firasgany77/Board-Design-Git/Lattice FPGA Works/SBC-CLH/Imgs/Weak_Pull_Ups.jpg

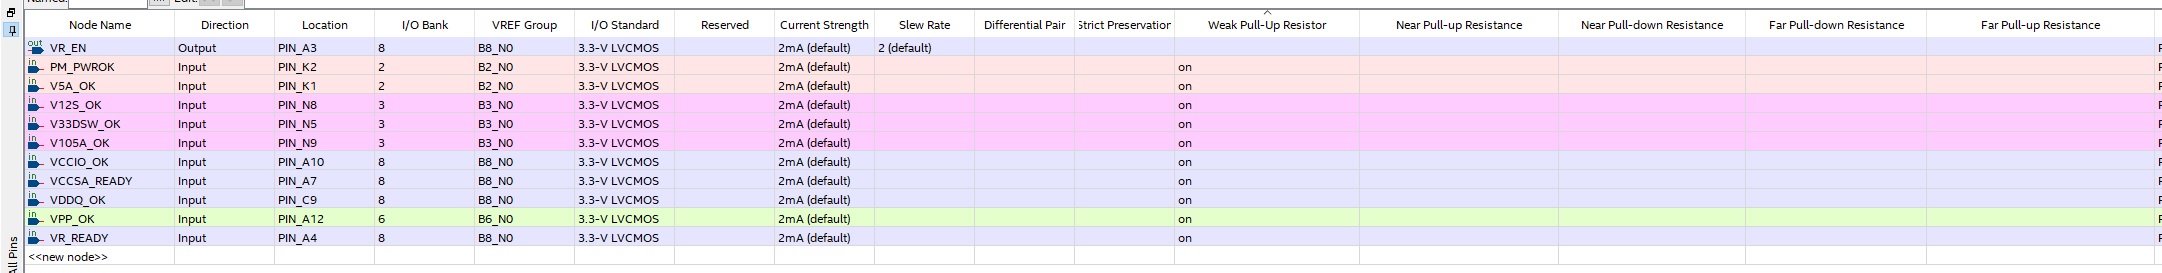
Lattice FPGA Works/SBC-CLH/Imgs/Weak_Pull_Ups.jpg
