firasgany77/Board-Design-Git/Docs/Imgs/SBC_TI22.png

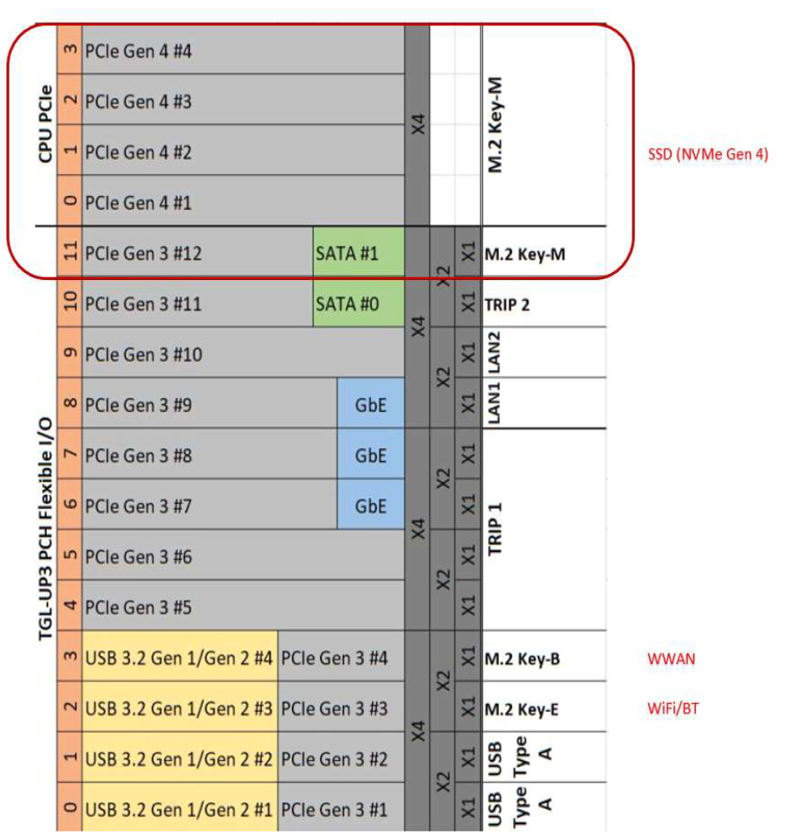
Docs/Imgs/SBC_TI22.png
