firasgany77/Board-Design-Git/README.md

# Board-Design-Git
Schematics, FPGA, Layout
