firasgany77/Board-Design-Git/Lattice FPGA Works/TensorI22/SBCTI22WORK/SBCTI22WORK_Implmnt/synlog/report/SBCTI22WORK_premap_notes.txt

@N: MF248 |Running in 64-bit mode.
@N: MF666 |Clock conversion enabled. (Command "set_option -fix_gated_and_generated_clocks 1" in the project file.)
@N: BN225 |Writing default property annotation file C:\Users\firas.abdelghani\Dropbox\Board-Design\Board-Design-Git\Lattice FPGA Works\TensorI22\SBCTI22WORK\SBCTI22WORK_Implmnt\SBCTI22WORK.sap.
