firasgany77/Board-Design-Git/Lattice FPGA Works/TensorI22/SBCTI22HOME2/SBCTI22HOME2_Implmnt/synlog/report/SBCTI22HOME2_compiler_notes.txt

@N|Running in 64-bit mode
@N|Running in 64-bit mode
@N: CD720 :"C:\lscc\iCEcube2.2020.12\synpbase\lib\vhd\std.vhd":123:18:123:21|Setting time resolution to ps
@N:"C:\Users\firas\Dropbox\Board-Design\Board-Design-Git\Lattice FPGA Works\TensorI22\Top.vhd":6:7:6:9|Top entity is set to TOP.
@N: CD630 :"C:\Users\firas\Dropbox\Board-Design\Board-Design-Git\Lattice FPGA Works\TensorI22\Top.vhd":6:7:6:9|Synthesizing work.top.bdf_type.
@N: CD630 :"C:\Users\firas\Dropbox\Board-Design\Board-Design-Git\Lattice FPGA Works\TensorI22\pch_pwrok.vhd":19:7:19:21|Synthesizing work.pch_pwrok_block.pch_pwrok_block_arch.
@N: CD234 :"C:\Users\firas\Dropbox\Board-Design\Board-Design-Git\Lattice FPGA Works\TensorI22\pch_pwrok.vhd":30:17:30:18|Using user defined encoding for type state_type.
@N: CD630 :"C:\Users\firas\Dropbox\Board-Design\Board-Design-Git\Lattice FPGA Works\TensorI22\rsmrst_pwrgd.vhd":8:7:8:24|Synthesizing work.rsmrst_pwrgd_block.rsmrst_arch.
@N: CD234 :"C:\Users\firas\Dropbox\Board-Design\Board-Design-Git\Lattice FPGA Works\TensorI22\rsmrst_pwrgd.vhd":22:17:22:18|Using user defined encoding for type state_type.
@N: CD630 :"C:\Users\firas\Dropbox\Board-Design\Board-Design-Git\Lattice FPGA Works\TensorI22\dsw_pwrok.vhd":8:7:8:21|Synthesizing work.dsw_pwrok_block.dsw_pwrok_arch.
@N: CD234 :"C:\Users\firas\Dropbox\Board-Design\Board-Design-Git\Lattice FPGA Works\TensorI22\dsw_pwrok.vhd":18:17:18:18|Using user defined encoding for type state_type.
@N: CD630 :"C:\Users\firas\Dropbox\Board-Design\Board-Design-Git\Lattice FPGA Works\TensorI22\vccinaux_vccin_en.vhd":8:7:8:29|Synthesizing work.vccinaux_vccin_en_block.vccinaux_vccin_arch.
@N: CD630 :"C:\Users\firas\Dropbox\Board-Design\Board-Design-Git\Lattice FPGA Works\TensorI22\hda_strap.vhd":6:7:6:21|Synthesizing work.hda_strap_block.hda_strap_block_arch.
@N: CD234 :"C:\Users\firas\Dropbox\Board-Design\Board-Design-Git\Lattice FPGA Works\TensorI22\hda_strap.vhd":15:17:15:18|Using user defined encoding for type state_type.
@N: CD630 :"C:\Users\firas\Dropbox\Board-Design\Board-Design-Git\Lattice FPGA Works\TensorI22\counter.vhd":7:7:7:13|Synthesizing work.counter.counter_arch.
@N: CD630 :"C:\Users\firas\Dropbox\Board-Design\Board-Design-Git\Lattice FPGA Works\TensorI22\vccio_en.vhd":10:7:10:20|Synthesizing work.vccio_en_block.vccio_en_block_arch.
@N: CD630 :"C:\Users\firas\Dropbox\Board-Design\Board-Design-Git\Lattice FPGA Works\TensorI22\vpp_vddq.vhd":9:7:9:20|Synthesizing work.vpp_vddq_block.vpp_vddq_arch.
@N: CD234 :"C:\Users\firas\Dropbox\Board-Design\Board-Design-Git\Lattice FPGA Works\TensorI22\vpp_vddq.vhd":20:17:20:18|Using user defined encoding for type state_type.
@N: CD630 :"C:\Users\firas\Dropbox\Board-Design\Board-Design-Git\Lattice FPGA Works\TensorI22\powerled.vhd":5:7:5:20|Synthesizing work.powerled_block.powerled_arch.
@N: CD234 :"C:\Users\firas\Dropbox\Board-Design\Board-Design-Git\Lattice FPGA Works\TensorI22\powerled.vhd":16:17:16:18|Using user defined encoding for type state_type.
@N: CL159 :"C:\Users\firas\Dropbox\Board-Design\Board-Design-Git\Lattice FPGA Works\TensorI22\vccio_en.vhd":15:2:15:11|Input clk_100Khz is unused.
@N: CL159 :"C:\Users\firas\Dropbox\Board-Design\Board-Design-Git\Lattice FPGA Works\TensorI22\vccinaux_vccin_en.vhd":15:2:15:11|Input clk_100Khz is unused.
@N: CL159 :"C:\Users\firas\Dropbox\Board-Design\Board-Design-Git\Lattice FPGA Works\TensorI22\dsw_pwrok.vhd":11:2:11:11|Input mainpwr_OK is unused.
@N: CL159 :"C:\Users\firas\Dropbox\Board-Design\Board-Design-Git\Lattice FPGA Works\TensorI22\Top.vhd":8:2:8:16|Input GPIO_FPGA_HDR_1 is unused.
@N: CL159 :"C:\Users\firas\Dropbox\Board-Design\Board-Design-Git\Lattice FPGA Works\TensorI22\Top.vhd":9:2:9:16|Input GPIO_FPGA_HDR_2 is unused.
@N: CL159 :"C:\Users\firas\Dropbox\Board-Design\Board-Design-Git\Lattice FPGA Works\TensorI22\Top.vhd":10:2:10:16|Input GPIO_FPGA_HDR_3 is unused.
@N: CL159 :"C:\Users\firas\Dropbox\Board-Design\Board-Design-Git\Lattice FPGA Works\TensorI22\Top.vhd":12:2:12:16|Input GPIO_FPGA_PCH_2 is unused.
@N: CL159 :"C:\Users\firas\Dropbox\Board-Design\Board-Design-Git\Lattice FPGA Works\TensorI22\Top.vhd":13:2:13:16|Input GPIO_FPGA_PCH_3 is unused.
@N: CL159 :"C:\Users\firas\Dropbox\Board-Design\Board-Design-Git\Lattice FPGA Works\TensorI22\Top.vhd":14:2:14:16|Input GPIO_FPGA_PCH_4 is unused.
@N: CL159 :"C:\Users\firas\Dropbox\Board-Design\Board-Design-Git\Lattice FPGA Works\TensorI22\Top.vhd":16:2:16:15|Input GPIO_FPGA_PM_1 is unused.
@N: CL159 :"C:\Users\firas\Dropbox\Board-Design\Board-Design-Git\Lattice FPGA Works\TensorI22\Top.vhd":17:2:17:15|Input GPIO_FPGA_PM_3 is unused.
@N: CL159 :"C:\Users\firas\Dropbox\Board-Design\Board-Design-Git\Lattice FPGA Works\TensorI22\Top.vhd":18:2:18:15|Input GPIO_FPGA_PM_2 is unused.
@N: CL159 :"C:\Users\firas\Dropbox\Board-Design\Board-Design-Git\Lattice FPGA Works\TensorI22\Top.vhd":19:2:19:15|Input GPIO_FPGA_PM_4 is unused.
@N: CL159 :"C:\Users\firas\Dropbox\Board-Design\Board-Design-Git\Lattice FPGA Works\TensorI22\Top.vhd":20:2:20:15|Input GPIO_FPGA_SV_1 is unused.
@N: CL159 :"C:\Users\firas\Dropbox\Board-Design\Board-Design-Git\Lattice FPGA Works\TensorI22\Top.vhd":21:2:21:15|Input GPIO_FPGA_SV_2 is unused.
@N: CL159 :"C:\Users\firas\Dropbox\Board-Design\Board-Design-Git\Lattice FPGA Works\TensorI22\Top.vhd":22:2:22:15|Input GPIO_FPGA_SV_3 is unused.
@N: CL159 :"C:\Users\firas\Dropbox\Board-Design\Board-Design-Git\Lattice FPGA Works\TensorI22\Top.vhd":23:2:23:15|Input GPIO_FPGA_SV_4 is unused.
@N: CL159 :"C:\Users\firas\Dropbox\Board-Design\Board-Design-Git\Lattice FPGA Works\TensorI22\Top.vhd":24:2:24:13|Input FPGA_GPIO_WD is unused.
@N: CL159 :"C:\Users\firas\Dropbox\Board-Design\Board-Design-Git\Lattice FPGA Works\TensorI22\Top.vhd":26:2:26:9|Input TPM_GPIO is unused.
@N: CL159 :"C:\Users\firas\Dropbox\Board-Design\Board-Design-Git\Lattice FPGA Works\TensorI22\Top.vhd":33:8:33:19|Input MAIN_12V_MON is unused.
@N: CL159 :"C:\Users\firas\Dropbox\Board-Design\Board-Design-Git\Lattice FPGA Works\TensorI22\Top.vhd":40:2:40:8|Input FP_RSTn is unused.
@N: CL159 :"C:\Users\firas\Dropbox\Board-Design\Board-Design-Git\Lattice FPGA Works\TensorI22\Top.vhd":41:2:41:8|Input PLTRSTn is unused.
@N: CL159 :"C:\Users\firas\Dropbox\Board-Design\Board-Design-Git\Lattice FPGA Works\TensorI22\Top.vhd":44:2:44:8|Input SLP_S5n is unused.
@N: CL159 :"C:\Users\firas\Dropbox\Board-Design\Board-Design-Git\Lattice FPGA Works\TensorI22\Top.vhd":45:2:45:8|Input PWRBTNn is unused.
@N: CL159 :"C:\Users\firas\Dropbox\Board-Design\Board-Design-Git\Lattice FPGA Works\TensorI22\Top.vhd":47:2:47:9|Input SLP_SUSn is unused.
@N: CL159 :"C:\Users\firas\Dropbox\Board-Design\Board-Design-Git\Lattice FPGA Works\TensorI22\Top.vhd":48:2:48:9|Input PM_PWROK is unused.
@N|Running in 64-bit mode
@N: NF107 :"C:\Users\firas\Dropbox\Board-Design\Board-Design-Git\Lattice FPGA Works\TensorI22\Top.vhd":6:7:6:9|Selected library: work cell: TOP view bdf_type as top level
@N: NF107 :"C:\Users\firas\Dropbox\Board-Design\Board-Design-Git\Lattice FPGA Works\TensorI22\Top.vhd":6:7:6:9|Selected library: work cell: TOP view bdf_type as top level
