firasgany77/Board-Design-Git/Lattice FPGA Works/TensorI22/SBCTI22/SBCTI22_Implmnt/synlog/report/SBCTI22_synthesis_check_errors.txt

@E: CD614 :"C:\Users\firas.abdelghani\Dropbox\Board-Design\Board-Design-Git\Lattice FPGA Works\TensorI22\Top.vhd":33:2:33:3|separator required between number and identifier
@E: CD492 :"C:\Users\firas.abdelghani\Dropbox\Board-Design\Board-Design-Git\Lattice FPGA Works\TensorI22\Top.vhd":33:5:33:5|character '_' is not allowed as the first character
@E: CD213 :"C:\Users\firas.abdelghani\Dropbox\Board-Design\Board-Design-Git\Lattice FPGA Works\TensorI22\Top.vhd":186:1:186:9|Undefined identifier
@E: CD213 :"C:\Users\firas.abdelghani\Dropbox\Board-Design\Board-Design-Git\Lattice FPGA Works\TensorI22\Top.vhd":187:1:187:9|Undefined identifier
@E: CD213 :"C:\Users\firas.abdelghani\Dropbox\Board-Design\Board-Design-Git\Lattice FPGA Works\TensorI22\Top.vhd":188:1:188:11|Undefined identifier
@E: CD213 :"C:\Users\firas.abdelghani\Dropbox\Board-Design\Board-Design-Git\Lattice FPGA Works\TensorI22\Top.vhd":189:1:189:7|Undefined identifier
@E: CD213 :"C:\Users\firas.abdelghani\Dropbox\Board-Design\Board-Design-Git\Lattice FPGA Works\TensorI22\Top.vhd":191:1:191:8|Undefined identifier
@E: CD213 :"C:\Users\firas.abdelghani\Dropbox\Board-Design\Board-Design-Git\Lattice FPGA Works\TensorI22\Top.vhd":192:1:192:6|Undefined identifier
@E: CD213 :"C:\Users\firas.abdelghani\Dropbox\Board-Design\Board-Design-Git\Lattice FPGA Works\TensorI22\Top.vhd":193:4:193:11|Undefined identifier
@E: CD213 :"C:\Users\firas.abdelghani\Dropbox\Board-Design\Board-Design-Git\Lattice FPGA Works\TensorI22\Top.vhd":194:1:194:9|Undefined identifier
@E: CD213 :"C:\Users\firas.abdelghani\Dropbox\Board-Design\Board-Design-Git\Lattice FPGA Works\TensorI22\Top.vhd":195:1:195:7|Undefined identifier
@E: CD213 :"C:\Users\firas.abdelghani\Dropbox\Board-Design\Board-Design-Git\Lattice FPGA Works\TensorI22\Top.vhd":196:1:196:8|Undefined identifier
@E: CD213 :"C:\Users\firas.abdelghani\Dropbox\Board-Design\Board-Design-Git\Lattice FPGA Works\TensorI22\Top.vhd":197:1:197:9|Undefined identifier
@E: CD255 :"C:\Users\firas.abdelghani\Dropbox\Board-Design\Board-Design-Git\Lattice FPGA Works\TensorI22\Top.vhd":200:55:200:55|No identifier "slp_s3n" in scope
@E: CD255 :"C:\Users\firas.abdelghani\Dropbox\Board-Design\Board-Design-Git\Lattice FPGA Works\TensorI22\Top.vhd":200:55:200:55|Too many errors - aborting.
@E: CD614 :"C:\Users\firas.abdelghani\Dropbox\Board-Design\Board-Design-Git\Lattice FPGA Works\TensorI22\Top.vhd":33:2:33:3|separator required between number and identifier
@E: CD492 :"C:\Users\firas.abdelghani\Dropbox\Board-Design\Board-Design-Git\Lattice FPGA Works\TensorI22\Top.vhd":33:5:33:5|character '_' is not allowed as the first character
@E: CD213 :"C:\Users\firas.abdelghani\Dropbox\Board-Design\Board-Design-Git\Lattice FPGA Works\TensorI22\Top.vhd":186:1:186:9|Undefined identifier
@E: CD213 :"C:\Users\firas.abdelghani\Dropbox\Board-Design\Board-Design-Git\Lattice FPGA Works\TensorI22\Top.vhd":187:1:187:9|Undefined identifier
@E: CD213 :"C:\Users\firas.abdelghani\Dropbox\Board-Design\Board-Design-Git\Lattice FPGA Works\TensorI22\Top.vhd":188:1:188:11|Undefined identifier
@E: CD213 :"C:\Users\firas.abdelghani\Dropbox\Board-Design\Board-Design-Git\Lattice FPGA Works\TensorI22\Top.vhd":189:1:189:7|Undefined identifier
@E: CD213 :"C:\Users\firas.abdelghani\Dropbox\Board-Design\Board-Design-Git\Lattice FPGA Works\TensorI22\Top.vhd":191:1:191:8|Undefined identifier
@E: CD213 :"C:\Users\firas.abdelghani\Dropbox\Board-Design\Board-Design-Git\Lattice FPGA Works\TensorI22\Top.vhd":192:1:192:6|Undefined identifier
@E: CD213 :"C:\Users\firas.abdelghani\Dropbox\Board-Design\Board-Design-Git\Lattice FPGA Works\TensorI22\Top.vhd":193:4:193:11|Undefined identifier
@E: CD213 :"C:\Users\firas.abdelghani\Dropbox\Board-Design\Board-Design-Git\Lattice FPGA Works\TensorI22\Top.vhd":194:1:194:9|Undefined identifier
@E: CD213 :"C:\Users\firas.abdelghani\Dropbox\Board-Design\Board-Design-Git\Lattice FPGA Works\TensorI22\Top.vhd":195:1:195:7|Undefined identifier
@E: CD213 :"C:\Users\firas.abdelghani\Dropbox\Board-Design\Board-Design-Git\Lattice FPGA Works\TensorI22\Top.vhd":196:1:196:8|Undefined identifier
@E: CD213 :"C:\Users\firas.abdelghani\Dropbox\Board-Design\Board-Design-Git\Lattice FPGA Works\TensorI22\Top.vhd":197:1:197:9|Undefined identifier
@E: CD255 :"C:\Users\firas.abdelghani\Dropbox\Board-Design\Board-Design-Git\Lattice FPGA Works\TensorI22\Top.vhd":200:55:200:55|No identifier "slp_s3n" in scope
@E: CD255 :"C:\Users\firas.abdelghani\Dropbox\Board-Design\Board-Design-Git\Lattice FPGA Works\TensorI22\Top.vhd":200:55:200:55|Too many errors - aborting.
