firasgany77/Board-Design-Git/Docs/Embedded Software/Hardware+and+software+used+in+ARM+Cortex-M3+M4+Processor.pdf

Hardware and software used in Embedded Systems Programming on ARM Cortex-M3/M4 Processor course
Note: The links given in this document are NOT purchase links. They are given just as reference links to explore the components.

### HARDWARE

### SOFTWARE

No | Item | Nos | Note | Reference link
1 | STM32F407 DISCOVERY board | 1 | This is the main development board for which drivers are developed. | check here (https://www.st.com/en/evaluation-tools/stm32f4discovery.html)
No | Item | Nos | Note | Reference link
1 | STM32CUBEIDE | | Eclipse based IDE. Provided by ST. Multi OS support (windows/linux/mac) | FREE
