firasgany77/Board-Design-Git/Projects/Tensor I22/Readme.MD

Tensor I22 is an Industrial PC composed of SBC (Single Board Computer) and Extension Board.

Interfaces:
- SOC: Tiger Lake UP3 (4+2) [4 CPU Cores - 2 GPU Cores], PCH: LP
- 2 HDMI 2.0b PortsCancel changes
- 2 Mini DP 1.4a
- 2 USB3.2 Gen2 Ports
- 2 USB2.0 Ports
- 2 RJ45 2.5Gbe Ports (I219 PHY, I210 Ethernet Controller)
- DDR4 - 3200MT/s SODIMM UP to 32GB (2 Channels)
- M.2 Key M (SSD-NVMe Gen4)/SATA
- N.2 Key-B (WWAN)
- M.2 Key-E (Wifi/BT)

<p align="center">
  
</p>

Extension Board (EB-TI22A):

TEST-removebg

SBC (Motherboard):
TOP_VIEW-removebg

TOP_VIEW_WO_HEATPLATE

TOP_VIEW2_3-removebg

Front_Panel-removebg
SIDE_VIEW-removebg
BOTTOM_VIEW-removebg
