firasgany77/Board-Design-Git/Lattice FPGA Works/TensorI22/SBCTI22WORK/SBCTI22WORK_Implmnt/syntmp/statusReport.html

Project Settings
Project Name | SBCTI22WORK_syn | Implementation Name | SBCTI22WORK_Implmnt
Top Module | [auto] | Pipelining | 1
Retiming | 0 | Resource Sharing | 1
Fanout Guide | 10000 | Disable I/O Insertion | 0
Disable Sequential Optimizations | 0 | Clock Conversion | 1

Run Status
Job Name | Status | | | | CPU Time | Real Time | Memory | Date/Time
(compiler) | Complete | 50 | 60 | 0 | - | 00m:01s | - | 13/04/2022 16:29:04
(premap) | Complete | 3 | 1 | 0 | 0m:00s | 0m:00s | 135MB | 13/04/2022 16:29:06
(fpga_mapper) | Complete | 34 | 439 | 0 | 0m:08s | 0m:08s | 172MB | 13/04/2022 16:29:14
Multi-srs Generator | Complete | | | | | | | 13/04/2022 16:29:05

Area Summary
PADS | 59 | FLOPS | 202
RAMS (v_ram) | 0 | CARRYS | 307
LUTS (total_luts) | 938

Timing Summary
Clock Name | Req Freq | Est Freq | Slack
TOP|FPGA_OSC | 42.0 MHz | 8.6 MHz | -92.874

Optimizations Summary
Combined Clock Conversion | 1 / 0
