firasgany77/Board-Design-Git/Lattice FPGA Works/TensorI22/SBCTI22HOME2/SBCTI22HOME2_Implmnt/syntmp/statusReport.html

Project Settings
Project Name | SBCTI22HOME2_syn | Implementation Name | SBCTI22HOME2_Implmnt
Top Module | [auto] | Pipelining | 1
Retiming | 0 | Resource Sharing | 1
Fanout Guide | 10000 | Disable I/O Insertion | 0
Disable Sequential Optimizations | 0 | Clock Conversion | 1

Run Status
Job Name | Status | | | | CPU Time | Real Time | Memory | Date/Time
(compiler) | Complete | 49 | 60 | 0 | - | 00m:00s | - | 12/04/2022 14:43:21
(premap) | Complete | 3 | 1 | 0 | 0m:00s | 0m:00s | 135MB | 12/04/2022 14:43:23
(fpga_mapper) | Complete | 17 | 437 | 0 | 0m:09s | 0m:09s | 182MB | 12/04/2022 14:43:32
Multi-srs Generator | Complete | | | | | | | 12/04/2022 14:43:22

Area Summary
PADS | 59 | FLOPS | 201
RAMS (v_ram) | 0 | CARRYS | 308
LUTS (total_luts) | 902

Timing Summary
Clock Name | Req Freq | Est Freq | Slack
TOP|FPGA_OSC | 40.0 MHz | 8.3 MHz | -95.745

Optimizations Summary
Combined Clock Conversion | 1 / 0
