firasgany77/Board-Design-Git/Lattice FPGA Works/OLD/SBCTI22HOME/SBCTI22HOME_Implmnt/syntmp/statusReport.html

Project Settings
Project Name | SBCTI22HOME_syn | Implementation Name | SBCTI22HOME_Implmnt
Top Module | [auto] | Pipelining | 1
Retiming | 0 | Resource Sharing | 1
Fanout Guide | 10000 | Disable I/O Insertion | 0
Disable Sequential Optimizations | 0 | Clock Conversion | 1

Run Status
Job Name | Status | | | | CPU Time | Real Time | Memory | Date/Time
(compiler) | Complete | 50 | 60 | 0 | - | 00m:01s | - | 12/04/2022 9:16:49
(premap) | Complete | 3 | 1 | 0 | 0m:00s | 0m:00s | 135MB | 12/04/2022 9:16:50
(fpga_mapper) | Complete | 33 | 436 | 0 | 0m:09s | 0m:09s | 195MB | 12/04/2022 9:17:00
Multi-srs Generator | Complete | | | | | | | 12/04/2022 9:16:50

Area Summary
PADS | 61 | FLOPS | 201
RAMS (v_ram) | 0 | CARRYS | 307
LUTS (total_luts) | 918

Timing Summary
Clock Name | Req Freq | Est Freq | Slack
TOP|FPGA_OSC | 42.7 MHz | 8.5 MHz | -93.597

Optimizations Summary
Combined Clock Conversion | 1 / 0
