firasgany77/Board-Design-Git/Docs/Imgs/BOTTOM_VIEW.png

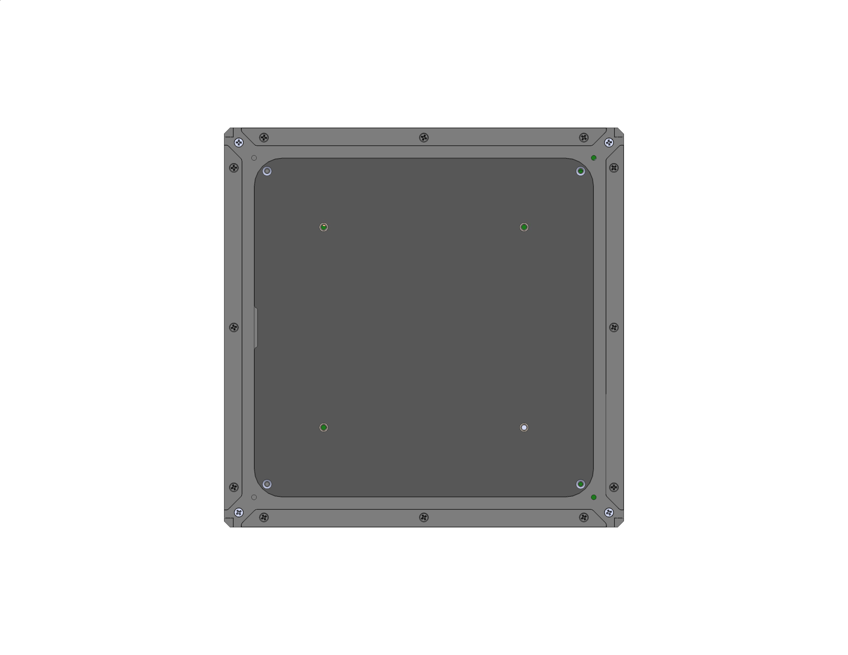
Docs/Imgs/BOTTOM_VIEW.png
