firasgany77/Board-Design-Git/Docs/Imgs/EB.png

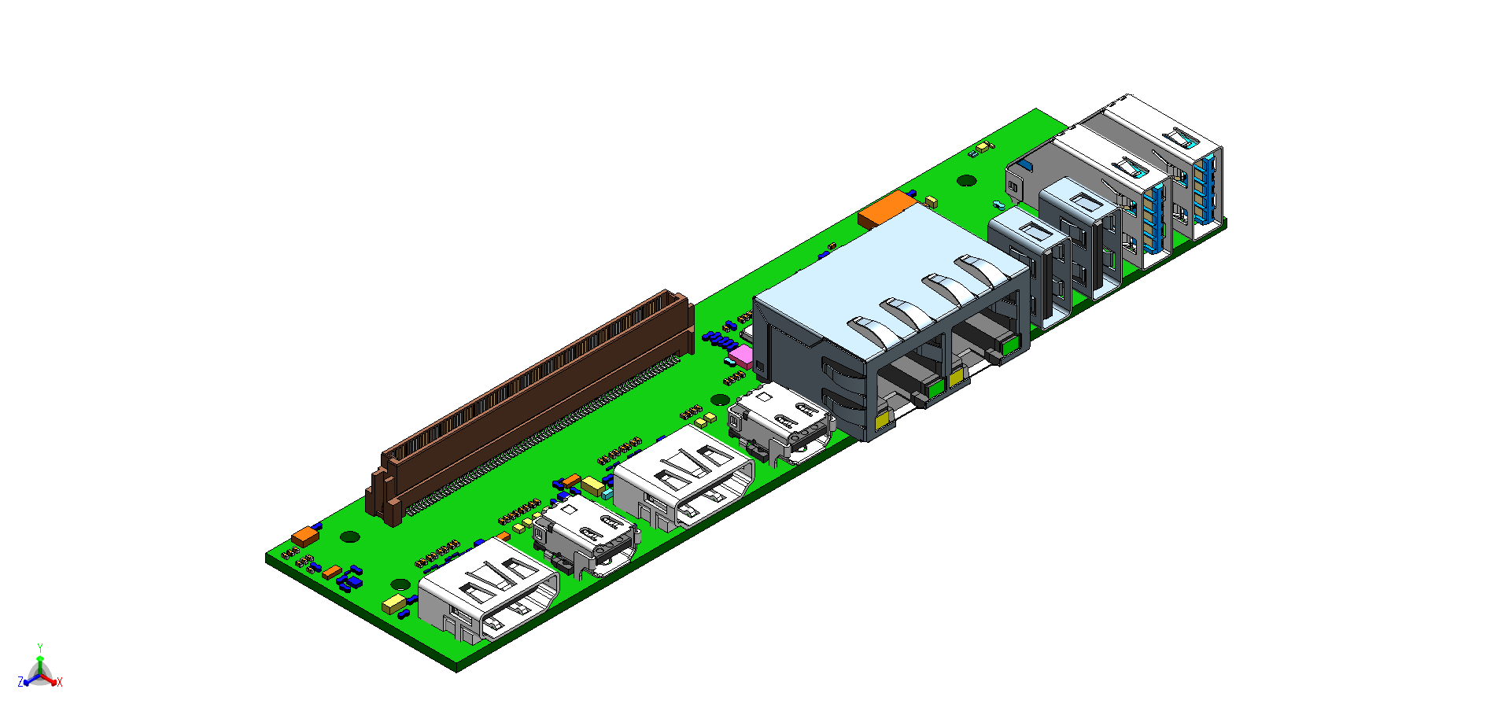
Docs/Imgs/EB.png
