firasgany77/Board-Design-Git/Docs/Imgs/Front Panel.png

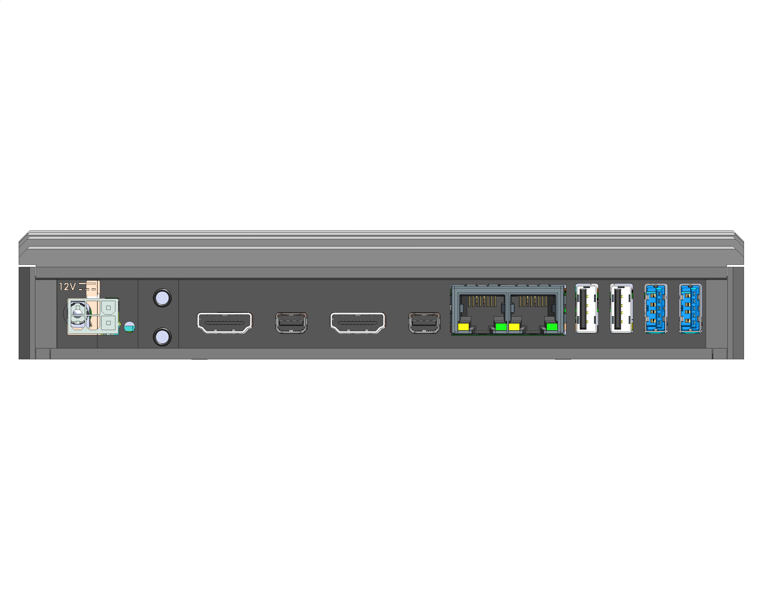
Docs/Imgs/Front Panel.png
