firasgany77/Board-Design-Git/Docs/Imgs/PNG/SIDE_VIEW-removebg.png

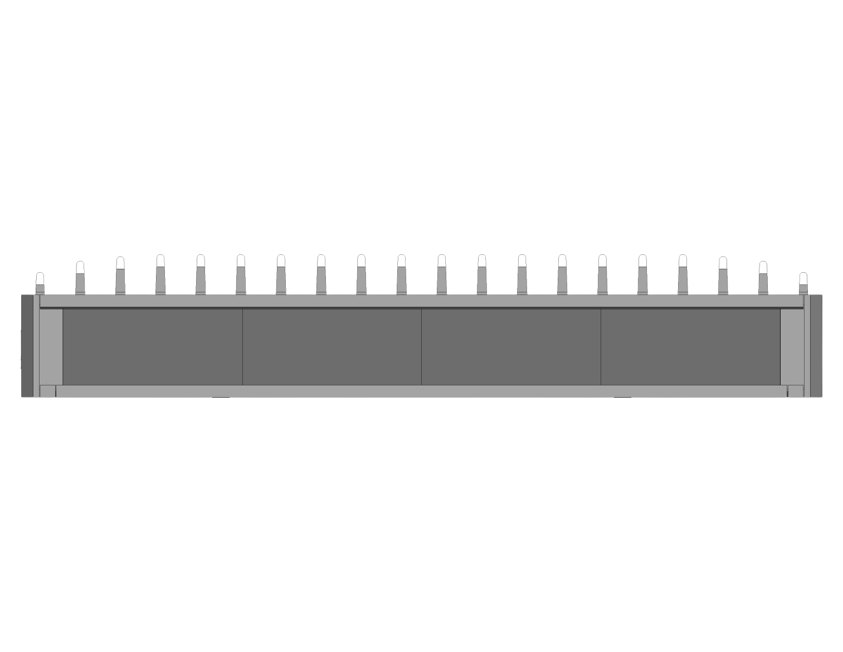
Docs/Imgs/PNG/SIDE_VIEW-removebg.png
