firasgany77/Board-Design-Git/Docs/Imgs/PNG/TOP_VIEW2-removebg.png

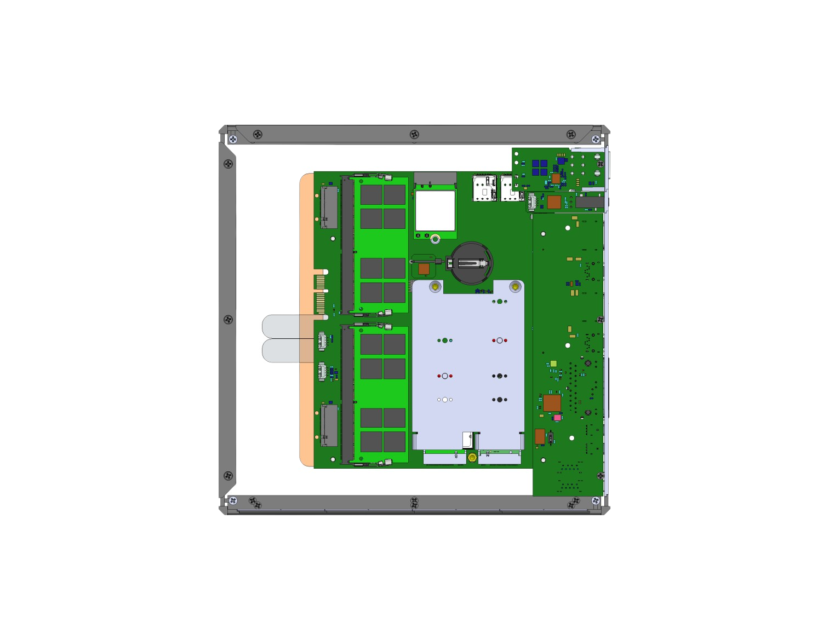
Docs/Imgs/PNG/TOP_VIEW2-removebg.png
