firasgany77/Board-Design-Git/Docs/Imgs/PNG/TOP_VIEW-removebg.png

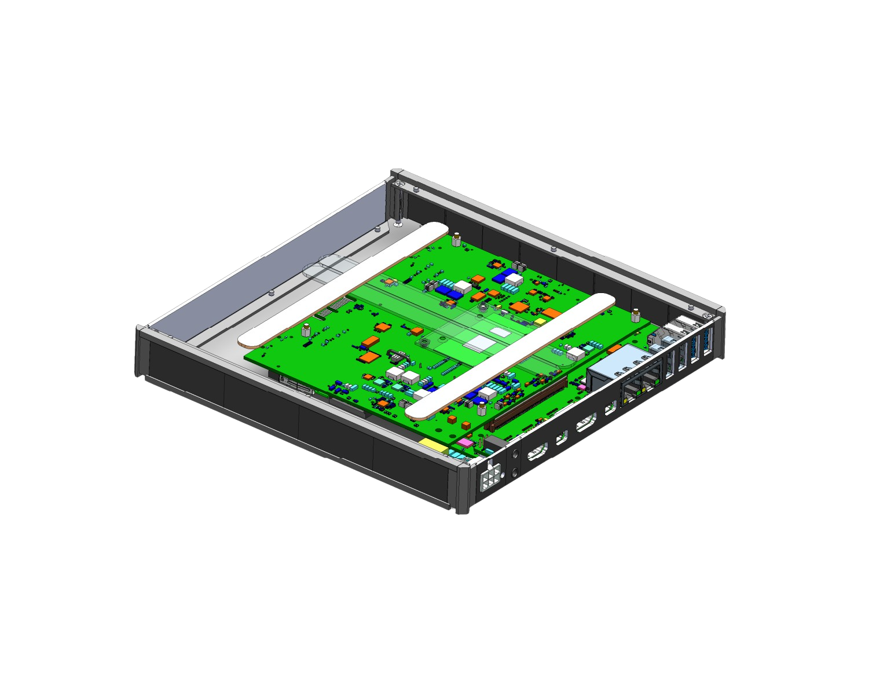
Docs/Imgs/PNG/TOP_VIEW-removebg.png
