firasgany77/Board-Design-Git/Lattice FPGA Works/Imgs/PWR_SEQ_14_06_1.jpg

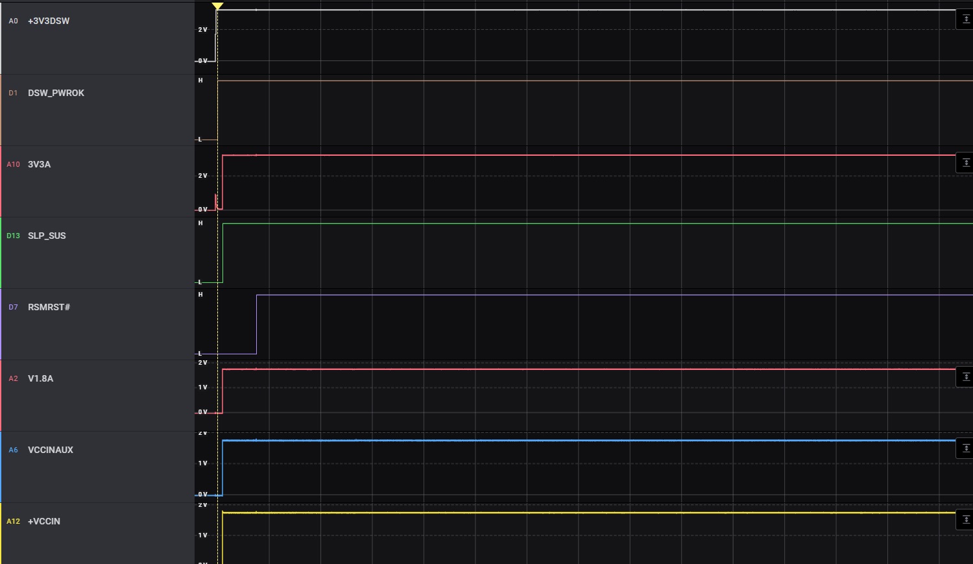
Lattice FPGA Works/Imgs/PWR_SEQ_14_06_1.jpg
