firasgany77/Board-Design-Git/Lattice FPGA Works/Imgs/VR_READY_VCCIN_Toggle.jpg

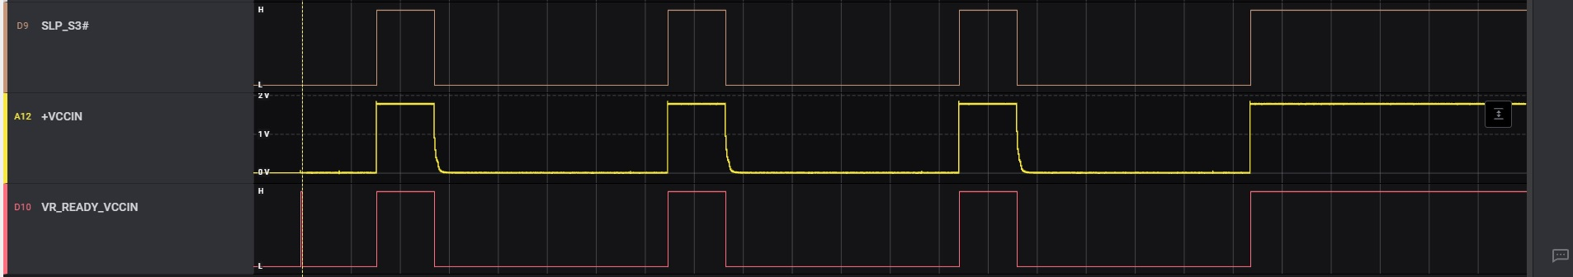
Lattice FPGA Works/Imgs/VR_READY_VCCIN_Toggle.jpg
