firasgany77/Board-Design-Git/Lattice FPGA Works/SBC-CLH/Imgs/LATTICE_PU2.jpg

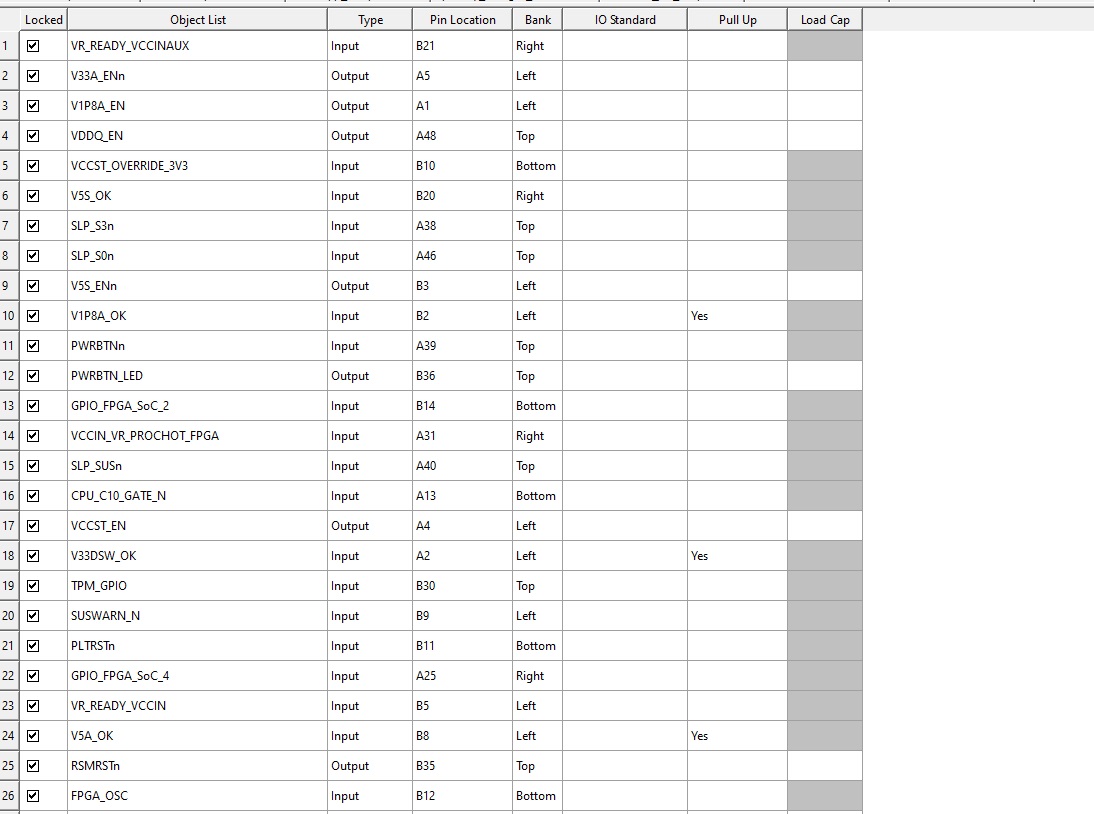
Lattice FPGA Works/SBC-CLH/Imgs/LATTICE_PU2.jpg
