firasgany77/Board-Design-Git/Docs/Testpoint_Debug.pdf

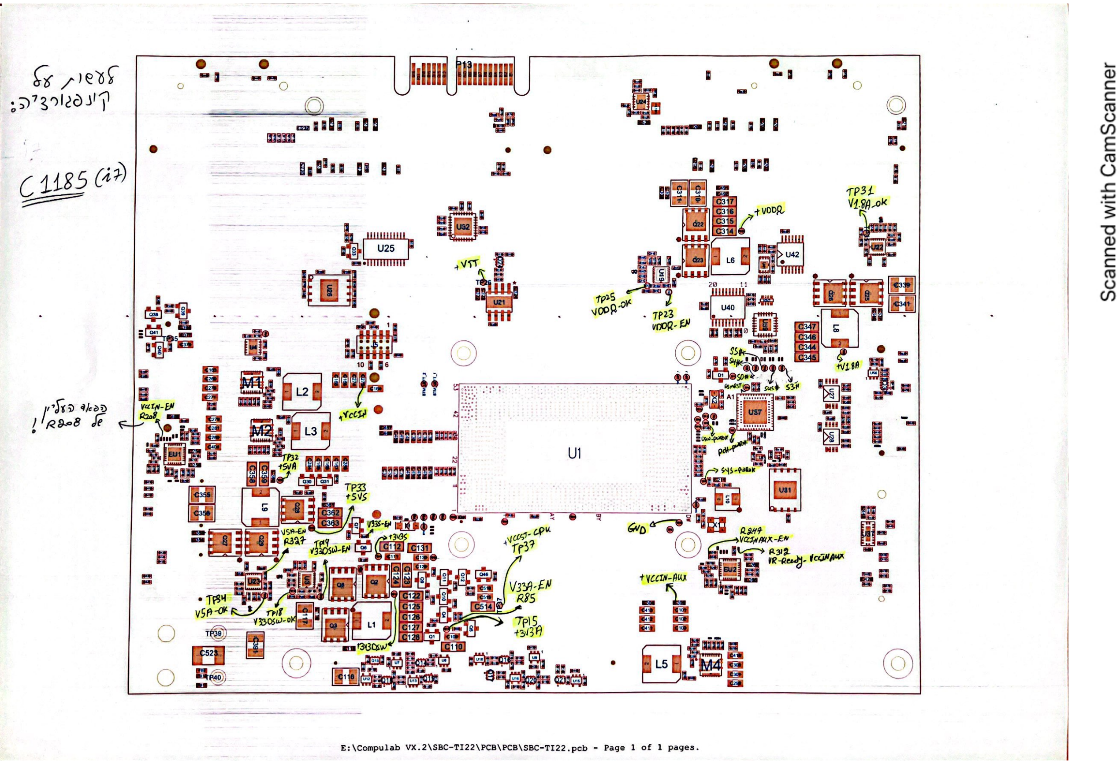
[picture p39: page 1]
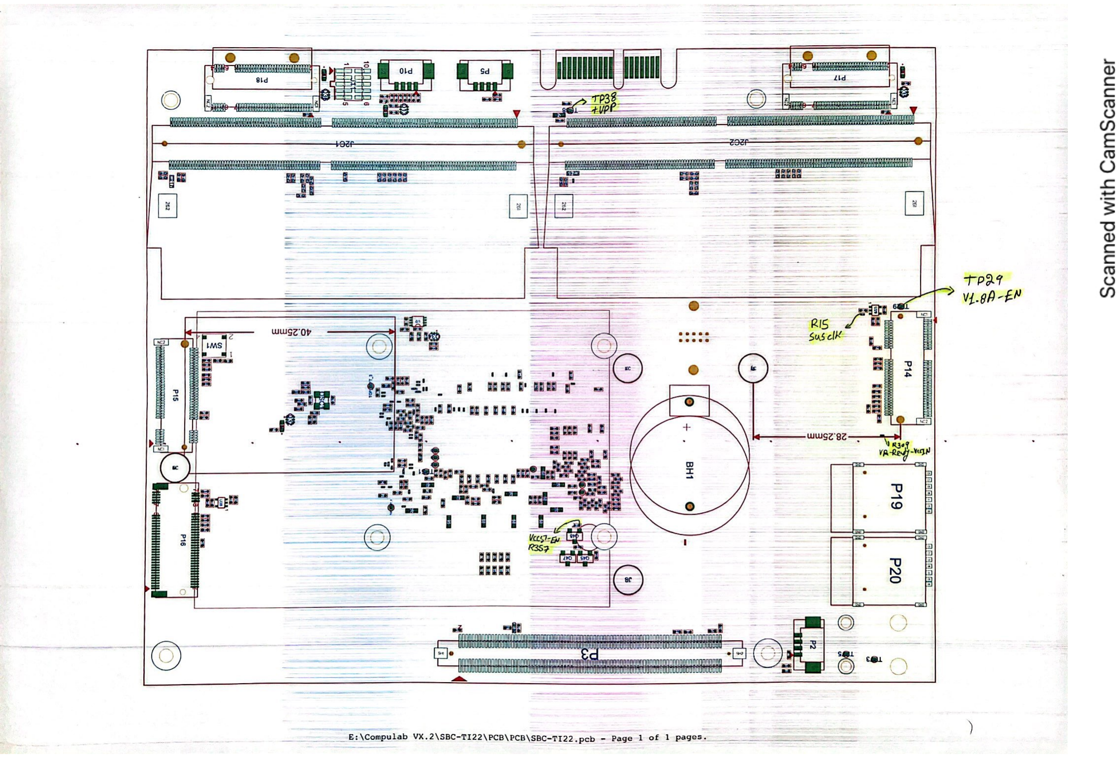
[picture p40: page 2]
