firasgany77/Board-Design-Git/Projects/Tensor I22/Schematics/Motherboard (Single Board Computer).pdf

# OPTION 1: TRIP1 is PCIe x4, TRIP2: PCIe x1 or SATA OPTION 2: TRIP1 is 2x(PCIe x1), TRIP2: only SATA

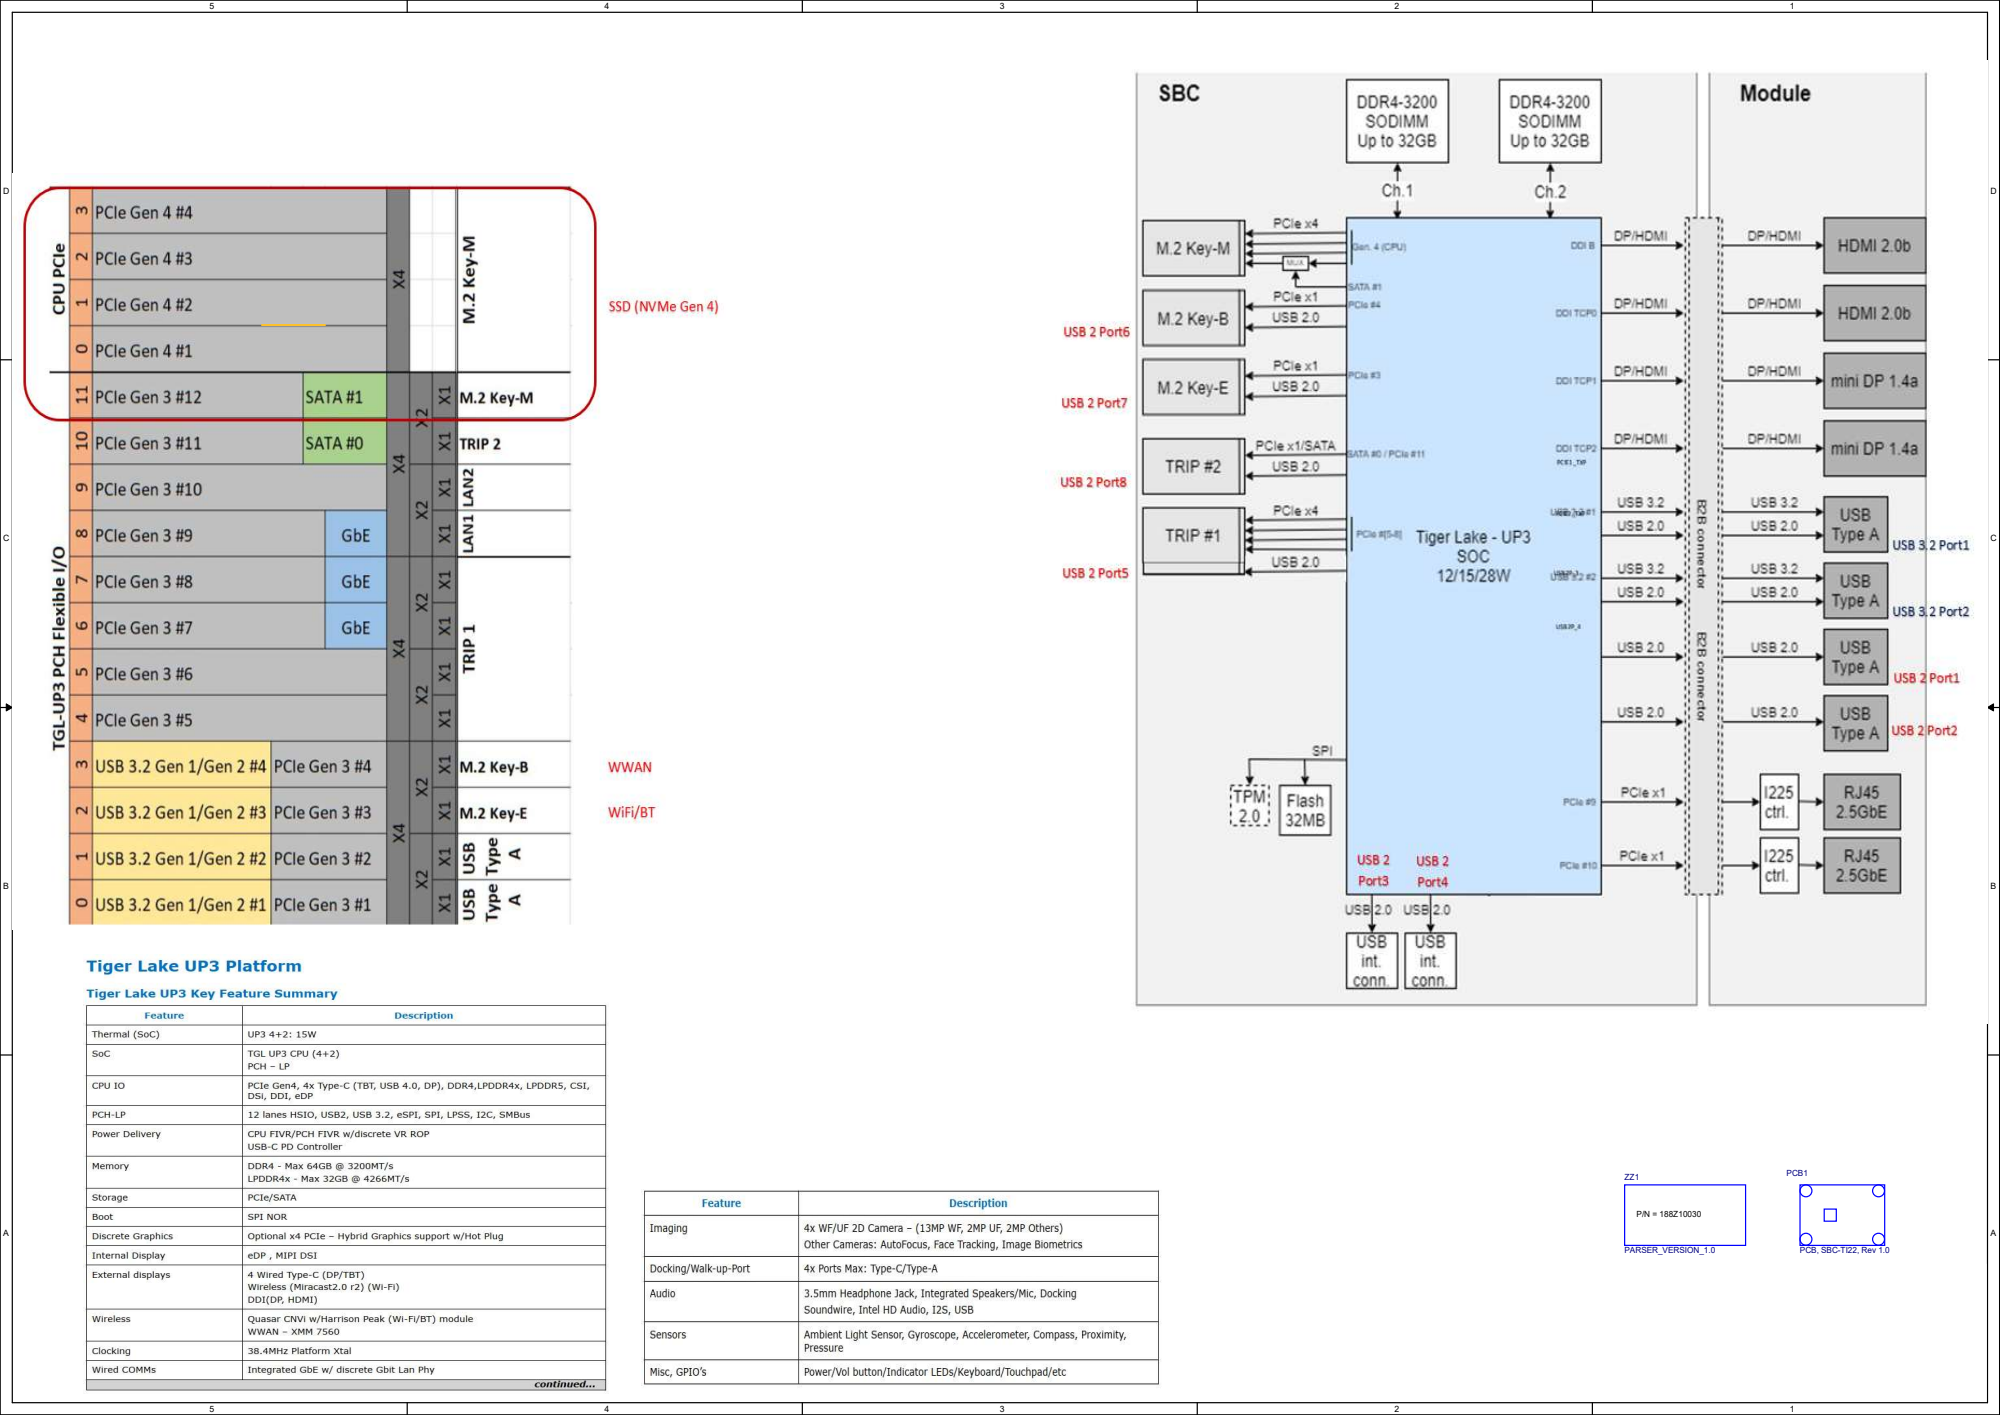
[picture p41: page 1]
TRIP 1 & 2:; PCIE3; PCIE4; PCIE9; I219 (Only Phy, Mac; Inside PCH); PCIE10; Could be (PCIe3 x1) or (SATA#0); I210 (Symbol 9 OF 21); PCIE11; PCIE12; Indication from M.2 to CPU: SATAXPCIE0; Title; Size; Document Number; Rev; Date:; Sheet; of <Doc>; <RevCode>; <Title> A3; Monday, January 03, 2022; 41 Title; of <Title> A3; ZZ1 PARSER_VERSION_1.0 P/N = 188Z10030; PCB1PCB, SBC-TI22, Rev 1.0

USB 3.2 Gen 2 (10 Gb/s)
PORT 1USB 3.2 Gen 2 (10
PORT 1 - B2B
USB 3.2 Gen 2 (10
Gb/s) PORT 1USB 3.2
Gen 2 (10 Gb/s)
PORT 2 - B2B

# OPTION 1: TRIP1 is PCIe x4, TRIP2: PCIe x1 or SATA OPTION 2: TRIP1 is 2x(PCIe x1), TRIP2: only SATA

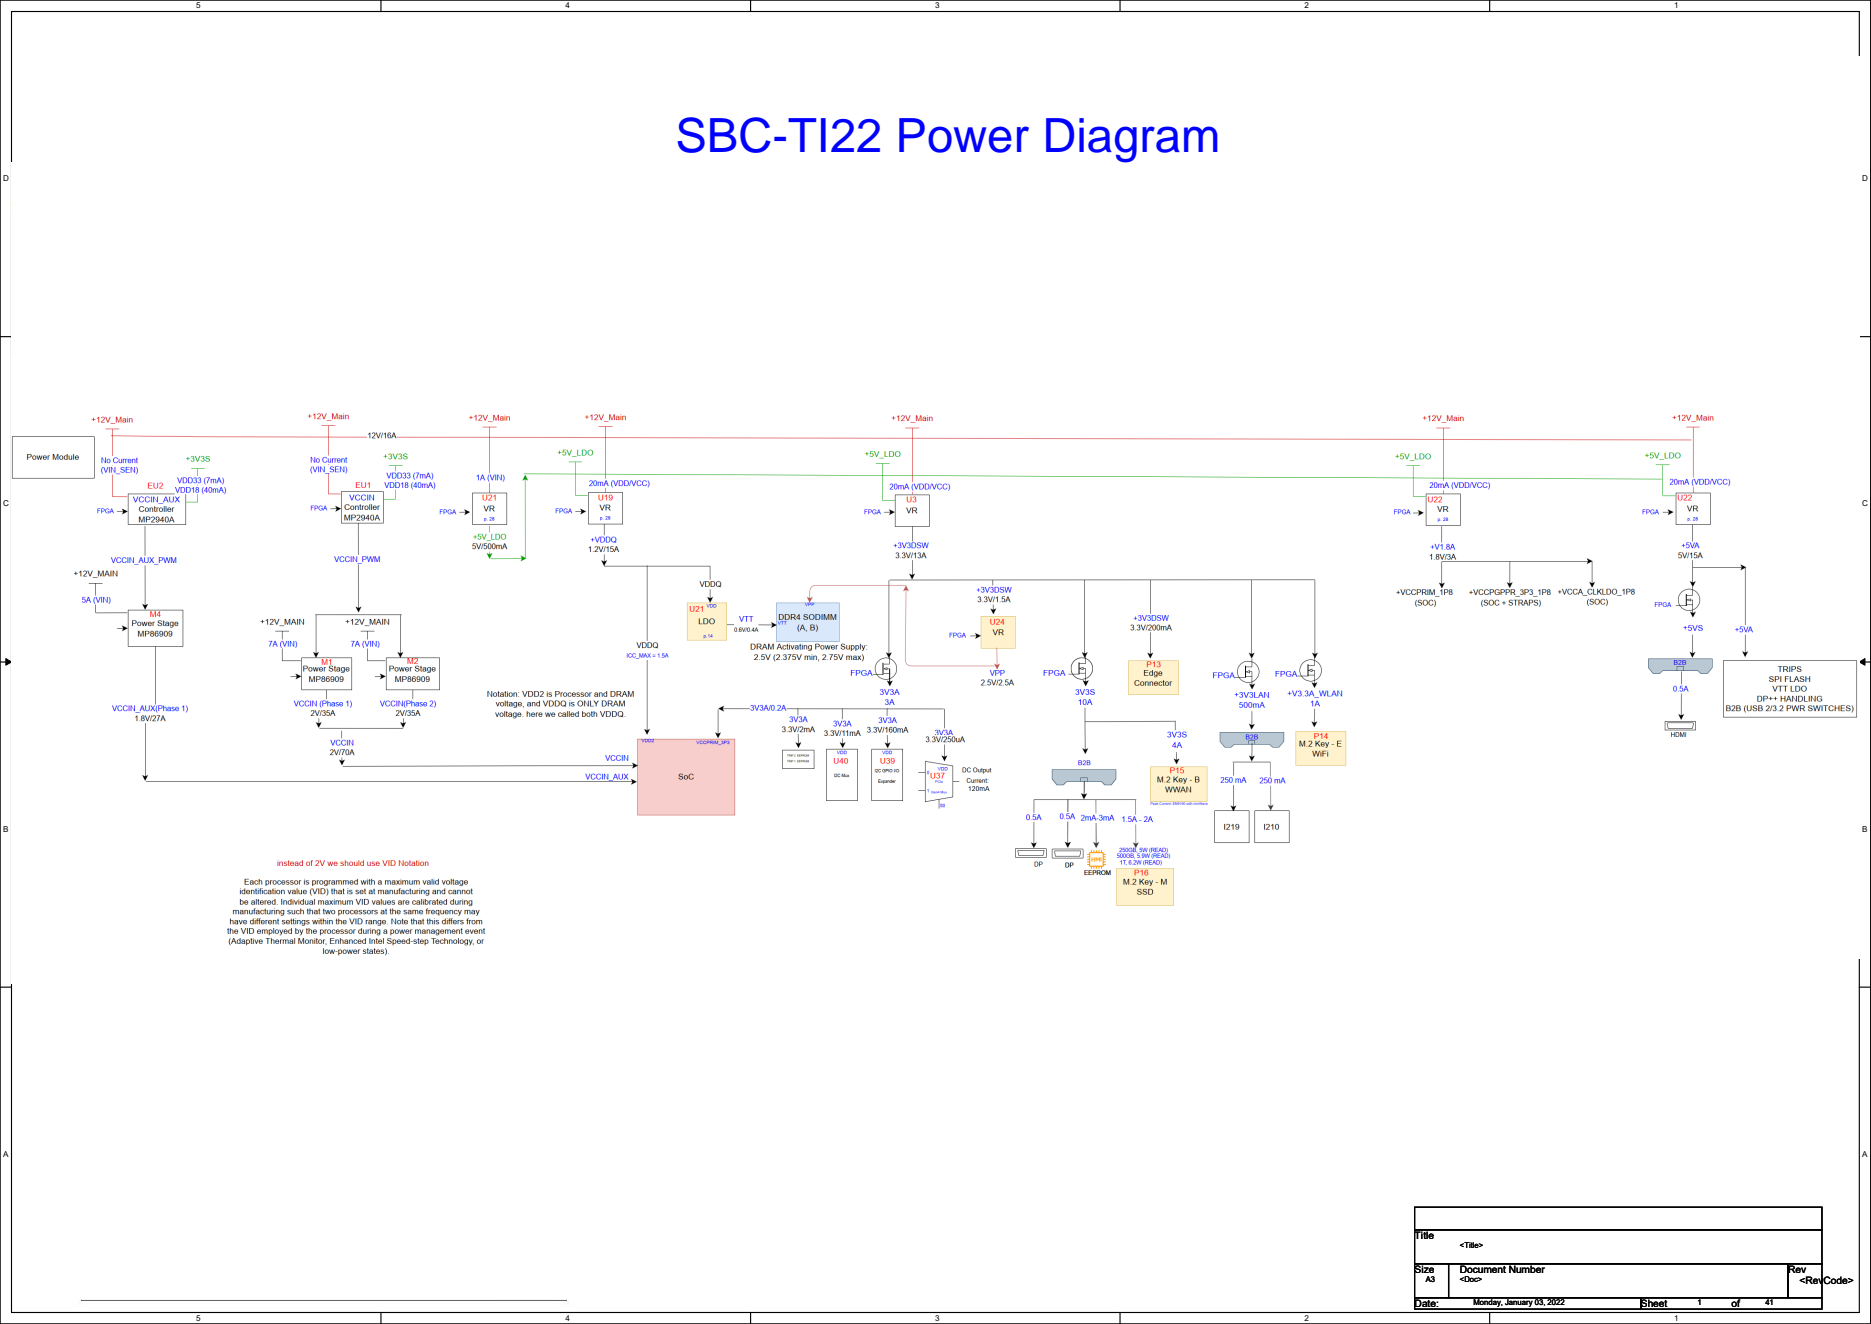
[picture p42: page 2]
TRIP 1 & 2:; PCIE3; PCIE4; PCIE9; I219 (Only Phy, Mac; Inside PCH); PCIE10; Could be (PCIe3 x1) or (SATA#0); I210 (Symbol 9 OF 21); PCIE11; PCIE12; Indication from M.2 to CPU: SATAXPCIE0; <Title> A3; Monday, January 03, 2022; 41 Title; ZZ1 PARSER_VERSION_1.0 P/N = 188Z10030; PCB1PCB, SBC-TI22, Rev 1.0

SBC-TI22 Power Diagram

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

D D

C C

B B

A A

# 1.2V LDO

### Vout=0.8(1+R1/R2)=1.2V

R1

R2

200mA

Peak Startup Current Supply:
ICC_PEAK = Core Power Supply (1.2V) = 6.4 mA ICC_PLLPEAK = PLL Power Supply =1.5 mA IPP_2V5PEAK = NVCM Power Supply (2.5V) =7.7 mA IPP_FASTPEAK = NVCM Programming Supply = 8.1 mA ICCIO_PEAK = Bank Power Supply = 3.3 mA

TOTAL = 27.3 mA

2.5V LDO | Vout=0.8(1+R1/R2)=2.48V

R1

## R2 200mA

ICC_PEAK = Core Power Supply (1.2V) = 6.4 mA

VPP_FAST, used only for fast production programming, must be left floating or unconnected in applications, except CM36 and
CM49 packages MUST have the VPP_FAST ball connected to VCCIO_0 ball externally.

## NOP

## Input Signal

IPP_2V5PEAK = NVCM Power Supply (2.5V) =7.7 mA for On-Time-Programming NOP

Global Inputs:High
fanout net, clock,
reset, EN signals.

# WSON6x8-8

# SPI FLASH

0

IO2

IO3

IO0
IO1

An important dual-function, active-low slave select pin. After the device exits POR or CRESET_B is toggled (High-Low-High), it samples the SPI_SS to select the configuration mode (an output in Master mode and an input in Slave mode). iCE40 LM devices have this pin shared with hardened SPI IP SPI1_CSN pin.

Output (Master Mode)/Input (Slave Mode Selection)

output

# Activity LED indication

VGS = 1.8V

240R = 161C24003S

for VGS=1.8 & Id=350mA , 0.7ohm <RDS_ON<0.9ohm

(3.3-VF)/R = I

from intersection with LED IV curve = > Id = 20mA, VF= 2V

1.3V

3.3V

In SPI Master mode, the iCE40 device outputs the SPI_SCK. This clock is used to time the external SPI Flash PROM. The data from the external SPI Flash is input to the
iCE40 device on the SPI_SI pin. This data needs to meet the tSU and tHD referenced to the SPI_SCK output clock

The iCE40 LP/HX, iCE40 Ultra, iCE40 UltraLite and iCE40 UltraPlus device configuration mode is selected according to the following priority described below and illustrated in Figure 3.1. After exiting the Power-On Reset state or when CRESET_B returns High after being held Low, the iCE40 device
samples the logical value on its SPI_SS pin. Like other programmable I/O pins, the SPI_SS pin has an internal pull-up
resistor. Refer to iCE40 LP/HX Family Data Sheet (FPGA-DS-02029) for the minimum pulse width requirement of CRESET_B.
If the SPI_SS pin is sampled as a logic ‘1’ (High), then …
Check if the device is enabled to configure from the NVCM. If the NVCM is programmed, the device configures
from NVCM.
If enabled to configure from NVCM, the device configures itself using the NVCM.
If not enabled to configure from NVCM, then the device configures using the SPI Master Configuration
Interface.
If the SPI_SS pin is sampled as a logic ‘0’ (Low), then the device waits to be configured from an external controller or from another device in SPI Master Configuration Mode using an SPI-like interface.

CDONE includes
permenant weak
pull-up resistor VCCST_PWRGD is only 1.0 V tolerant

(1.05V)

Signal From FPGA should be 3.3V and indicate that BOTH VCCST & VDDQ rails are
ramped up.

VCCST_PWRGD is a signal on the Tiger Lake processor that indicates both the VCCST power supply and VDDQ power supply are within voltage tolerance specifications. VCCST_PWRGD is only 1.0 V tolerant. If a dedicated driver is used to drive the VCCST supply, the VCCST_PWRGD should meet the requirements listed below:
- VCCST_PWRGD must be valid (stable at the right level) during all power states when there is a power applied to the VccST power supply.
- VCCST_PWRGD must be de-asserted before VDDQ or VCCST power level goes
below voltage tolerance specification.

## NOP

## NOP

### Used to create 100Khz CLK

NOP Renesas (ZLUSBEVAL3Z)
Adapter already has 4.7K
PU to +3V3DSW which is
provided.

VCCIN IMVP9 Controller

VCCIN_AUX IMVP9 Controller

### I2C - 0X21 (Hex)

### I2C - 0X20 (Hex)

# EDGE CONNECTOR

# FPGA, SPI flash and IMVP9 programing edge connector For use with SBC-TI22 ATP

## NOP

Dual function pins. I/O
when not used as CBSEL.
Optional ColdBoot
configuration Select
input, if ColdBoot mode is enabled.
The image to configure
the CRAM can be
selected by the user on
power up (Cold Boot) or
once powered up (Warm
Boot).

These global inputs can be used as high fanout nets, clock, reset or enable signals. The dedicated global pins are
identified as GBIN[7:0] and the global buffers are identified as-GBUF[7:0]. These eight inputs may be used as general purpose I/O if they are not used to drive the clock nets. Global buffer GBUF7 in I/O Bank 3 also provides an optional
direct LVDS25 or subLVDS
differential clock input.

CRESET_B

in case 12V_Main has been shut down, we need an | Voltage Divider :3.3V * ((3.01K\(3.01K + 6.49K)) = 1.05V
immediate action by FPGA and give the CPU enought
time to shut down it's internal elements and not ruin
the CMOS.
we don't want wait for all the caps to discharge and then turn of Core power. we want something that actes faster. (turning of EN pins immediately?)

Check

Check

~3.26V

SLAVE: SPI FLASH
SLAVE: FPGA

FPGA WEAK PU
FPGA WEAK PU
FPGA WEAK PU

FPGA WEAK PU

FPGA WEAK PU

FPGA WEAK PU

FPGA WEAK PU

## replaces V105A_OK (PU?)

Place Close to VCCIO_0 | Place Close to VCCIO_1 | Place Close to VCCIO_2 | Place Close to VCCIO_3

Configuration Reset,
active Low.
Dedicated input. No
internal pull-up

+3V3DSW resistor. Either

| 1

actively drive
externally or
connect a 10 KOhm
pull-up resistor to
VCCIO_2.

SPI_SS_B# = SPI_FP_CS# in my design. Place Close to VCC

Place Close to VPP 2V5

NOP | NOP | NOP
EXT_LDO_EN | EXT_LDO_ADJ_1V2
EXT_LDO_2V5_EN | EXT_LDO_ADJ_2V5

SUSACK#_FPGA

VCCST_PWRGD

VPP_2V5

### SPI_FP_HOLD

### SPI_FP_WP

### LED1_CAT

LED1_AN

FPGA_OSC

SMB_CLK_VR

SMB_DATA_VR

SUSWARN#_FPGA

12V_MAIN_MON | 1V2_DSW

+3V3DSW +3V3DSW
+3V3DSW

+3V3DSW

+3V3DSW | 1V2_DSW
+3V3DSW | 2V5_DSW

+3V3DSW

+3V3DSW

+VCCST_CPU

2V5_DSW

+3V3DSW

+3V3DSW +3V3DSW

+3V3DSW

+3V3DSW

+3V3DSW +3V3DSW

+3V3DSW

+3V3DSW

+12V_MAIN

+3V3DSW | +3V3DSW | +3V3DSW | +3V3DSW | +3V3DSW | +3V3DSW | +3V3DSW | +3V3DSW | +3V3DSW | +3V3DSW | +3V3DSW | +3V3DSW
1V2_DSW | 1V2_DSW | 1V2_DSW
2V5_DSW | 2V5_DSW | 2V5_DSW

V5A_EN

SUSACK# PCH_PWROK

PLTRST# FPGA_SLP_WLAN#

VCCST_PWRGD_1P05

VR_PROCHOT_FPGA_OUT#

VCCIN_VR_PROCHOT_FPGA
VCCINAUX_VR_PROCHOT_FPGA

VDDQ_OK

SYS_PWROK

# PWRBTN# PWRBTN_LED

SOC_SPKR

# RSMRST# TPM_GPIO

SPI_FP_IO2

SPI_FP_IO3

SPI_FP_CS#

SPI_FP_MOSI
SPI_FP_MISO

SPI_FP_SCK

SPI_FP_MISO
SPI_FP_SCK

SPI_FP_MOSI

CDONE

CDONE

SPI_FP_CS#

HDA_SDO_ATP

SMB_DATA_VCCIN_VC
SMB_CLK_VCCIN_VC

SMB_DATA_VCCIN_AUX_VC
SMB_CLK_VCCIN_AUX_VC

SPI_FP_CS#

SPI_FP_MOSI

SPI_FP_MISO

SPI_FP_SCK

SPI_ATP_CTRL#
SPI_ATP_SI

SPI_ATP_SO

SPI_ATP_CLK
SPI_ATP_CS0

CPU_C10_GATE#

SLP_S3#

GPIO_FPGA_SoC_3 GPIO_FPGA_EXP_2

GPIO_FPGA_EXP_1

GPIO_FPGA_SoC_2

SPI_FP_IO3
SPI_FP_IO2

V5A_OK

HDA_SDO_ATP

SUSWARN# VPP_EN

VCCST_OVERRIDE_3V3

V33A_EN#

V33S_OK

V33DSW_OK
V5S_OK

VR_READY_VCCIN

V33A_OK

VCCIN_VR_PE

VCCINAUX_EN

GPIO_FPGA_SoC_1

SLP_SUS#

SLP_S5#

SLP_S0#

SLP_S4#

VCCIN_EN | GPIO_FPGA_SoC_4

VR_READY_VCCINAUX

VCCINAUX_VR_PE

+VCCST_CPU_OK

V33S_EN#

VCCST_EN

VDDQ_EN

V1.8A_EN
VPP_OK

V1.8A_OK

V5S_EN#

DSW_PWROK

CRESET_B

CRESET_B

SATAXPCIE0_FPGA

SATAXPCIE1_FPGA

<Title> A3 | Monday, January 03, 2022 | 1 | 1 Title
<Title> A3 | Monday, January 03, 2022 | 1 | 1 Title
<Title> A3 | Monday, January 03, 2022 | 1 | 1
R68 | 0R,5%,0402 | C521
| | 1uF,25V

R341
3.01K, 1%, 0402

# BANK0

iCE40LP1K-QN84

U57A

IOT_84_GBIN1 A43

IOT_85_GBIN0 B32 | VCCIO_0 A42
IOT_76 | A38
IOT_77 | B29
IOT_78 | A39
IOT_79 | B30
IOT_80 | A40
IOT_81 | B31
IOT_82 | A41
IOT_86 | A44
IOT_88 | A45
IOT_89 | B34
IOT_90 | A46
IOT_91 | B35
IOT_92 | A47
IOT_93 | B36
IOT_95 | A48

C383

100nF,25V

R415

4.75K/1%

R49 0R,5%,0402

DS4

LED-GREEN ANODE CATHODE

# BANK1

iCE40LP1K-QN84

U57B
IOR_60_GBIN3 A29 | IOR_61_GBIN2 B22 | VCCIO_1 B25
IOR_52 | B19
IOR_53 | A25
IOR_55 | A26
IOR_56 | B20
IOR_57 | B21
IOR_58 | A27
IOR_63 | B23
IOR_64 | A31
IOR_65 | B24
IOR_66 | A32
IOR_68 | A33
IOR_69 | A34
IOR_70 | B26
IOR_71 | A35
IOR_72 | B27
Q32 | Dual N,0.5A,20V

1

2

4

5

3

### 6 R338 6.49K R70

2.21k

U31 SPI_FLASH 256Mbit, WSON6x8-8 CS#

### 1 DO

### 2 WP#

### 3 GND

4 | DI 5 | SCK

### 6 HOLD#

# 7 VCC

### 8 EPAD

9

C372

100nF,25V

R37
1K, 1%, 0201

C373

1uF,25V C520

100nF,25V

# BANK3

iCE40LP1K-QN84

U57D

IOL_6B_GBIN7 A8

# IOL_7A_GBIN6 A9 VCCIO_3 B6

IOL_1B

A1

IOL_2A

B1

IOL_2B

A2

IOL_3A

B2

IOL_3B

A3

IOL_4A

B3

IOL_4B

A4

IOL_5A

B4

IOL_5B

A5

IOL_6A

B5

IOL_7B

B7

IOL_9A

A10

IOL_9B

B8

IOL_10B

A11

IOL_11B

B9

IOL_12B

A12

C519

10nF,25V,X7R

C369

100nF,25V

R342
24.9K,1%,0402 | POWER

iCE40LP1K-QN84 U57F GND

A6 | GND
A18 | GND
A30 | GND
B33 | VCC

A7 VCC
A15 VCC
A28 VCC
B28 VPP_2V5 | A36 VPP_FAST | A37 EPAD EPAD

C370

1uF,25V R414

10K/1%

# BANK2

# iCE40LP1K-QN84 U57C

IOB_35_GBIN5 A14 IOB_36_GBIN4 B12

IOB_42_CBSEL0 B15
IOB_43_CBSEL1 A20 | CDONE
B16 | CRESET_B
A21 | VCCIO_2 A17
IOB_30 | A13
IOB_32 | B10
IOB_33 | B11
IOB_34 | A16
IOB_38 | B13
IOB_40 | B14
IOB_41 | A19

R412

20K/1%

R422 | 10K/1%
R69 | 0R,5%,0402

OSC1

25MHz 50ppm 3.2x2.5 VCC

### 4 GND

### 2 OUT

### 3 EN

C494

1uF

R67 | 0R,5%,0402
R343 | 0R

# SPI

iCE40LP1K-QN84 U57E
VCC_SPI A24
IOB_44_SDO

B17
IOB_45_SDI | A22
IOB_46_SCK | A23
IOB_47_SS | B18

C456

# 1uF C296

100nF,25V C367

1uF,25V | C368
| 10nF,25V,X7R

C405

1uF R411

10K/1%

U14

LDK120PU-R

IN

# 6 EN

### 4 GND

### 2 ADJ 3 OUT

# 1 NC

5

P13 PCIE x1 EDGE CONN.
B1 | B1 B2 | B2 B3 | B3 B4 | B4 B5 | B5 B6 | B6 B7 | B7 B8 | B8 B9 | B9 B10 | B10 B11 | B11 B12 | B12 B13 | B13 B14 | B14 B15 | B15 B16 | B16 B17 | B17 B18 | B18
A1 A1 | A2 A2 | A3 A3 | A4 A4 | A5 A5 | A6 A6 | A7 A7 | A8 A8 | A9 A9 | A10 A10 | A11 A11 | A12 A12 | A13 A13 | A14 A14 | A15 A15 | A16 A16 | A17 A17 | A18 A18 | C384

1uF,25V

R244
9.31K,1%,0402 | R340

10K,1%,0201

C293
1uF,25V | C374
| 10nF,25V,X7R
R119 | 0R

R71

2.21k C380

100nF | C295

10nF,25V,X7R

C371

10nF,25V,X7R

C402

1uF

C522

10nF,25V,X7R

R59
10K,1%,0201

R437
100K R413 | 10K/1%

C408

1uF

R344 | 0R

C379

100nF

U17

LDK120PU-R

IN

# 6 EN

### 4 GND

### 2 ADJ 3 OUT

# 1 NC

### 5 R120

100R

C294

100nF,25V | R429

100K

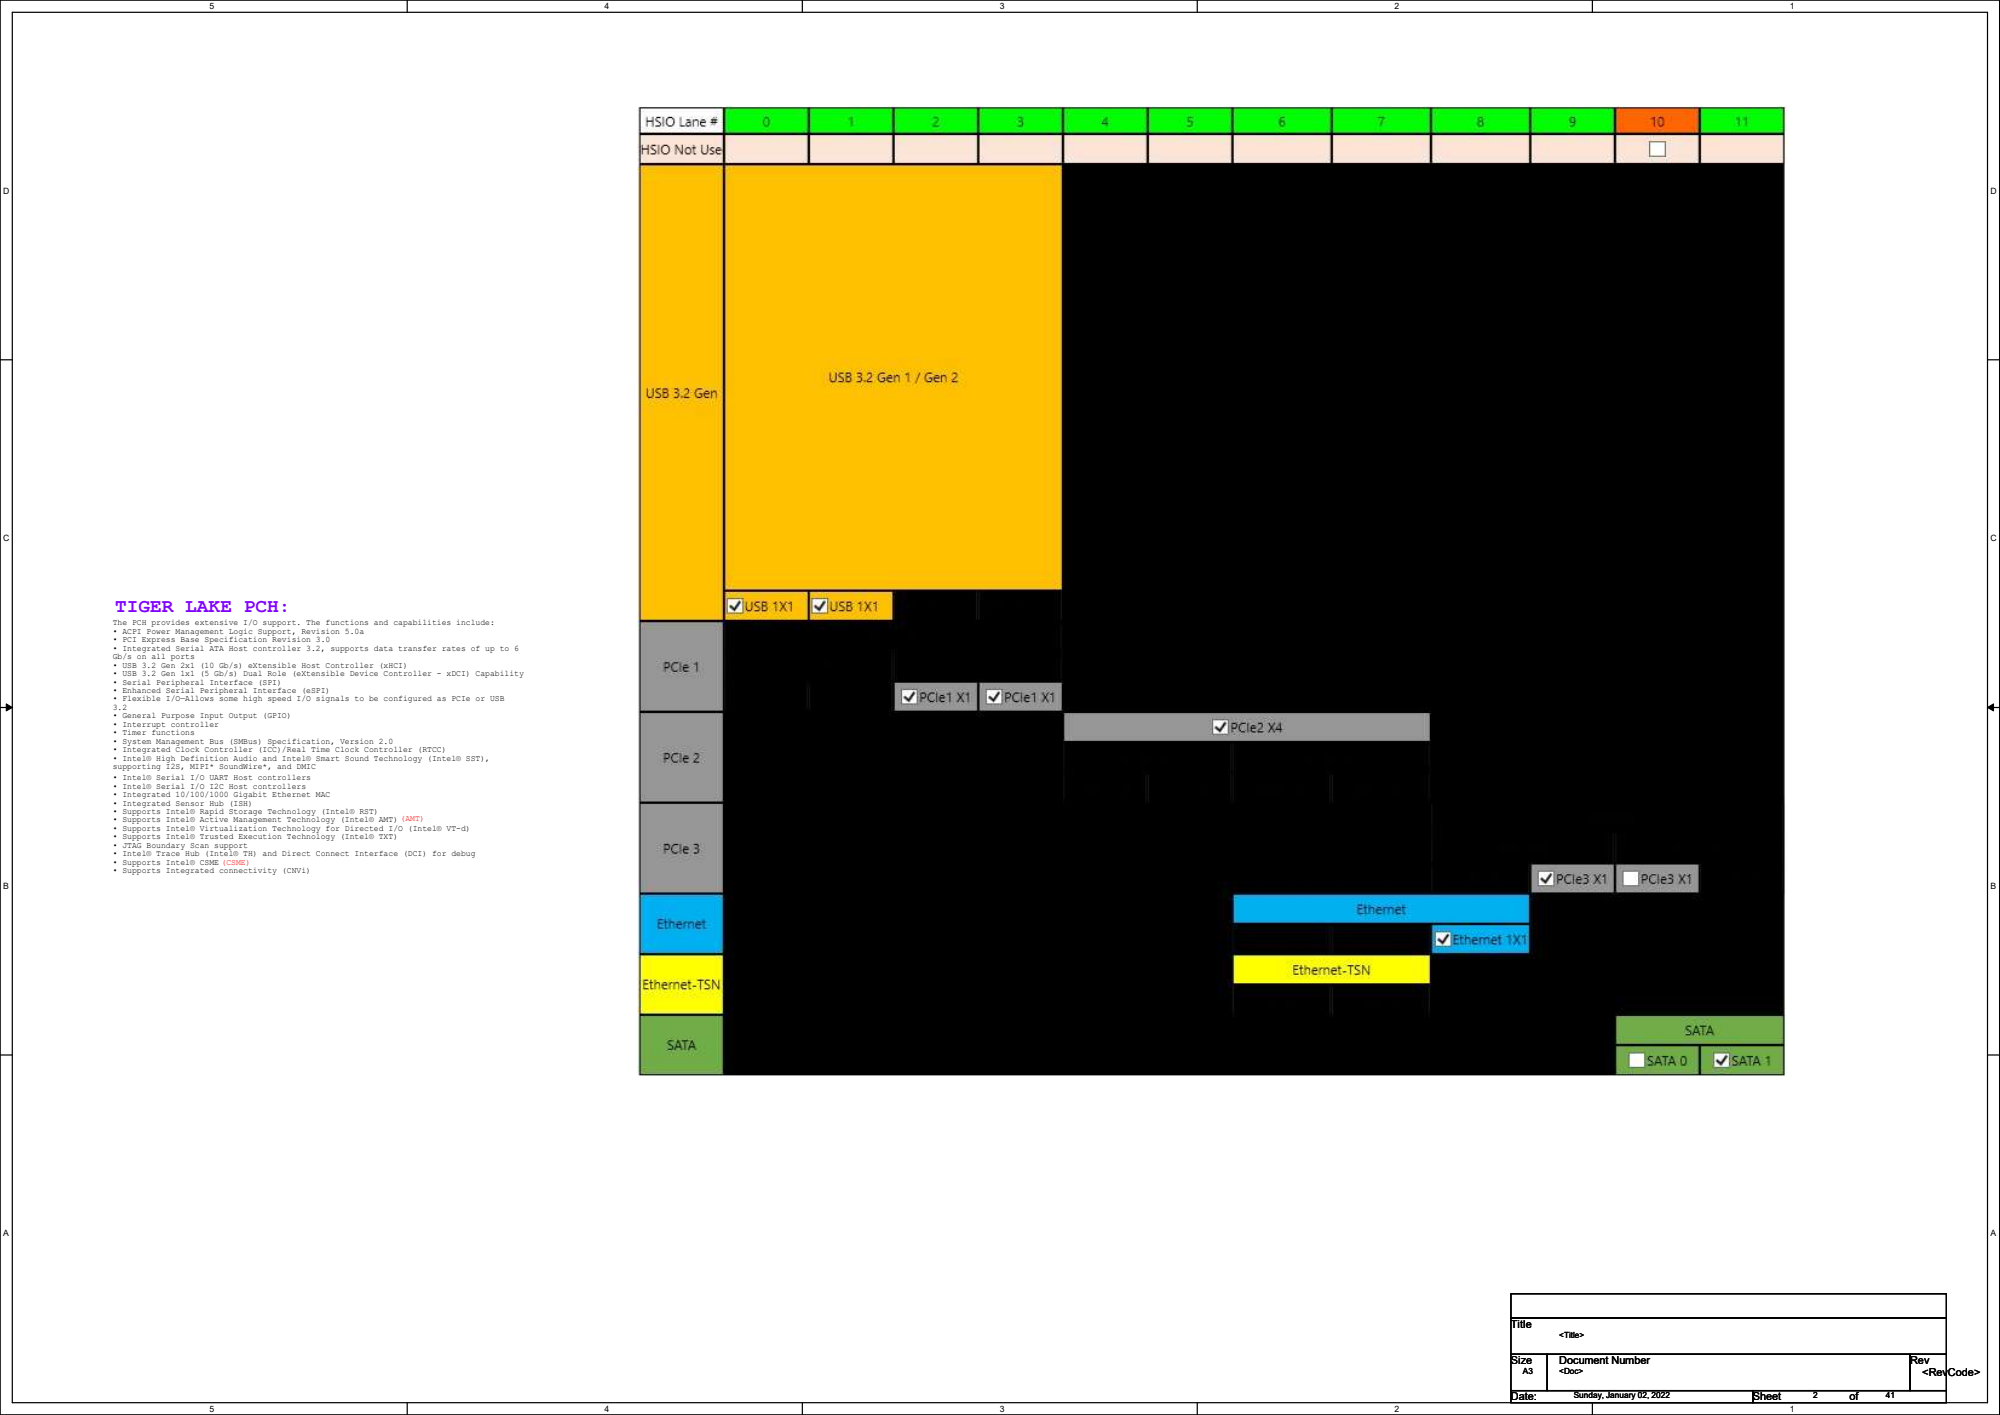
[picture p43: page 4]
(CSME); (AMT); <Title> A3; Sunday, January 02, 2022; 41 Title

TIGER LAKE PCH:

The PCH provides extensive I/O support. The functions and capabilities include:
• ACPI Power Management Logic Support, Revision 5.0a
• PCI Express Base Specification Revision 3.0
• Integrated Serial ATA Host controller 3.2, supports data transfer rates of up to 6
Gb/s on all ports
• USB 3.2 Gen 2x1 (10 Gb/s) eXtensible Host Controller (xHCI)
• USB 3.2 Gen 1x1 (5 Gb/s) Dual Role (eXtensible Device Controller - xDCI) Capability
• Serial Peripheral Interface (SPI)
• Enhanced Serial Peripheral Interface (eSPI)
• Flexible I/O—Allows some high speed I/O signals to be configured as PCIe or USB
• General Purpose Input Output (GPIO)
• Interrupt controller
• Timer functions
• System Management Bus (SMBus) Specification, Version 2.0
• Integrated Clock Controller (ICC)/Real Time Clock Controller (RTCC)
• Intel® High Definition Audio and Intel® Smart Sound Technology (Intel® SST),
supporting I2S, MIPI* SoundWire*, and DMIC
• Intel® Serial I/O UART Host controllers
• Intel® Serial I/O I2C Host controllers
• Integrated 10/100/1000 Gigabit Ethernet MAC
• Integrated Sensor Hub (ISH)
• Supports Intel® Rapid Storage Technology (Intel® RST)
• Supports Intel® Active Management Technology (Intel® AMT)
• Supports Intel® Virtualization Technology for Directed I/O (Intel® VT-d)
• Supports Intel® Trusted Execution Technology (Intel® TXT)
• JTAG Boundary Scan support
• Intel® Trace Hub (Intel® TH) and Direct Connect Interface (DCI) for debug
• Supports Intel® CSME
• Supports Integrated connectivity (CNVi)

# MCP -DP\HDMI

## TCP0 - HDMI PORT 2

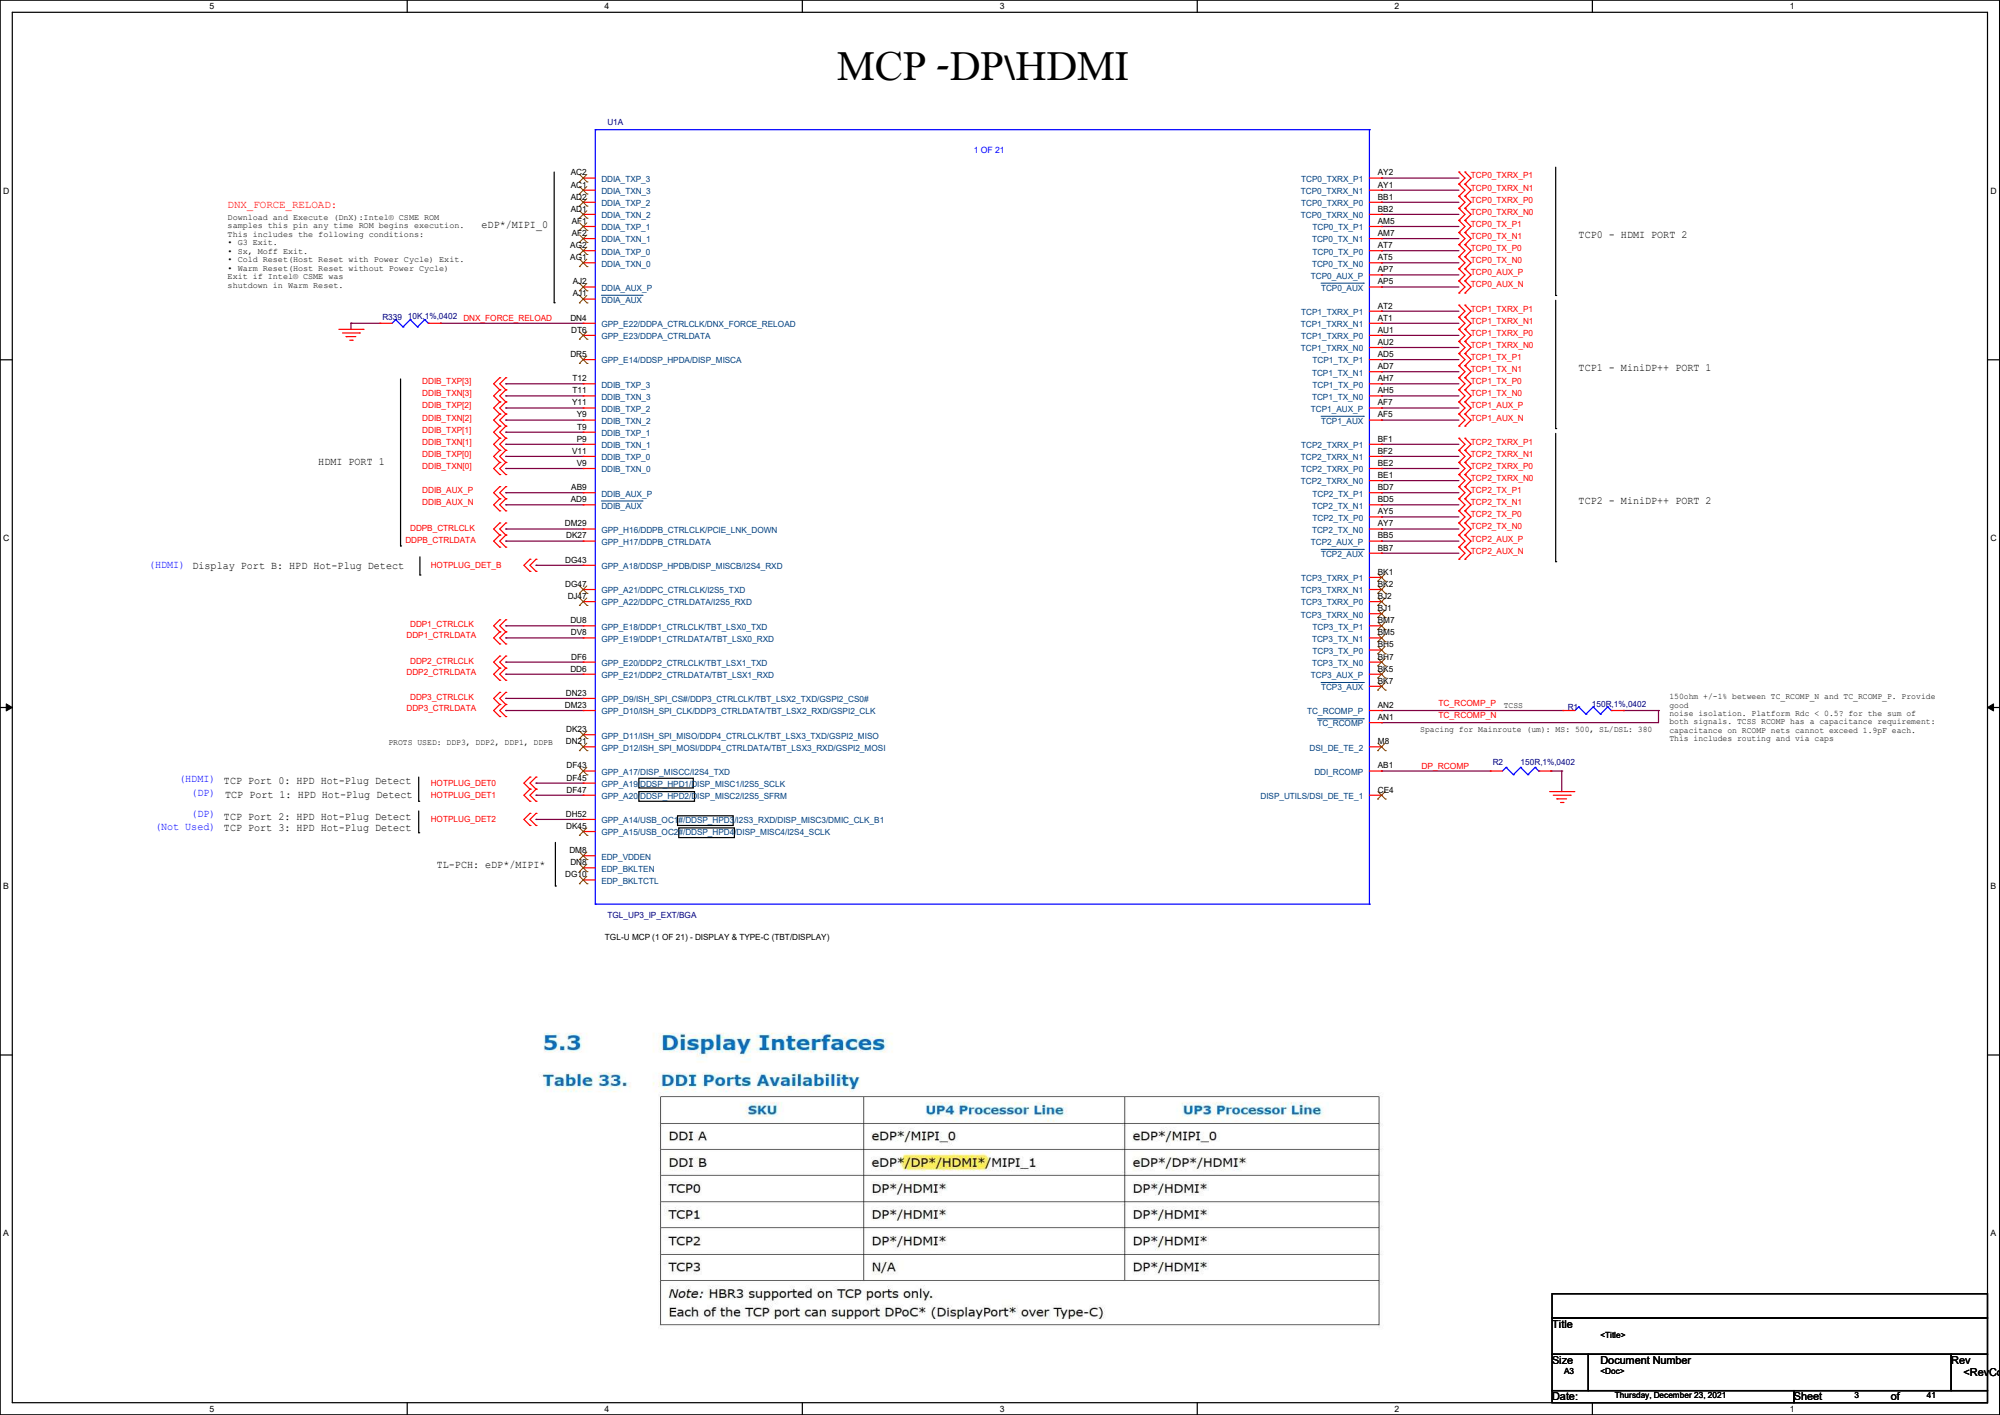
[picture p44: page 5]
TCP1 - MiniDP++ PORT 1; TCP2 - MiniDP++ PORT 2; HDMI PORT 1; eDP*/MIPI_0; (HDMI); (Not Used); TCSS; DNX_FORCE_RELOAD; DP_RCOMP; TCP0_TXRX_P1 TCP0_TXRX_N1 TCP0_TXRX_P0 TCP0_TXRX_N0 TCP0_TX_P1 TCP0_TX_N1 TCP0_TX_P0 TCP0_TX_N0 TCP0_AUX_P TCP0_AUX_N; TCP1_TXRX_P1 TCP1_TXRX_N1 TCP1_TXRX_P0 TCP1_TXRX_N0 TCP1_TX_P1 TCP1_TX_N1 TCP1_TX_P0 TCP1_TX_N0 TCP1_AUX_P TCP1_AUX_N; TCP2_TXRX_P1 TCP2_TXRX_N1 TCP2_TXRX_P0 TCP2_TXRX_N0 TCP2_TX_P1 TCP2_TX_N1 TCP2_TX_P0 TCP2_TX_N0 TCP2_AUX_P TCP2_AUX_N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

DNX_FORCE_RELOAD:
Download and Execute (DnX):Intel® CSME ROM
samples this pin any time ROM begins execution.
This includes the following conditions:
• G3 Exit.
• Sx, Moff Exit.
• Cold Reset(Host Reset with Power Cycle) Exit.
• Warm Reset(Host Reset without Power Cycle)
Exit if Intel® CSME was
shutdown in Warm Reset.

Display Port B: HPD Hot-Plug Detect

150ohm +/-1% between TC_RCOMP_N and TC_RCOMP_P. Provide
good
noise isolation. Platform Rdc < 0.5? for the sum of
both signals. TCSS RCOMP has a capacitance requirement:
capacitance on RCOMP nets cannot exceed 1.9pF each.
This includes routing and via caps

TC_RCOMP_P
TC_RCOMP_N
Spacing for Mainroute (um): MS: 500, SL/DSL: 380

PROTS USED: DDP3, DDP2, DDP1, DDPB

(HDMI)
TCP Port 1: HPD Hot-Plug Detect
TCP Port 2: HPD Hot-Plug Detect
TCP Port 3: HPD Hot-Plug Detect

TCP Port 0: HPD Hot-Plug Detect

TL-PCH: eDP*/MIPI*

TGL-U MCP (1 OF 21) - DISPLAY & TYPE-C (TBT/DISPLAY)

D D

C C

B B

A | NOP | A

Place R541 as close
as possible to MCP

DDR channel 0, byte
0, bit 7

DDR0_DQSP0 refers to DQSP of DDR channel 0, Byte 7.

Data Strobes: Differential data strobe pairs. The data is captured at the crossing point of DQS during reading and write transactions.

Address: These signals are used to provide the multiplexed row and column address to the SDRAM.

DDR0_MA[16:0]

## RANK 1 CLK

## RANK 0 CLK

## 1.CKP and CKN differential signal swapping within a pair is not allowed. Also, differential clock pair to clock

pair swapping within a channel is not allowed.

# MEMORY CHANNEL A

Chip Select: All commands are masked when CS_n is registered HIGH. CS_n provides for external Rank selection on systems with multiple Ranks. CS_n is considered part of the command code.

On Die Termination: ODT (registered HIGH) enables termination resistance internal to the DDR4 SDRAM. When enabled, ODT is only applied to each DQ, DQS_t, DQS_c and DM_n/DBI_n/TDQS_t,NU/TDQS_c (When TDQS is enabled via Mode Register A11=1 in MR1) signal for x8 configurations. For x16 configuration ODT is applied to each DQ, DQSU_c, DQSU_t, DQSL_t, DQSL_c, DMU_n, and DML_n signal. The ODT pin will be
ignored if MR1 is programmed to disable RTT_NOM.

ODT:

Bank Group Inputs: BG0 - BG1 define to which bank group an Active, Read, Write or Precharge command is
being applied. BG0 also detemines which mode register is to be accessed during a MRS cycle. x4/8 have BG0
and BG1 but x16 has only BG0.

Bank Address Inputs: BA0 - BA1 define to which bank an Active, Read, Write or Precharge command is being applied. Bank address also determines if the mode register or extended mode register is to be accessed during a MRS cycle.

Activation Command Input: ACT_n defines the Activation command being entered along with CS_n. The input into RAS_n/A16, CAS_n/A15 and WE_n/A14 will be considered as Row Address A16, A15 and A14.

Command and Address Parity Input : DDR4 Supports Even Parity check in DRAMs with MR
setting. Once it’s enabled via Register in MR5, then DRAM calculates Parity with ACT_n, RAS_n/A16, CAS_n/A15, WE_n/A14, BG0-BG1, BA0-BA1, A17-A0. Input parity should maintain at the rising edge of the clock and at the same time with command & address with CS_n LOW. Reference voltage for control, command, and address pins.

Data Strobe: output with read data, input with write data. Edge-aligned with read data, centered in write data. For the x16, DQSL corresponds to the data on DQL0-DQL7; DQSU corresponds to the data on DQU0-DQU7. The data strobe DQS_t, DQSL_t and DQSU_t are paired with differential signals DQS_c, DQSL_c, and DQSU_c, respectively, to provide differential pair signaling to the system during reads and writes. DDR4 SDRAM supports differential data strobe only and does not support single-ended.

1.CKP and CKN differential signal swapping within a pair is not allowed. Also, differential clock pair to clock pair swapping within a channel is not allowed. 2.DQ Bit swapping is allowed within the same byte
3.Byte Swapping is allowed within the same channel
4.DQSP and DQSN differential signal swapping within a pair is not allowed. NOTES:
Each lane of 8bits (Byte) of Data has it's own Data Strobe

(CTRL)

DDR_COMP_0

DRAM_RESET_N

+VDDQ

M_0_CLK_DDR1_DP
M_0_CLK_DDR1_DN

M_0_CLK_DDR0_DP
M_0_CLK_DDR0_DN

M_0_CKE_1
M_0_CKE_0

M_0_CS1_N
M_0_CS0_N

M_0_DQS_7_DP
M_0_DQS_7_DN
M_0_DQS_6_DP
M_0_DQS_6_DN
M_0_DQS_5_DP
M_0_DQS_5_DN
M_0_DQS_4_DP
M_0_DQS_4_DN
M_0_DQS_3_DP
M_0_DQS_3_DN
M_0_DQS_2_DP
M_0_DQS_2_DN
M_0_DQS_1_DP
M_0_DQS_1_DN
M_0_DQS_0_DP
M_0_DQS_0_DN

M_0_ODT1
M_0_ODT0

M_0_MA16_RAS_N
M_0_MA15_CAS_N
M_0_MA14_WE_N
M_0_MA13
M_0_MA12
M_0_MA11
M_0_MA10
M_0_MA9
M_0_MA8
M_0_MA7
M_0_MA6
M_0_MA5
M_0_MA4
M_0_MA3
M_0_MA2
M_0_MA1
M_0_MA0

M_0_BG1
M_0_BG0

M_0_BA1
M_0_BA0

M_0_ACT_N

M_0_PARITY

+V_D4CH0_CA_VREF

M_0_ALERT_N

DDR_VTT_CNTL
DRAM_RESET_N_R

M_0_DQ_0<7>
M_0_DQ_0<6>
M_0_DQ_0<5>
M_0_DQ_0<4>
M_0_DQ_0<3>
M_0_DQ_0<2>
M_0_DQ_0<1>
M_0_DQ_0<0>
M_0_DQ_1<7>
M_0_DQ_1<6>
M_0_DQ_1<5>
M_0_DQ_1<4>
M_0_DQ_1<3>
M_0_DQ_1<2>
M_0_DQ_1<1>
M_0_DQ_1<0>
M_0_DQ_2<7>
M_0_DQ_2<6>
M_0_DQ_2<5>
M_0_DQ_2<4>
M_0_DQ_2<3>
M_0_DQ_2<2>
M_0_DQ_2<1>
M_0_DQ_2<0>
M_0_DQ_3<7>
M_0_DQ_3<6>
M_0_DQ_3<5>
M_0_DQ_3<4>
M_0_DQ_3<3>
M_0_DQ_3<2>
M_0_DQ_3<1>
M_0_DQ_3<0>
M_0_DQ_4<7>
M_0_DQ_4<6>
M_0_DQ_4<5>
M_0_DQ_4<4>
M_0_DQ_4<3>
M_0_DQ_4<2>
M_0_DQ_4<1>
M_0_DQ_4<0>
M_0_DQ_5<7>
M_0_DQ_5<6>
M_0_DQ_5<5>
M_0_DQ_5<4>
M_0_DQ_5<3>
M_0_DQ_5<2>
M_0_DQ_5<1>
M_0_DQ_5<0>
M_0_DQ_6<7>
M_0_DQ_6<6>
M_0_DQ_6<5>
M_0_DQ_6<4>
M_0_DQ_6<3>
M_0_DQ_6<2>
M_0_DQ_6<1>
M_0_DQ_6<0>
M_0_DQ_7<7>
M_0_DQ_7<6>
M_0_DQ_7<5>
M_0_DQ_7<4>
M_0_DQ_7<3>
M_0_DQ_7<2>
M_0_DQ_7<1>
M_0_DQ_7<0>
<Title> A3 | Thursday, December 23, 2021 | 4 | 41 Title
<Title> A3 | Thursday, December 23, 2021 | 4 | 41 Title
<Title> A3 | Thursday, December 23, 2021 | 4 | 41

R3
475R
0201

LP4-LP5(NIL)/DDR4 (NIL)/DDR4 (IL)

DDR4/LP4/LP5/LP5 CMD Flip

DDR4/LP4/LP5/LP5 CMD Flip

DDR4/LP4/LP5/LP5 CMD Flip

DDR4/LP4/LP5/LP5 CMD Flip

DDR4/LP4/LP5/LP5 CMD Flip

DDR4/LP4/LP5/LP5 CMD Flip

LP4-LP5(NIL)/DDR4 (NIL)/DDR4 (IL)

DDR4/LP4/LP5/LP5 CMD Flip

DDR4/LP4/LP5/LP5 CMD Flip

DDR4/LP4/LP5/LP5 CMD Flip

DDR4/LP4/LP5/LP5 CMD Flip

DDR4/LP4/LP5/LP5 CMD Flip

### 2 OF 21 U1B

TGL_UP3_IP_EXT/BGA

DDR0_ALERT# AU50
? DDR0_VREF_CA
AU49 DDR_VTT_CTL | E52 DDR_RCOMP | C49 DDR0_BG0/DDR2_CA3/DDR2_CA4/DDR2_CS1 | BL52 DDR0_MA5/DDR0_CA5/DDR0_CA6/DDR0_CA0 | BY50 DDR0_ODT1/DDR1_CA0/DDR1_CA0/DDR1_CA6 | CF44
DDR0_CKE1/DDR2_CA4/DDR2_CA5/DDR2_CA1 | BU52 NC/DDR1_CKE0/DDR1_WCK_P/DDR1_WCK_P | CD45
DDR3_DQ1_0/DDR0_DQ7_0/DDR1_DQ3_0 BD41 | DDR3_DQ1_5/DDR0_DQ7_5/DDR1_DQ3_5 BD45 | DDR3_DQ0_0/DDR0_DQ6_0/DDR1_DQ2_0 BH41 | DDR3_DQ0_5/DDR0_DQ6_5/DDR1_DQ2_5 BH47 | DDR2_DQ1_0/DDR0_DQ5_0/DDR0_DQ3_0 BC49 | DDR2_DQ1_5/DDR0_DQ5_5/DDR0_DQ3_5 AY50 | DDR2_DQ0_0/DDR0_DQ4_0/DDR0_DQ2_0 BH49 | DDR2_DQ0_5/DDR0_DQ4_5/DDR0_DQ2_5 BF50 | DDR1_DQ1_0/DDR0_DQ3_0/DDR1_DQ1_0 CK41 | DDR1_DQ1_5/DDR0_DQ3_5/DDR1_DQ1_5 CK45 | DDR1_DQ0_0/DDR0_DQ2_0/DDR1_DQ0_0 CV41 | DDR1_DQ0_5/DDR0_DQ2_5/DDR1_DQ0_5 CT45 | DDR0_DQ1_0/DDR0_DQ1_0/DDR0_DQ1_0 CL49 | DDR0_DQ1_5/DDR0_DQ1_5/DDR0_DQ1_5 CH50 | DDR0_DQ0_0/DDR0_DQ0_0/DDR0_DQ0_0 CU49 | DDR0_DQ0_5/DDR0_DQ0_5/DDR0_DQ0_5 CP50
DDR3_DQ1_3/DDR0_DQ7_3/DDR1_DQ3_3 BB42 | DDR3_DQ0_3/DDR0_DQ6_3/DDR1_DQ2_3 BH42 | DDR2_DQ1_3/DDR0_DQ5_3/DDR0_DQ3_3 BC53 | DDR2_DQ0_3/DDR0_DQ4_3/DDR0_DQ2_3 BH53 | DDR1_DQ1_3/DDR0_DQ3_3/DDR1_DQ1_3 CK42 | DDR1_DQ0_3/DDR0_DQ2_3/DDR1_DQ0_3 CT42 | DDR0_DQ1_3/DDR0_DQ1_3/DDR0_DQ1_3 CL53 | DDR0_DQ0_3/DDR0_DQ0_3/DDR0_DQ0_3 CU53
DDR0_BA0/DDR3_CA0/DDR3_CA0/DDR3_CA6 | BV44 DDR0_MA2/DDR3_CS0/DDR3_CA2/DDR3_CA2 | BV47 DDR0_MA11/NC/DDR2_CS1/DDR2_CA4 | BT51 DDR0_MA3/DDR0_CS1/DDR0_CS0/DDR0_CA3 | CD53
DDR0_CS1/DDR1_CA1/DDR1_CA1/DDR1_CA5 | CF42
DDR3_DQ1_1/DDR0_DQ7_1/DDR1_DQ3_1 BD42 | DDR3_DQ1_2/DDR0_DQ7_2/DDR1_DQ3_2 BB41 | DDR3_DQ1_6/DDR0_DQ7_6/DDR1_DQ3_6 BB47 | DDR3_DQ1_7/DDR0_DQ7_7/DDR1_DQ3_7 BD47 | DDR3_DQ0_1/DDR0_DQ6_1/DDR1_DQ2_1 BK41 | DDR3_DQ0_2/DDR0_DQ6_2/DDR1_DQ2_2 BK42 | DDR3_DQ0_6/DDR0_DQ6_6/DDR1_DQ2_6 BK45 | DDR3_DQ0_7/DDR0_DQ6_7/DDR1_DQ2_7 BK47 | DDR2_DQ1_1/DDR0_DQ5_1/DDR0_DQ3_1 BC50 | DDR2_DQ1_2/DDR0_DQ5_2/DDR0_DQ3_2 BC52 | DDR2_DQ1_6/DDR0_DQ5_6/DDR0_DQ3_6 AY52 | DDR2_DQ1_7/DDR0_DQ5_7/DDR0_DQ3_7 AY53 | DDR2_DQ0_1/DDR0_DQ4_1/DDR0_DQ2_1 BH50 | DDR2_DQ0_2/DDR0_DQ4_2/DDR0_DQ2_2 BH52 | DDR2_DQ0_6/DDR0_DQ4_6/DDR0_DQ2_6 BF52 | DDR2_DQ0_7/DDR0_DQ4_7/DDR0_DQ2_7 BF53 | DDR1_DQ1_1/DDR0_DQ3_1/DDR1_DQ1_1 CM41 | DDR1_DQ1_2/DDR0_DQ3_2/DDR1_DQ1_2 CM42 | DDR1_DQ1_6/DDR0_DQ3_6/DDR1_DQ1_6 CM47 | DDR1_DQ1_7/DDR0_DQ3_7/DDR1_DQ1_7 CK47 | DDR1_DQ0_1/DDR0_DQ2_1/DDR1_DQ0_1 CT41 | DDR1_DQ0_2/DDR0_DQ2_2/DDR1_DQ0_2 CV42 | DDR1_DQ0_6/DDR0_DQ2_6/DDR1_DQ0_6 CV47 | DDR1_DQ0_7/DDR0_DQ2_7/DDR1_DQ0_7 CT47 | DDR0_DQ1_1/DDR0_DQ1_1/DDR0_DQ1_1 CL50 | DDR0_DQ1_2/DDR0_DQ1_2/DDR0_DQ1_2 CL52 | DDR0_DQ1_6/DDR0_DQ1_6/DDR0_DQ1_6 CH52 | DDR0_DQ1_7/DDR0_DQ1_7/DDR0_DQ1_7 CH53 | DDR0_DQ0_1/DDR0_DQ0_1/DDR0_DQ0_1 CU50 | DDR0_DQ0_2/DDR0_DQ0_2/DDR0_DQ0_2 CU52 | DDR0_DQ0_6/DDR0_DQ0_6/DDR0_DQ0_6 CP52 | DDR0_DQ0_7/DDR0_DQ0_7/DDR0_DQ0_7 CP53
DDR0_BA1/DDR1_CA5/DDR1_CA6/DDR1_CA0 | CB42 DDR0_MA0/NC/DDR3_CS1/DDR3_CA4 | BV41 DDR0_MA8/DDR0_CA2/DDR0_CA3/DDR0_CS0 | BY53

NC/DDR3_CKE0/DDR3_WCK_P/DDR3_WCK_P

BT45

DDR0_PAR/DDR3_CS1/DDR3_CS0/DDR3_CA3 | BV45
NC/DDR3_CA2/DDR3_CA3/DDR3_CS0 | BP44 NC/DDR3_CA3/DDR3_CA4/DDR3_CS1 | BP45
DDR0_MA9/DDR2_CA0/DDR2_CA0/DDR2_CA6 | BU50 DDR0_MA13/DDR1_CS1/DDR1_CS0/DDR1_CA3 | CF41
NC/DDR3_CA4/DDR3_CA5/DDR3_CA1 | BP42 NC/DDR3_CA5/DDR3_CA6/DDR3_CA0 | BP47 NC/DDR2_CKE0/DDR2_WCK_P/DDR2_WCK_P

BN51
DDR0_MA10/DDR3_CA1/DDR3_CA1/DDR3_CA5 | BV42 DDR0_MA15/DDR1_CA3/DDR1_CA4/DDR1_CS1 | CB44 DDR0_DQSP_0/DDR0_DQSP_0/DDR0_DQSP_0 | CR51 DDR0_DQSP_1/DDR0_DQSP_1/DDR0_DQSP_1 | CK51 DDR1_DQSP_0/DDR0_DQSP_2/DDR1_DQSP_0 | CT44 DDR1_DQSP_1/DDR0_DQSP_3/DDR1_DQSP_1 | CK44 DDR2_DQSP_0/DDR0_DQSP_4/DDR0_DQSP_2 | BG51 DDR2_DQSP_1/DDR0_DQSP_5/DDR0_DQSP_3 | BA51 DDR3_DQSP_0/DDR0_DQSP_6/DDR1_DQSP_2 | BK44 DDR3_DQSP_1/DDR0_DQSP_7/DDR1_DQSP_3 | BB44 NC/DDR0_CA1/DDR0_CA1/DDR0_CA5 | CE50 NC/DDR0_CA0/DDR0_CA0/DDR0_CA6 | CE53 DDR0_CKE0/DDR2_CA5/DDR2_CA6/DDR2_CA0 | BL50 NC/DDR0_CKE1/DDR0_WCK_N/DDR0_WCK | CA53 NC/DDR1_CKE1/DDR1_WCK_N/DDR1_WCK | CD47 NC/DDR2_CKE1/DDR2_WCK_N/DDR2_WCK

BN53 NC/DDR3_CKE1/DDR3_WCK_N/DDR3_WCK

BT47 NC/DDR2_CLK_P/DDR2_CLK_P/DDR2_CLK_P

BP52
DDR0_BG1/DDR2_CA2/DDR2_CA3/DDR2_CS0 | BN50 DDR0_MA1/NC/DDR0_CS1/DDR0_CA4 | CE52 DDR0_MA4/DDR0_CS0/DDR0_CA2/DDR0_CA2 | CD51 DDR0_DQSN_0/DDR0_DQSN_0/DDR0_DQSN_0 | CR50 DDR0_DQSN_1/DDR0_DQSN_1/DDR0_DQSN_1 | CK50 DDR1_DQSN_0/DDR0_DQSN_2/DDR1_DQSN_0 | CV44 DDR1_DQSN_1/DDR0_DQSN_3/DDR1_DQSN_1 | CM44 DDR2_DQSN_0/DDR0_DQSN_4/DDR0_DQSN_2 | BG50 DDR2_DQSN_1/DDR0_DQSN_5/DDR0_DQSN_3 | BA50 DDR3_DQSN_0/DDR0_DQSN_6/DDR1_DQSN_2 | BH44 DDR3_DQSN_1/DDR0_DQSN_7/DDR1_DQSN_3 | BD44

NC/DDR2_CLK_N/DDR2_CLK_N/DDR2_CLK

BP53

DDR0_ACT#/DDR2_CS1/DDR2_CS0/DDR2_CA3 | BT53
DDR0_MA16/DDR1_CA4/DDR1_CA5/DDR1_CA1 | CB47 DDR0_MA7/DDR0_CA4/DDR0_CA5/DDR0_CA1 | CA50
NC/DDR2_CS0/DDR2_CA2/DDR2_CA2 | BL53
NC/DDR1_CLK_P/DDR1_CLK_P/DDR1_CLK_P | CD42
DDR0_ODT0/DDR1_CS0/DDR1_CA2/DDR1_CA2 | CF45
DDR0_CLK_N0/DDR0_CLK_N/DDR0_CLK_N/DDR0_CLK | CC53 DDR0_CLK_N1/DDR3_CLK_N/DDR3_CLK_N/DDR3_CLK
BT41 NC/DDR0_CKE0/DDR0_WCK_P/DDR0_WCK_P | CA51 DDR0_CLK_P0/DDR0_CLK_P/DDR0_CLK_P/DDR0_CLK_P | CC52
DDR0_MA12/DDR2_CA1/DDR2_CA1/DDR2_CA5 | BU53 DDR0_MA14/DDR1_CA2/DDR1_CA3/DDR1_CS0 | CB45
DDR0_CS0/NC/DDR1_CS1/DDR1_CA4 | CF47 NC/DDR1_CLK_N/DDR1_CLK_N/DDR1_CLK | CD41 DDR0_CLK_P1/DDR3_CLK_P/DDR3_CLK_P/DDR3_CLK_P

BT42
DDR3_DQ1_4/DDR0_DQ7_4/DDR1_DQ3_4 BB45 | DDR3_DQ0_4/DDR0_DQ6_4/DDR1_DQ2_4 BH45 | DDR2_DQ1_4/DDR0_DQ5_4/DDR0_DQ3_4 AY49 | DDR2_DQ0_4/DDR0_DQ4_4/DDR0_DQ2_4 BF49 | DDR1_DQ1_4/DDR0_DQ3_4/DDR1_DQ1_4 CM45 | DDR1_DQ0_4/DDR0_DQ2_4/DDR1_DQ0_4 CV45 | DDR0_DQ1_4/DDR0_DQ1_4/DDR0_DQ1_4 CH49 | DDR0_DQ0_4/DDR0_DQ0_4/DDR0_DQ0_4 CP49
DRAM_RESET# | DV47
DDR0_MA6/DDR0_CA3/DDR0_CA4/DDR0_CS1 | BY52 | C1

100nF

100R | R5 | R4
0R | 0201

# MEMORY CHANNEL B

J41 | DDR6_DQ1_0/DDR1_DQ5_0/DDR0_DQ7_0 A40 | DDR6_DQ1_5/DDR1_DQ5_5/DDR0_DQ7_5 B38 | DDR6_DQ0_0/DDR1_DQ4_0/DDR0_DQ6_0 E47 | DDR6_DQ0_5/DDR1_DQ4_5/DDR0_DQ6_5 D43 | DDR5_DQ1_0/DDR1_DQ3_0/DDR1_DQ5_0 AL47 | DDR5_DQ1_5/DDR1_DQ3_5/DDR1_DQ5_5 AL41 | DDR5_DQ0_0/DDR1_DQ2_0/DDR1_DQ4_0 AV47 | DDR5_DQ0_5/DDR1_DQ2_5/DDR1_DQ4_5 AR42 | DDR4_DQ1_0/DDR1_DQ1_0/DDR0_DQ5_0 AH49 | DDR4_DQ1_5/DDR1_DQ1_5/DDR0_DQ5_5 AF50 | DDR4_DQ0_0/DDR1_DQ0_0/DDR0_DQ4_0 AP49 | DDR4_DQ0_5/DDR1_DQ0_5/DDR0_DQ4_5 AL50

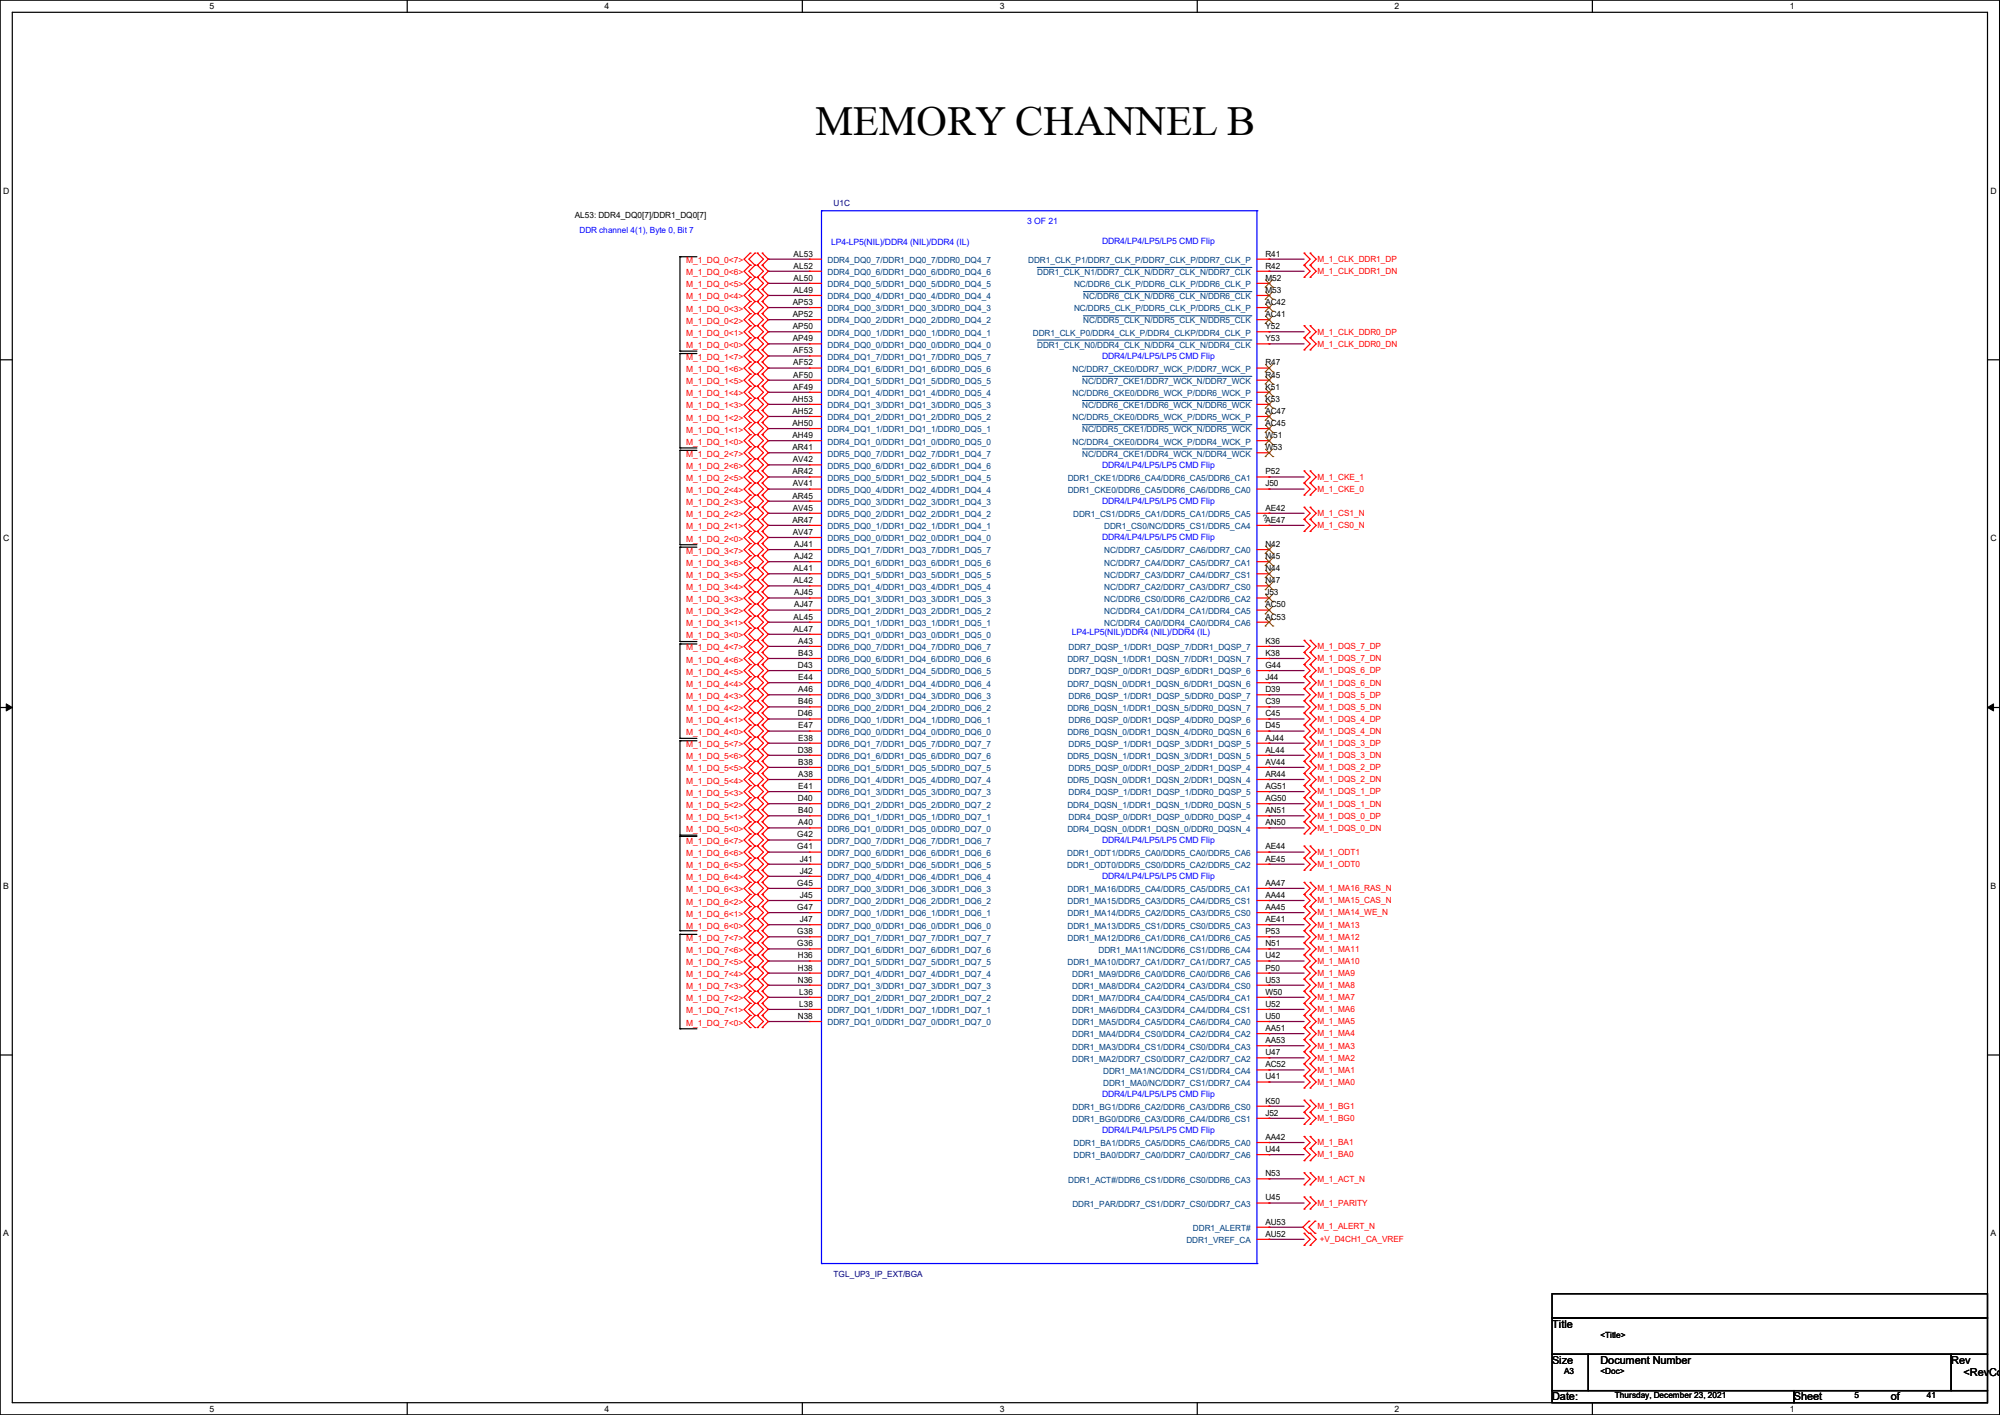
[picture p45: page 7]

AL53: DDR4_DQ0[7]/DDR1_DQ0[7]
DDR channel 4(1), Byte 0, Bit 7

D D

C C

B B

A A

The PROCHOT# (processor hot) signal is asserted by the processor when the TCC is
active. Only a single PROCHOT# pin exists at a package level. When any DTS
temperature reaches the TCC activation temperature, the PROCHOT# signal will be
asserted. PROCHOT# assertion policies are independent of Adaptive Thermal Monitor enabling. The PROCHOT# signal can be configured to the following modes:
- Input Only: PROCHOT is driven by an external device.
- Output Only: PROCHOT is driven by processor.
- Bi-Directional: Both Processor and external device can drive PROCHOT signal

# PROCHOT#

## Time Synchronization: Used for synchronization both input (latch time when pin asserted) and output

(toggle pin when programmed time is hit).

## Time Synchronization GPIO 0: Timed GPIO event for time synchronization for interfaces that do not support time

synchronization natively.

CATERR# Catastrophic Error: This signal indicates that the system has experienced a catastrophic error and cannot continue to operate. The processor will set this signal for non-recoverable machine check errors or other unrecoverable internal errors. CATERR# is used for signaling the following types of errors: Legacy MCERRs, CATERR# is asserted for 16 BCLKs. Legacy IERRs, CATERR# remains

asserted until warm or cold reset.

The PCH supports two Timed GPIOs as native function (TIME_SYNC) that is muxed on GPIO pins. The intent usage of the Timed GPIO function is for time synchronization purpose.
Timed GPIO can be an input or an output.
- As an input, a GPIO input event triggers the HW to capture the PCH Always Running Timer (ART) time in the Time Capture register. The GPIO input event must be asserted for at least two crystal oscillator clocks period in order for the event to be recognized.
- As an output, a match between the ART time and the software programmed time value triggers the HW to generate a GPIO output event and capture the ART time in the Time Capture register. If periodic mode is enabled, HW generates the
periodic GPIO events based on the programmed interval. The GPIO output event is asserted by HW for at least two crystal oscillator clocks period.

TIME_SYNC:

## Stall CPU reset sequence until de-asserted: - 1 = (Default) Normal

Operation; No stall.

## - 0 = Stall

## EAR_N:

Place R348, R347, R345,
R346 Within 1 inch from
SOC.

(CPU OUTPUT) PROC_POPIRCOMP

PCH_OPIRCOMP | CATERR# THRMTRIP# | CPU_EAR

+VCCST_CPU

+VCCST_CPU

+VCCST_CPU

+VCCSTG_TERM

H_PROCHOT_CPU#

UART0_WAKE#

DBG_PMODE

GPPC_H0

GPPC_H1

GNSS_DISABLE_N

CPU_TRST_N
JTAG_TMS
JTAG_TDO
JTAG_TDI
JTAG_CPU_TCK

JTAG_TMS
JTAG_TDO
JTAG_TDI
JTAG_CPU_TCK
CPU_TRST_N

CPU_PREQ_N
CPU_PRDY_N
<Title> A3 | Thursday, December 23, 2021 | 6 | 41 Title
<Title> A3 | Thursday, December 23, 2021 | 6 | 41 Title
<Title> A3 | Thursday, December 23, 2021 | 6 | 41
R56 49.9R,1%,0402 | R346

49.9R,1%,0402 R58
1K,1%,0402

### 21 OF 21 U1U

TGL_UP3_IP_EXT/BGA

PECI BK9 | PCH_OPIRCOMP CB9 | DBG_PMODE DF4 | PCH_JTAGX | D8 PROC_TRST# | K4 GPP_H2 DF31 | PROC_POPIRCOMP CT39 | GPP_H1 DV32 | GPP_E3/CPU_GP0 DU5 | GPP_E7/CPU_GP1 DF8 | GPP_H0 DW32 | PROC_PRDY# | D11 GPP_F10 | DT14 PCH_TMS

A9 PROC_TCK

B6 PROC_TDO

D12 CATERR# M7 | PCH_TCK
A7 PCH_TDI | B12 THRMTRIP# M5 | EAR_N/EAR_N_TEST_NCTF | G1 GPP_B3/CPU_GP2 DB41 | GPP_B4/CPU_GP3 DB42 | PROCHOT# E2 | PCH_TRST# | H4 PCH_TDO
E12 PROC_PREQ# | C11 TP_1 CW12 | GPP_F7 | DT15 GPP_H19/TIME_SYNC0 DJ27 | TP_2 CM39 | PROC_TMS
B9 GPP_F9 | DR15
PROC_TDI | A12 TP43 | R347
49.9R
TP56 TP53 | R198

1K,1%,0402

R348
49.9R
TP42 | R345 100R

### 4 OF 21 U1D

TGL_UP3_IP_EXT/BGA

RSVD_3 DW47

? | RSVD_2 DV24
? | RSVD_5 A48
? | RSVD_4 DW49
?

TP55 R57
1K,1%,0402 R55 | 49.9R,1%,0402 | TP54

D D

C C

B B

A A

When OE is HIGH, the switch is ON and Port A is connected to Port B. When OE is LOW, the switch is OPEN and a
high-impedance state exists between the two ports.
when we are in sleep:
SLP_S3#=0, In that case we don't want to

pass anything.

BUS SWITCH | Goes to DDR4 SODDIMM

## NOP

### SPI_TPM_HEADER
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
