firasgany77/Board-Design-Git/Projects/Tensor I22/Schematics/Extension Board.pdf

## 80x2, 0.635mm pitch

## mini DP ++ 2

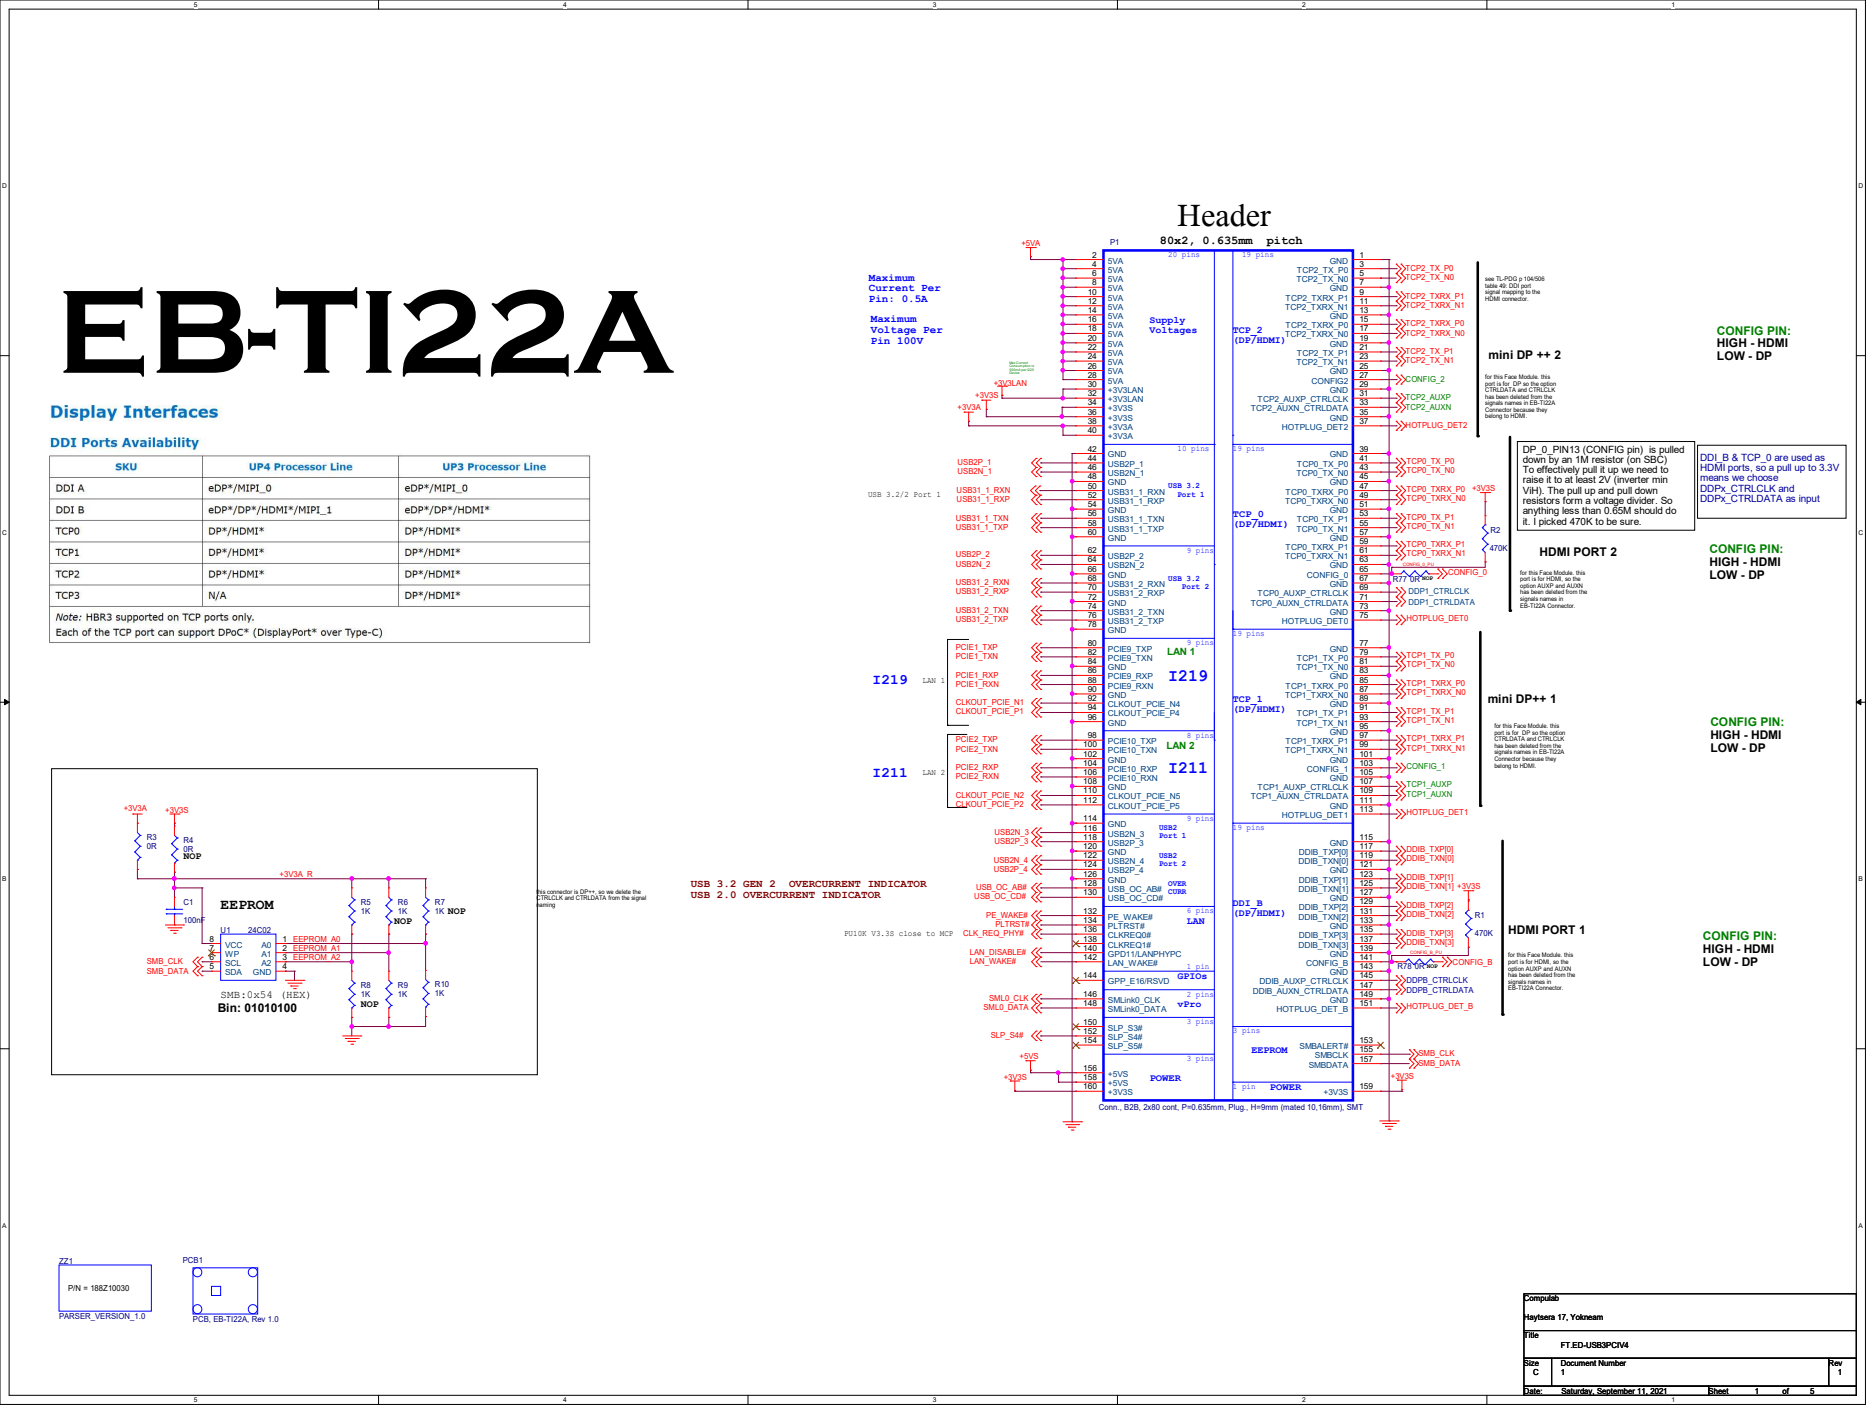
[picture p46: page 1]

see TL-PDG p 104/506
table 49: DDI port signal mapping to the HDMI connector.

CONFIG PIN: for this Face Module. this port is for DP so the option CTRLDATA and CTRLCLK

has been deleted from the
signals names in EB-TI22A Connector because they belong to HDMI.

DP_0_PIN13 (CONFIG pin) is pulled
down by an 1M resistor (on SBC)
To effectively pull it up we need to
raise it to at least 2V (inverter min
ViH). The pull up and pull down
resistors form a voltage divider. So
anything less than 0.65M should do
it. I picked 470K to be sure.
HOTPLUG_DET1 CONFIG_1 CONFIG_0 HOTPLUG_DET0 DDPB_CTRLCLK DDPB_CTRLDATA HOTPLUG_DET_B
DDIB_TXP[3] DDIB_TXN[3] DDIB_TXP[0] DDIB_TXN[0] DDIB_TXP[2] DDIB_TXN[2] DDIB_TXP[1] DDIB_TXN[1] TCP1_TXRX_P1 TCP1_TXRX_N1 TCP1_TX_P0 TCP1_TX_N0CONFIG_B

DDI_B & TCP_0 are used as
HDMI ports, so a pull up to 3.3V
means we choose
DDPx_CTRLCLK and
DDPx_CTRLDATA as input

for this Face Module. this port is for HDMI, so the
option AUXP and AUXN

signals names in EB-TI22A Connector. +3V3A_R

for this Face Module. this port is for DP so the option CTRLDATA and CTRLCLK

USB 3.2 GEN 2 OVERCURRENT INDICATOR
USB 2.0 OVERCURRENT INDICATOR

this connector is DP++, so we delete the CTRLCLK and CTRLDATA from the signal naming

signals names in EB-TI22A Connector.

# HDMI Port 1

### (DDI_B Port)

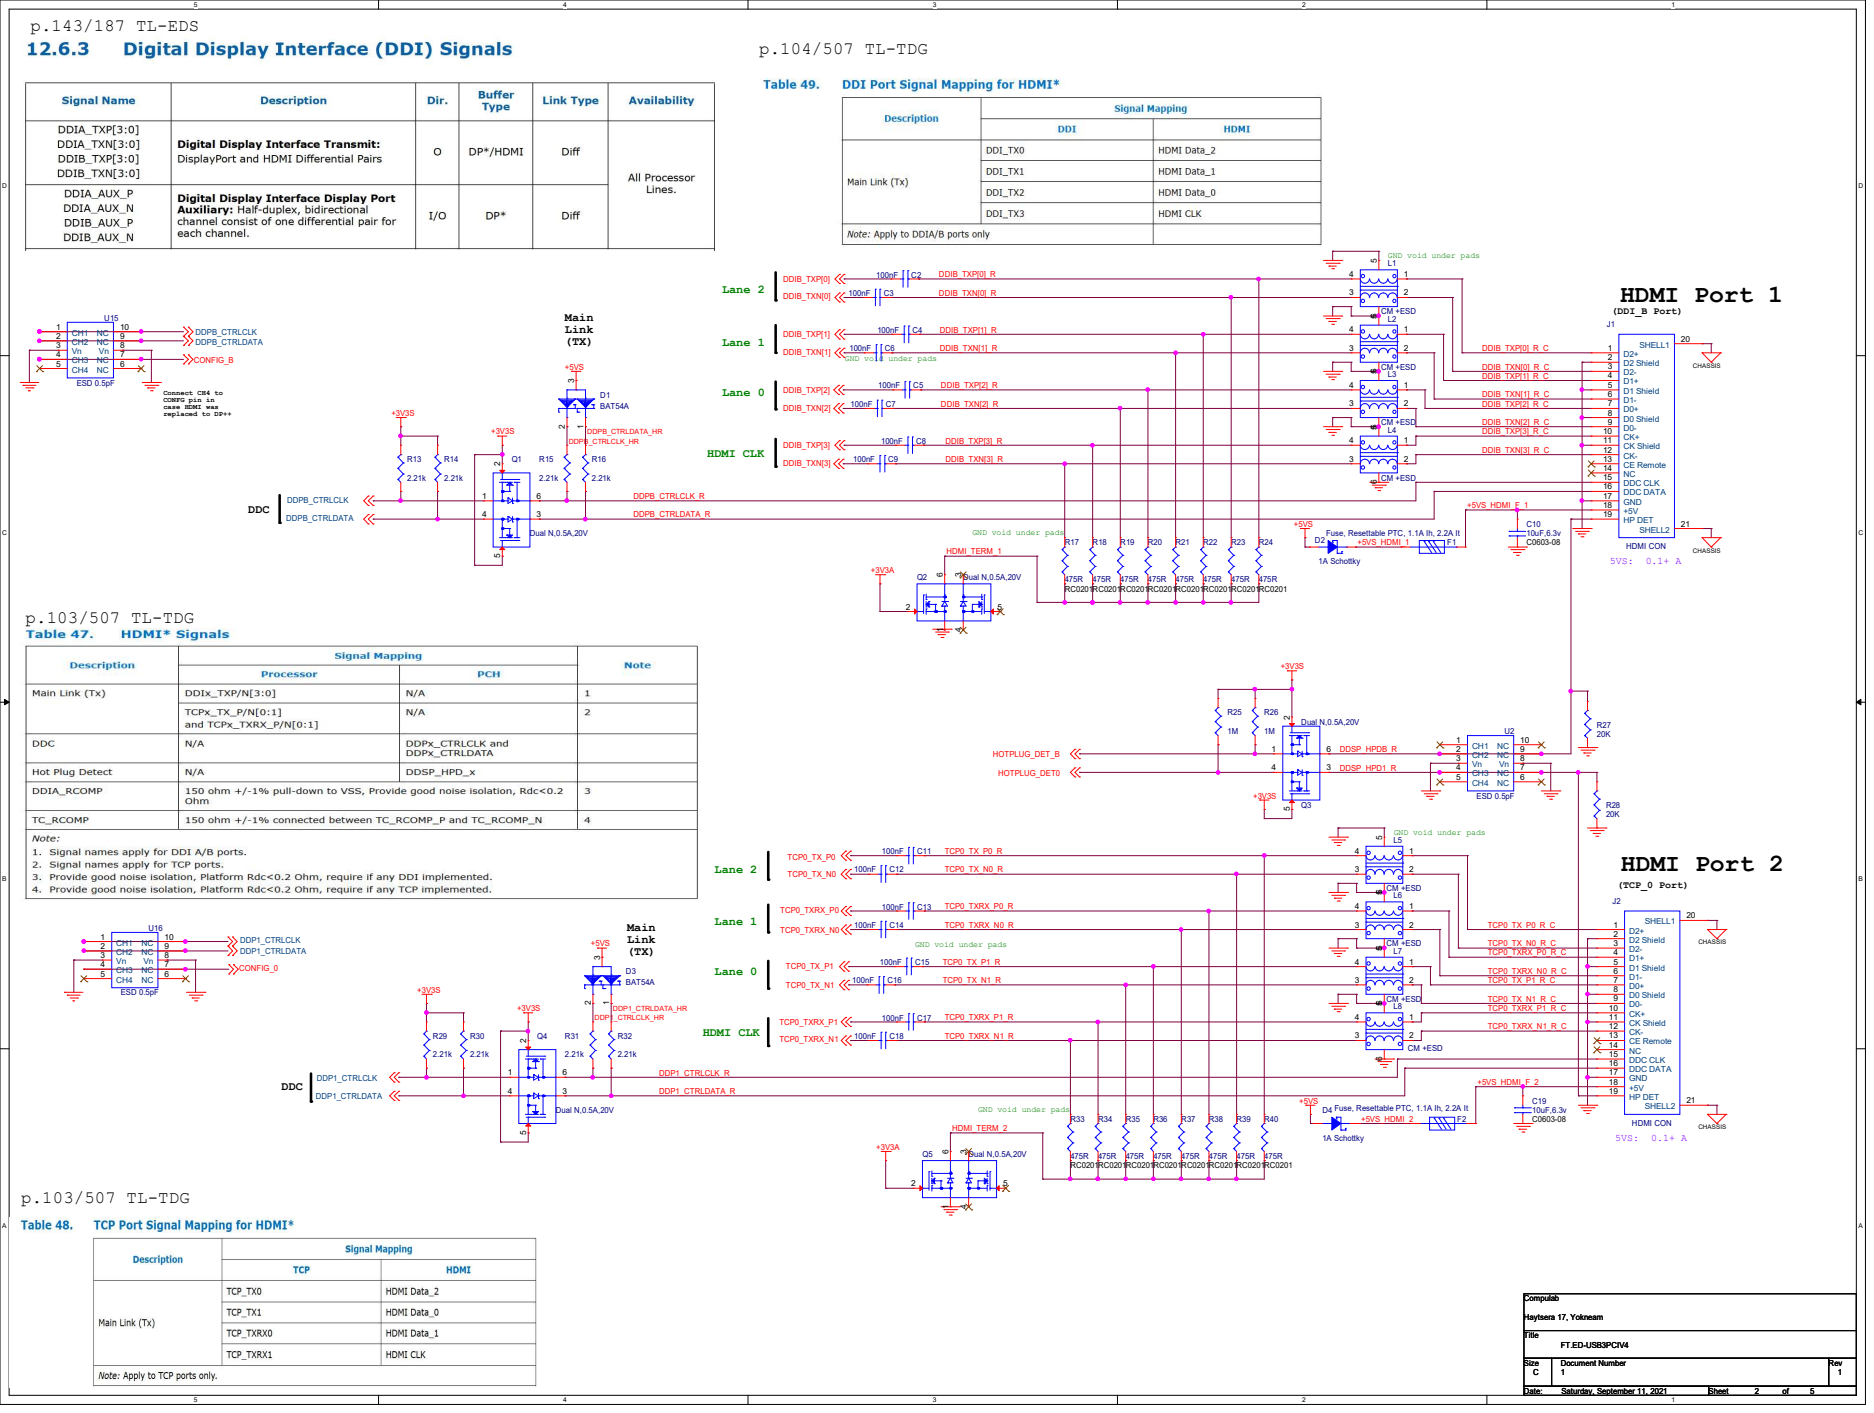
[picture p47: page 2]

SHELL1 20 SHELL2 21 D2+ 1 D2 Shield 2 D2- 3 D1+ 4 D1 Shield 5 D1- 6 D0+ 7 D0 Shield 8 D0- 9 CK+ 10 CK Shield 11 CK- 12 CE Remote 13 NC 14 DDC CLK 15 DDC DATA 16 GND 17 +5V 18 HP DET 19 R13

GND void under pads

5 6 U2 ESD 0.5pF Vn 3 Vn 8 CH1 1 CH2 2 CH3 4 CH4 5 NC 10 NC 9 NC 7 NC 6

F1 Fuse, Resettable PTC, 1.1A Ih, 2.2A It

HDMI Port 2
SHELL1 20 SHELL2 21 D2+ 1 D2 Shield 2 D2- 3 D1+ 4 D1 Shield 5 D1- 6 D0+ 7 D0 Shield 8 D0- 9 CK+ 10 CK Shield 11 CK- 12 CE Remote 13 NC 14 DDC CLK 15 DDC DATA 16 GND 17 +5V 18 HP DET 19

5 6 F2 Fuse, Resettable PTC, 1.1A Ih, 2.2A It L8

TCP0_TX_P1_R

# mini DP++ 1

### (TCP_1 Port)

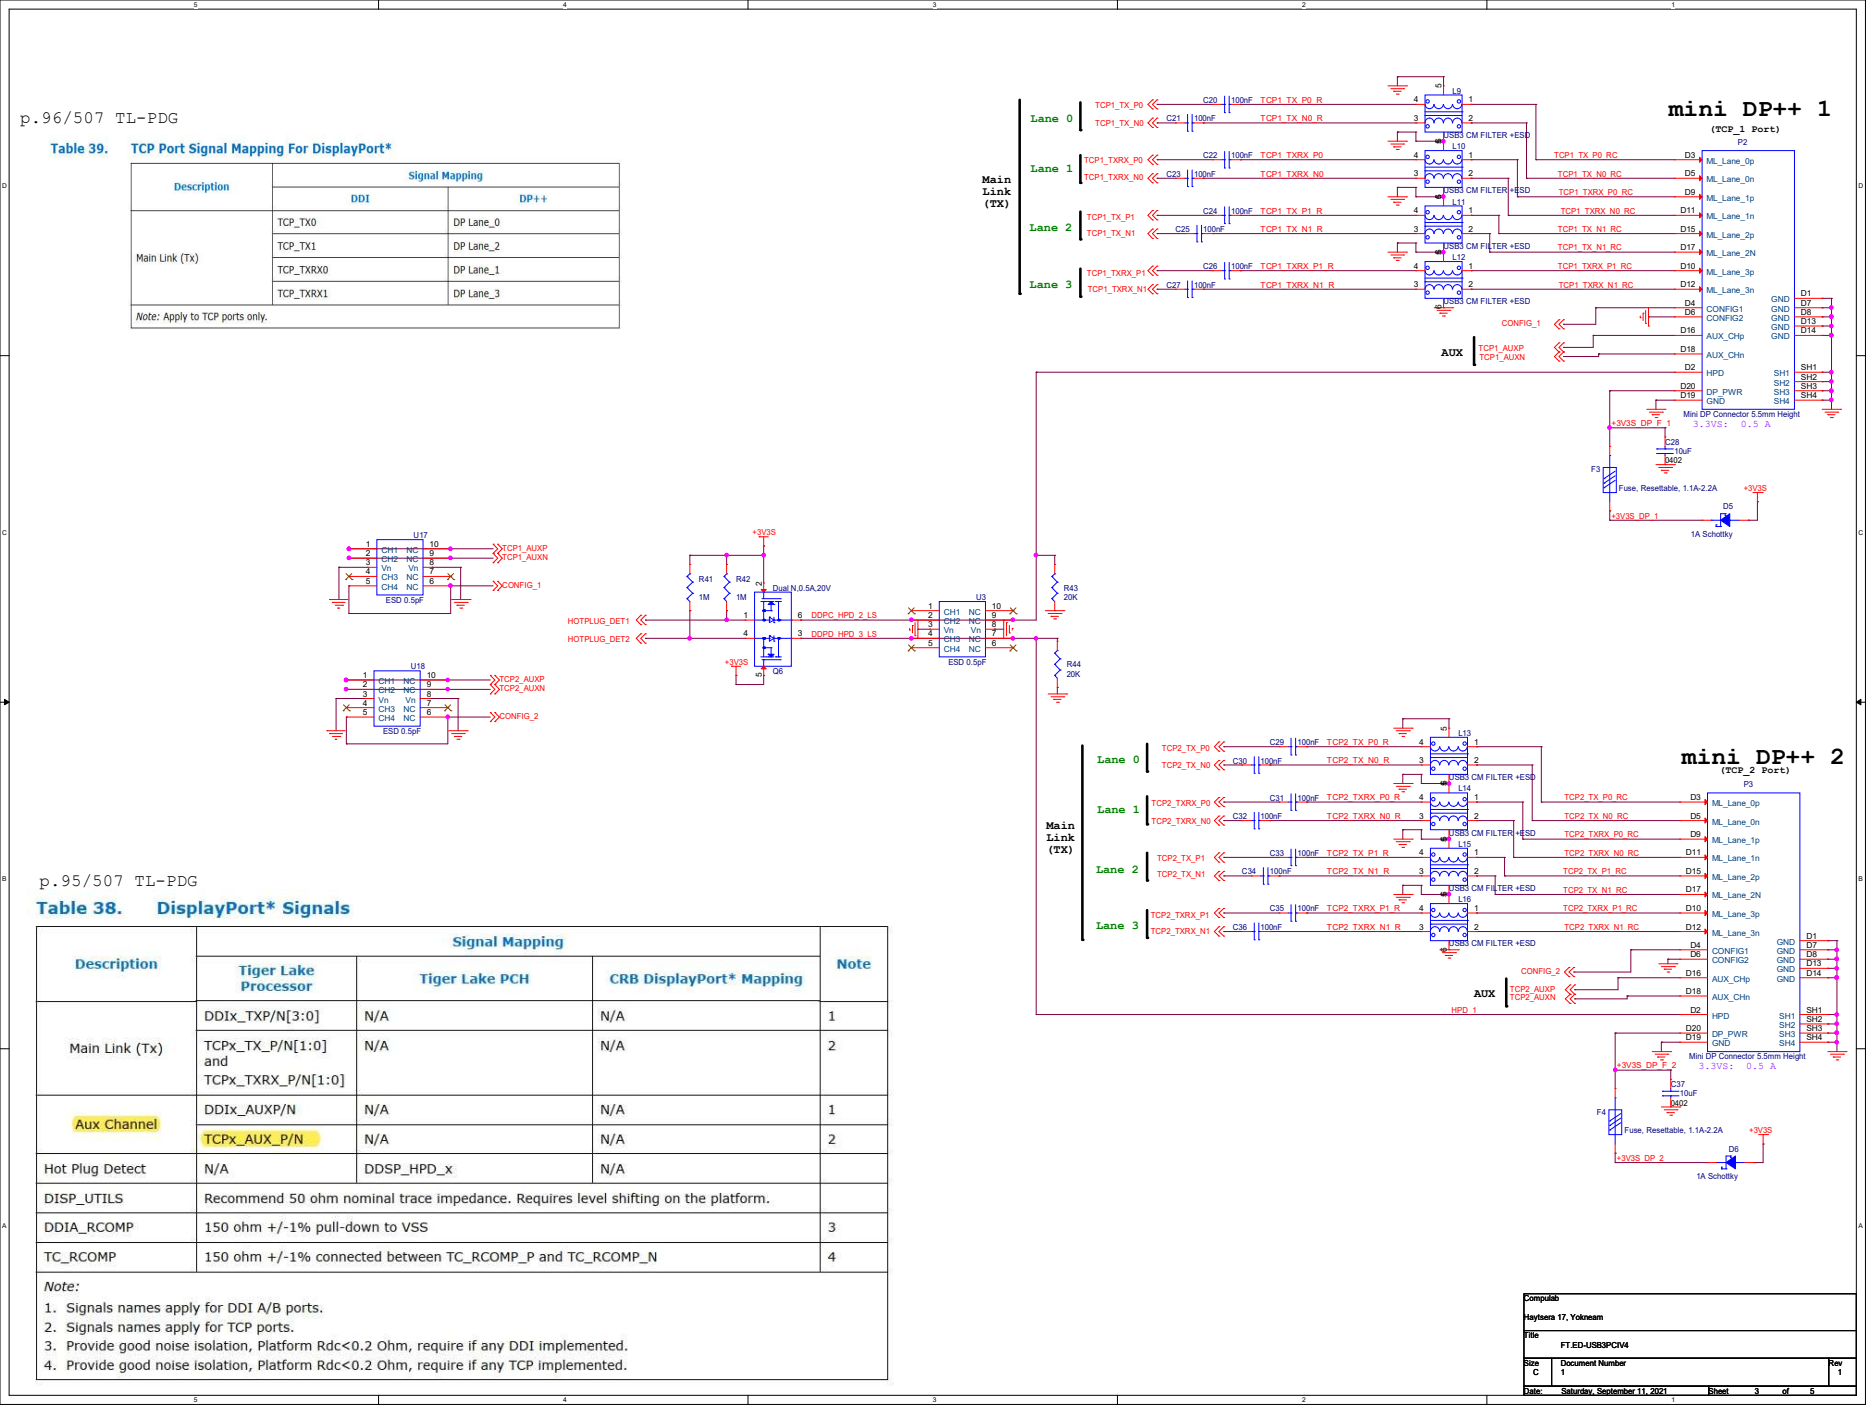
[picture p48: page 3]

5 6 P2 Mini DP Connector 5.5mm Height ML_Lane_0p D3 ML_Lane_0n D5 ML_Lane_1p D9 ML_Lane_1n D11 ML_Lane_2p D15 ML_Lane_2N D17 ML_Lane_3p D10 ML_Lane_3n D12 CONFIG1 D4 AUX_CHp D16 AUX_CHn D18 HPD D2 GND D19 DP_PWR D20 SH3 SH3 SH4 SH4 GND D1 CONFIG2 D6 GND D7 GND D8 GND D13 GND D14 SH2 SH2 SH1 SH1 C24 100nF

5 6 P3 Mini DP Connector 5.5mm Height ML_Lane_0p D3 ML_Lane_0n D5 ML_Lane_1p D9 ML_Lane_1n D11 ML_Lane_2p D15 ML_Lane_2N D17 ML_Lane_3p D10 ML_Lane_3n D12 CONFIG1 D4 AUX_CHp D16 AUX_CHn D18 HPD D2 GND D19 DP_PWR D20 SH3 SH3 SH4 SH4 GND D1 CONFIG2 D6 GND D7 GND D8 GND D13 GND D14 SH2 SH2 SH1 SH1
L12 USB3 CM FILTER +ESD

# USB 3.1 Gen 2 (10 Gbps)

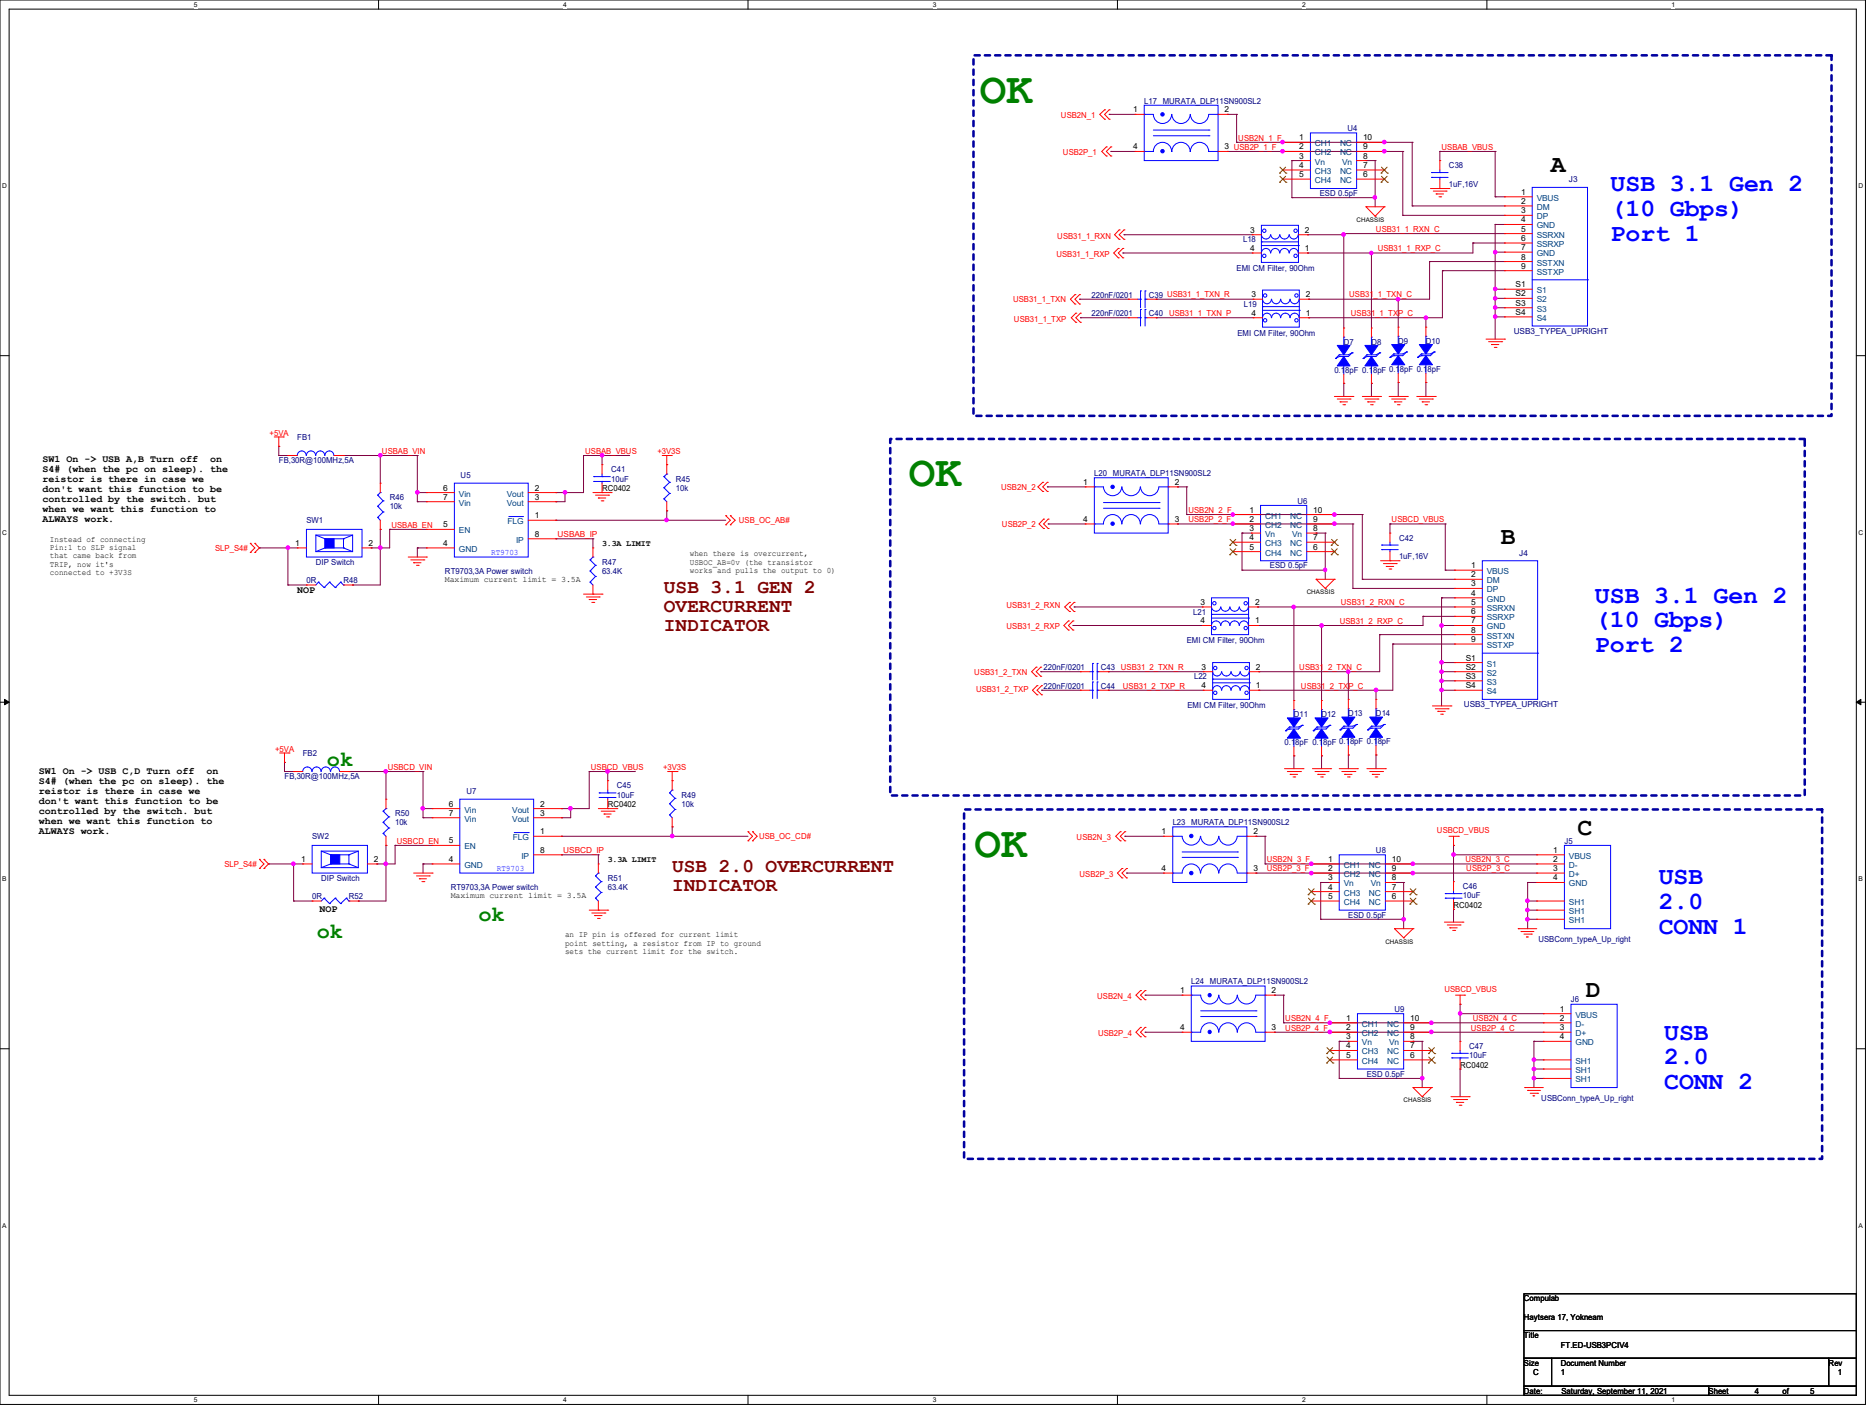
[picture p49: page 4]

USB3_TYPEA_UPRIGHT VBUS 1 DM 2 DP 3 GND 4 SSRXN 5 SSRXP 6 GND 7 SSTXN 8 SSTXP 9 S1 S1 S2 S2 S3 S3 S4 S4

SW1 On -> USB A,B Turn off on
S4# (when the pc on sleep). the
reistor is there in case we
don't want this function to be
controlled by the switch. but
when we want this function to
ALWAYS work.

Instead of connecting
Pin:1 to SLP signal
that came back from
TRIP, now it's
connected to +3V3S

when there is overcurrent,
USBOC_AB=0v (the transistor
works and pulls the output to 0)

SW1 On -> USB C,D Turn off on

3.3A LIMIT an IP pin is offered for current limit

point setting, a resistor from IP to ground
sets the current limit for the switch.

# RJ45 Dual Port

# LAN1 - I219 LAN 1

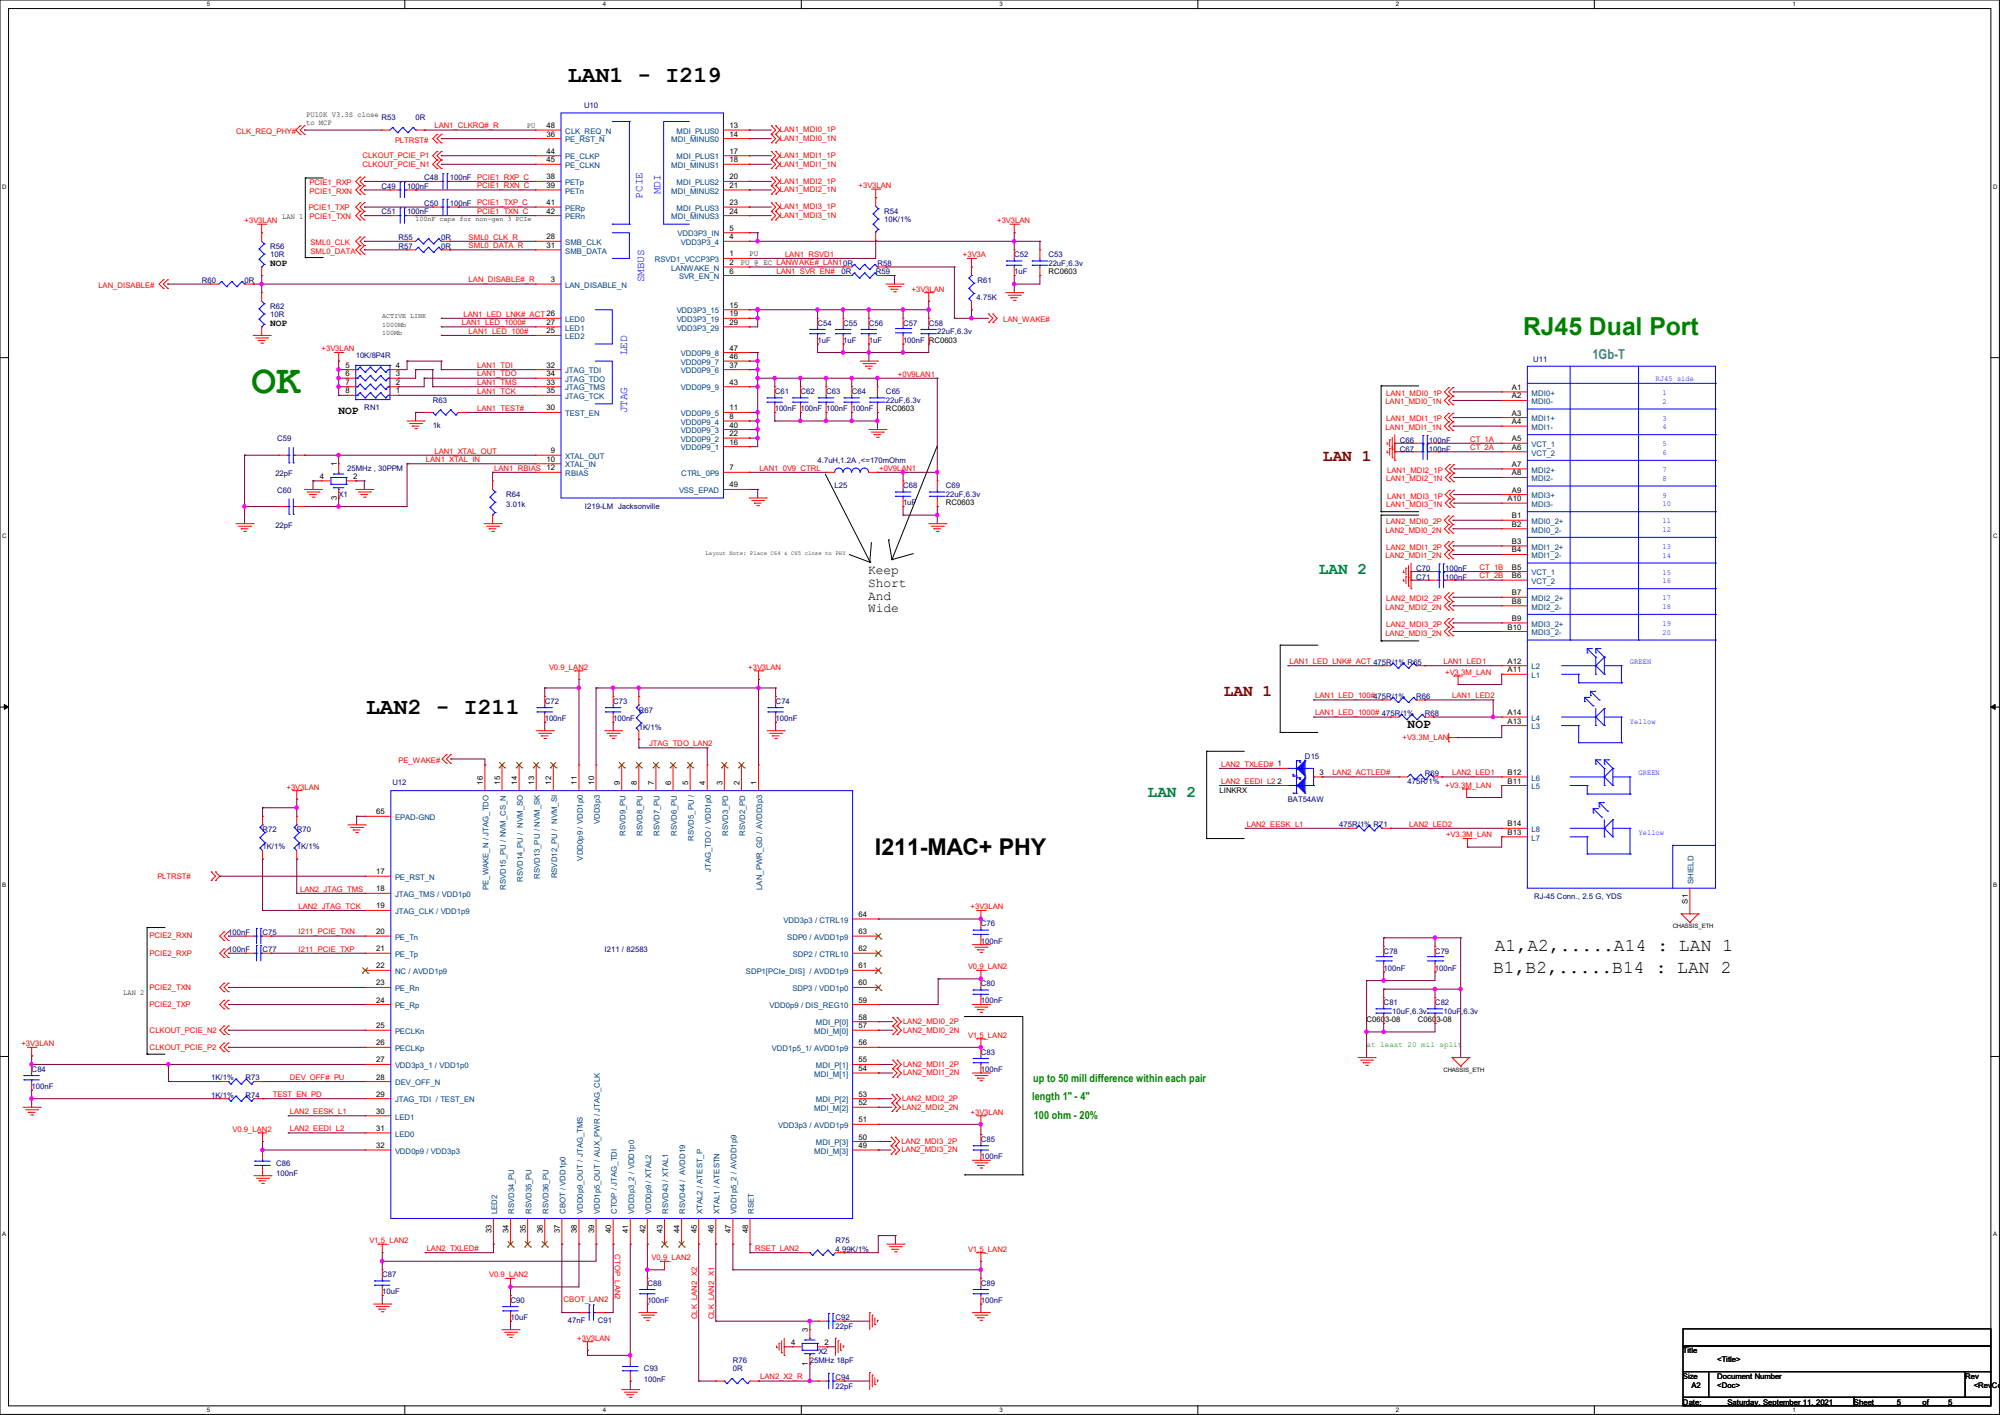
[picture p50: page 5]

LAN1_CLKRQ#_R
100nF caps for non-gen 3 PCIePU
LAN_WAKE# PLTRST#

Wide Layout Note: Place C64 & C65 close to PHY

at least 20 mil split

up to 50 mill difference within each pair
length 1" - 4"
100 ohm - 20%
