firasgany77/Board-Design-Git/Docs/SBC-CLH-1_3.pdf

5

4

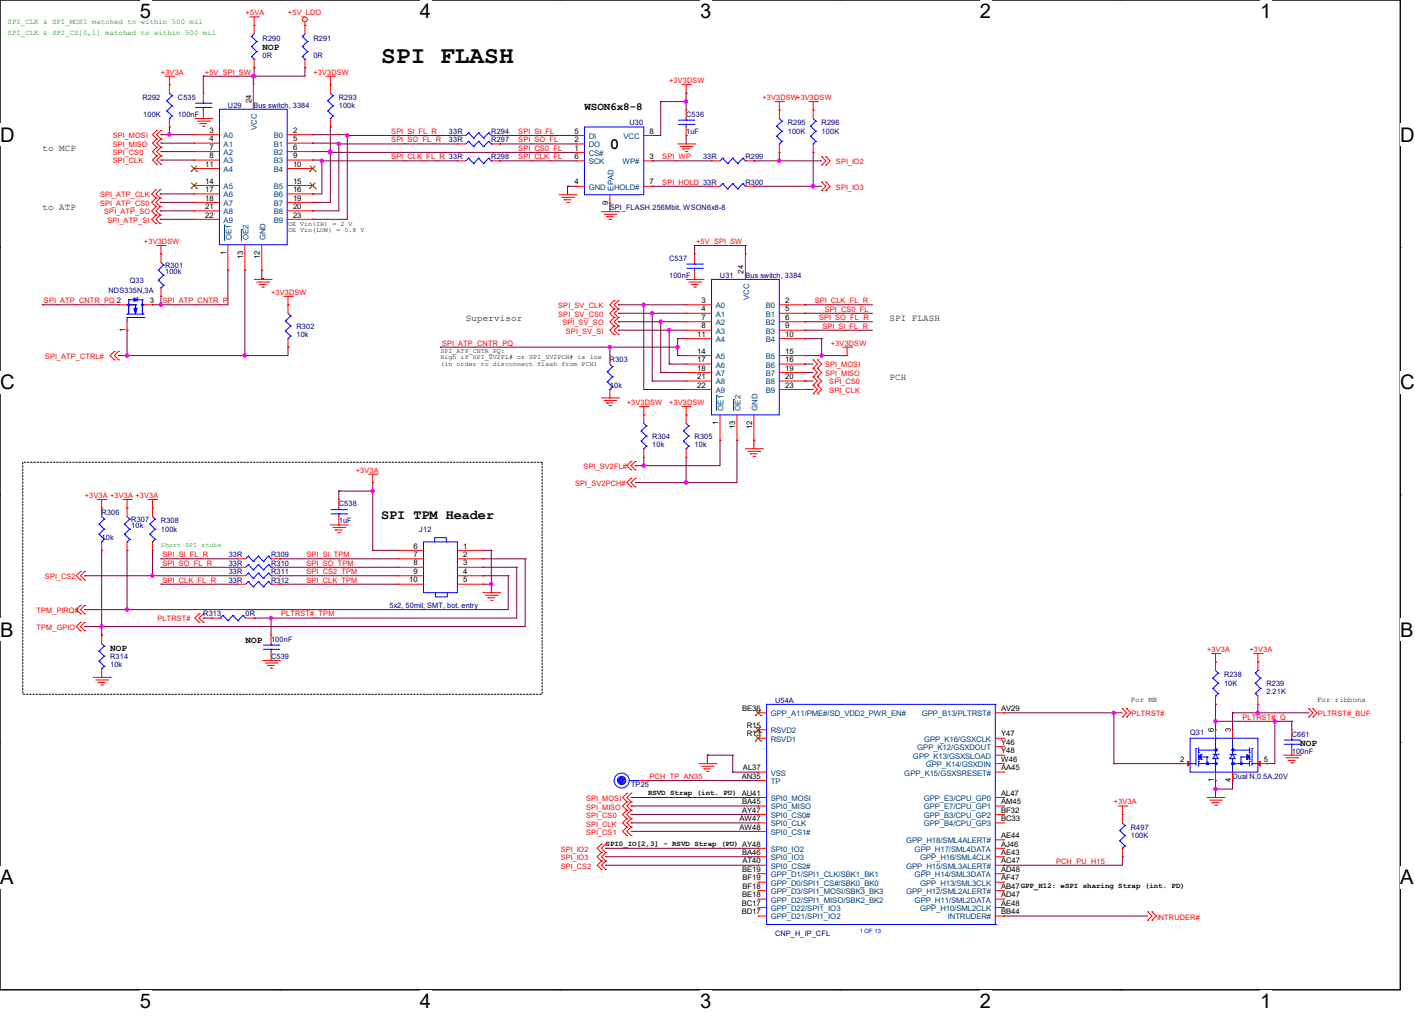
[picture p55: page 1]

SPI_CLK & SPI_MOSI matched to within 500 mil
SPI_CLK & SPI_CS[0,1] matched to within 500 mil

SPI_ATP_CNTR_PQ
SPI_ATP_CNTR_PQ:
High if SPI_SV2FL# or SPI_SV2PCH# is low
(in order to disconnect flash from PCH)

RSVD Strap (int. PU)

GPP_H12: eSPI sharing Strap (int. PD)

C C

# SBC-CLH

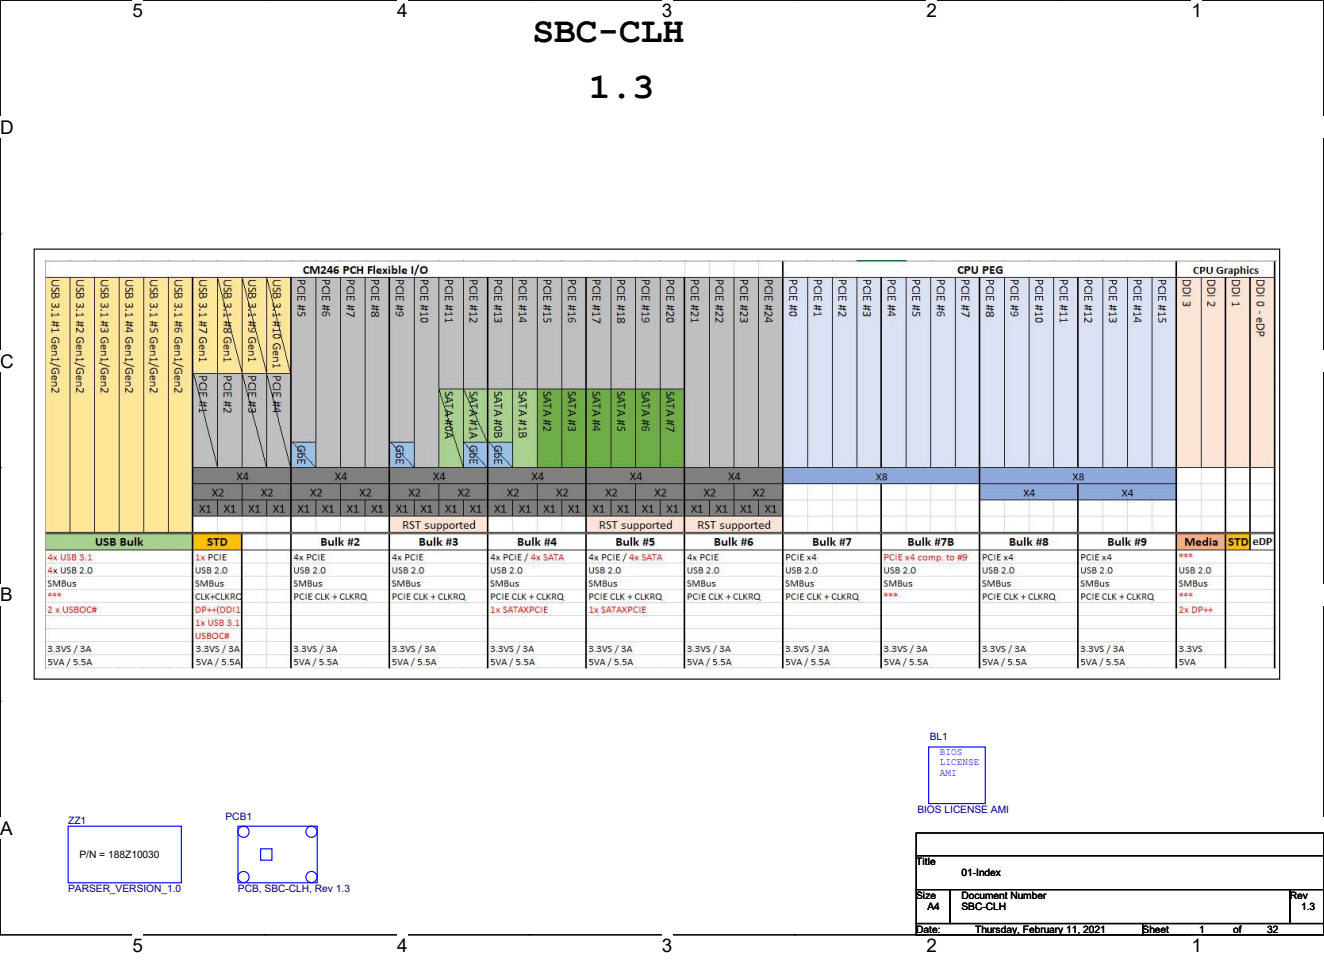
[picture p56: page 2]
Title; Size; Document Number; Rev; Date:; Sheet; SBC-CLH; 01-Index; Thursday, February 11, 2021; PCB1; PCB, SBC-CLH, Rev 1.3; BIOS; LICENSE; AMI BL1; PARSER_VERSION_1.0

BIOS LICENSE AMI

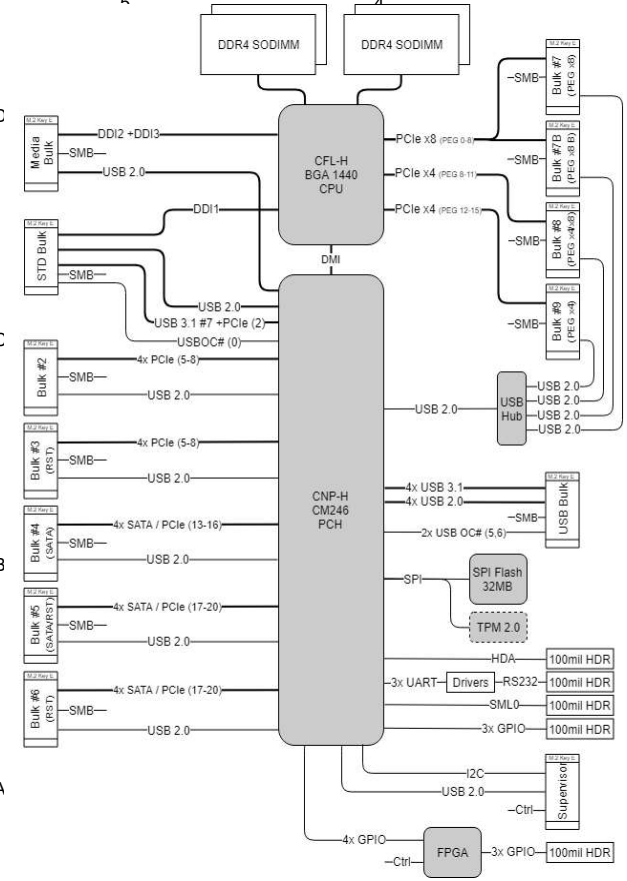
[picture p57: figure]

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
## Title

Size | Document Number | Rev
Date: | Sheet | of
| SBC-CLH | 1.3

## 02-Block Diagram

A4

Monday, January 04, 2021 | 2 | 32

## Title

Size | Document Number | Rev
Date: | Sheet | of
| SBC-CLH | 1.3

## 02-Block Diagram

A4

Monday, January 04, 2021 | 2 | 32

## Title

Size | Document Number | Rev
Date: | Sheet | of
| SBC-CLH | 1.3

## 02-Block Diagram

A4

Monday, January 04, 2021 | 2 | 32

C C

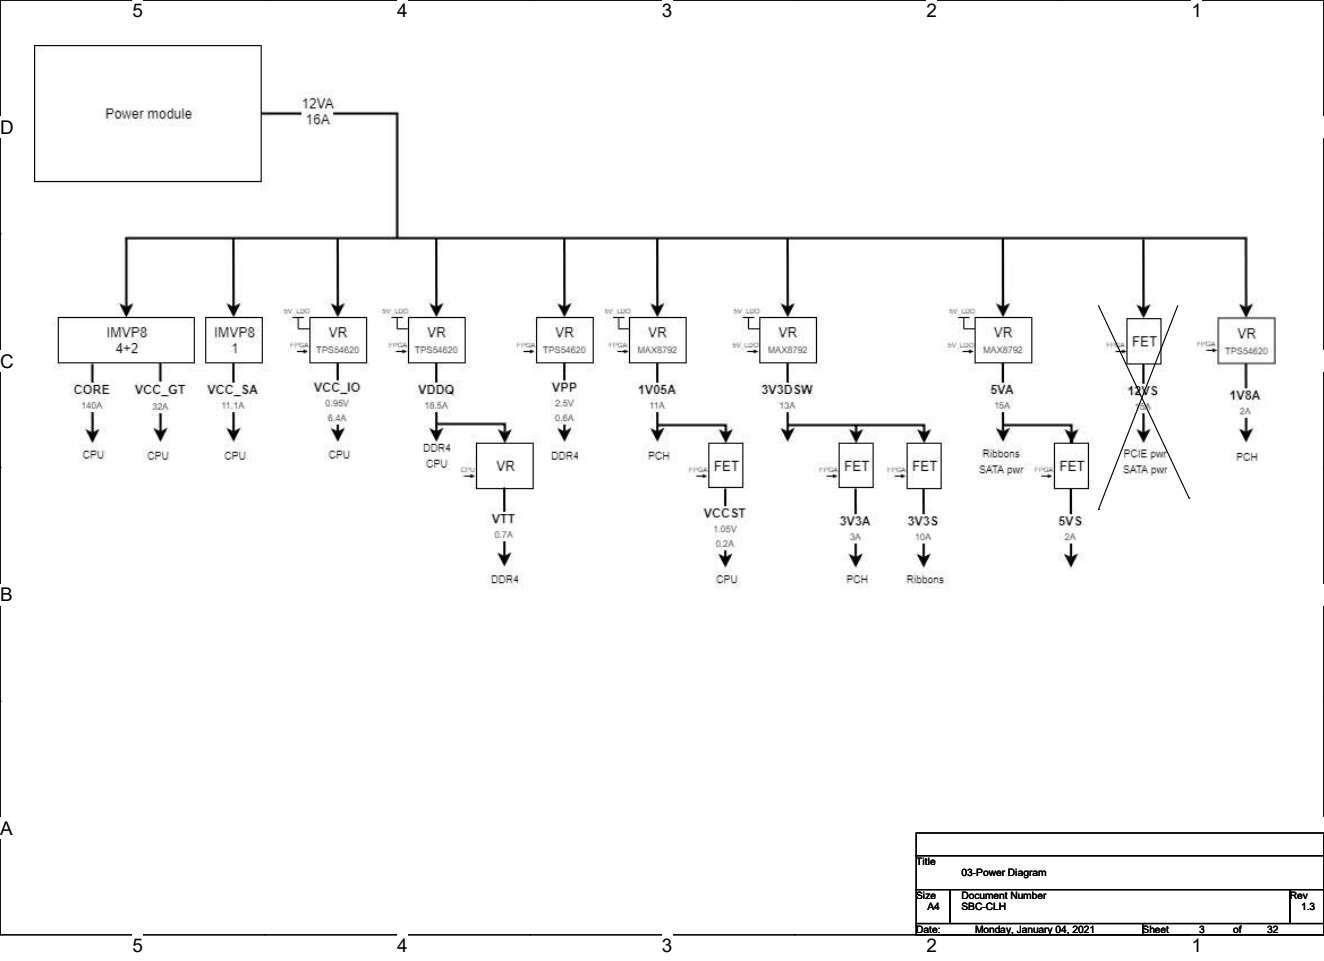
[picture p58: page 4]
Title; Size; Document Number; Rev; Date:; Sheet; SBC-CLH; 03-Power Diagram; Monday, January 04, 2021

C C

# Bulk #7

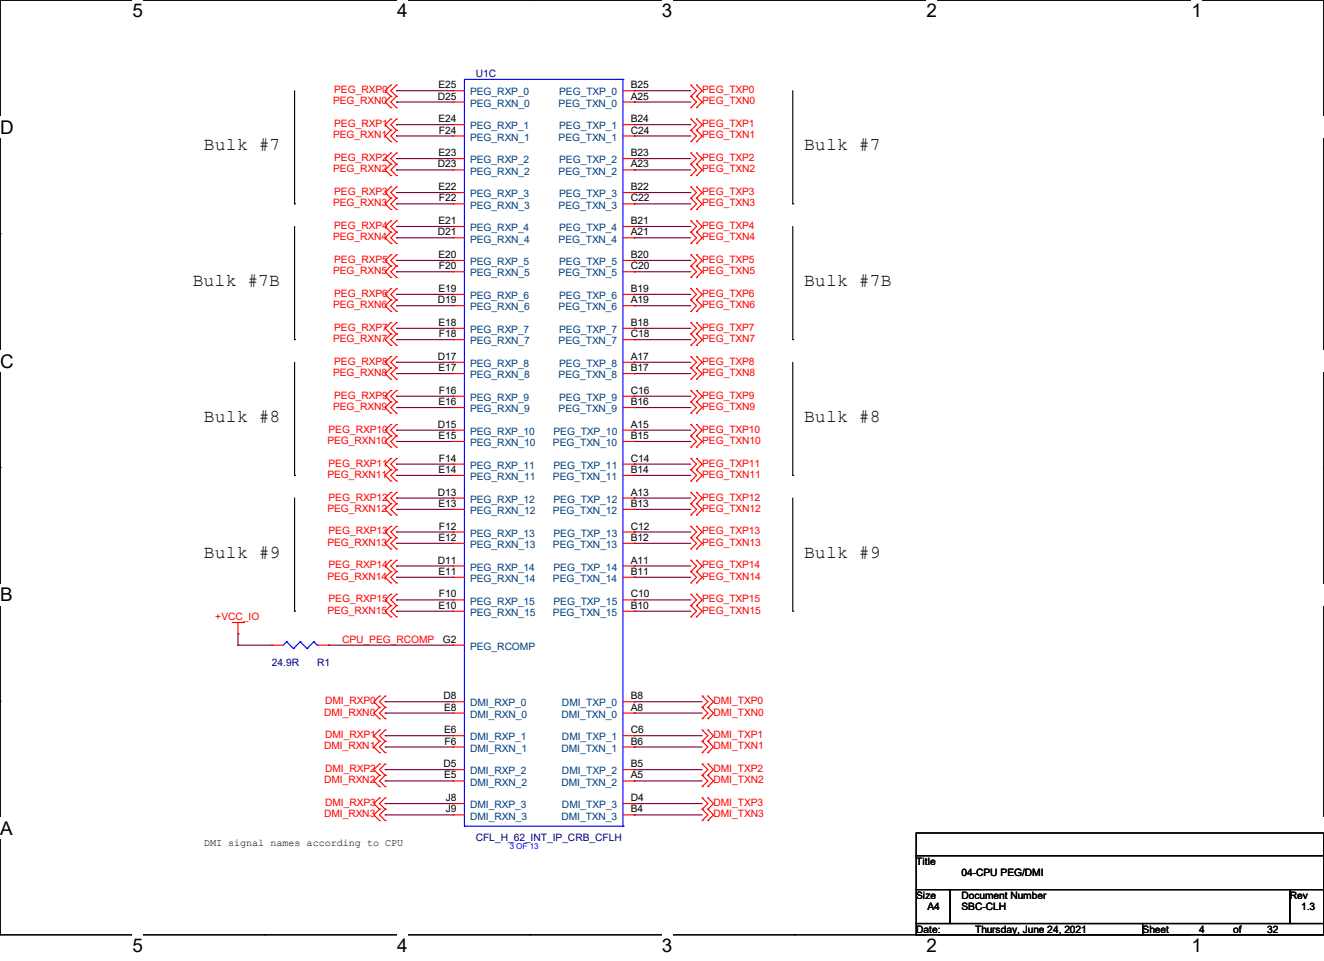
[picture p59: page 5]

DMI signal names according to CPU

C C

# STD Bulk

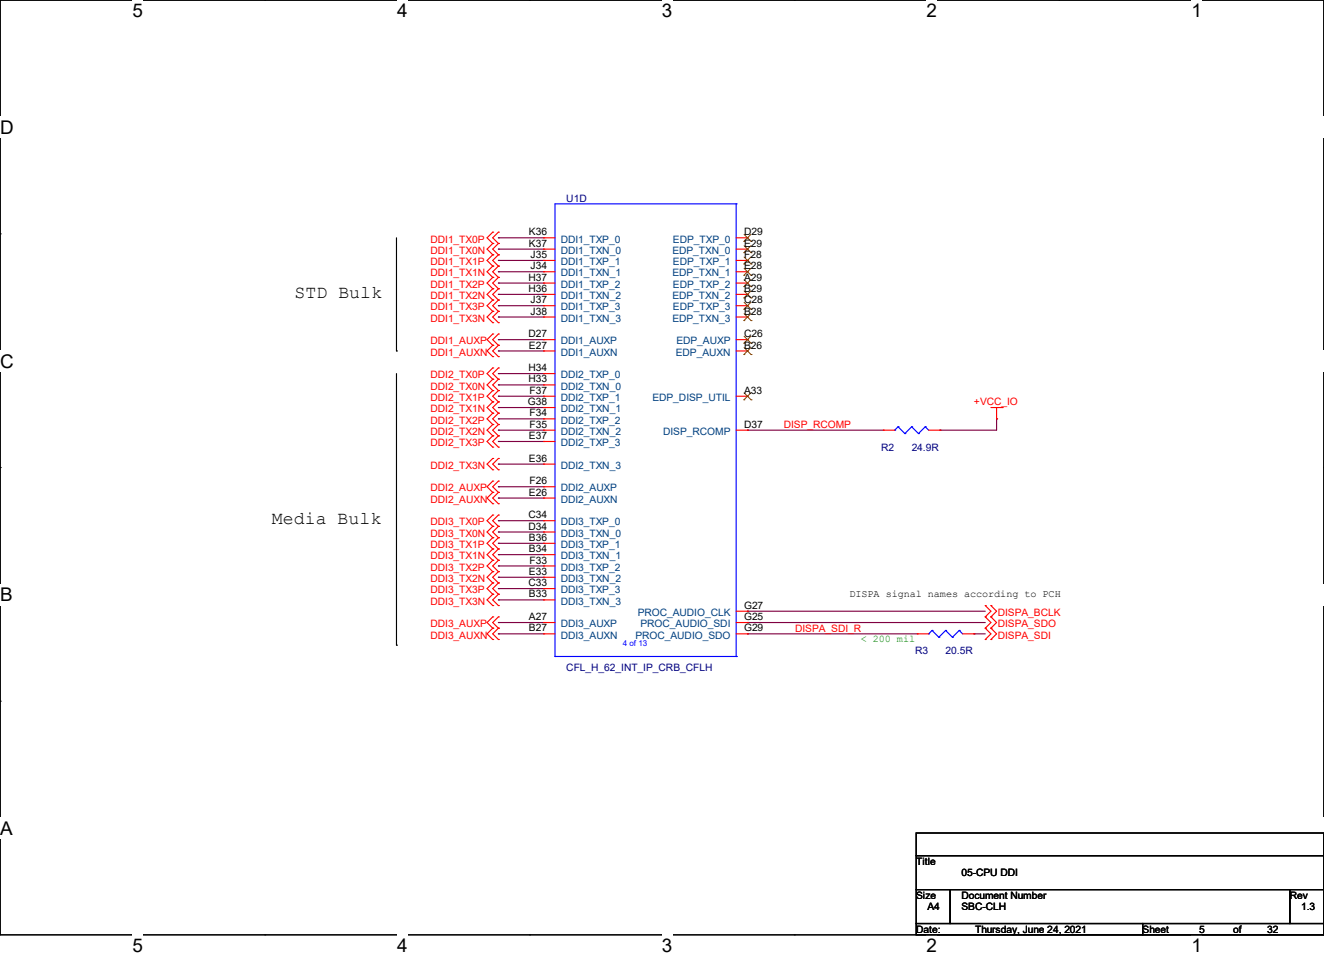
[picture p60: page 6]

DISPA signal names according to PCH

C C

## Data bits can be swapped within a byte

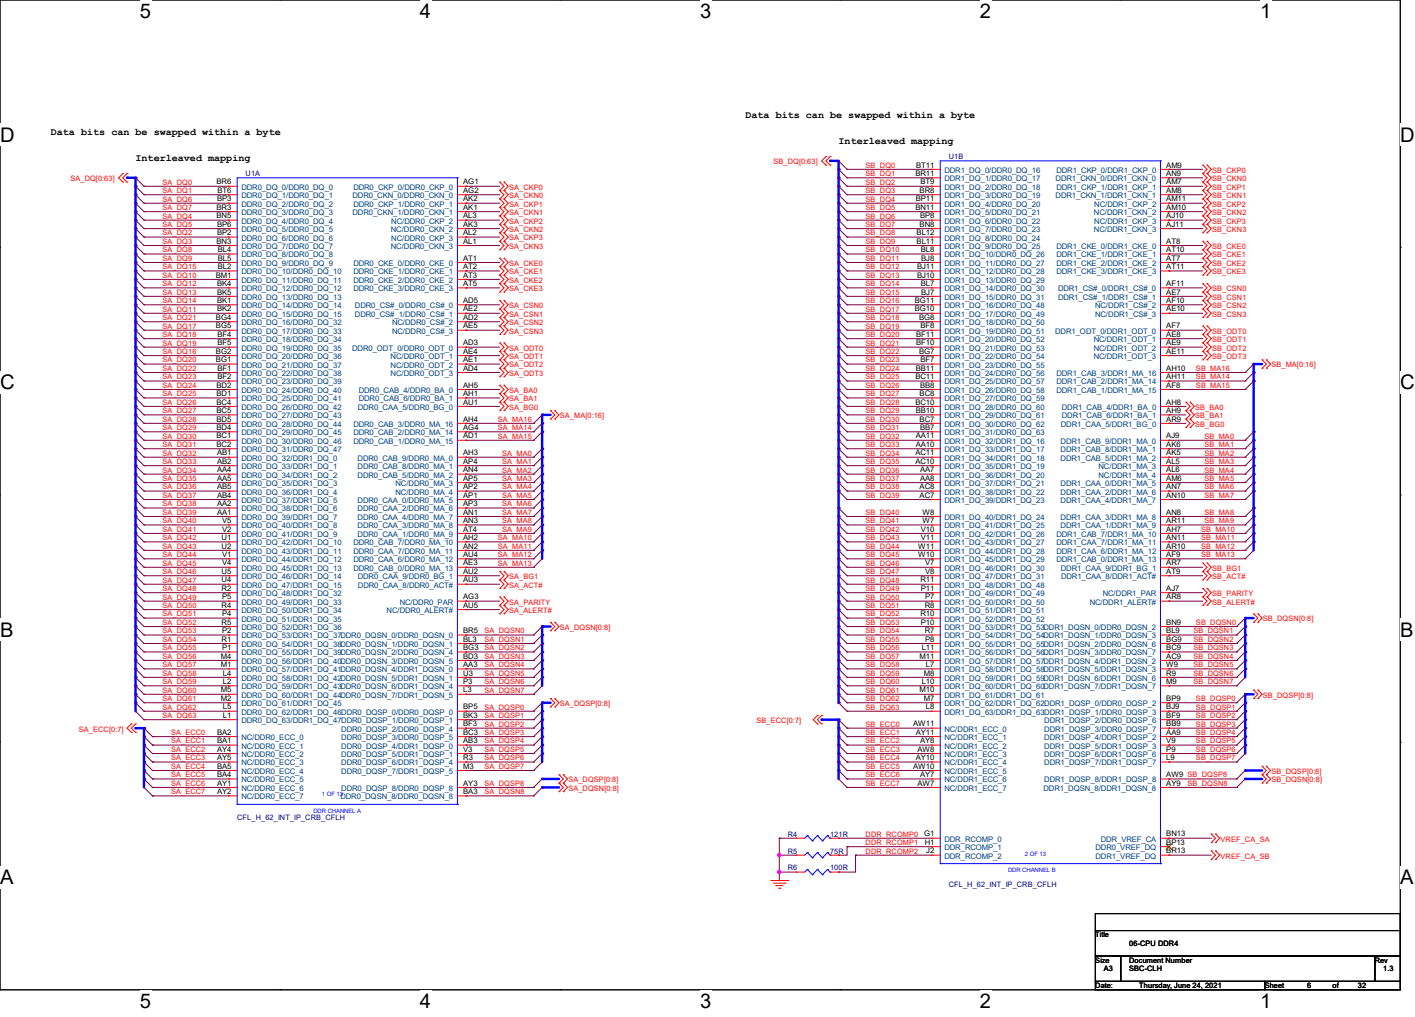
[picture p61: page 7]

Data bits can be swapped within a byte
DDR0_DQ_5/DDR0_DQ_5 BP6

C C

## internal 3K PU at CFG[0:18]

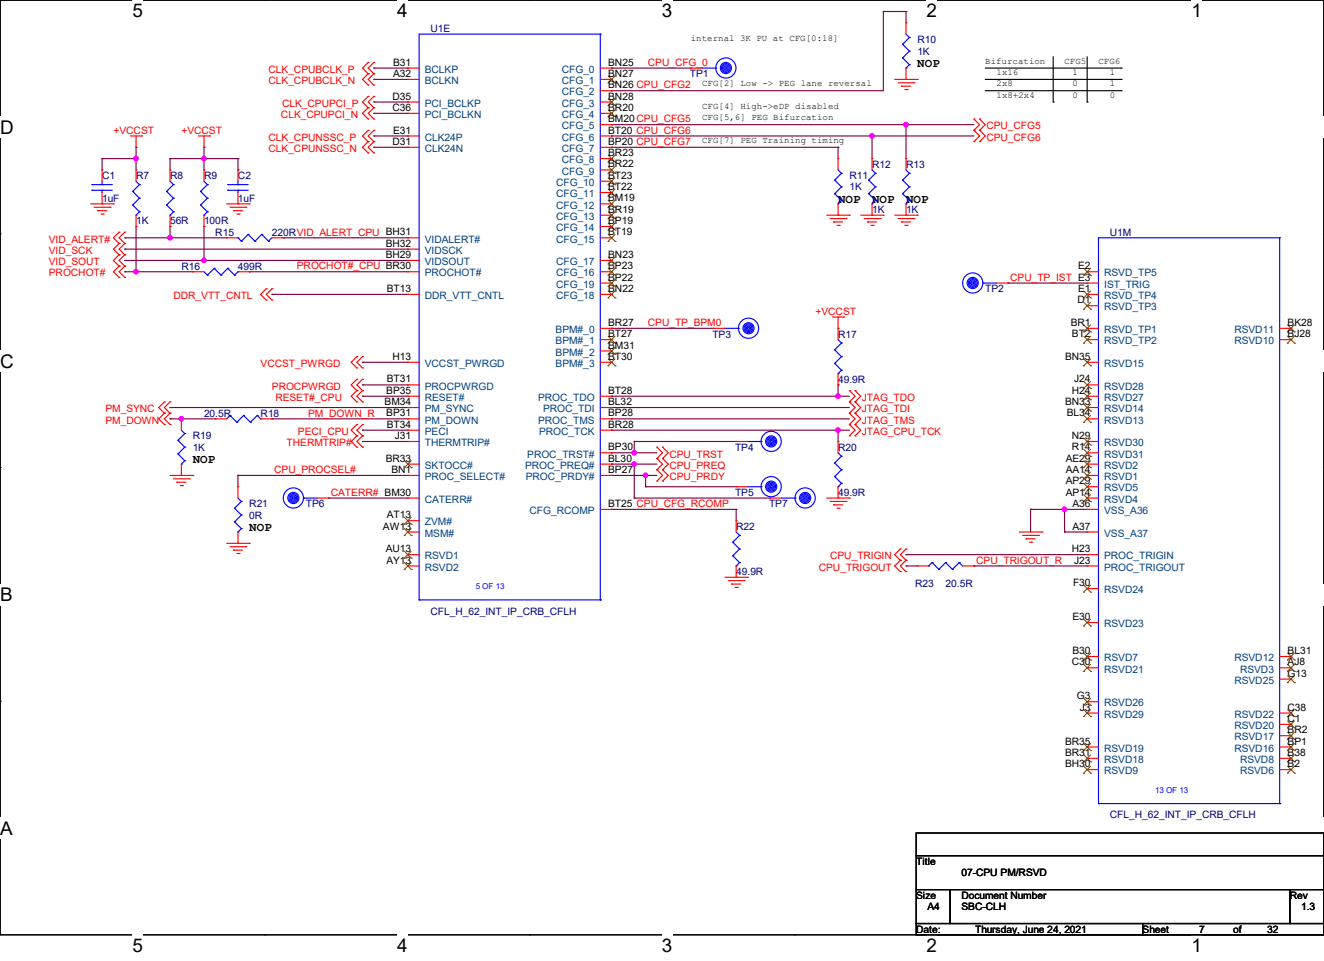
[picture p62: page 8]

CFG[2] Low -> PEG lane reversal

CFG[4] High->eDP disabled
CFG[5,6] PEG Bifurcation

CFG[7] PEG Training timing

C C

# 10uF RC0402 C47

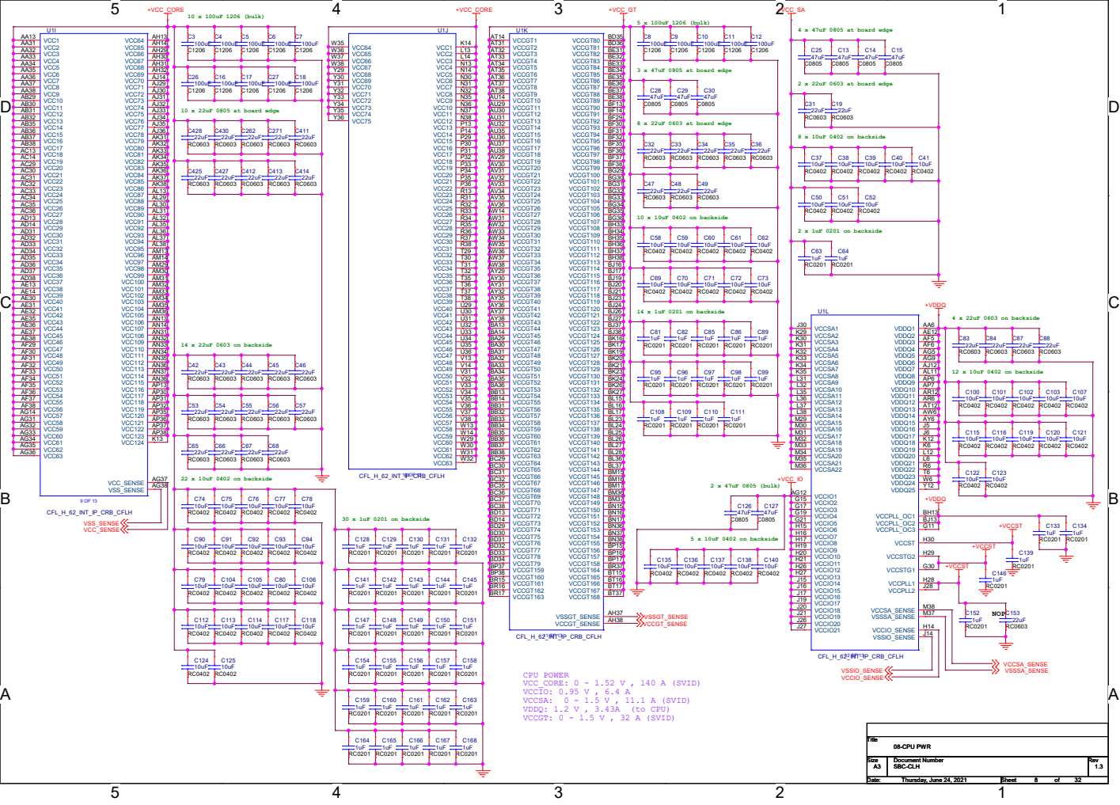
[picture p63: page 9]

55

44

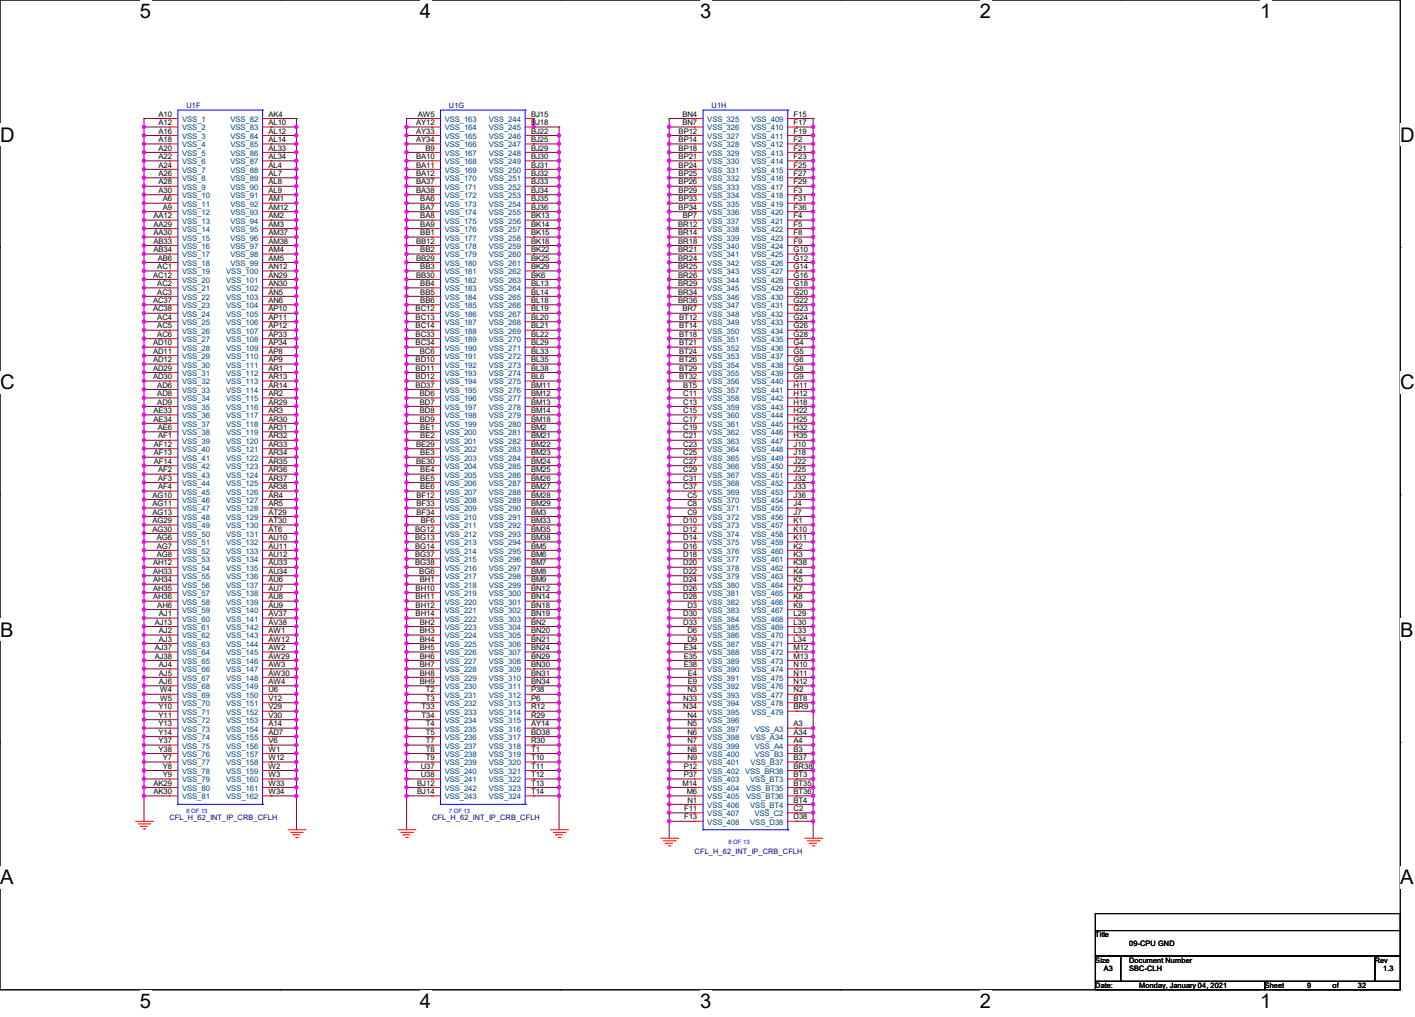
[picture p64: page 10]

C C

## USB Hub: TRIPs #7, #7B, #8, #9

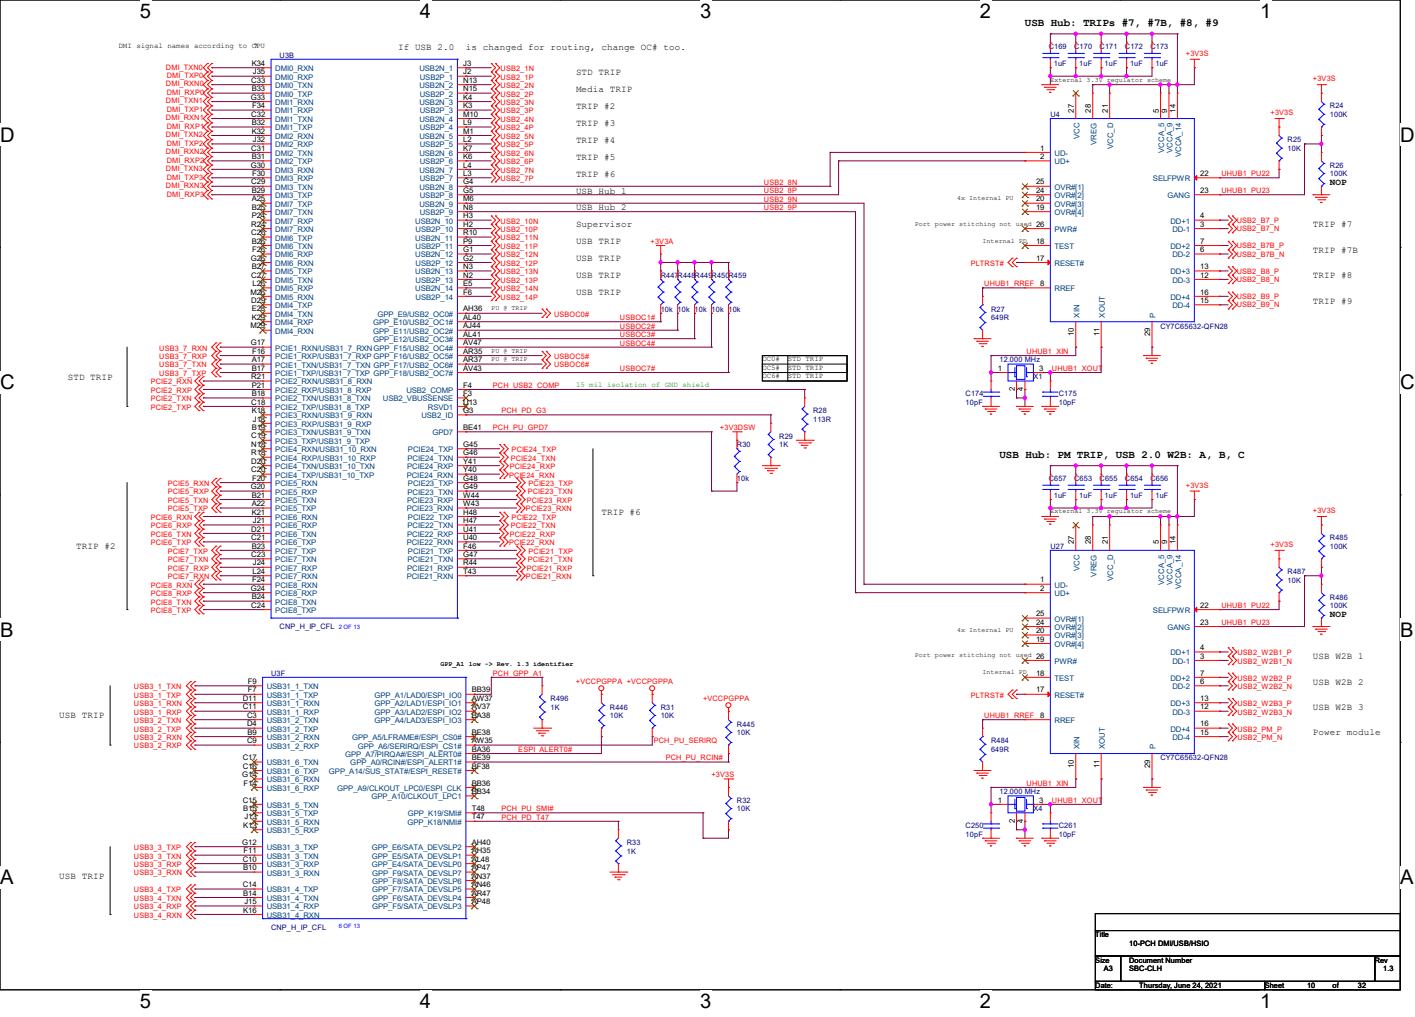
[picture p65: page 11]

9 XIN 10 XOUT 11 DD-3 12 DD+3 13 VCCA_14 14 VREG 28 VCC 27 PWR# 26 OVR#[1] 25 OVR#[2] 24 GANG 23 SELFPWR 22 P 29 R24

5 DD-2 6 DD+2 7 DD+4 16 VCC_D 21 OVR#[3] 20 OVR#[4] 19 TEST 18 UD- 1 DD-4 15 RESET# 17 RREF 8 VCCA_9

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

Port power stitching not used

15 mil isolation of GND shield

USB Hub: PM TRIP, USB 2.0 W2B: A, B, C

10-PCH DMI/USB/HSIO

C C

# Bulk #3

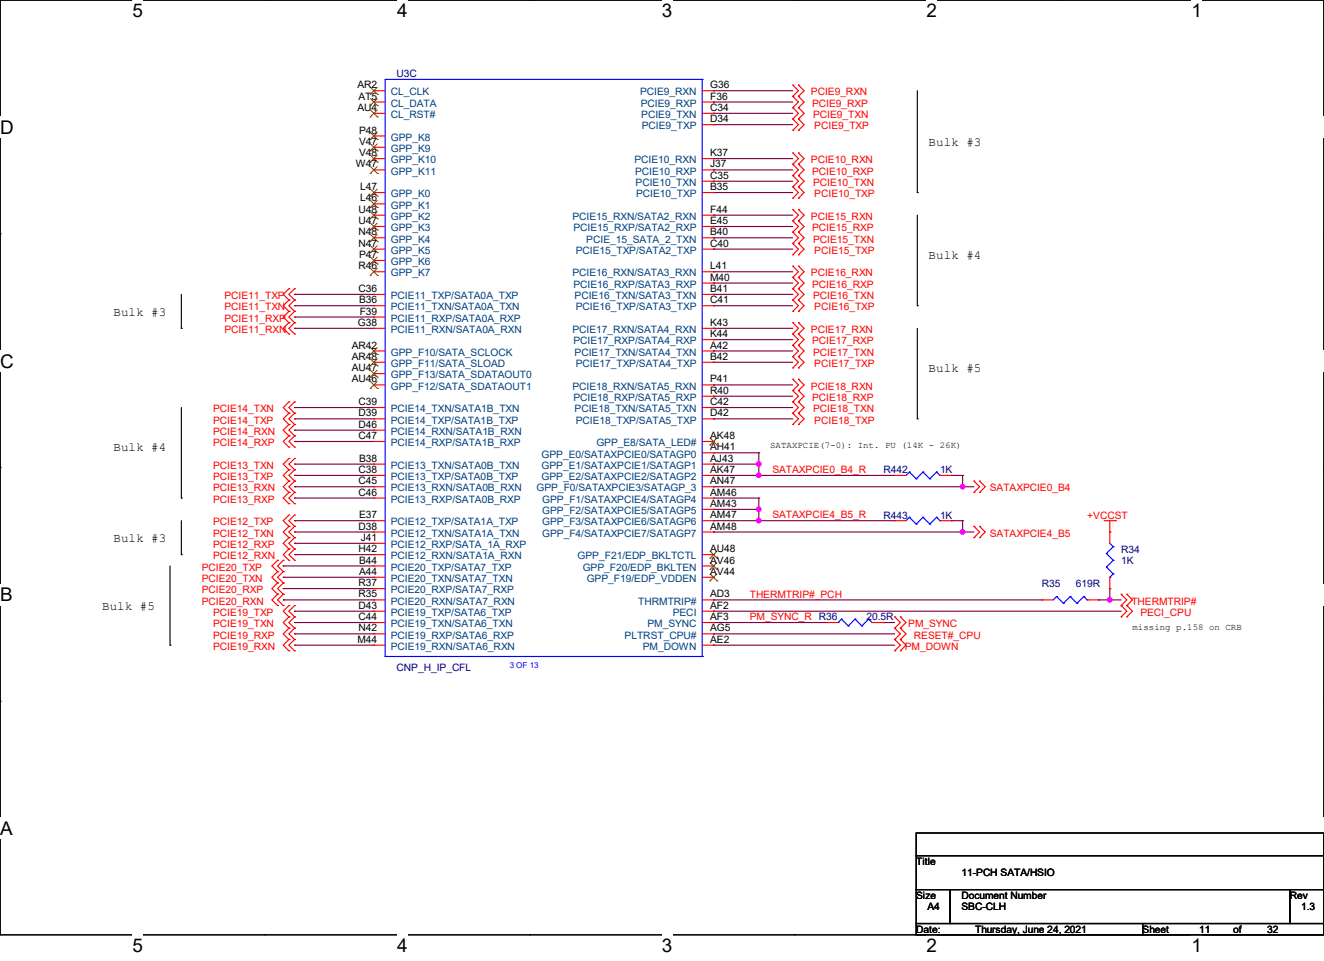
[picture p66: page 12]

C C

# C(L) = 12.5pF, C(S) = 1pF

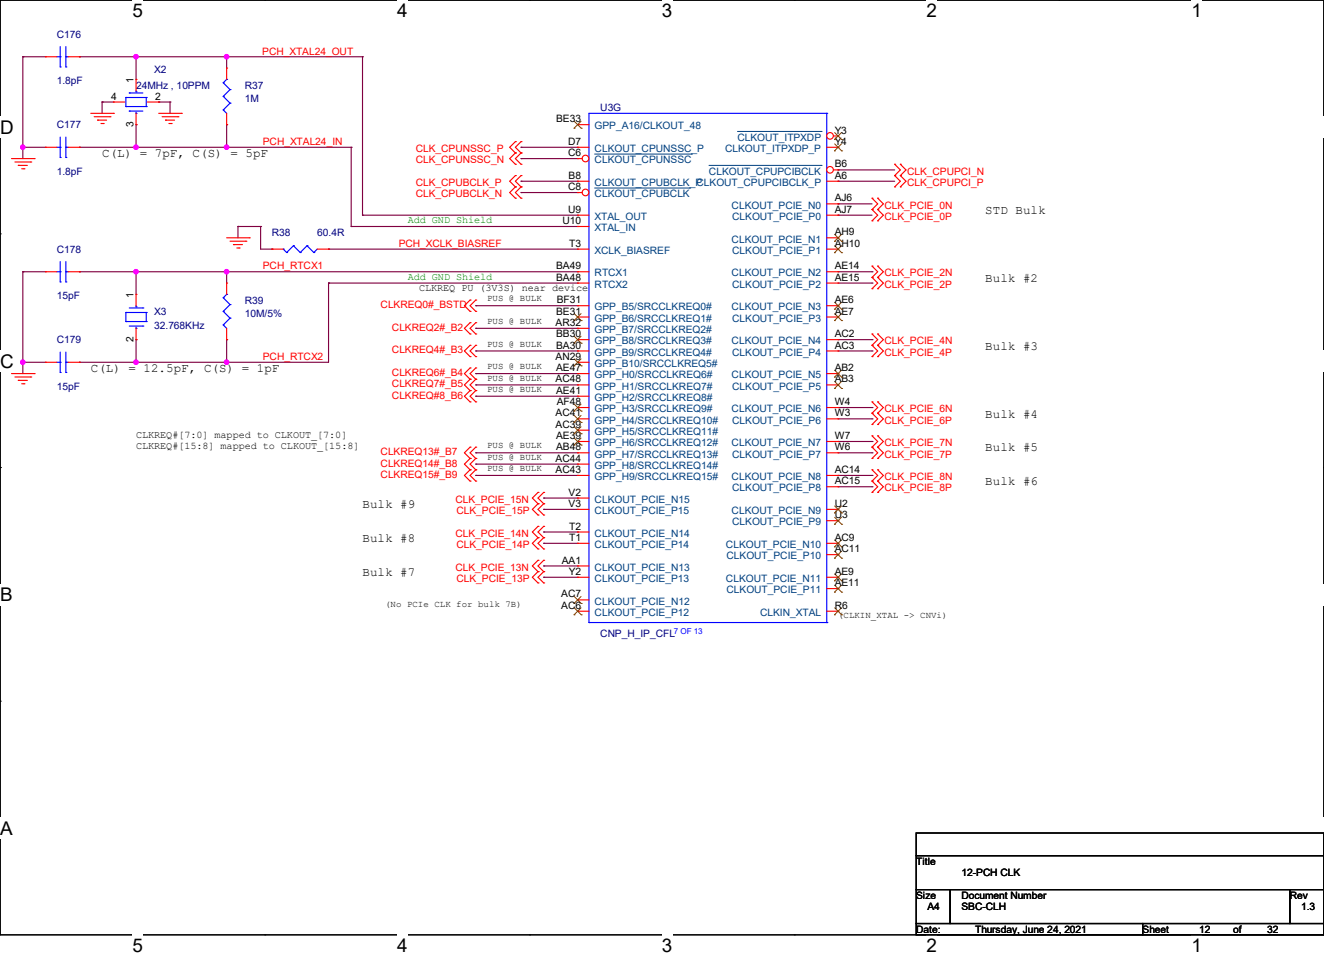
[picture p67: page 13]

CLKREQ PU (3V3S) near device

(No PCIe CLK for bulk 7B)

C C

## CTRL HDR

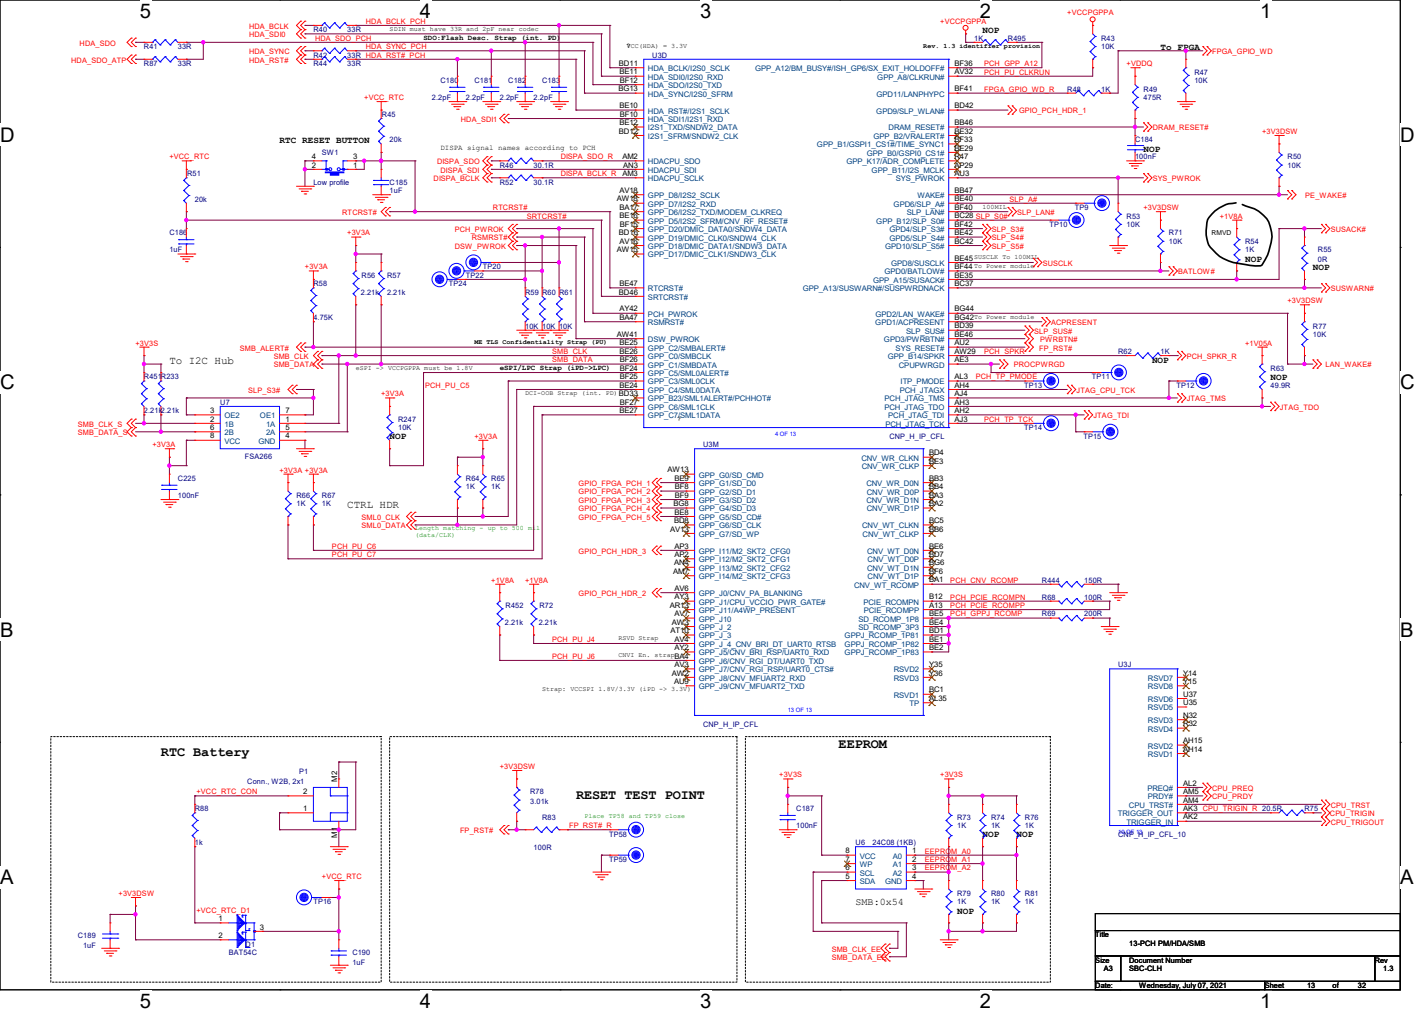
[picture p68: page 14]

SDIN must have 33R and 2pF near codec

SDO:Flash Desc. Strap (int. PD)

ME TLS Confidentiality Strap (PU)

SMB_CLK
SMB_DATA

eSPI -> VCCPGPPA must be 1.8V

eSPI/LPC Strap (iPD->LPC)

DCI-OOB Strap (int. PD)

Length matching - up to 500 mil
(data/CLK)

13-PCH PM/HDA/SMB

C C

# U3K CNP_H_IP_CFL

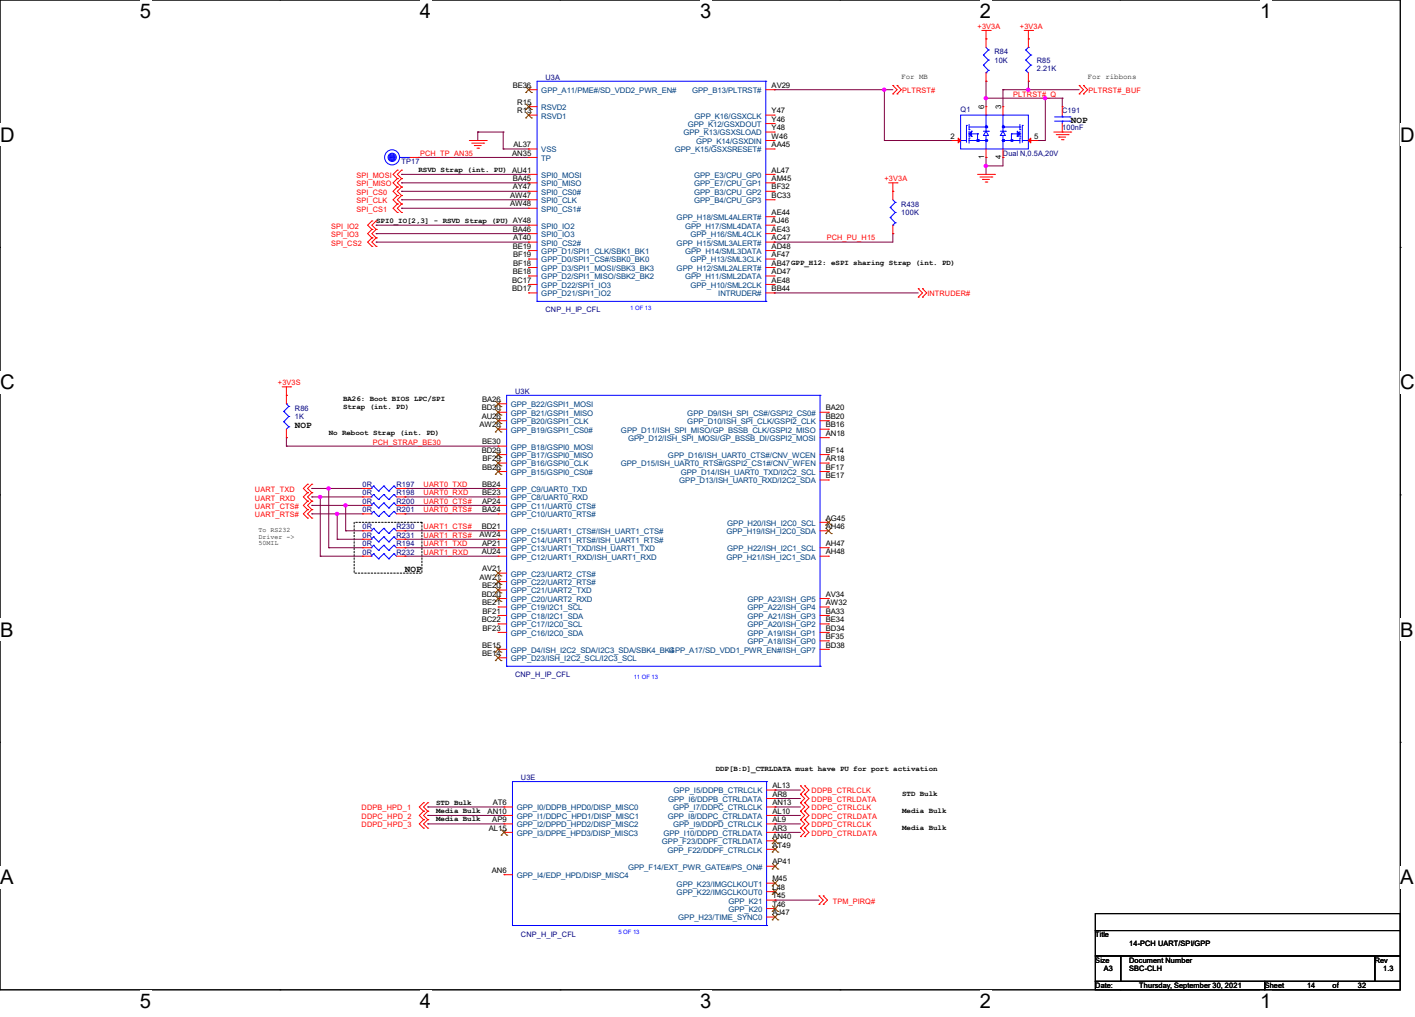
[picture p69: page 15]

RSVD Strap (int. PU)

BA26: Boot BIOS LPC/SPI
Strap (int. PD)

No Reboot Strap (int. PD)

DDP[B:D]_CTRLDATA must have PU for port activation

14-PCH UART/SPI/GPP

C C

CNP_H_IP_CFL VSS_246 | Y9 VSS_235 | V4 VSS_224 | T5 VSS_213 | R26 VSS_202 | N16 VSS_169 E26 | VSS_158 D17 | VSS_147 BG37

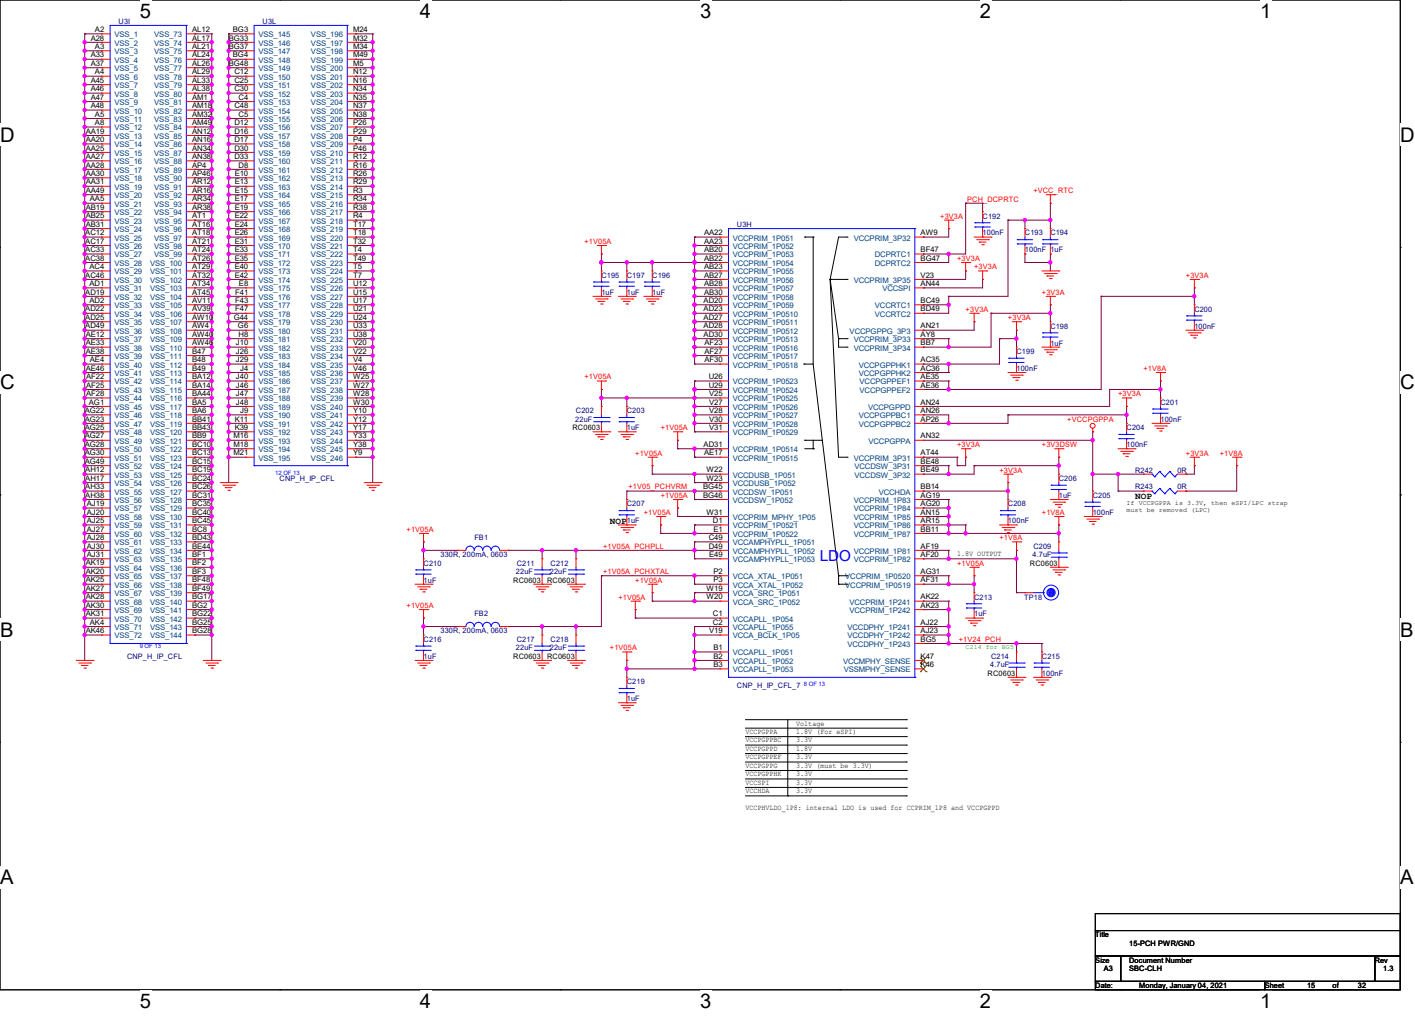
[picture p70: page 16]

NOP
If VCCPGPPA is 3.3V, then eSPI/LPC strap
must be removed (LPC)

VCCPHVLDO_1P8: internal LDO is used for CCPRIM_1P8 and VCCPGPPD

# CORE PH 0

# +VCC_CORE, +VCC_GT

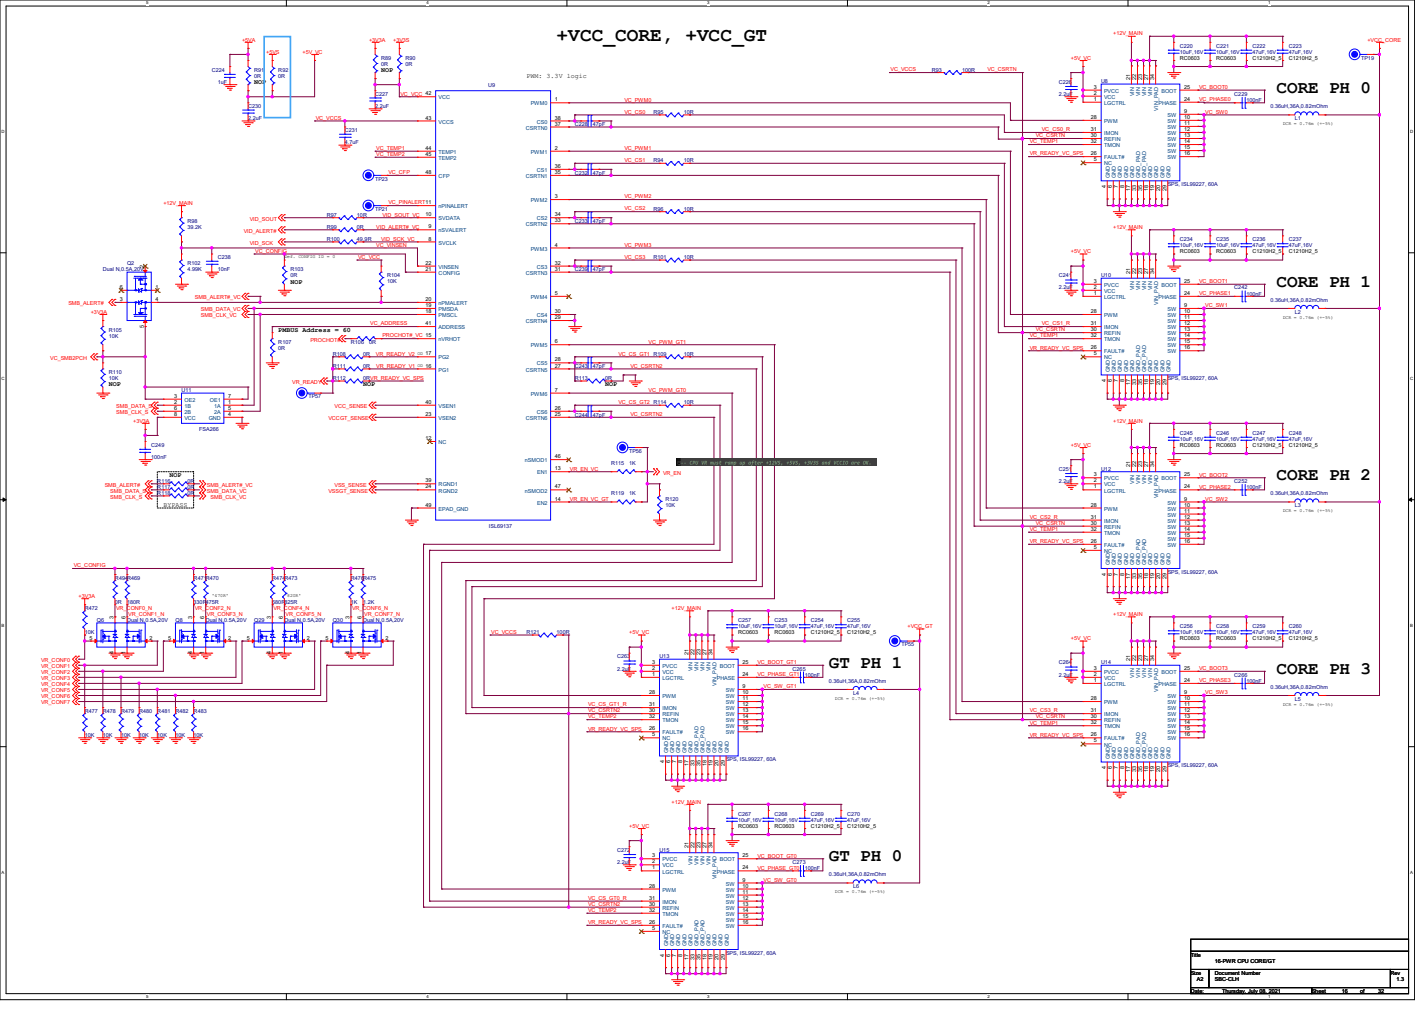
[picture p71: page 17]

8 GND 17 GND 18 GND 19 GND 20 GND 29 SW

C C

# +VCC_SA (IMVP8) , 11.1A

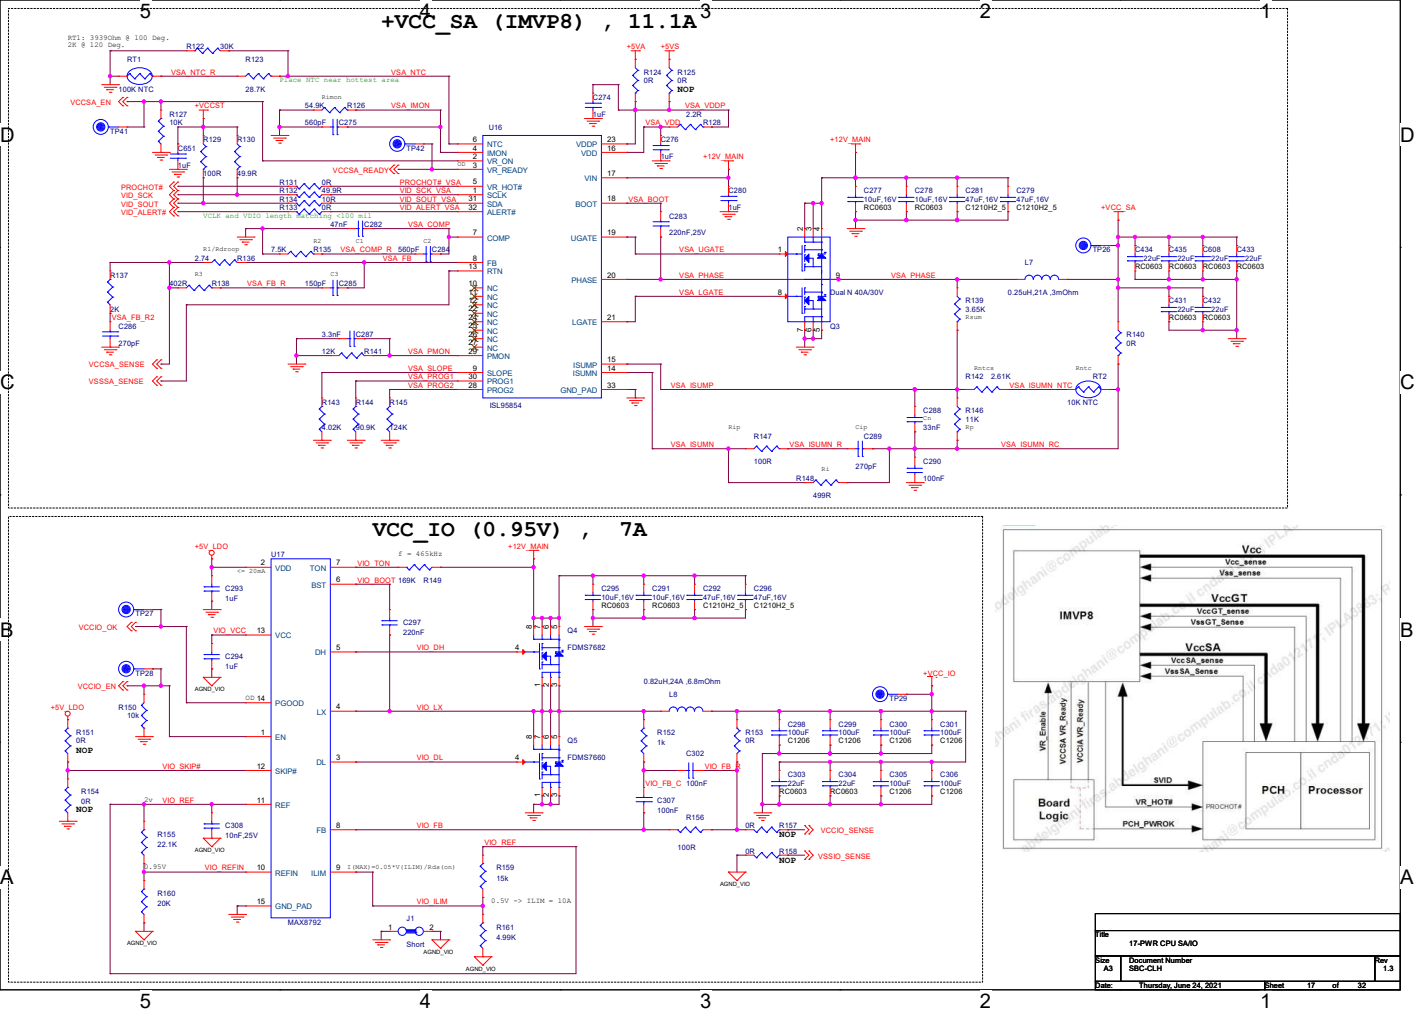
[picture p72: page 18]

IMON 4 VR_HOT# 5 NTC 6 COMP 7 FB 8 SLOPE 9 NC 10 NC 11 NC 12 RTN 13
VDD 16 VIN 17 BOOT 18 UGATE 19 PHASE 20

Place NTC near hottest area

VCLK and VDIO length matching <100 mil

I(MAX)=0.05*V(ILIM)/Rds(on)

17-PWR CPU SA/IO

C C

# VDDQ = 1.2V , 15A

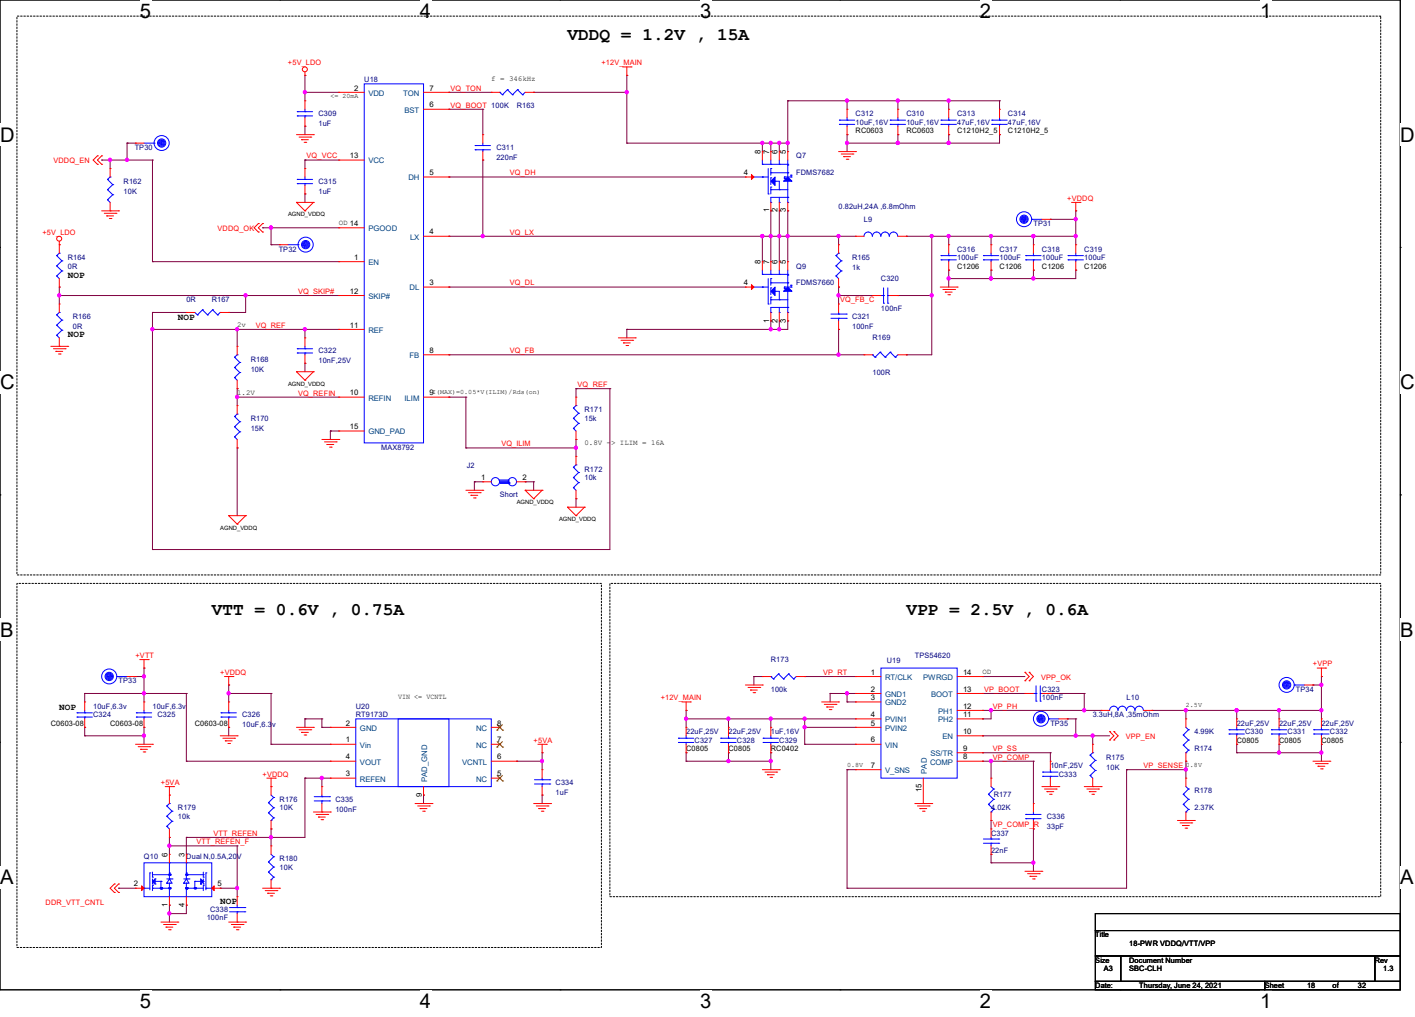
[picture p73: page 19]

I(MAX)=0.05*V(ILIM)/Rds(on)

18-PWR VDDQ/VTT/VPP

C C

## +3V3A , 3A

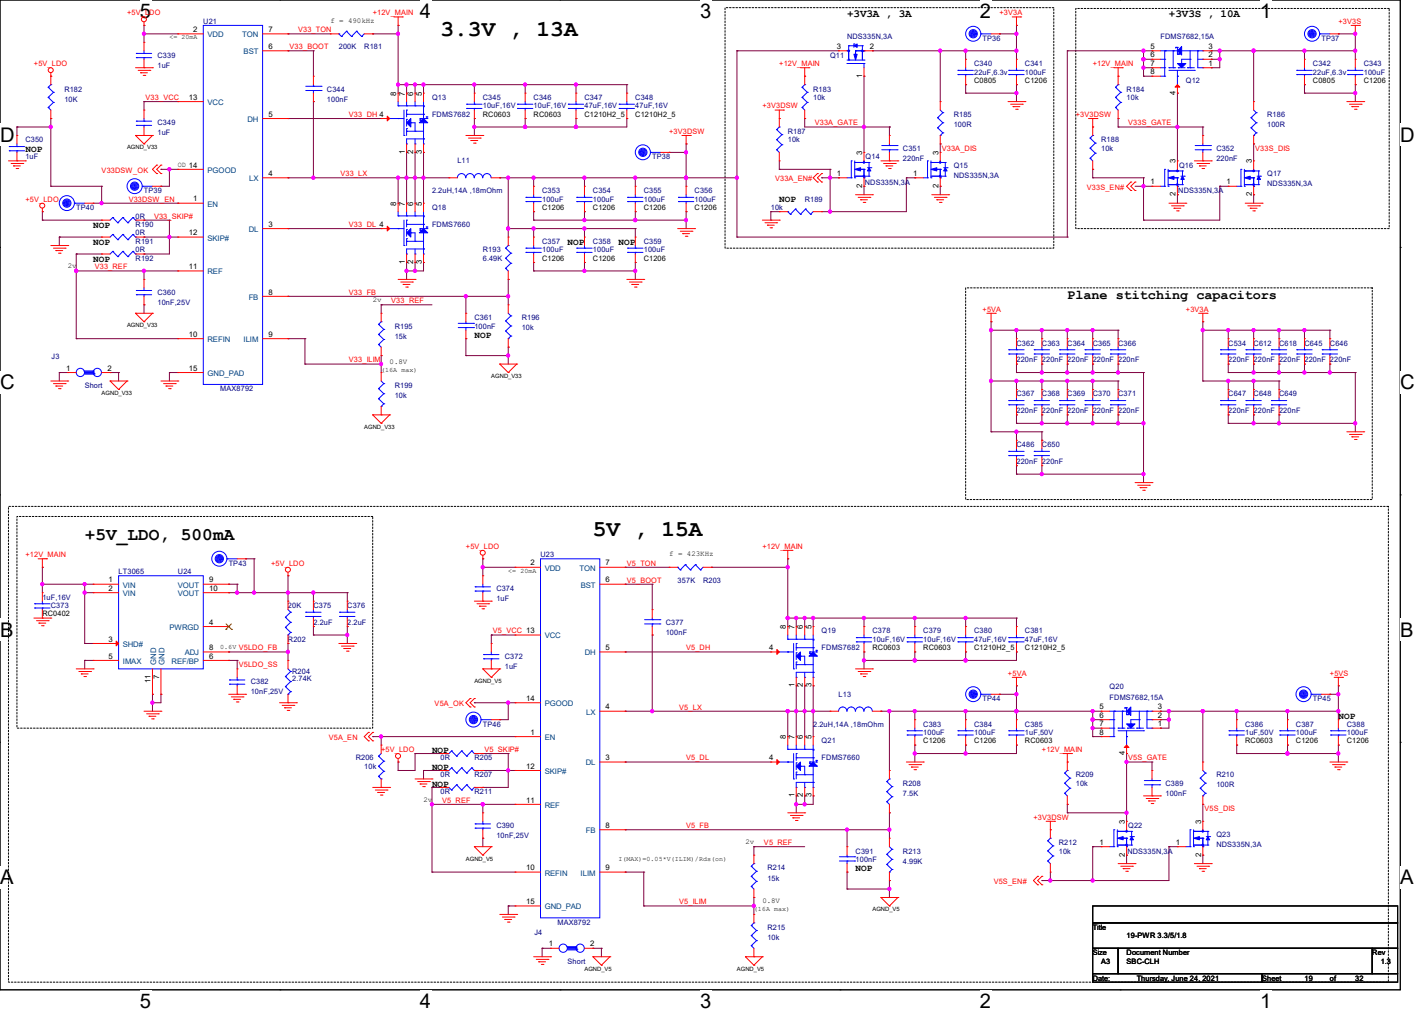
[picture p74: page 20]

I(MAX)=0.05*V(ILIM)/Rds(on)

C C

1.05V , 11A

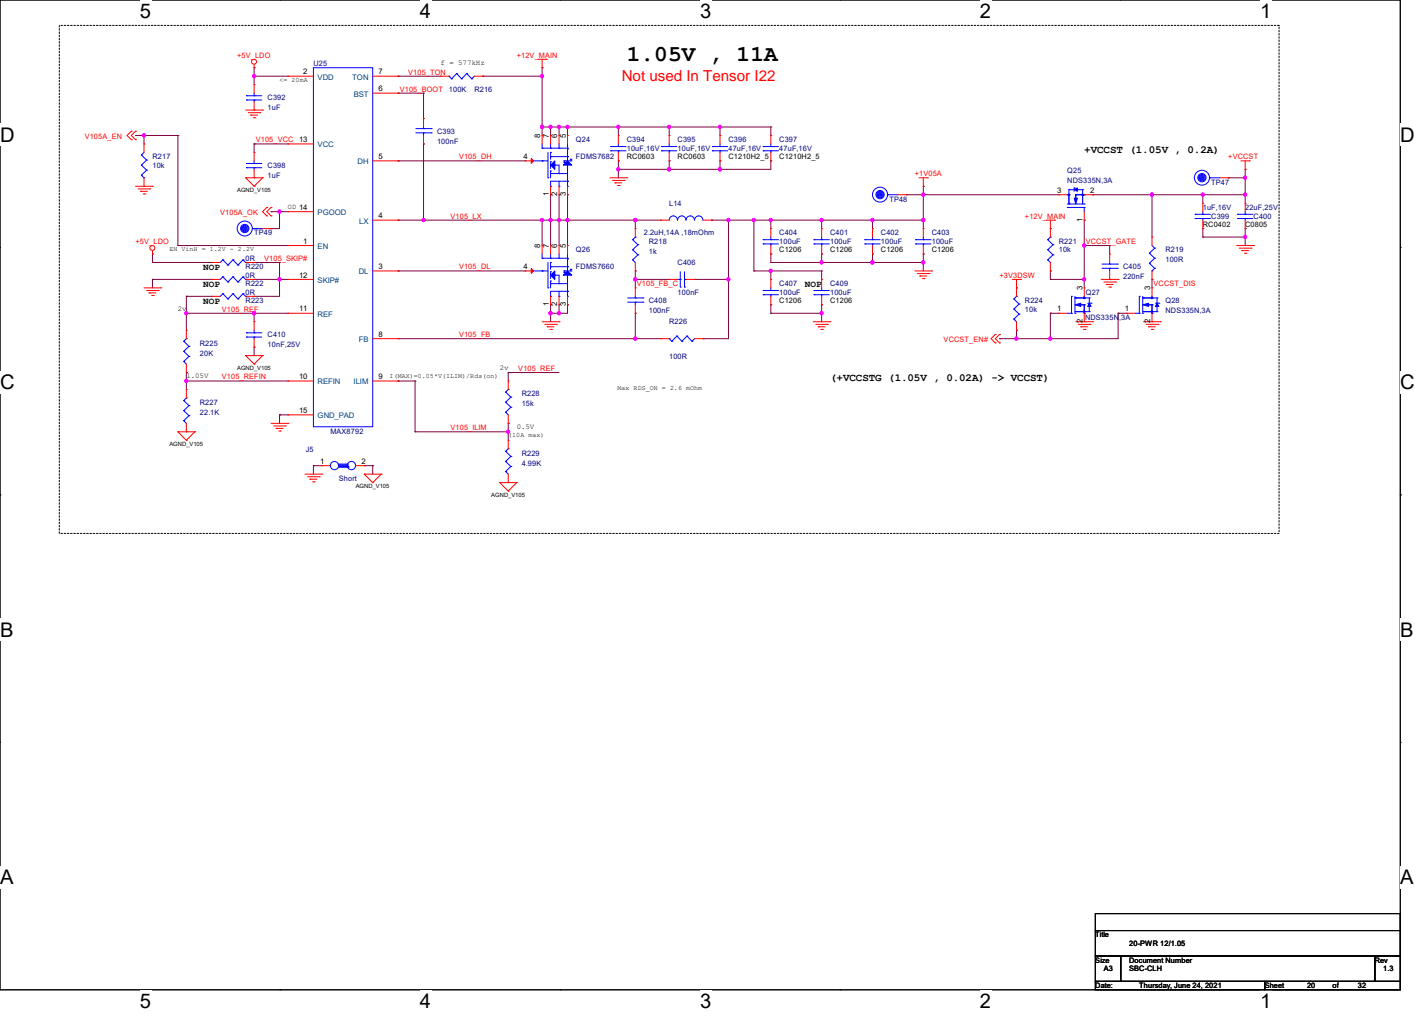
[picture p75: page 21]

Not used In Tensor I22

I(MAX)=0.05*V(ILIM)/Rds(on)

# Power module Supervisor

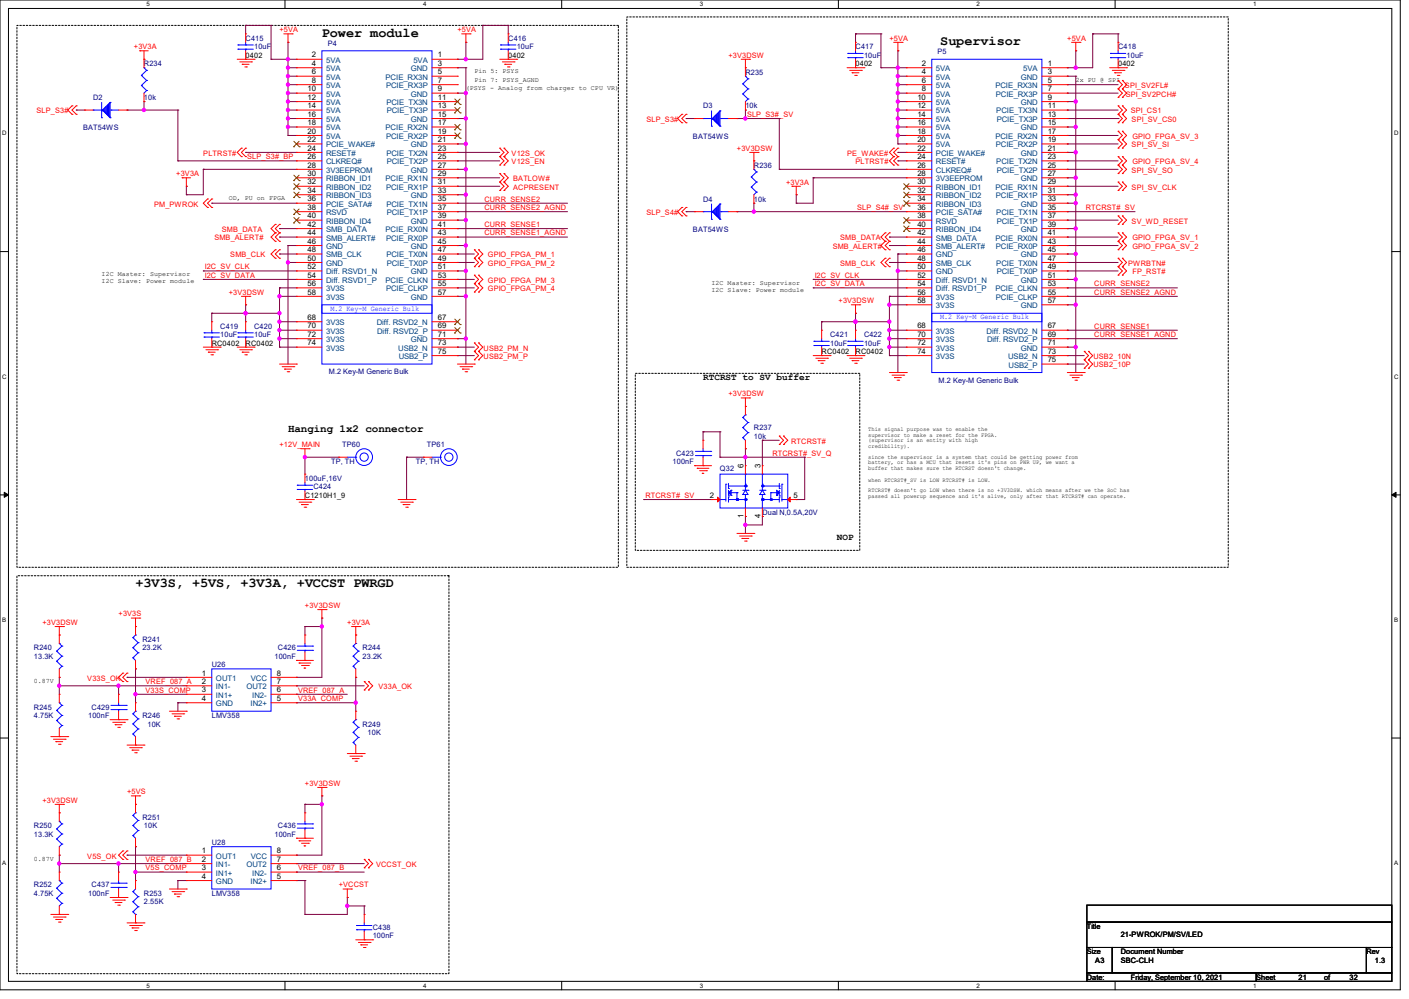
[picture p76: page 22]

Pin 5: PSYS
Pin 7: PSYS_AGND
(PSYS - Analog from charger to CPU VR)

OD, PU on FPGA

RTCRST to SV buffer

supervisor to make a reset for the FPGA.
(supervisor is an entity with high
credibility).
since the supervisor is a system that could be getting power from
battery, or has a MCU that resets it's pins on PWR UP, we want a
buffer that makes sure the RTCRST doesn't change.
when RTCRST#_SV is LOW RTCRST# is LOW.
RTCRST# doesn't go LOW when there is no +3V3DSW. which means after we the SoC has

passed all powerup sequence and it's alive, only after that RTCRST# can operate. VREF_087_A

21-PWROK/PM/SV/LED

55

44

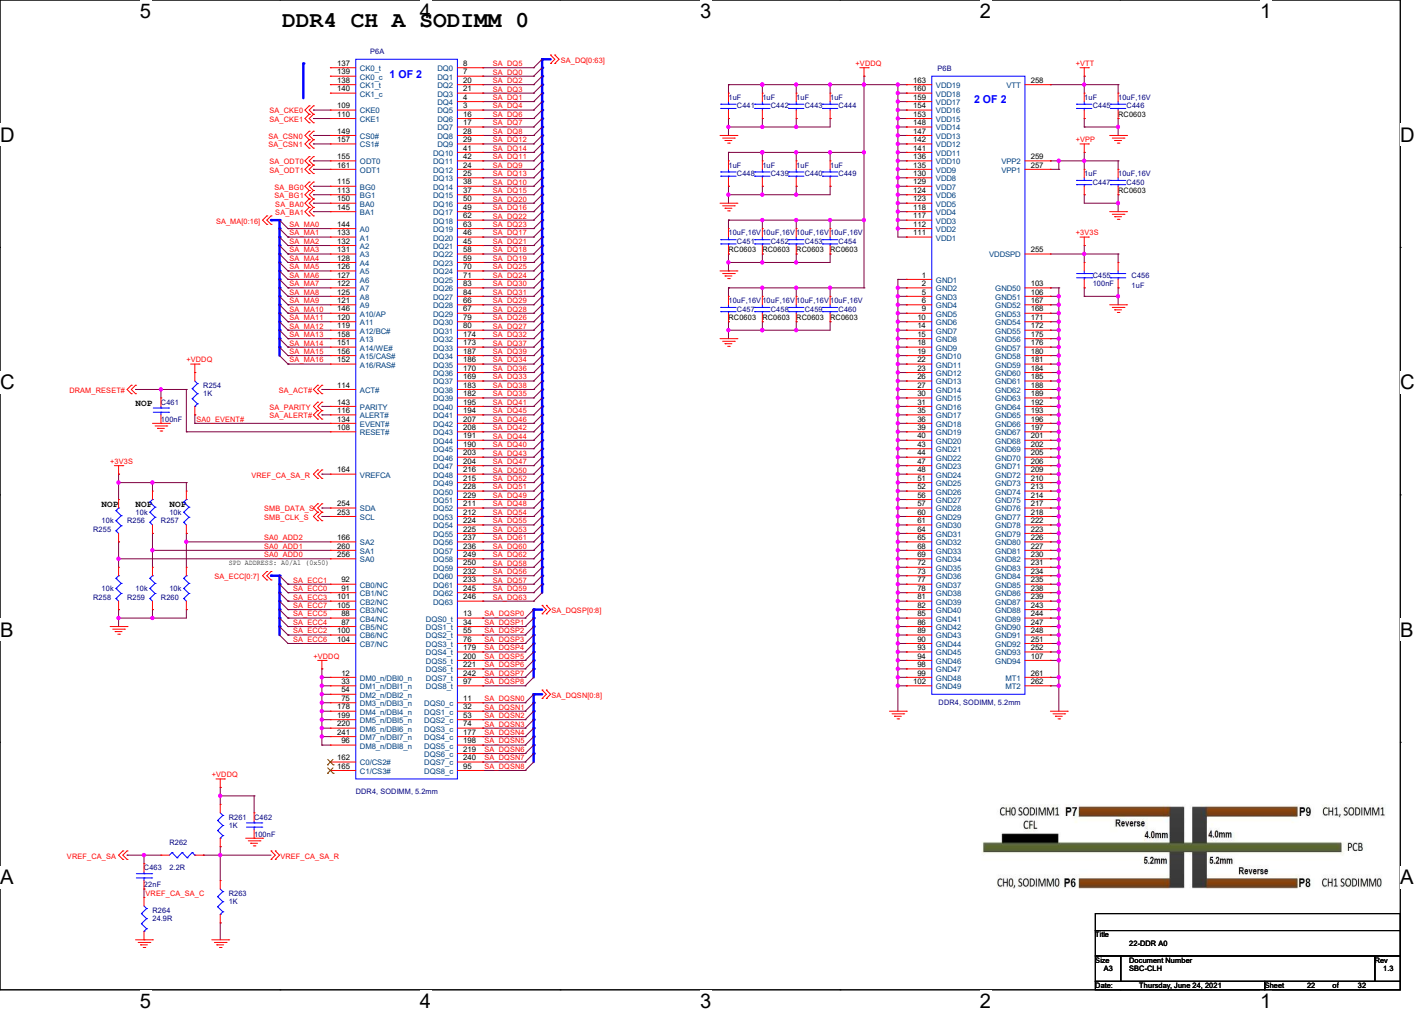
[picture p77: page 23]

ACT# 114 PARITY 143 ALERT# 116 RESET# 108 EVENT# 134

C C

# DDR4 CH A SODIMM 1

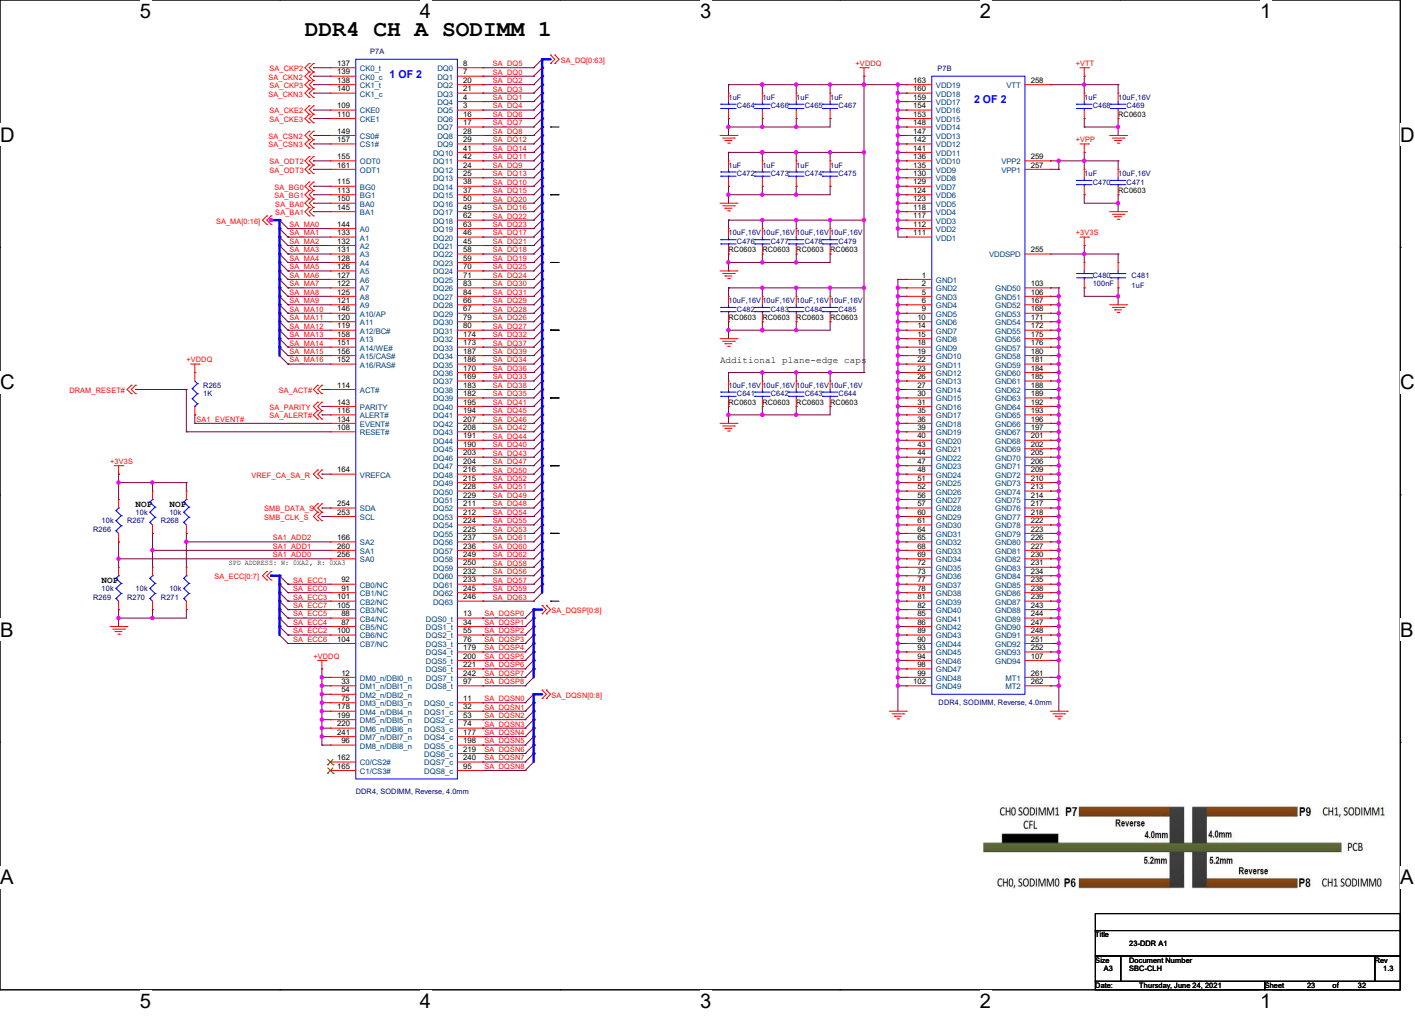
[picture p78: page 24]

ACT# 114 PARITY 143 ALERT# 116 RESET# 108 EVENT# 134

C C

# DDR4 CH B SODIMM 0

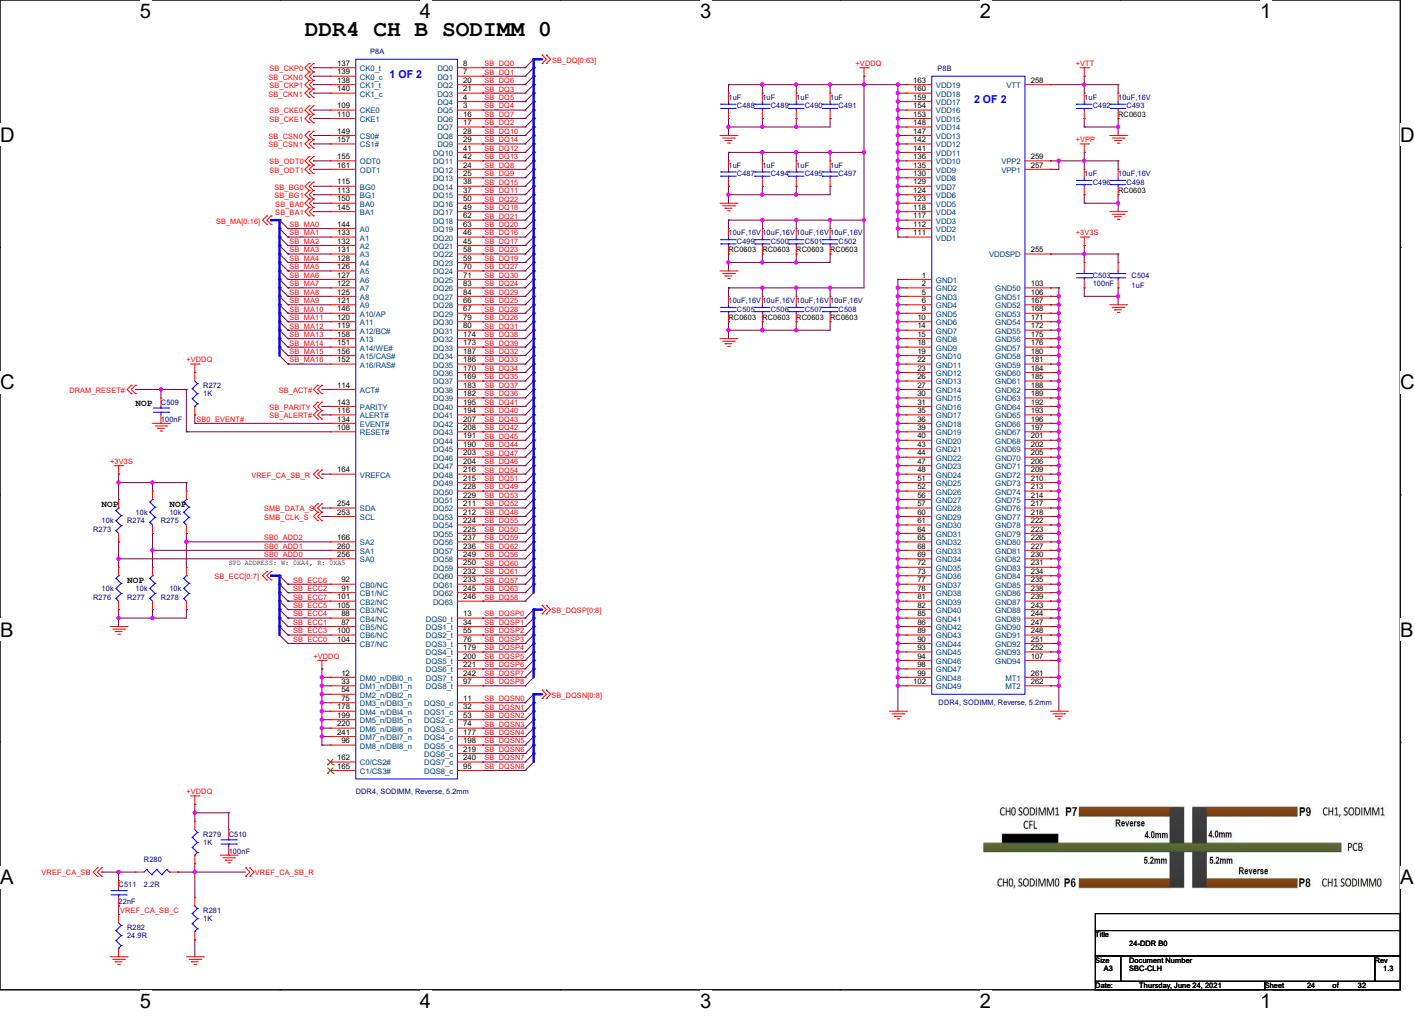
[picture p79: page 25]

ACT# 114 PARITY 143 ALERT# 116 RESET# 108 EVENT# 134

C C

# DDR4 CH B SODIMM 1

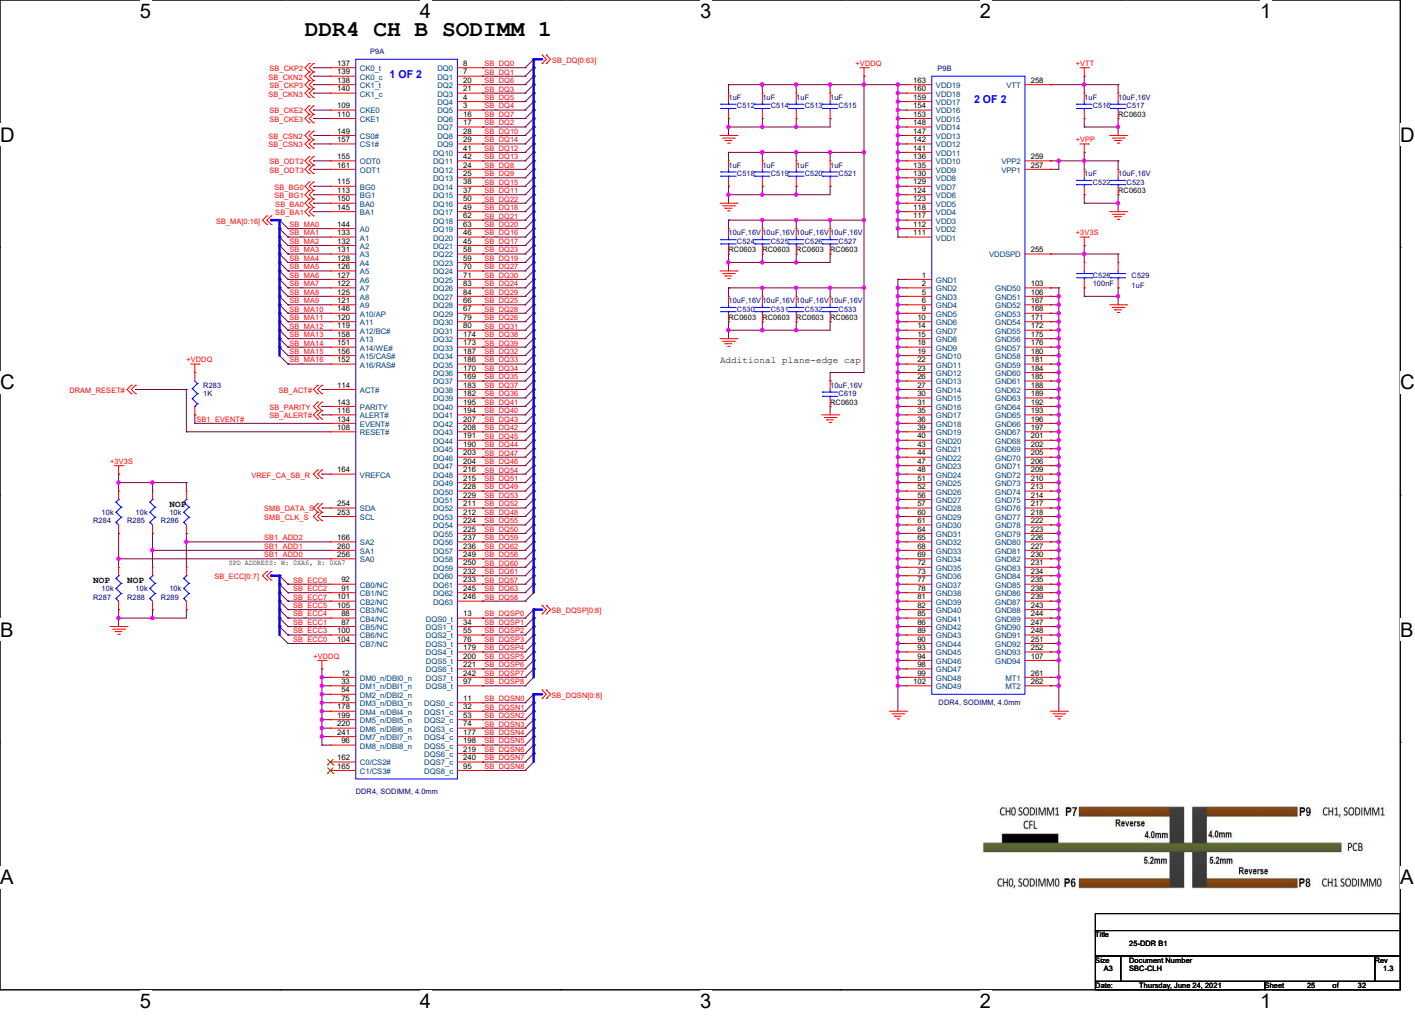
[picture p80: page 26]

ACT# 114 PARITY 143 ALERT# 116 RESET# 108 EVENT# 134

C C

# PCH UART RS232

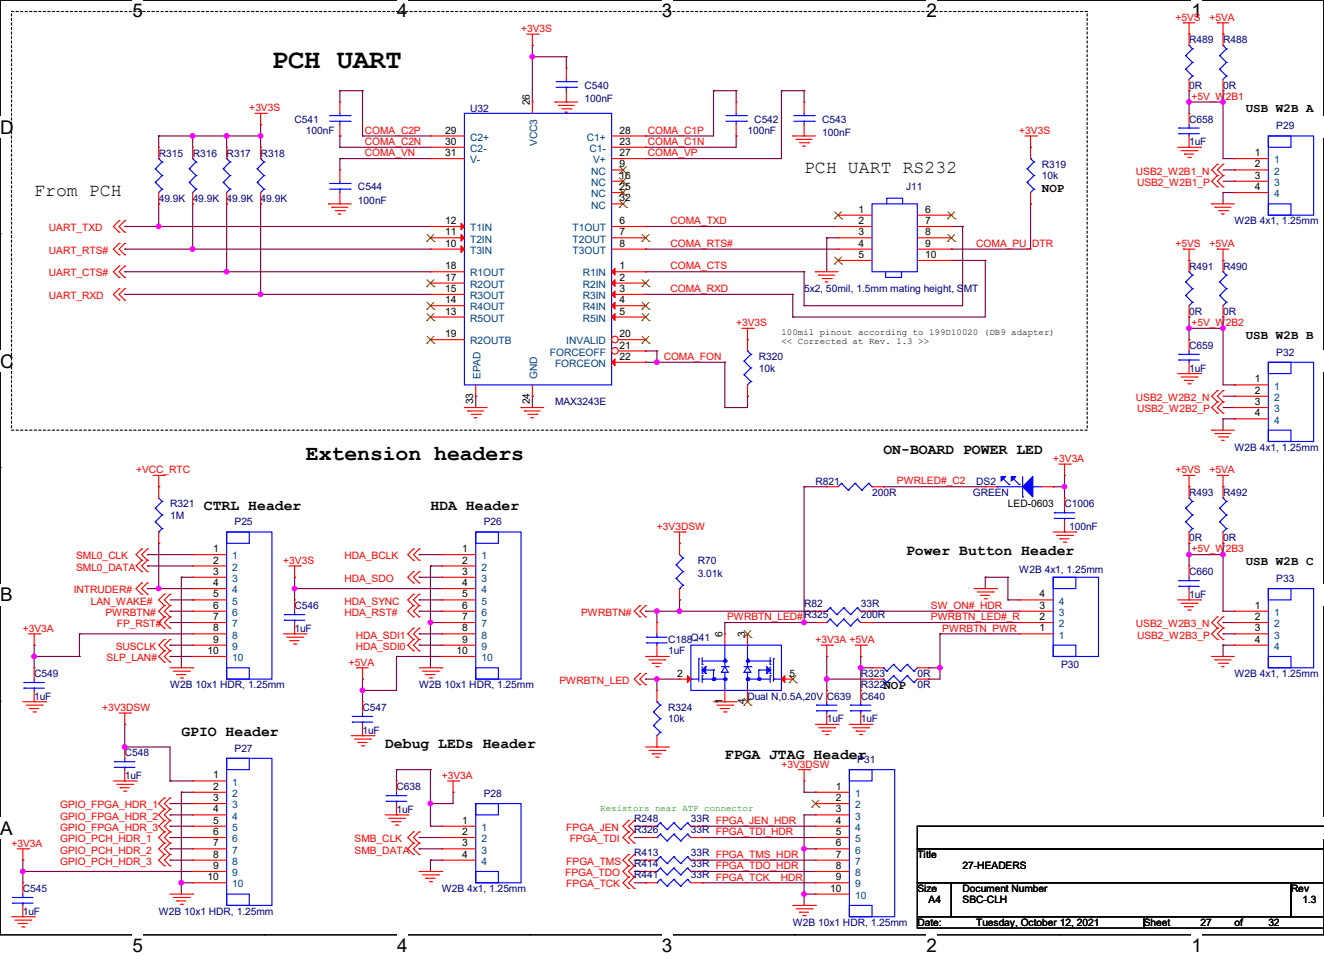
[picture p81: page 27]

ON-BOARD POWER LED

Resistors near ATP connector

## GPIO

# SMB_EN2 SMB_EN1 SMB_EN3

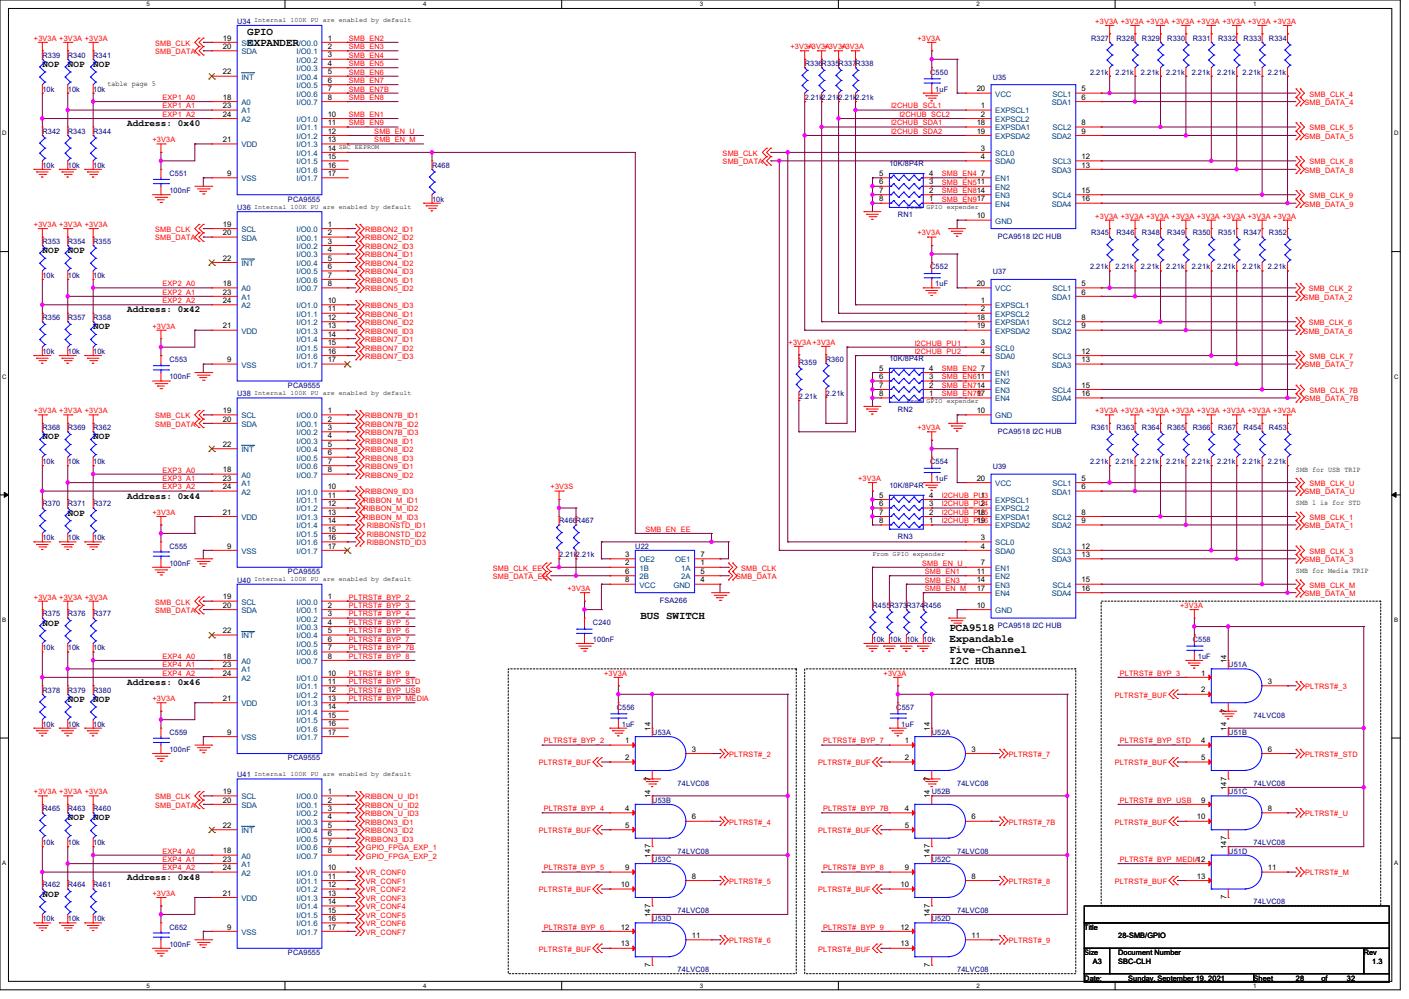
[picture p82: page 28]

Internal 100K PU are enabled by default

I/O0.7 8 A0 18 A1 23 A2 24 VDD 21 VSS 9 SCL 19 SDA 20

PLTRST#_BUF PLTRST#_BUF

DP 2 dual mode | DP 3 dual mode

## DP 1 dual mode STD TRIP

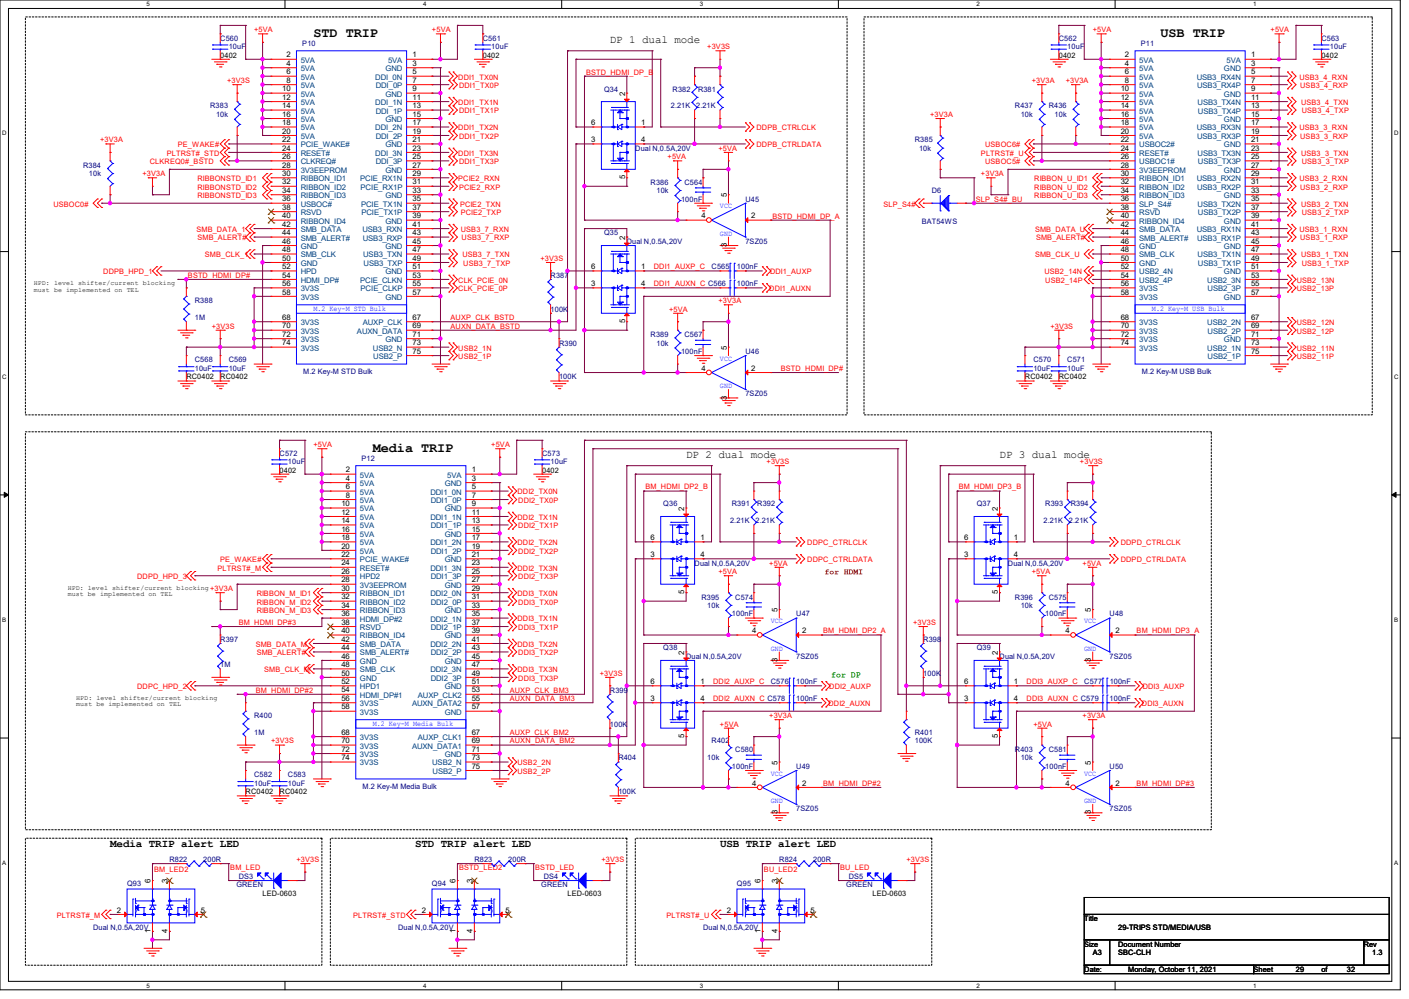
[picture p83: page 29]

3V3EEPROM 28 RIBBON_ID1 30 RIBBON_ID2 32 RIBBON_ID3 34 USBOC# 36 RSVD 38 RIBBON_ID4 40 SMB_DATA 42 SMB_ALERT# 44 GND 46 SMB_CLK 48 GND 50 HPD 52 HDMI_DP# 54

HPD: level shifter/current blocking
must be implemented on TEL

29-TRIPS STD/MEDIA/USB

# TRIP #3

TRIP #2 | TRIP #4

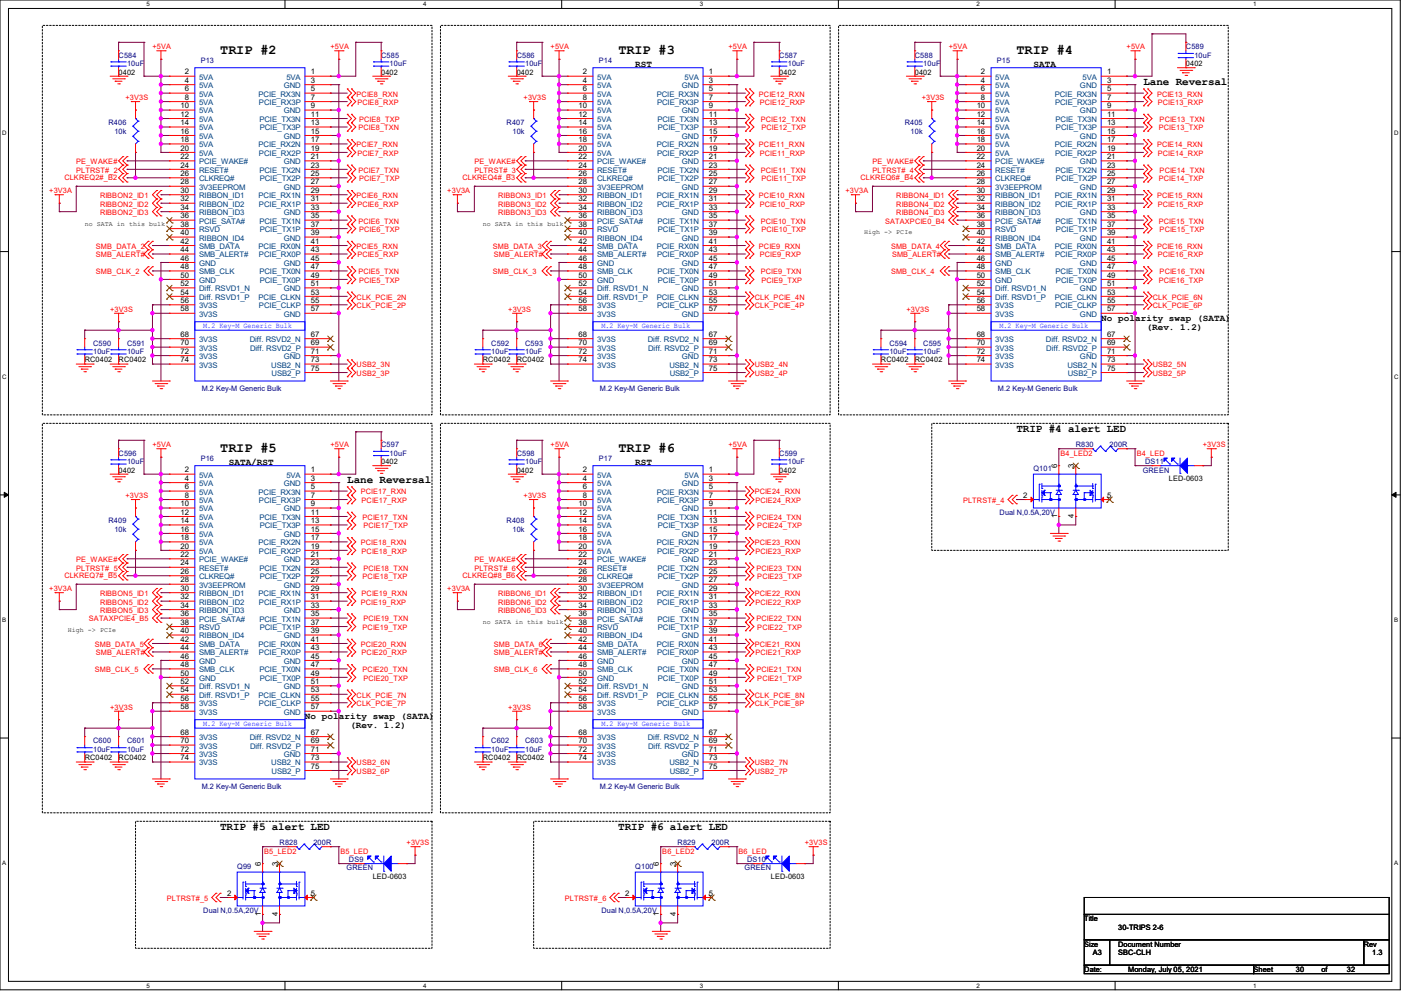
[picture p84: page 30]

3V3S 58 CLKREQ# 26
3V3EEPROM 28 RIBBON_ID1 30 RIBBON_ID2 32 RIBBON_ID3 34 PCIE_SATA# 36 RSVD 38 RIBBON_ID4 40 SMB_DATA 42 SMB_ALERT# 44 GND 46 SMB_CLK 48 GND 50 Diff. RSVD1_N 52 Diff. RSVD1_P 54

no SATA in this bulk

No polarity swap (SATA)

# TRIP #7

# TRIP #7B

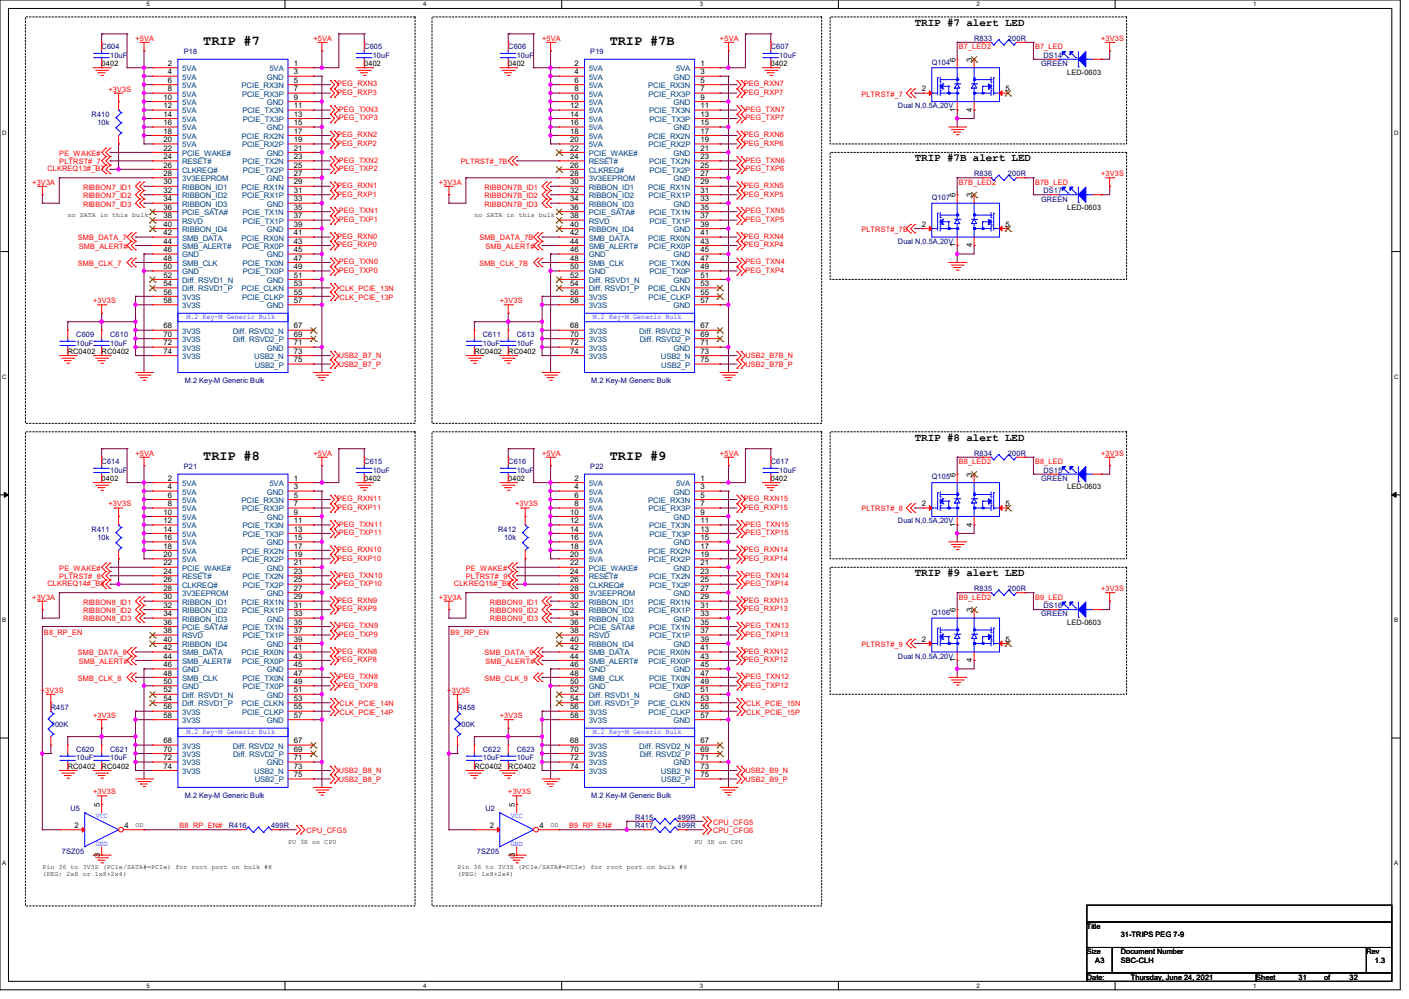
[picture p85: page 31]

no SATA in this bulk

Pin 36 to 3V3S (PCIe/SATA#=PCIe) for root port on bulk #8
(PEG: 2x8 or 1x8+2x4)

Pin 36 to 3V3S (PCIe/SATA#=PCIe) for root port on bulk #9
(PEG: 1x8+2x4)

C C

VCCIO1A_F2 F2 VCCIO1B_G3 G3 VCCIO2_K3 K3 VCCIO2_J3 J3 VCCIO3_L8 L8 VCCIO3_L7 L7 VCCIO3_L6 L6 VCCIO5_J11 J11 VCCIO5_H11 H11 VCCIO6_G11 G11 VCCIO6_F11 F11 VCCIO8_C8 C8 VCCIO8_C7 C7 VCCIO8_C6 C6 VCCA1_K4 K4 VCCA2_D10 D10 VCCA3_D4 D4 VCCA4_K9 K9 VCC_ONE_H7 H7 VCC_ONE_G8 G8 VCC_ONE_G6 G6 VCC_ONE_F7 F7

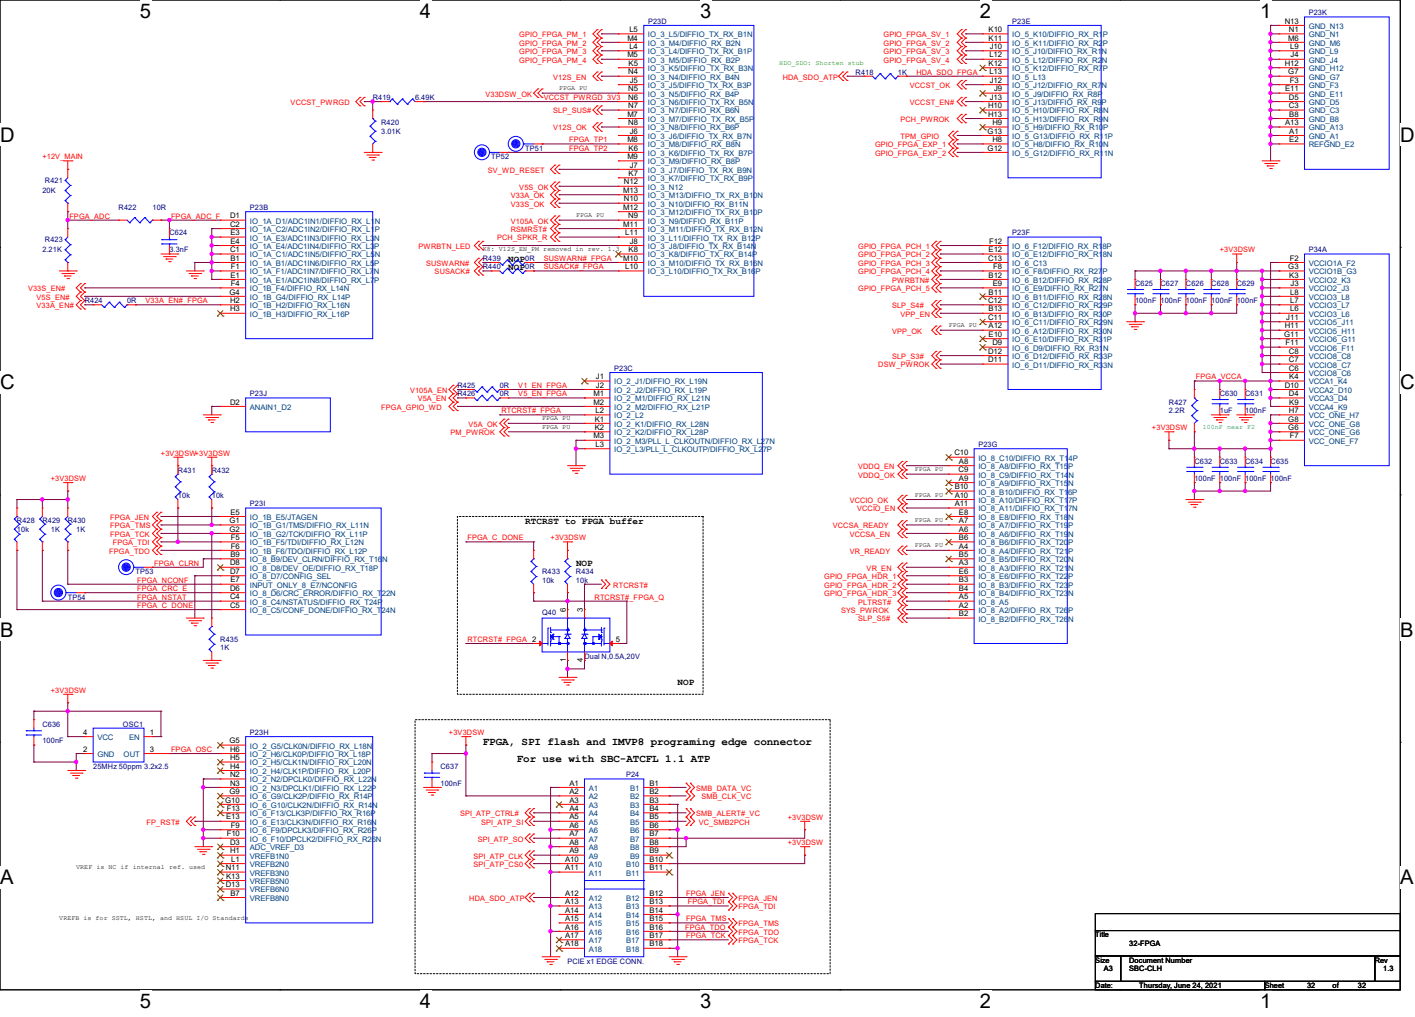
[picture p86: page 32]

RTCRST to FPGA buffer

+3V3DSW
FPGA, SPI flash and IMVP8 programing edge connector
For use with SBC-ATCFL 1.1 ATP

VREF is NC if internal ref. used

VREFB is for SSTL, HSTL, and HSUL I/O Standards
