firasgany77/Board-Design-Git/Lattice FPGA Works/SBCTI22WORK3 - Home/SBCTI22WORK3_Implmnt/sbt/outputs/placer/TOP_sbt.pcf

set_location ALL_SYS_PWRGD.count_RNI027U[11] 9 5 0 # SB_LUT4 (LogicCell: ALL_SYS_PWRGD.count_RNI027U[11]_LC_0)
set_location ALL_SYS_PWRGD.count_RNIR6KI3[10] 9 6 5 # SB_LUT4 (LogicCell: ALL_SYS_PWRGD.count_RNIR6KI3[10]_LC_1)
set_location ALL_SYS_PWRGD.count_RNIT0U61[4] 9 6 1 # SB_LUT4 (LogicCell: ALL_SYS_PWRGD.count_RNIT0U61[4]_LC_2)
set_location ALL_SYS_PWRGD.count_RNIV07U[10] 9 6 7 # SB_LUT4 (LogicCell: ALL_SYS_PWRGD.count_RNIV07U[10]_LC_3)
set_location ALL_SYS_PWRGD.count_RNO[0] 8 5 0 # SB_LUT4 (LogicCell: ALL_SYS_PWRGD.count[0]_LC_4)
set_location ALL_SYS_PWRGD.count[0] 8 5 0 # SB_DFFSR (LogicCell: ALL_SYS_PWRGD.count[0]_LC_4)
set_location ALL_SYS_PWRGD.un1_count_1_cry_0_c 8 5 0 # SB_CARRY (LogicCell: ALL_SYS_PWRGD.count[0]_LC_4)
set_location ALL_SYS_PWRGD.count_RNO[1] 8 5 1 # SB_LUT4 (LogicCell: ALL_SYS_PWRGD.count[1]_LC_5)
set_location ALL_SYS_PWRGD.count[1] 8 5 1 # SB_DFFSR (LogicCell: ALL_SYS_PWRGD.count[1]_LC_5)
set_location ALL_SYS_PWRGD.un1_count_1_cry_1_c 8 5 1 # SB_CARRY (LogicCell: ALL_SYS_PWRGD.count[1]_LC_5)
set_location ALL_SYS_PWRGD.count_RNO[10] 8 6 2 # SB_LUT4 (LogicCell: ALL_SYS_PWRGD.count[10]_LC_6)
set_location ALL_SYS_PWRGD.count[10] 8 6 2 # SB_DFFSR (LogicCell: ALL_SYS_PWRGD.count[10]_LC_6)
set_location ALL_SYS_PWRGD.un1_count_1_cry_10_c 8 6 2 # SB_CARRY (LogicCell: ALL_SYS_PWRGD.count[10]_LC_6)
set_location ALL_SYS_PWRGD.count_RNO[11] 8 6 3 # SB_LUT4 (LogicCell: ALL_SYS_PWRGD.count[11]_LC_7)
set_location ALL_SYS_PWRGD.count[11] 8 6 3 # SB_DFFSR (LogicCell: ALL_SYS_PWRGD.count[11]_LC_7)
set_location ALL_SYS_PWRGD.un1_count_1_cry_11_c 8 6 3 # SB_CARRY (LogicCell: ALL_SYS_PWRGD.count[11]_LC_7)
set_location ALL_SYS_PWRGD.count_RNO[12] 8 6 4 # SB_LUT4 (LogicCell: ALL_SYS_PWRGD.count[12]_LC_8)
set_location ALL_SYS_PWRGD.count[12] 8 6 4 # SB_DFFSR (LogicCell: ALL_SYS_PWRGD.count[12]_LC_8)
set_location ALL_SYS_PWRGD.un1_count_1_cry_12_c 8 6 4 # SB_CARRY (LogicCell: ALL_SYS_PWRGD.count[12]_LC_8)
set_location ALL_SYS_PWRGD.count_RNO[13] 8 6 5 # SB_LUT4 (LogicCell: ALL_SYS_PWRGD.count[13]_LC_9)
set_location ALL_SYS_PWRGD.count[13] 8 6 5 # SB_DFFSR (LogicCell: ALL_SYS_PWRGD.count[13]_LC_9)
set_location ALL_SYS_PWRGD.un1_count_1_cry_13_c 8 6 5 # SB_CARRY (LogicCell: ALL_SYS_PWRGD.count[13]_LC_9)
set_location ALL_SYS_PWRGD.count_RNO[14] 8 6 6 # SB_LUT4 (LogicCell: ALL_SYS_PWRGD.count[14]_LC_10)
set_location ALL_SYS_PWRGD.count[14] 8 6 6 # SB_DFFSR (LogicCell: ALL_SYS_PWRGD.count[14]_LC_10)
set_location ALL_SYS_PWRGD.un1_count_1_cry_14_c 8 6 6 # SB_CARRY (LogicCell: ALL_SYS_PWRGD.count[14]_LC_10)
set_location ALL_SYS_PWRGD.count_RNO[2] 8 5 2 # SB_LUT4 (LogicCell: ALL_SYS_PWRGD.count[2]_LC_11)
set_location ALL_SYS_PWRGD.count[2] 8 5 2 # SB_DFFSR (LogicCell: ALL_SYS_PWRGD.count[2]_LC_11)
set_location ALL_SYS_PWRGD.un1_count_1_cry_2_c 8 5 2 # SB_CARRY (LogicCell: ALL_SYS_PWRGD.count[2]_LC_11)
set_location ALL_SYS_PWRGD.count_RNO[3] 8 5 3 # SB_LUT4 (LogicCell: ALL_SYS_PWRGD.count[3]_LC_12)
set_location ALL_SYS_PWRGD.count[3] 8 5 3 # SB_DFFSR (LogicCell: ALL_SYS_PWRGD.count[3]_LC_12)
set_location ALL_SYS_PWRGD.un1_count_1_cry_3_c 8 5 3 # SB_CARRY (LogicCell: ALL_SYS_PWRGD.count[3]_LC_12)
set_location ALL_SYS_PWRGD.count_RNO[4] 8 5 4 # SB_LUT4 (LogicCell: ALL_SYS_PWRGD.count[4]_LC_13)
set_location ALL_SYS_PWRGD.count[4] 8 5 4 # SB_DFFSR (LogicCell: ALL_SYS_PWRGD.count[4]_LC_13)
set_location ALL_SYS_PWRGD.un1_count_1_cry_4_c 8 5 4 # SB_CARRY (LogicCell: ALL_SYS_PWRGD.count[4]_LC_13)
set_location ALL_SYS_PWRGD.count_RNO[5] 8 5 5 # SB_LUT4 (LogicCell: ALL_SYS_PWRGD.count[5]_LC_14)
set_location ALL_SYS_PWRGD.count[5] 8 5 5 # SB_DFFSR (LogicCell: ALL_SYS_PWRGD.count[5]_LC_14)
set_location ALL_SYS_PWRGD.un1_count_1_cry_5_c 8 5 5 # SB_CARRY (LogicCell: ALL_SYS_PWRGD.count[5]_LC_14)
set_location ALL_SYS_PWRGD.count_RNO[6] 8 5 6 # SB_LUT4 (LogicCell: ALL_SYS_PWRGD.count[6]_LC_15)
set_location ALL_SYS_PWRGD.count[6] 8 5 6 # SB_DFFSR (LogicCell: ALL_SYS_PWRGD.count[6]_LC_15)
set_location ALL_SYS_PWRGD.un1_count_1_cry_6_c 8 5 6 # SB_CARRY (LogicCell: ALL_SYS_PWRGD.count[6]_LC_15)
set_location ALL_SYS_PWRGD.count_RNO[7] 8 5 7 # SB_LUT4 (LogicCell: ALL_SYS_PWRGD.count[7]_LC_16)
set_location ALL_SYS_PWRGD.count[7] 8 5 7 # SB_DFFSR (LogicCell: ALL_SYS_PWRGD.count[7]_LC_16)
set_location ALL_SYS_PWRGD.un1_count_1_cry_7_c 8 5 7 # SB_CARRY (LogicCell: ALL_SYS_PWRGD.count[7]_LC_16)
set_location ALL_SYS_PWRGD.count_RNO[8] 8 6 0 # SB_LUT4 (LogicCell: ALL_SYS_PWRGD.count[8]_LC_17)
set_location ALL_SYS_PWRGD.count[8] 8 6 0 # SB_DFFSR (LogicCell: ALL_SYS_PWRGD.count[8]_LC_17)
set_location ALL_SYS_PWRGD.un1_count_1_cry_8_c 8 6 0 # SB_CARRY (LogicCell: ALL_SYS_PWRGD.count[8]_LC_17)
set_location ALL_SYS_PWRGD.count_RNO[9] 8 6 1 # SB_LUT4 (LogicCell: ALL_SYS_PWRGD.count[9]_LC_18)
set_location ALL_SYS_PWRGD.count[9] 8 6 1 # SB_DFFSR (LogicCell: ALL_SYS_PWRGD.count[9]_LC_18)
set_location ALL_SYS_PWRGD.un1_count_1_cry_9_c 8 6 1 # SB_CARRY (LogicCell: ALL_SYS_PWRGD.count[9]_LC_18)
set_location ALL_SYS_PWRGD.count_esr_RNIV28F[15] 9 6 4 # SB_LUT4 (LogicCell: ALL_SYS_PWRGD.count_esr_RNIV28F[15]_LC_19)
set_location ALL_SYS_PWRGD.count_esr_RNO_0[15] 9 7 2 # SB_LUT4 (LogicCell: ALL_SYS_PWRGD.count_esr_RNO_0[15]_LC_20)
set_location ALL_SYS_PWRGD.count_esr_RNO[15] 8 7 0 # SB_LUT4 (LogicCell: ALL_SYS_PWRGD.count_esr[15]_LC_21)
set_location ALL_SYS_PWRGD.count_esr[15] 8 7 0 # SB_DFFESR (LogicCell: ALL_SYS_PWRGD.count_esr[15]_LC_21)
set_location ALL_SYS_PWRGD.curr_state_7_1_0_.m4_0_0 11 7 3 # SB_LUT4 (LogicCell: ALL_SYS_PWRGD.curr_state[0]_LC_22)
set_location ALL_SYS_PWRGD.curr_state[0] 11 7 3 # SB_DFFE (LogicCell: ALL_SYS_PWRGD.curr_state[0]_LC_22)
set_location ALL_SYS_PWRGD.curr_state_7_1_0_.m4_0_0_a2 12 7 4 # SB_LUT4 (LogicCell: ALL_SYS_PWRGD.curr_state_7_1_0_.m4_0_0_a2_LC_23)
set_location ALL_SYS_PWRGD.curr_state_7_1_0_.m4_0_0_a2_1 12 7 3 # SB_LUT4 (LogicCell: ALL_SYS_PWRGD.curr_state_7_1_0_.m4_0_0_a2_1_LC_24)
set_location ALL_SYS_PWRGD.curr_state_7_1_0_.m4_0_0_a6 11 7 2 # SB_LUT4 (LogicCell: ALL_SYS_PWRGD.curr_state_7_1_0_.m4_0_0_a6_LC_25)
set_location ALL_SYS_PWRGD.curr_state_7_1_0_.m6_0_0 11 7 5 # SB_LUT4 (LogicCell: ALL_SYS_PWRGD.curr_state[1]_LC_26)
set_location ALL_SYS_PWRGD.curr_state[1] 11 7 5 # SB_DFFE (LogicCell: ALL_SYS_PWRGD.curr_state[1]_LC_26)
set_location ALL_SYS_PWRGD.curr_state_RNIKNST6[0] 9 7 1 # SB_LUT4 (LogicCell: ALL_SYS_PWRGD.curr_state_RNIKNST6[0]_LC_27)
set_location ALL_SYS_PWRGD.curr_state_RNIP5P46[0] 11 7 6 # SB_LUT4 (LogicCell: ALL_SYS_PWRGD.curr_state_RNIP5P46[0]_LC_28)
set_location ALL_SYS_PWRGD.curr_state_RNIUU4I2[0] 11 7 4 # SB_LUT4 (LogicCell: ALL_SYS_PWRGD.curr_state_RNIUU4I2[0]_LC_29)
set_location COUNTER.counter_RNO[0] 9 5 1 # SB_LUT4 (LogicCell: COUNTER.counter[0]_LC_30)
set_location COUNTER.counter[0] 9 5 1 # SB_DFF (LogicCell: COUNTER.counter[0]_LC_30)
set_location COUNTER.counter_RNO[1] 8 1 4 # SB_LUT4 (LogicCell: COUNTER.counter[1]_LC_31)
set_location COUNTER.counter[1] 8 1 4 # SB_DFF (LogicCell: COUNTER.counter[1]_LC_31)
set_location COUNTER.counter_RNO[10] 9 2 1 # SB_LUT4 (LogicCell: COUNTER.counter[10]_LC_32)
set_location COUNTER.counter[10] 9 2 1 # SB_DFF (LogicCell: COUNTER.counter[10]_LC_32)
set_location COUNTER.counter_1_cry_10_c 9 2 1 # SB_CARRY (LogicCell: COUNTER.counter[10]_LC_32)
set_location COUNTER.counter_RNO[11] 9 2 2 # SB_LUT4 (LogicCell: COUNTER.counter[11]_LC_33)
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
set_location COUNTER.counter_1_cry_9_c 9 2 0 # SB_CARRY (LogicCell: COUNTER.counter[9]_LC_61)
set_location COUNTER.tmp_RNIRH3P 9 7 5 # SB_LUT4 (LogicCell: COUNTER.tmp_RNIRH3P_LC_62)
set_location COUNTER.tmp_RNO 9 7 4 # SB_LUT4 (LogicCell: COUNTER.tmp_LC_63)
set_location COUNTER.tmp 9 7 4 # SB_DFF (LogicCell: COUNTER.tmp_LC_63)
set_location COUNTER.un4_counter_0_c_RNO 9 5 5 # SB_LUT4 (LogicCell: COUNTER.un4_counter_0_c_RNO_LC_64)
set_location COUNTER.un4_counter_1_c_RNO 8 1 6 # SB_LUT4 (LogicCell: COUNTER.un4_counter_1_c_RNO_LC_65)
set_location COUNTER.un4_counter_2_c_RNO 11 3 5 # SB_LUT4 (LogicCell: COUNTER.un4_counter_2_c_RNO_LC_66)
set_location COUNTER.un4_counter_3_c_RNO 11 2 1 # SB_LUT4 (LogicCell: COUNTER.un4_counter_3_c_RNO_LC_67)
set_location COUNTER.un4_counter_4_c_RNO 11 3 3 # SB_LUT4 (LogicCell: COUNTER.un4_counter_4_c_RNO_LC_68)
set_location COUNTER.un4_counter_5_c_RNO 9 4 7 # SB_LUT4 (LogicCell: COUNTER.un4_counter_5_c_RNO_LC_69)
set_location COUNTER.un4_counter_6_c_RNO 9 5 2 # SB_LUT4 (LogicCell: COUNTER.un4_counter_6_c_RNO_LC_70)
set_location COUNTER.un4_counter_7_c_RNO 9 5 3 # SB_LUT4 (LogicCell: COUNTER.un4_counter_7_c_RNO_LC_71)
set_location HDA_STRAP.HDA_SDO_FPGA_RNO 5 2 7 # SB_LUT4 (LogicCell: HDA_STRAP.HDA_SDO_FPGA_LC_72)
set_location HDA_STRAP.HDA_SDO_FPGA 5 2 7 # SB_DFFE (LogicCell: HDA_STRAP.HDA_SDO_FPGA_LC_72)
set_location HDA_STRAP.count_RNI63EA1[17] 7 2 4 # SB_LUT4 (LogicCell: HDA_STRAP.count_RNI63EA1[17]_LC_73)
set_location HDA_STRAP.count_RNIB5IA5[0] 7 2 5 # SB_LUT4 (LogicCell: HDA_STRAP.count_RNIB5IA5[0]_LC_74)
set_location HDA_STRAP.count_RNID0921[4] 7 2 3 # SB_LUT4 (LogicCell: HDA_STRAP.count_RNID0921[4]_LC_75)
set_location HDA_STRAP.count_RNIDLB61[6] 7 2 1 # SB_LUT4 (LogicCell: HDA_STRAP.count_RNIDLB61[6]_LC_76)
set_location HDA_STRAP.count_RNIQC821[0] 7 1 7 # SB_LUT4 (LogicCell: HDA_STRAP.count_RNIQC821[0]_LC_77)
set_location HDA_STRAP.count_RNIUKIR1[12] 7 2 2 # SB_LUT4 (LogicCell: HDA_STRAP.count_RNIUKIR1[12]_LC_78)
set_location HDA_STRAP.count_RNO[0] 5 1 2 # SB_LUT4 (LogicCell: HDA_STRAP.count[0]_LC_79)
set_location HDA_STRAP.count[0] 5 1 2 # SB_DFFE (LogicCell: HDA_STRAP.count[0]_LC_79)
set_location HDA_STRAP.count_RNO_0[0] 6 1 0 # SB_LUT4 (LogicCell: HDA_STRAP.count_RNO_0[0]_LC_80)
set_location HDA_STRAP.un1_count_1_cry_0_c 6 1 0 # SB_CARRY (LogicCell: HDA_STRAP.count_RNO_0[0]_LC_80)
set_location HDA_STRAP.count_RNO_0[10] 6 2 2 # SB_LUT4 (LogicCell: HDA_STRAP.count_RNO_0[10]_LC_81)
set_location HDA_STRAP.un1_count_1_cry_10_c 6 2 2 # SB_CARRY (LogicCell: HDA_STRAP.count_RNO_0[10]_LC_81)
set_location HDA_STRAP.count_RNO_0[11] 6 2 3 # SB_LUT4 (LogicCell: HDA_STRAP.count_RNO_0[11]_LC_82)
set_location HDA_STRAP.un1_count_1_cry_11_c 6 2 3 # SB_CARRY (LogicCell: HDA_STRAP.count_RNO_0[11]_LC_82)
set_location HDA_STRAP.count_RNO_0[16] 6 3 0 # SB_LUT4 (LogicCell: HDA_STRAP.count_RNO_0[16]_LC_83)
set_location HDA_STRAP.un1_count_1_cry_16_c 6 3 0 # SB_CARRY (LogicCell: HDA_STRAP.count_RNO_0[16]_LC_83)
set_location HDA_STRAP.count_RNO_0[17] 6 3 1 # SB_LUT4 (LogicCell: HDA_STRAP.count_RNO_0[17]_LC_84)
set_location HDA_STRAP.count_RNO_0[6] 6 1 6 # SB_LUT4 (LogicCell: HDA_STRAP.count_RNO_0[6]_LC_85)
set_location HDA_STRAP.un1_count_1_cry_6_c 6 1 6 # SB_CARRY (LogicCell: HDA_STRAP.count_RNO_0[6]_LC_85)
set_location HDA_STRAP.count_RNO_0[8] 6 2 0 # SB_LUT4 (LogicCell: HDA_STRAP.count_RNO_0[8]_LC_86)
set_location HDA_STRAP.un1_count_1_cry_8_c 6 2 0 # SB_CARRY (LogicCell: HDA_STRAP.count_RNO_0[8]_LC_86)
set_location HDA_STRAP.count_RNO[1] 6 1 1 # SB_LUT4 (LogicCell: HDA_STRAP.count[1]_LC_87)
set_location HDA_STRAP.count[1] 6 1 1 # SB_DFFE (LogicCell: HDA_STRAP.count[1]_LC_87)
set_location HDA_STRAP.un1_count_1_cry_1_c 6 1 1 # SB_CARRY (LogicCell: HDA_STRAP.count[1]_LC_87)
set_location HDA_STRAP.count_RNO[10] 7 3 0 # SB_LUT4 (LogicCell: HDA_STRAP.count[10]_LC_88)
set_location HDA_STRAP.count[10] 7 3 0 # SB_DFFE (LogicCell: HDA_STRAP.count[10]_LC_88)
set_location HDA_STRAP.count_RNO[11] 5 2 0 # SB_LUT4 (LogicCell: HDA_STRAP.count[11]_LC_89)
set_location HDA_STRAP.count[11] 5 2 0 # SB_DFFE (LogicCell: HDA_STRAP.count[11]_LC_89)
set_location HDA_STRAP.count_RNO[12] 6 2 4 # SB_LUT4 (LogicCell: HDA_STRAP.count[12]_LC_90)
set_location HDA_STRAP.count[12] 6 2 4 # SB_DFFE (LogicCell: HDA_STRAP.count[12]_LC_90)
set_location HDA_STRAP.un1_count_1_cry_12_c 6 2 4 # SB_CARRY (LogicCell: HDA_STRAP.count[12]_LC_90)
set_location HDA_STRAP.count_RNO[13] 6 2 5 # SB_LUT4 (LogicCell: HDA_STRAP.count[13]_LC_91)
set_location HDA_STRAP.count[13] 6 2 5 # SB_DFFE (LogicCell: HDA_STRAP.count[13]_LC_91)
set_location HDA_STRAP.un1_count_1_cry_13_c 6 2 5 # SB_CARRY (LogicCell: HDA_STRAP.count[13]_LC_91)
set_location HDA_STRAP.count_RNO[14] 6 2 6 # SB_LUT4 (LogicCell: HDA_STRAP.count[14]_LC_92)
set_location HDA_STRAP.count[14] 6 2 6 # SB_DFFE (LogicCell: HDA_STRAP.count[14]_LC_92)
set_location HDA_STRAP.un1_count_1_cry_14_c 6 2 6 # SB_CARRY (LogicCell: HDA_STRAP.count[14]_LC_92)
set_location HDA_STRAP.count_RNO[15] 6 2 7 # SB_LUT4 (LogicCell: HDA_STRAP.count[15]_LC_93)
set_location HDA_STRAP.count[15] 6 2 7 # SB_DFFE (LogicCell: HDA_STRAP.count[15]_LC_93)
set_location HDA_STRAP.un1_count_1_cry_15_c 6 2 7 # SB_CARRY (LogicCell: HDA_STRAP.count[15]_LC_93)
set_location HDA_STRAP.count_RNO[16] 7 3 1 # SB_LUT4 (LogicCell: HDA_STRAP.count[16]_LC_94)
set_location HDA_STRAP.count[16] 7 3 1 # SB_DFFE (LogicCell: HDA_STRAP.count[16]_LC_94)
set_location HDA_STRAP.count_RNO[17] 7 3 2 # SB_LUT4 (LogicCell: HDA_STRAP.count[17]_LC_95)
set_location HDA_STRAP.count[17] 7 3 2 # SB_DFFE (LogicCell: HDA_STRAP.count[17]_LC_95)
set_location HDA_STRAP.count_RNO[2] 6 1 2 # SB_LUT4 (LogicCell: HDA_STRAP.count[2]_LC_96)
set_location HDA_STRAP.count[2] 6 1 2 # SB_DFFE (LogicCell: HDA_STRAP.count[2]_LC_96)
set_location HDA_STRAP.un1_count_1_cry_2_c 6 1 2 # SB_CARRY (LogicCell: HDA_STRAP.count[2]_LC_96)
set_location HDA_STRAP.count_RNO[3] 6 1 3 # SB_LUT4 (LogicCell: HDA_STRAP.count[3]_LC_97)
set_location HDA_STRAP.count[3] 6 1 3 # SB_DFFE (LogicCell: HDA_STRAP.count[3]_LC_97)
set_location HDA_STRAP.un1_count_1_cry_3_c 6 1 3 # SB_CARRY (LogicCell: HDA_STRAP.count[3]_LC_97)
set_location HDA_STRAP.count_RNO[4] 6 1 4 # SB_LUT4 (LogicCell: HDA_STRAP.count[4]_LC_98)
set_location HDA_STRAP.count[4] 6 1 4 # SB_DFFE (LogicCell: HDA_STRAP.count[4]_LC_98)
set_location HDA_STRAP.un1_count_1_cry_4_c 6 1 4 # SB_CARRY (LogicCell: HDA_STRAP.count[4]_LC_98)
set_location HDA_STRAP.count_RNO[5] 6 1 5 # SB_LUT4 (LogicCell: HDA_STRAP.count[5]_LC_99)
set_location HDA_STRAP.count[5] 6 1 5 # SB_DFFE (LogicCell: HDA_STRAP.count[5]_LC_99)
set_location HDA_STRAP.un1_count_1_cry_5_c 6 1 5 # SB_CARRY (LogicCell: HDA_STRAP.count[5]_LC_99)
set_location HDA_STRAP.count_RNO[6] 8 2 1 # SB_LUT4 (LogicCell: HDA_STRAP.count[6]_LC_100)
set_location HDA_STRAP.count[6] 8 2 1 # SB_DFFE (LogicCell: HDA_STRAP.count[6]_LC_100)
set_location HDA_STRAP.count_RNO[7] 6 1 7 # SB_LUT4 (LogicCell: HDA_STRAP.count[7]_LC_101)
set_location HDA_STRAP.count[7] 6 1 7 # SB_DFFE (LogicCell: HDA_STRAP.count[7]_LC_101)
set_location HDA_STRAP.un1_count_1_cry_7_c 6 1 7 # SB_CARRY (LogicCell: HDA_STRAP.count[7]_LC_101)
set_location HDA_STRAP.count_RNO[8] 7 3 6 # SB_LUT4 (LogicCell: HDA_STRAP.count[8]_LC_102)
set_location HDA_STRAP.count[8] 7 3 6 # SB_DFFE (LogicCell: HDA_STRAP.count[8]_LC_102)
set_location HDA_STRAP.count_RNO[9] 6 2 1 # SB_LUT4 (LogicCell: HDA_STRAP.count[9]_LC_103)
set_location HDA_STRAP.count[9] 6 2 1 # SB_DFFE (LogicCell: HDA_STRAP.count[9]_LC_103)
set_location HDA_STRAP.un1_count_1_cry_9_c 6 2 1 # SB_CARRY (LogicCell: HDA_STRAP.count[9]_LC_103)
set_location HDA_STRAP.curr_state_RNI1S0J[0] 4 2 4 # SB_LUT4 (LogicCell: HDA_STRAP.curr_state_RNI1S0J[0]_LC_104)
set_location HDA_STRAP.curr_state_RNIH91A[0] 7 1 4 # SB_LUT4 (LogicCell: HDA_STRAP.curr_state_RNIH91A[0]_LC_105)
set_location HDA_STRAP.curr_state_RNO[0] 4 3 7 # SB_LUT4 (LogicCell: HDA_STRAP.curr_state[0]_LC_106)
set_location HDA_STRAP.curr_state[0] 4 3 7 # SB_DFFE (LogicCell: HDA_STRAP.curr_state[0]_LC_106)
set_location HDA_STRAP.curr_state_RNO_0[0] 4 2 5 # SB_LUT4 (LogicCell: HDA_STRAP.curr_state_RNO_0[0]_LC_107)
set_location HDA_STRAP.curr_state_RNO_0[2] 7 2 6 # SB_LUT4 (LogicCell: HDA_STRAP.curr_state_RNO_0[2]_LC_108)
set_location HDA_STRAP.curr_state_RNO[1] 5 1 7 # SB_LUT4 (LogicCell: HDA_STRAP.curr_state[1]_LC_109)
set_location HDA_STRAP.curr_state[1] 5 1 7 # SB_DFFE (LogicCell: HDA_STRAP.curr_state[1]_LC_109)
set_location HDA_STRAP.curr_state_RNO[2] 5 2 1 # SB_LUT4 (LogicCell: HDA_STRAP.curr_state[2]_LC_110)
set_location HDA_STRAP.curr_state[2] 5 2 1 # SB_DFFE (LogicCell: HDA_STRAP.curr_state[2]_LC_110)
set_location PCH_PWRGD.count_RNI7J2B[3] 1 2 2 # SB_LUT4 (LogicCell: PCH_PWRGD.count_RNI7J2B[3]_LC_111)
set_location PCH_PWRGD.count_RNIESHJ[1] 1 2 0 # SB_LUT4 (LogicCell: PCH_PWRGD.count_RNIESHJ[1]_LC_112)
set_location PCH_PWRGD.count_RNIN5IJ[0] 1 3 1 # SB_LUT4 (LogicCell: PCH_PWRGD.count_RNIN5IJ[0]_LC_113)
set_location PCH_PWRGD.count_RNO[0] 2 2 0 # SB_LUT4 (LogicCell: PCH_PWRGD.count[0]_LC_114)
set_location PCH_PWRGD.count[0] 2 2 0 # SB_DFFSR (LogicCell: PCH_PWRGD.count[0]_LC_114)
set_location PCH_PWRGD.un1_count_1_cry_0_c 2 2 0 # SB_CARRY (LogicCell: PCH_PWRGD.count[0]_LC_114)
set_location PCH_PWRGD.count_RNO[1] 2 2 1 # SB_LUT4 (LogicCell: PCH_PWRGD.count[1]_LC_115)
set_location PCH_PWRGD.count[1] 2 2 1 # SB_DFFSR (LogicCell: PCH_PWRGD.count[1]_LC_115)
set_location PCH_PWRGD.un1_count_1_cry_1_c 2 2 1 # SB_CARRY (LogicCell: PCH_PWRGD.count[1]_LC_115)
set_location PCH_PWRGD.count_RNO[10] 2 3 2 # SB_LUT4 (LogicCell: PCH_PWRGD.count[10]_LC_116)
set_location PCH_PWRGD.count[10] 2 3 2 # SB_DFFSR (LogicCell: PCH_PWRGD.count[10]_LC_116)
set_location PCH_PWRGD.un1_count_1_cry_10_c 2 3 2 # SB_CARRY (LogicCell: PCH_PWRGD.count[10]_LC_116)
set_location PCH_PWRGD.count_RNO[11] 2 3 3 # SB_LUT4 (LogicCell: PCH_PWRGD.count[11]_LC_117)
set_location PCH_PWRGD.count[11] 2 3 3 # SB_DFFSR (LogicCell: PCH_PWRGD.count[11]_LC_117)
set_location PCH_PWRGD.un1_count_1_cry_11_c 2 3 3 # SB_CARRY (LogicCell: PCH_PWRGD.count[11]_LC_117)
set_location PCH_PWRGD.count_RNO[12] 2 3 4 # SB_LUT4 (LogicCell: PCH_PWRGD.count[12]_LC_118)
set_location PCH_PWRGD.count[12] 2 3 4 # SB_DFFSR (LogicCell: PCH_PWRGD.count[12]_LC_118)
set_location PCH_PWRGD.un1_count_1_cry_12_c 2 3 4 # SB_CARRY (LogicCell: PCH_PWRGD.count[12]_LC_118)
set_location PCH_PWRGD.count_RNO[13] 2 3 5 # SB_LUT4 (LogicCell: PCH_PWRGD.count[13]_LC_119)
set_location PCH_PWRGD.count[13] 2 3 5 # SB_DFFSR (LogicCell: PCH_PWRGD.count[13]_LC_119)
set_location PCH_PWRGD.un1_count_1_cry_13_c 2 3 5 # SB_CARRY (LogicCell: PCH_PWRGD.count[13]_LC_119)
set_location PCH_PWRGD.count_RNO[14] 2 3 6 # SB_LUT4 (LogicCell: PCH_PWRGD.count[14]_LC_120)
set_location PCH_PWRGD.count[14] 2 3 6 # SB_DFFSR (LogicCell: PCH_PWRGD.count[14]_LC_120)
set_location PCH_PWRGD.un1_count_1_cry_14_c 2 3 6 # SB_CARRY (LogicCell: PCH_PWRGD.count[14]_LC_120)
set_location PCH_PWRGD.count_RNO[2] 2 2 2 # SB_LUT4 (LogicCell: PCH_PWRGD.count[2]_LC_121)
set_location PCH_PWRGD.count[2] 2 2 2 # SB_DFFSR (LogicCell: PCH_PWRGD.count[2]_LC_121)
set_location PCH_PWRGD.un1_count_1_cry_2_c 2 2 2 # SB_CARRY (LogicCell: PCH_PWRGD.count[2]_LC_121)
set_location PCH_PWRGD.count_RNO[3] 2 2 3 # SB_LUT4 (LogicCell: PCH_PWRGD.count[3]_LC_122)
set_location PCH_PWRGD.count[3] 2 2 3 # SB_DFFSR (LogicCell: PCH_PWRGD.count[3]_LC_122)
set_location PCH_PWRGD.un1_count_1_cry_3_c 2 2 3 # SB_CARRY (LogicCell: PCH_PWRGD.count[3]_LC_122)
set_location PCH_PWRGD.count_RNO[4] 2 2 4 # SB_LUT4 (LogicCell: PCH_PWRGD.count[4]_LC_123)
set_location PCH_PWRGD.count[4] 2 2 4 # SB_DFFSR (LogicCell: PCH_PWRGD.count[4]_LC_123)
set_location PCH_PWRGD.un1_count_1_cry_4_c 2 2 4 # SB_CARRY (LogicCell: PCH_PWRGD.count[4]_LC_123)
set_location PCH_PWRGD.count_RNO[5] 2 2 5 # SB_LUT4 (LogicCell: PCH_PWRGD.count[5]_LC_124)
set_location PCH_PWRGD.count[5] 2 2 5 # SB_DFFSR (LogicCell: PCH_PWRGD.count[5]_LC_124)
set_location PCH_PWRGD.un1_count_1_cry_5_c 2 2 5 # SB_CARRY (LogicCell: PCH_PWRGD.count[5]_LC_124)
set_location PCH_PWRGD.count_RNO[6] 2 2 6 # SB_LUT4 (LogicCell: PCH_PWRGD.count[6]_LC_125)
set_location PCH_PWRGD.count[6] 2 2 6 # SB_DFFSR (LogicCell: PCH_PWRGD.count[6]_LC_125)
set_location PCH_PWRGD.un1_count_1_cry_6_c 2 2 6 # SB_CARRY (LogicCell: PCH_PWRGD.count[6]_LC_125)
set_location PCH_PWRGD.count_RNO[7] 2 2 7 # SB_LUT4 (LogicCell: PCH_PWRGD.count[7]_LC_126)
set_location PCH_PWRGD.count[7] 2 2 7 # SB_DFFSR (LogicCell: PCH_PWRGD.count[7]_LC_126)
set_location PCH_PWRGD.un1_count_1_cry_7_c 2 2 7 # SB_CARRY (LogicCell: PCH_PWRGD.count[7]_LC_126)
set_location PCH_PWRGD.count_RNO[8] 2 3 0 # SB_LUT4 (LogicCell: PCH_PWRGD.count[8]_LC_127)
set_location PCH_PWRGD.count[8] 2 3 0 # SB_DFFSR (LogicCell: PCH_PWRGD.count[8]_LC_127)
set_location PCH_PWRGD.un1_count_1_cry_8_c 2 3 0 # SB_CARRY (LogicCell: PCH_PWRGD.count[8]_LC_127)
set_location PCH_PWRGD.count_RNO[9] 2 3 1 # SB_LUT4 (LogicCell: PCH_PWRGD.count[9]_LC_128)
set_location PCH_PWRGD.count[9] 2 3 1 # SB_DFFSR (LogicCell: PCH_PWRGD.count[9]_LC_128)
set_location PCH_PWRGD.un1_count_1_cry_9_c 2 3 1 # SB_CARRY (LogicCell: PCH_PWRGD.count[9]_LC_128)
set_location PCH_PWRGD.count_esr_RNIFR521[15] 1 3 7 # SB_LUT4 (LogicCell: PCH_PWRGD.count_esr_RNIFR521[15]_LC_129)
set_location PCH_PWRGD.count_esr_RNIRGCK2[15] 1 3 2 # SB_LUT4 (LogicCell: PCH_PWRGD.count_esr_RNIRGCK2[15]_LC_130)
set_location PCH_PWRGD.count_esr_RNO_0[15] 1 3 5 # SB_LUT4 (LogicCell: PCH_PWRGD.count_esr_RNO_0[15]_LC_131)
set_location PCH_PWRGD.count_esr_RNO[15] 2 4 0 # SB_LUT4 (LogicCell: PCH_PWRGD.count_esr[15]_LC_132)
set_location PCH_PWRGD.count_esr[15] 2 4 0 # SB_DFFESR (LogicCell: PCH_PWRGD.count_esr[15]_LC_132)
set_location PCH_PWRGD.curr_state_7_1_0_.m4 1 4 1 # SB_LUT4 (LogicCell: PCH_PWRGD.curr_state[0]_LC_133)
set_location PCH_PWRGD.curr_state[0] 1 4 1 # SB_DFFE (LogicCell: PCH_PWRGD.curr_state[0]_LC_133)
set_location PCH_PWRGD.curr_state_7_1_0_.m6 1 4 7 # SB_LUT4 (LogicCell: PCH_PWRGD.curr_state[1]_LC_134)
set_location PCH_PWRGD.curr_state[1] 1 4 7 # SB_DFFE (LogicCell: PCH_PWRGD.curr_state[1]_LC_134)
set_location PCH_PWRGD.curr_state_RNI7N705[0] 1 3 4 # SB_LUT4 (LogicCell: PCH_PWRGD.curr_state_RNI7N705[0]_LC_135)
set_location PCH_PWRGD.curr_state_RNIC5474[0] 1 3 3 # SB_LUT4 (LogicCell: PCH_PWRGD.curr_state_RNIC5474[0]_LC_136)
set_location PCH_PWRGD.curr_state_RNIHKNI1[0] 1 4 6 # SB_LUT4 (LogicCell: PCH_PWRGD.curr_state_RNIHKNI1[0]_LC_137)
set_location PCH_PWRGD.pch_pwrok_RNO 1 4 5 # SB_LUT4 (LogicCell: PCH_PWRGD.pch_pwrok_LC_138)
set_location PCH_PWRGD.pch_pwrok 1 4 5 # SB_DFFE (LogicCell: PCH_PWRGD.pch_pwrok_LC_138)
set_location PCH_PWRGD.un2_sys_pwrok 1 4 0 # SB_LUT4 (LogicCell: PCH_PWRGD.un2_sys_pwrok_LC_139)
set_location POWERLED.N_55_i_i_o6 7 12 2 # SB_LUT4 (LogicCell: POWERLED.N_55_i_i_o6_LC_140)
set_location POWERLED.VCCST_EN_i_i_0_a2 7 13 0 # SB_LUT4 (LogicCell: POWERLED.VCCST_EN_i_i_0_a2_LC_141)
set_location POWERLED.VCCST_EN_i_i_i 4 12 3 # SB_LUT4 (LogicCell: POWERLED.VCCST_EN_i_i_i_LC_142)
set_location POWERLED.count_RNI6IPJ2[5] 4 14 4 # SB_LUT4 (LogicCell: POWERLED.count_RNI6IPJ2[5]_LC_143)
set_location POWERLED.count_RNICO6R[2] 4 14 6 # SB_LUT4 (LogicCell: POWERLED.count_RNICO6R[2]_LC_144)
set_location POWERLED.count_RNID4E61[7] 4 14 3 # SB_LUT4 (LogicCell: POWERLED.count_RNID4E61[7]_LC_145)
set_location POWERLED.count_RNIOVT24[11] 4 15 4 # SB_LUT4 (LogicCell: POWERLED.count_RNIOVT24[11]_LC_146)
set_location POWERLED.count_RNO[0] 4 13 6 # SB_LUT4 (LogicCell: POWERLED.count[0]_LC_147)
set_location POWERLED.count[0] 4 13 6 # SB_DFFSR (LogicCell: POWERLED.count[0]_LC_147)
set_location POWERLED.count_RNO[1] 4 13 2 # SB_LUT4 (LogicCell: POWERLED.count[1]_LC_148)
set_location POWERLED.count[1] 4 13 2 # SB_DFFSR (LogicCell: POWERLED.count[1]_LC_148)
set_location POWERLED.count_RNO[10] 5 15 1 # SB_LUT4 (LogicCell: POWERLED.count[10]_LC_149)
set_location POWERLED.count[10] 5 15 1 # SB_DFFSR (LogicCell: POWERLED.count[10]_LC_149)
set_location POWERLED.un1_count_1_cry_10_c 5 15 1 # SB_CARRY (LogicCell: POWERLED.count[10]_LC_149)
set_location POWERLED.count_RNO[11] 5 15 2 # SB_LUT4 (LogicCell: POWERLED.count[11]_LC_150)
set_location POWERLED.count[11] 5 15 2 # SB_DFFSR (LogicCell: POWERLED.count[11]_LC_150)
set_location POWERLED.un1_count_1_cry_11_c 5 15 2 # SB_CARRY (LogicCell: POWERLED.count[11]_LC_150)
set_location POWERLED.count_RNO[12] 5 15 3 # SB_LUT4 (LogicCell: POWERLED.count[12]_LC_151)
set_location POWERLED.count[12] 5 15 3 # SB_DFFSR (LogicCell: POWERLED.count[12]_LC_151)
set_location POWERLED.un1_count_1_cry_12_c 5 15 3 # SB_CARRY (LogicCell: POWERLED.count[12]_LC_151)
set_location POWERLED.count_RNO[13] 5 15 4 # SB_LUT4 (LogicCell: POWERLED.count[13]_LC_152)
set_location POWERLED.count[13] 5 15 4 # SB_DFFSR (LogicCell: POWERLED.count[13]_LC_152)
set_location POWERLED.un1_count_1_cry_13_c 5 15 4 # SB_CARRY (LogicCell: POWERLED.count[13]_LC_152)
set_location POWERLED.count_RNO[14] 5 15 5 # SB_LUT4 (LogicCell: POWERLED.count[14]_LC_153)
set_location POWERLED.count[14] 5 15 5 # SB_DFFSR (LogicCell: POWERLED.count[14]_LC_153)
set_location POWERLED.un1_count_1_cry_14_c 5 15 5 # SB_CARRY (LogicCell: POWERLED.count[14]_LC_153)
set_location POWERLED.count_RNO[2] 5 14 1 # SB_LUT4 (LogicCell: POWERLED.count[2]_LC_154)
set_location POWERLED.count[2] 5 14 1 # SB_DFFSR (LogicCell: POWERLED.count[2]_LC_154)
set_location POWERLED.un1_count_1_cry_2_c 5 14 1 # SB_CARRY (LogicCell: POWERLED.count[2]_LC_154)
set_location POWERLED.count_RNO[3] 5 14 2 # SB_LUT4 (LogicCell: POWERLED.count[3]_LC_155)
set_location POWERLED.count[3] 5 14 2 # SB_DFFSR (LogicCell: POWERLED.count[3]_LC_155)
set_location POWERLED.un1_count_1_cry_3_c 5 14 2 # SB_CARRY (LogicCell: POWERLED.count[3]_LC_155)
set_location POWERLED.count_RNO[4] 5 14 3 # SB_LUT4 (LogicCell: POWERLED.count[4]_LC_156)
set_location POWERLED.count[4] 5 14 3 # SB_DFFSR (LogicCell: POWERLED.count[4]_LC_156)
set_location POWERLED.un1_count_1_cry_4_c 5 14 3 # SB_CARRY (LogicCell: POWERLED.count[4]_LC_156)
set_location POWERLED.count_RNO[5] 5 14 4 # SB_LUT4 (LogicCell: POWERLED.count[5]_LC_157)
set_location POWERLED.count[5] 5 14 4 # SB_DFFSR (LogicCell: POWERLED.count[5]_LC_157)
set_location POWERLED.un1_count_1_cry_5_c 5 14 4 # SB_CARRY (LogicCell: POWERLED.count[5]_LC_157)
set_location POWERLED.count_RNO[6] 5 14 5 # SB_LUT4 (LogicCell: POWERLED.count[6]_LC_158)
set_location POWERLED.count[6] 5 14 5 # SB_DFFSR (LogicCell: POWERLED.count[6]_LC_158)
set_location POWERLED.un1_count_1_cry_6_c 5 14 5 # SB_CARRY (LogicCell: POWERLED.count[6]_LC_158)
set_location POWERLED.count_RNO[7] 5 14 6 # SB_LUT4 (LogicCell: POWERLED.count[7]_LC_159)
set_location POWERLED.count[7] 5 14 6 # SB_DFFSR (LogicCell: POWERLED.count[7]_LC_159)
set_location POWERLED.un1_count_1_cry_7_c 5 14 6 # SB_CARRY (LogicCell: POWERLED.count[7]_LC_159)
set_location POWERLED.count_RNO[8] 5 14 7 # SB_LUT4 (LogicCell: POWERLED.count[8]_LC_160)
set_location POWERLED.count[8] 5 14 7 # SB_DFFSR (LogicCell: POWERLED.count[8]_LC_160)
set_location POWERLED.un1_count_1_cry_8_c 5 14 7 # SB_CARRY (LogicCell: POWERLED.count[8]_LC_160)
set_location POWERLED.count_RNO[9] 5 15 0 # SB_LUT4 (LogicCell: POWERLED.count[9]_LC_161)
set_location POWERLED.count[9] 5 15 0 # SB_DFFSR (LogicCell: POWERLED.count[9]_LC_161)
set_location POWERLED.un1_count_1_cry_9_c 5 15 0 # SB_CARRY (LogicCell: POWERLED.count[9]_LC_161)
set_location POWERLED.count_clk_1_sqmuxa_5_0_a2 6 12 0 # SB_LUT4 (LogicCell: POWERLED.count_clk_1_sqmuxa_5_0_a2_LC_162)
set_location POWERLED.count_clk_RNI01TCL[7] 7 10 5 # SB_LUT4 (LogicCell: POWERLED.count_clk_RNI01TCL[7]_LC_163)
set_location POWERLED.count_clk_RNI09QT9[1] 7 10 2 # SB_LUT4 (LogicCell: POWERLED.count_clk_RNI09QT9[1]_LC_164)
set_location POWERLED.count_clk_RNI1DHM[6] 6 9 2 # SB_LUT4 (LogicCell: POWERLED.count_clk_RNI1DHM[6]_LC_165)
set_location POWERLED.count_clk_RNI2M0Q4[6] 7 10 4 # SB_LUT4 (LogicCell: POWERLED.count_clk_RNI2M0Q4[6]_LC_166)
set_location POWERLED.count_clk_RNI3G101[5] 8 10 6 # SB_LUT4 (LogicCell: POWERLED.count_clk_RNI3G101[5]_LC_167)
set_location POWERLED.count_clk_RNI446AD[7] 7 11 7 # SB_LUT4 (LogicCell: POWERLED.count_clk_RNI446AD[7]_LC_168)
set_location POWERLED.count_clk_RNI5LMRL[1] 6 10 4 # SB_LUT4 (LogicCell: POWERLED.count_clk_RNI5LMRL[1]_LC_169)
set_location POWERLED.count_clk_RNI7LE01[7] 7 11 2 # SB_LUT4 (LogicCell: POWERLED.count_clk_RNI7LE01[7]_LC_170)
set_location POWERLED.count_clk_RNIA8VP[7] 7 11 0 # SB_LUT4 (LogicCell: POWERLED.count_clk_RNIA8VP[7]_LC_171)
set_location POWERLED.count_clk_RNIAIGJ4[7] 7 11 1 # SB_LUT4 (LogicCell: POWERLED.count_clk_RNIAIGJ4[7]_LC_172)
set_location POWERLED.count_clk_RNIBR4E9[6] 6 10 1 # SB_LUT4 (LogicCell: POWERLED.count_clk_RNIBR4E9[6]_LC_173)
set_location POWERLED.count_clk_RNIHJP92[1] 8 10 1 # SB_LUT4 (LogicCell: POWERLED.count_clk_RNIHJP92[1]_LC_174)
set_location POWERLED.count_clk_RNIJ13KB[7] 6 10 6 # SB_LUT4 (LogicCell: POWERLED.count_clk_RNIJ13KB[7]_LC_175)
set_location POWERLED.count_clk_RNIKKV71[12] 8 10 0 # SB_LUT4 (LogicCell: POWERLED.count_clk_RNIKKV71[12]_LC_176)
set_location POWERLED.count_clk_RNILEIU2[1] 8 10 7 # SB_LUT4 (LogicCell: POWERLED.count_clk_RNILEIU2[1]_LC_177)
set_location POWERLED.count_clk_RNIOH1J11[7] 7 10 6 # SB_LUT4 (LogicCell: POWERLED.count_clk_RNIOH1J11[7]_LC_178)
set_location POWERLED.count_clk_RNIP4HM[2] 8 9 4 # SB_LUT4 (LogicCell: POWERLED.count_clk_RNIP4HM[2]_LC_179)
set_location POWERLED.count_clk_RNIP6BO1[4] 8 9 5 # SB_LUT4 (LogicCell: POWERLED.count_clk_RNIP6BO1[4]_LC_180)
set_location POWERLED.count_clk_RNIPG2D1[2] 8 9 2 # SB_LUT4 (LogicCell: POWERLED.count_clk_RNIPG2D1[2]_LC_181)
set_location POWERLED.count_clk_RNIS0FM9[7] 6 10 3 # SB_LUT4 (LogicCell: POWERLED.count_clk_RNIS0FM9[7]_LC_182)
set_location POWERLED.count_clk_RNITU0DB[1] 7 10 3 # SB_LUT4 (LogicCell: POWERLED.count_clk_RNITU0DB[1]_LC_183)
set_location POWERLED.count_clk_RNIUL2D1[1] 8 10 2 # SB_LUT4 (LogicCell: POWERLED.count_clk_RNIUL2D1[1]_LC_184)
set_location POWERLED.count_clk_RNO[0] 9 9 0 # SB_LUT4 (LogicCell: POWERLED.count_clk[0]_LC_185)
set_location POWERLED.count_clk[0] 9 9 0 # SB_DFFSR (LogicCell: POWERLED.count_clk[0]_LC_185)
set_location POWERLED.un1_count_clk_1_cry_0_c 9 9 0 # SB_CARRY (LogicCell: POWERLED.count_clk[0]_LC_185)
set_location POWERLED.count_clk_RNO[1] 9 9 1 # SB_LUT4 (LogicCell: POWERLED.count_clk[1]_LC_186)
set_location POWERLED.count_clk[1] 9 9 1 # SB_DFFSR (LogicCell: POWERLED.count_clk[1]_LC_186)
set_location POWERLED.un1_count_clk_1_cry_1_c 9 9 1 # SB_CARRY (LogicCell: POWERLED.count_clk[1]_LC_186)
set_location POWERLED.count_clk_RNO[10] 9 10 2 # SB_LUT4 (LogicCell: POWERLED.count_clk[10]_LC_187)
set_location POWERLED.count_clk[10] 9 10 2 # SB_DFFSR (LogicCell: POWERLED.count_clk[10]_LC_187)
set_location POWERLED.un1_count_clk_1_cry_10_c 9 10 2 # SB_CARRY (LogicCell: POWERLED.count_clk[10]_LC_187)
set_location POWERLED.count_clk_RNO[11] 9 10 3 # SB_LUT4 (LogicCell: POWERLED.count_clk[11]_LC_188)
set_location POWERLED.count_clk[11] 9 10 3 # SB_DFFSR (LogicCell: POWERLED.count_clk[11]_LC_188)
set_location POWERLED.un1_count_clk_1_cry_11_c 9 10 3 # SB_CARRY (LogicCell: POWERLED.count_clk[11]_LC_188)
set_location POWERLED.count_clk_RNO[12] 9 10 4 # SB_LUT4 (LogicCell: POWERLED.count_clk[12]_LC_189)
set_location POWERLED.count_clk[12] 9 10 4 # SB_DFFSR (LogicCell: POWERLED.count_clk[12]_LC_189)
set_location POWERLED.un1_count_clk_1_cry_12_c 9 10 4 # SB_CARRY (LogicCell: POWERLED.count_clk[12]_LC_189)
set_location POWERLED.count_clk_RNO[13] 9 10 5 # SB_LUT4 (LogicCell: POWERLED.count_clk[13]_LC_190)
set_location POWERLED.count_clk[13] 9 10 5 # SB_DFFSR (LogicCell: POWERLED.count_clk[13]_LC_190)
set_location POWERLED.un1_count_clk_1_cry_13_c 9 10 5 # SB_CARRY (LogicCell: POWERLED.count_clk[13]_LC_190)
set_location POWERLED.count_clk_RNO[14] 9 10 6 # SB_LUT4 (LogicCell: POWERLED.count_clk[14]_LC_191)
set_location POWERLED.count_clk[14] 9 10 6 # SB_DFFSR (LogicCell: POWERLED.count_clk[14]_LC_191)
set_location POWERLED.un1_count_clk_1_cry_14_c 9 10 6 # SB_CARRY (LogicCell: POWERLED.count_clk[14]_LC_191)
set_location POWERLED.count_clk_RNO[2] 9 9 2 # SB_LUT4 (LogicCell: POWERLED.count_clk[2]_LC_192)
set_location POWERLED.count_clk[2] 9 9 2 # SB_DFFSR (LogicCell: POWERLED.count_clk[2]_LC_192)
set_location POWERLED.un1_count_clk_1_cry_2_c 9 9 2 # SB_CARRY (LogicCell: POWERLED.count_clk[2]_LC_192)
set_location POWERLED.count_clk_RNO[3] 9 9 3 # SB_LUT4 (LogicCell: POWERLED.count_clk[3]_LC_193)
set_location POWERLED.count_clk[3] 9 9 3 # SB_DFFSR (LogicCell: POWERLED.count_clk[3]_LC_193)
set_location POWERLED.un1_count_clk_1_cry_3_c 9 9 3 # SB_CARRY (LogicCell: POWERLED.count_clk[3]_LC_193)
set_location POWERLED.count_clk_RNO[4] 9 9 4 # SB_LUT4 (LogicCell: POWERLED.count_clk[4]_LC_194)
set_location POWERLED.count_clk[4] 9 9 4 # SB_DFFSR (LogicCell: POWERLED.count_clk[4]_LC_194)
set_location POWERLED.un1_count_clk_1_cry_4_c 9 9 4 # SB_CARRY (LogicCell: POWERLED.count_clk[4]_LC_194)
set_location POWERLED.count_clk_RNO[5] 9 9 5 # SB_LUT4 (LogicCell: POWERLED.count_clk[5]_LC_195)
set_location POWERLED.count_clk[5] 9 9 5 # SB_DFFSR (LogicCell: POWERLED.count_clk[5]_LC_195)
set_location POWERLED.un1_count_clk_1_cry_5_c 9 9 5 # SB_CARRY (LogicCell: POWERLED.count_clk[5]_LC_195)
set_location POWERLED.count_clk_RNO[6] 9 9 6 # SB_LUT4 (LogicCell: POWERLED.count_clk[6]_LC_196)
set_location POWERLED.count_clk[6] 9 9 6 # SB_DFFSR (LogicCell: POWERLED.count_clk[6]_LC_196)
set_location POWERLED.un1_count_clk_1_cry_6_c 9 9 6 # SB_CARRY (LogicCell: POWERLED.count_clk[6]_LC_196)
set_location POWERLED.count_clk_RNO[7] 9 9 7 # SB_LUT4 (LogicCell: POWERLED.count_clk[7]_LC_197)
set_location POWERLED.count_clk[7] 9 9 7 # SB_DFFSR (LogicCell: POWERLED.count_clk[7]_LC_197)
set_location POWERLED.un1_count_clk_1_cry_7_c 9 9 7 # SB_CARRY (LogicCell: POWERLED.count_clk[7]_LC_197)
set_location POWERLED.count_clk_RNO[8] 9 10 0 # SB_LUT4 (LogicCell: POWERLED.count_clk[8]_LC_198)
set_location POWERLED.count_clk[8] 9 10 0 # SB_DFFSR (LogicCell: POWERLED.count_clk[8]_LC_198)
set_location POWERLED.un1_count_clk_1_cry_8_c 9 10 0 # SB_CARRY (LogicCell: POWERLED.count_clk[8]_LC_198)
set_location POWERLED.count_clk_RNO[9] 9 10 1 # SB_LUT4 (LogicCell: POWERLED.count_clk[9]_LC_199)
set_location POWERLED.count_clk[9] 9 10 1 # SB_DFFSR (LogicCell: POWERLED.count_clk[9]_LC_199)
set_location POWERLED.un1_count_clk_1_cry_9_c 9 10 1 # SB_CARRY (LogicCell: POWERLED.count_clk[9]_LC_199)
set_location POWERLED.count_clk_esr_RNIVU6L[15] 8 10 5 # SB_LUT4 (LogicCell: POWERLED.count_clk_esr_RNIVU6L[15]_LC_200)
set_location POWERLED.count_clk_esr_RNO_0[15] 8 10 4 # SB_LUT4 (LogicCell: POWERLED.count_clk_esr_RNO_0[15]_LC_201)
set_location POWERLED.count_clk_esr_RNO[15] 9 11 0 # SB_LUT4 (LogicCell: POWERLED.count_clk_esr[15]_LC_202)
set_location POWERLED.count_clk_esr[15] 9 11 0 # SB_DFFESR (LogicCell: POWERLED.count_clk_esr[15]_LC_202)
set_location POWERLED.count_esr_RNIBHMO[15] 4 15 3 # SB_LUT4 (LogicCell: POWERLED.count_esr_RNIBHMO[15]_LC_203)
set_location POWERLED.count_esr_RNO_0[15] 4 16 0 # SB_LUT4 (LogicCell: POWERLED.count_esr_RNO_0[15]_LC_204)
set_location POWERLED.count_esr_RNO[15] 5 16 0 # SB_LUT4 (LogicCell: POWERLED.count_esr[15]_LC_205)
set_location POWERLED.count_esr[15] 5 16 0 # SB_DFFESR (LogicCell: POWERLED.count_esr[15]_LC_205)
set_location POWERLED.count_off_RNI4D6S[10] 5 11 1 # SB_LUT4 (LogicCell: POWERLED.count_off_RNI4D6S[10]_LC_206)
set_location POWERLED.count_off_RNI8GP11[5] 5 11 2 # SB_LUT4 (LogicCell: POWERLED.count_off_RNI8GP11[5]_LC_207)
set_location POWERLED.count_off_RNIAJ6S[15] 5 11 0 # SB_LUT4 (LogicCell: POWERLED.count_off_RNIAJ6S[15]_LC_208)
set_location POWERLED.count_off_RNIIKVR3[10] 5 11 3 # SB_LUT4 (LogicCell: POWERLED.count_off_RNIIKVR3[10]_LC_209)
set_location POWERLED.count_off_RNIS3P11[2] 6 9 1 # SB_LUT4 (LogicCell: POWERLED.count_off_RNIS3P11[2]_LC_210)
set_location POWERLED.count_off_RNO[0] 5 9 0 # SB_LUT4 (LogicCell: POWERLED.count_off[0]_LC_211)
set_location POWERLED.count_off[0] 5 9 0 # SB_DFFE (LogicCell: POWERLED.count_off[0]_LC_211)
set_location POWERLED.un1_count_off_1_cry_0_c 5 9 0 # SB_CARRY (LogicCell: POWERLED.count_off[0]_LC_211)
set_location POWERLED.count_off_RNO[1] 5 9 1 # SB_LUT4 (LogicCell: POWERLED.count_off[1]_LC_212)
set_location POWERLED.count_off[1] 5 9 1 # SB_DFFE (LogicCell: POWERLED.count_off[1]_LC_212)
set_location POWERLED.un1_count_off_1_cry_1_c 5 9 1 # SB_CARRY (LogicCell: POWERLED.count_off[1]_LC_212)
set_location POWERLED.count_off_RNO[10] 5 10 2 # SB_LUT4 (LogicCell: POWERLED.count_off[10]_LC_213)
set_location POWERLED.count_off[10] 5 10 2 # SB_DFFE (LogicCell: POWERLED.count_off[10]_LC_213)
set_location POWERLED.un1_count_off_1_cry_10_c 5 10 2 # SB_CARRY (LogicCell: POWERLED.count_off[10]_LC_213)
set_location POWERLED.count_off_RNO[11] 5 10 3 # SB_LUT4 (LogicCell: POWERLED.count_off[11]_LC_214)
set_location POWERLED.count_off[11] 5 10 3 # SB_DFFE (LogicCell: POWERLED.count_off[11]_LC_214)
set_location POWERLED.un1_count_off_1_cry_11_c 5 10 3 # SB_CARRY (LogicCell: POWERLED.count_off[11]_LC_214)
set_location POWERLED.count_off_RNO[12] 5 10 4 # SB_LUT4 (LogicCell: POWERLED.count_off[12]_LC_215)
set_location POWERLED.count_off[12] 5 10 4 # SB_DFFE (LogicCell: POWERLED.count_off[12]_LC_215)
set_location POWERLED.un1_count_off_1_cry_12_c 5 10 4 # SB_CARRY (LogicCell: POWERLED.count_off[12]_LC_215)
set_location POWERLED.count_off_RNO[13] 5 10 5 # SB_LUT4 (LogicCell: POWERLED.count_off[13]_LC_216)
set_location POWERLED.count_off[13] 5 10 5 # SB_DFFE (LogicCell: POWERLED.count_off[13]_LC_216)
set_location POWERLED.un1_count_off_1_cry_13_c 5 10 5 # SB_CARRY (LogicCell: POWERLED.count_off[13]_LC_216)
set_location POWERLED.count_off_RNO[14] 5 10 6 # SB_LUT4 (LogicCell: POWERLED.count_off[14]_LC_217)
set_location POWERLED.count_off[14] 5 10 6 # SB_DFFE (LogicCell: POWERLED.count_off[14]_LC_217)
set_location POWERLED.un1_count_off_1_cry_14_c 5 10 6 # SB_CARRY (LogicCell: POWERLED.count_off[14]_LC_217)
set_location POWERLED.count_off_RNO[15] 5 10 7 # SB_LUT4 (LogicCell: POWERLED.count_off[15]_LC_218)
set_location POWERLED.count_off[15] 5 10 7 # SB_DFFE (LogicCell: POWERLED.count_off[15]_LC_218)
set_location POWERLED.count_off_RNO[2] 5 9 2 # SB_LUT4 (LogicCell: POWERLED.count_off[2]_LC_219)
set_location POWERLED.count_off[2] 5 9 2 # SB_DFFE (LogicCell: POWERLED.count_off[2]_LC_219)
set_location POWERLED.un1_count_off_1_cry_2_c 5 9 2 # SB_CARRY (LogicCell: POWERLED.count_off[2]_LC_219)
set_location POWERLED.count_off_RNO[3] 5 9 3 # SB_LUT4 (LogicCell: POWERLED.count_off[3]_LC_220)
set_location POWERLED.count_off[3] 5 9 3 # SB_DFFE (LogicCell: POWERLED.count_off[3]_LC_220)
set_location POWERLED.un1_count_off_1_cry_3_c 5 9 3 # SB_CARRY (LogicCell: POWERLED.count_off[3]_LC_220)
set_location POWERLED.count_off_RNO[4] 5 9 4 # SB_LUT4 (LogicCell: POWERLED.count_off[4]_LC_221)
set_location POWERLED.count_off[4] 5 9 4 # SB_DFFE (LogicCell: POWERLED.count_off[4]_LC_221)
set_location POWERLED.un1_count_off_1_cry_4_c 5 9 4 # SB_CARRY (LogicCell: POWERLED.count_off[4]_LC_221)
set_location POWERLED.count_off_RNO[5] 5 9 5 # SB_LUT4 (LogicCell: POWERLED.count_off[5]_LC_222)
set_location POWERLED.count_off[5] 5 9 5 # SB_DFFE (LogicCell: POWERLED.count_off[5]_LC_222)
set_location POWERLED.un1_count_off_1_cry_5_c 5 9 5 # SB_CARRY (LogicCell: POWERLED.count_off[5]_LC_222)
set_location POWERLED.count_off_RNO[6] 5 9 6 # SB_LUT4 (LogicCell: POWERLED.count_off[6]_LC_223)
set_location POWERLED.count_off[6] 5 9 6 # SB_DFFE (LogicCell: POWERLED.count_off[6]_LC_223)
set_location POWERLED.un1_count_off_1_cry_6_c 5 9 6 # SB_CARRY (LogicCell: POWERLED.count_off[6]_LC_223)
set_location POWERLED.count_off_RNO[7] 5 9 7 # SB_LUT4 (LogicCell: POWERLED.count_off[7]_LC_224)
set_location POWERLED.count_off[7] 5 9 7 # SB_DFFE (LogicCell: POWERLED.count_off[7]_LC_224)
set_location POWERLED.un1_count_off_1_cry_7_c 5 9 7 # SB_CARRY (LogicCell: POWERLED.count_off[7]_LC_224)
set_location POWERLED.count_off_RNO[8] 5 10 0 # SB_LUT4 (LogicCell: POWERLED.count_off[8]_LC_225)
set_location POWERLED.count_off[8] 5 10 0 # SB_DFFE (LogicCell: POWERLED.count_off[8]_LC_225)
set_location POWERLED.un1_count_off_1_cry_8_c 5 10 0 # SB_CARRY (LogicCell: POWERLED.count_off[8]_LC_225)
set_location POWERLED.count_off_RNO[9] 5 10 1 # SB_LUT4 (LogicCell: POWERLED.count_off[9]_LC_226)
set_location POWERLED.count_off[9] 5 10 1 # SB_DFFE (LogicCell: POWERLED.count_off[9]_LC_226)
set_location POWERLED.un1_count_off_1_cry_9_c 5 10 1 # SB_CARRY (LogicCell: POWERLED.count_off[9]_LC_226)
set_location POWERLED.curr_state_RNI75RB5[0] 4 15 5 # SB_LUT4 (LogicCell: POWERLED.curr_state_RNI75RB5[0]_LC_227)
set_location POWERLED.curr_state_RNO[0] 1 15 6 # SB_LUT4 (LogicCell: POWERLED.curr_state[0]_LC_228)
set_location POWERLED.curr_state[0] 1 15 6 # SB_DFFE (LogicCell: POWERLED.curr_state[0]_LC_228)
set_location POWERLED.dutycycle_RNI16B71[5] 5 5 1 # SB_LUT4 (LogicCell: POWERLED.dutycycle_RNI16B71[5]_LC_229)
set_location POWERLED.dutycycle_RNI1VLG[10] 6 9 3 # SB_LUT4 (LogicCell: POWERLED.dutycycle_RNI1VLG[10]_LC_230)
set_location POWERLED.dutycycle_RNI2V0P[10] 6 8 5 # SB_LUT4 (LogicCell: POWERLED.dutycycle_RNI2V0P[10]_LC_231)
set_location POWERLED.dutycycle_RNI31MG_0[12] 7 5 2 # SB_LUT4 (LogicCell: POWERLED.dutycycle_RNI31MG_0[12]_LC_232)
set_location POWERLED.dutycycle_RNI31MG[12] 7 5 3 # SB_LUT4 (LogicCell: POWERLED.dutycycle_RNI31MG[12]_LC_233)
set_location POWERLED.dutycycle_RNI34C41[8] 7 5 5 # SB_LUT4 (LogicCell: POWERLED.dutycycle_RNI34C41[8]_LC_234)
set_location POWERLED.dutycycle_RNI3T7Q4[5] 6 11 3 # SB_LUT4 (LogicCell: POWERLED.dutycycle_RNI3T7Q4[5]_LC_235)
set_location POWERLED.dutycycle_RNI4I7Q_0[5] 5 8 0 # SB_LUT4 (LogicCell: POWERLED.dutycycle_RNI4I7Q_0[5]_LC_236)
set_location POWERLED.dutycycle_RNI4I7Q[5] 7 6 0 # SB_LUT4 (LogicCell: POWERLED.dutycycle_RNI4I7Q[5]_LC_237)
set_location POWERLED.dutycycle_RNI51C11[10] 8 8 2 # SB_LUT4 (LogicCell: POWERLED.dutycycle_RNI51C11[10]_LC_238)
set_location POWERLED.dutycycle_RNI53MG[14] 6 7 4 # SB_LUT4 (LogicCell: POWERLED.dutycycle_RNI53MG[14]_LC_239)
set_location POWERLED.dutycycle_RNI5J285[5] 6 10 7 # SB_LUT4 (LogicCell: POWERLED.dutycycle_RNI5J285[5]_LC_240)
set_location POWERLED.dutycycle_RNI6NI81[5] 5 8 2 # SB_LUT4 (LogicCell: POWERLED.dutycycle_RNI6NI81[5]_LC_241)
set_location POWERLED.dutycycle_RNI712I1[15] 6 8 6 # SB_LUT4 (LogicCell: POWERLED.dutycycle_RNI712I1[15]_LC_242)
set_location POWERLED.dutycycle_RNI73C11[15] 6 9 7 # SB_LUT4 (LogicCell: POWERLED.dutycycle_RNI73C11[15]_LC_243)
set_location POWERLED.dutycycle_RNI75MG[15] 6 8 0 # SB_LUT4 (LogicCell: POWERLED.dutycycle_RNI75MG[15]_LC_244)
set_location POWERLED.dutycycle_RNI84C11[14] 6 7 6 # SB_LUT4 (LogicCell: POWERLED.dutycycle_RNI84C11[14]_LC_245)
set_location POWERLED.dutycycle_RNI8M7Q[2] 7 5 1 # SB_LUT4 (LogicCell: POWERLED.dutycycle_RNI8M7Q[2]_LC_246)
set_location POWERLED.dutycycle_RNIB1FL[8] 6 7 7 # SB_LUT4 (LogicCell: POWERLED.dutycycle_RNIB1FL[8]_LC_247)
set_location POWERLED.dutycycle_RNIC8C11[15] 6 9 6 # SB_LUT4 (LogicCell: POWERLED.dutycycle_RNIC8C11[15]_LC_248)
set_location POWERLED.dutycycle_RNIE4FL[9] 6 7 3 # SB_LUT4 (LogicCell: POWERLED.dutycycle_RNIE4FL[9]_LC_249)
set_location POWERLED.dutycycle_RNIEJ021[4] 5 5 5 # SB_LUT4 (LogicCell: POWERLED.dutycycle_RNIEJ021[4]_LC_250)
set_location POWERLED.dutycycle_RNIF3561[9] 6 9 4 # SB_LUT4 (LogicCell: POWERLED.dutycycle_RNIF3561[9]_LC_251)
set_location POWERLED.dutycycle_RNIFHLJ[0] 5 6 0 # SB_LUT4 (LogicCell: POWERLED.dutycycle_RNIFHLJ[0]_LC_252)
set_location POWERLED.dutycycle_RNIFHLJ_0[0] 5 5 0 # SB_LUT4 (LogicCell: POWERLED.dutycycle_RNIFHLJ_0[0]_LC_253)
set_location POWERLED.dutycycle_RNIH6QT[15] 8 8 5 # SB_LUT4 (LogicCell: POWERLED.dutycycle_RNIH6QT[15]_LC_254)
set_location POWERLED.dutycycle_RNIJL1R1[6] 6 8 3 # SB_LUT4 (LogicCell: POWERLED.dutycycle_RNIJL1R1[6]_LC_255)
set_location POWERLED.dutycycle_RNIJNBA1[6] 5 8 6 # SB_LUT4 (LogicCell: POWERLED.dutycycle_RNIJNBA1[6]_LC_256)
set_location POWERLED.dutycycle_RNIK4I81[6] 7 6 2 # SB_LUT4 (LogicCell: POWERLED.dutycycle_RNIK4I81[6]_LC_257)
set_location POWERLED.dutycycle_RNIM0TE[8] 6 8 1 # SB_LUT4 (LogicCell: POWERLED.dutycycle_RNIM0TE[8]_LC_258)
set_location POWERLED.dutycycle_RNIO18N[9] 8 8 0 # SB_LUT4 (LogicCell: POWERLED.dutycycle_RNIO18N[9]_LC_259)
set_location POWERLED.dutycycle_RNIO2TE[9] 7 5 4 # SB_LUT4 (LogicCell: POWERLED.dutycycle_RNIO2TE[9]_LC_260)
set_location POWERLED.dutycycle_RNIOQLJ[4] 7 6 6 # SB_LUT4 (LogicCell: POWERLED.dutycycle_RNIOQLJ[4]_LC_261)
set_location POWERLED.dutycycle_RNIQ09G1[10] 6 8 7 # SB_LUT4 (LogicCell: POWERLED.dutycycle_RNIQ09G1[10]_LC_262)
set_location POWERLED.dutycycle_RNIQAI81[4] 7 6 5 # SB_LUT4 (LogicCell: POWERLED.dutycycle_RNIQAI81[4]_LC_263)
set_location POWERLED.dutycycle_RNITEUV5[5] 6 11 4 # SB_LUT4 (LogicCell: POWERLED.dutycycle_RNITEUV5[5]_LC_264)
set_location POWERLED.dutycycle_RNIUTDP2[2] 8 8 6 # SB_LUT4 (LogicCell: POWERLED.dutycycle_RNIUTDP2[2]_LC_265)
set_location POWERLED.dutycycle_RNIUUB41[6] 6 8 2 # SB_LUT4 (LogicCell: POWERLED.dutycycle_RNIUUB41[6]_LC_266)
set_location POWERLED.dutycycle_RNIVL3D[0] 6 5 0 # SB_LUT4 (LogicCell: POWERLED.dutycycle_RNIVL3D[0]_LC_267)
set_location POWERLED.un1_dutycycle_1_cry_0_c 6 5 0 # SB_CARRY (LogicCell: POWERLED.dutycycle_RNIVL3D[0]_LC_267)
set_location POWERLED.dutycycle_RNO[0] 5 6 5 # SB_LUT4 (LogicCell: POWERLED.dutycycle[0]_LC_268)
set_location POWERLED.dutycycle[0] 5 6 5 # SB_DFFE (LogicCell: POWERLED.dutycycle[0]_LC_268)
set_location POWERLED.dutycycle_RNO_0[0] 7 7 1 # SB_LUT4 (LogicCell: POWERLED.dutycycle_RNO_0[0]_LC_269)
set_location POWERLED.dutycycle_cry_c[0] 7 7 1 # SB_CARRY (LogicCell: POWERLED.dutycycle_RNO_0[0]_LC_269)
set_location POWERLED.dutycycle_RNO_0[1] 7 7 2 # SB_LUT4 (LogicCell: POWERLED.dutycycle_RNO_0[1]_LC_270)
set_location POWERLED.dutycycle_cry_c[1] 7 7 2 # SB_CARRY (LogicCell: POWERLED.dutycycle_RNO_0[1]_LC_270)
set_location POWERLED.dutycycle_RNO_0[2] 6 9 0 # SB_LUT4 (LogicCell: POWERLED.dutycycle_RNO_0[2]_LC_271)
set_location POWERLED.dutycycle_RNO[1] 5 6 2 # SB_LUT4 (LogicCell: POWERLED.dutycycle[1]_LC_272)
set_location POWERLED.dutycycle[1] 5 6 2 # SB_DFFE (LogicCell: POWERLED.dutycycle[1]_LC_272)
set_location POWERLED.dutycycle_RNO[10] 7 8 3 # SB_LUT4 (LogicCell: POWERLED.dutycycle[10]_LC_273)
set_location POWERLED.dutycycle[10] 7 8 3 # SB_DFFE (LogicCell: POWERLED.dutycycle[10]_LC_273)
set_location POWERLED.dutycycle_cry_c[10] 7 8 3 # SB_CARRY (LogicCell: POWERLED.dutycycle[10]_LC_273)
set_location POWERLED.dutycycle_RNO[11] 7 8 4 # SB_LUT4 (LogicCell: POWERLED.dutycycle[11]_LC_274)
set_location POWERLED.dutycycle[11] 7 8 4 # SB_DFFE (LogicCell: POWERLED.dutycycle[11]_LC_274)
set_location POWERLED.dutycycle_cry_c[11] 7 8 4 # SB_CARRY (LogicCell: POWERLED.dutycycle[11]_LC_274)
set_location POWERLED.dutycycle_RNO[12] 7 8 5 # SB_LUT4 (LogicCell: POWERLED.dutycycle[12]_LC_275)
set_location POWERLED.dutycycle[12] 7 8 5 # SB_DFFE (LogicCell: POWERLED.dutycycle[12]_LC_275)
set_location POWERLED.dutycycle_cry_c[12] 7 8 5 # SB_CARRY (LogicCell: POWERLED.dutycycle[12]_LC_275)
set_location POWERLED.dutycycle_RNO[13] 7 8 6 # SB_LUT4 (LogicCell: POWERLED.dutycycle[13]_LC_276)
set_location POWERLED.dutycycle[13] 7 8 6 # SB_DFFE (LogicCell: POWERLED.dutycycle[13]_LC_276)
set_location POWERLED.dutycycle_cry_c[13] 7 8 6 # SB_CARRY (LogicCell: POWERLED.dutycycle[13]_LC_276)
set_location POWERLED.dutycycle_RNO[14] 7 8 7 # SB_LUT4 (LogicCell: POWERLED.dutycycle[14]_LC_277)
set_location POWERLED.dutycycle[14] 7 8 7 # SB_DFFE (LogicCell: POWERLED.dutycycle[14]_LC_277)
set_location POWERLED.dutycycle_cry_c[14] 7 8 7 # SB_CARRY (LogicCell: POWERLED.dutycycle[14]_LC_277)
set_location POWERLED.dutycycle_RNO[15] 7 9 0 # SB_LUT4 (LogicCell: POWERLED.dutycycle[15]_LC_278)
set_location POWERLED.dutycycle[15] 7 9 0 # SB_DFFE (LogicCell: POWERLED.dutycycle[15]_LC_278)
set_location POWERLED.dutycycle_RNO_1[2] 7 7 3 # SB_LUT4 (LogicCell: POWERLED.dutycycle_RNO_1[2]_LC_279)
set_location POWERLED.dutycycle_cry_c[2] 7 7 3 # SB_CARRY (LogicCell: POWERLED.dutycycle_RNO_1[2]_LC_279)
set_location POWERLED.dutycycle_RNO[2] 7 6 3 # SB_LUT4 (LogicCell: POWERLED.dutycycle[2]_LC_280)
set_location POWERLED.dutycycle[2] 7 6 3 # SB_DFFE (LogicCell: POWERLED.dutycycle[2]_LC_280)
set_location POWERLED.dutycycle_RNO[3] 7 7 4 # SB_LUT4 (LogicCell: POWERLED.dutycycle[3]_LC_281)
set_location POWERLED.dutycycle[3] 7 7 4 # SB_DFFE (LogicCell: POWERLED.dutycycle[3]_LC_281)
set_location POWERLED.dutycycle_cry_c[3] 7 7 4 # SB_CARRY (LogicCell: POWERLED.dutycycle[3]_LC_281)
set_location POWERLED.dutycycle_RNO[4] 7 7 5 # SB_LUT4 (LogicCell: POWERLED.dutycycle[4]_LC_282)
set_location POWERLED.dutycycle[4] 7 7 5 # SB_DFFE (LogicCell: POWERLED.dutycycle[4]_LC_282)
set_location POWERLED.dutycycle_cry_c[4] 7 7 5 # SB_CARRY (LogicCell: POWERLED.dutycycle[4]_LC_282)
set_location POWERLED.dutycycle_RNO[5] 5 8 1 # SB_LUT4 (LogicCell: POWERLED.dutycycle[5]_LC_283)
set_location POWERLED.dutycycle[5] 5 8 1 # SB_DFFE (LogicCell: POWERLED.dutycycle[5]_LC_283)
set_location POWERLED.dutycycle_RNO[6] 5 8 3 # SB_LUT4 (LogicCell: POWERLED.dutycycle[6]_LC_284)
set_location POWERLED.dutycycle[6] 5 8 3 # SB_DFFE (LogicCell: POWERLED.dutycycle[6]_LC_284)
set_location POWERLED.dutycycle_RNO[7] 7 8 0 # SB_LUT4 (LogicCell: POWERLED.dutycycle[7]_LC_285)
set_location POWERLED.dutycycle[7] 7 8 0 # SB_DFFE (LogicCell: POWERLED.dutycycle[7]_LC_285)
set_location POWERLED.dutycycle_cry_c[7] 7 8 0 # SB_CARRY (LogicCell: POWERLED.dutycycle[7]_LC_285)
set_location POWERLED.dutycycle_RNO[8] 7 8 1 # SB_LUT4 (LogicCell: POWERLED.dutycycle[8]_LC_286)
set_location POWERLED.dutycycle[8] 7 8 1 # SB_DFFE (LogicCell: POWERLED.dutycycle[8]_LC_286)
set_location POWERLED.dutycycle_cry_c[8] 7 8 1 # SB_CARRY (LogicCell: POWERLED.dutycycle[8]_LC_286)
set_location POWERLED.dutycycle_RNO[9] 7 8 2 # SB_LUT4 (LogicCell: POWERLED.dutycycle[9]_LC_287)
set_location POWERLED.dutycycle[9] 7 8 2 # SB_DFFE (LogicCell: POWERLED.dutycycle[9]_LC_287)
set_location POWERLED.dutycycle_cry_c[9] 7 8 2 # SB_CARRY (LogicCell: POWERLED.dutycycle[9]_LC_287)
set_location POWERLED.dutycycle_cry_c_RNI1C5M9[5] 7 7 7 # SB_LUT4 (LogicCell: POWERLED.dutycycle_cry_c_RNI1C5M9[5]_LC_288)
set_location POWERLED.dutycycle_cry_c[6] 7 7 7 # SB_CARRY (LogicCell: POWERLED.dutycycle_cry_c_RNI1C5M9[5]_LC_288)
set_location POWERLED.dutycycle_cry_c_RNIV95M9[4] 7 7 6 # SB_LUT4 (LogicCell: POWERLED.dutycycle_cry_c_RNIV95M9[4]_LC_289)
set_location POWERLED.dutycycle_cry_c[5] 7 7 6 # SB_CARRY (LogicCell: POWERLED.dutycycle_cry_c_RNIV95M9[4]_LC_289)
set_location POWERLED.dutycycle_fast_RNI2GSK[6] 6 7 5 # SB_LUT4 (LogicCell: POWERLED.dutycycle_fast_RNI2GSK[6]_LC_290)
set_location POWERLED.dutycycle_fast_RNI8MSK[5] 6 7 2 # SB_LUT4 (LogicCell: POWERLED.dutycycle_fast_RNI8MSK[5]_LC_291)
set_location POWERLED.dutycycle_fast_RNIBPSK[6] 6 8 4 # SB_LUT4 (LogicCell: POWERLED.dutycycle_fast_RNIBPSK[6]_LC_292)
set_location POWERLED.dutycycle_fast_RNILMLM[6] 5 8 7 # SB_LUT4 (LogicCell: POWERLED.dutycycle_fast_RNILMLM[6]_LC_293)
set_location POWERLED.dutycycle_fast_RNIMOAE[5] 5 5 4 # SB_LUT4 (LogicCell: POWERLED.dutycycle_fast_RNIMOAE[5]_LC_294)
set_location POWERLED.dutycycle_fast_RNIVCSK[5] 5 6 6 # SB_LUT4 (LogicCell: POWERLED.dutycycle_fast_RNIVCSK[5]_LC_295)
set_location POWERLED.dutycycle_fast_RNO[5] 5 6 7 # SB_LUT4 (LogicCell: POWERLED.dutycycle_fast[5]_LC_296)
set_location POWERLED.dutycycle_fast[5] 5 6 7 # SB_DFFE (LogicCell: POWERLED.dutycycle_fast[5]_LC_296)
set_location POWERLED.dutycycle_fast_RNO[6] 5 8 4 # SB_LUT4 (LogicCell: POWERLED.dutycycle_fast[6]_LC_297)
set_location POWERLED.dutycycle_fast[6] 5 8 4 # SB_DFFE (LogicCell: POWERLED.dutycycle_fast[6]_LC_297)
set_location POWERLED.func_state_RNI0AN05[0] 6 11 7 # SB_LUT4 (LogicCell: POWERLED.func_state_RNI0AN05[0]_LC_298)
set_location POWERLED.func_state_RNI0AN05_0[0] 6 11 0 # SB_LUT4 (LogicCell: POWERLED.func_state_RNI0AN05_0[0]_LC_299)
set_location POWERLED.func_state_RNI1UHM1[0] 6 11 2 # SB_LUT4 (LogicCell: POWERLED.func_state_RNI1UHM1[0]_LC_300)
set_location POWERLED.func_state_RNI33DK1[1] 7 10 0 # SB_LUT4 (LogicCell: POWERLED.func_state_RNI33DK1[1]_LC_301)
set_location POWERLED.func_state_RNI6KL57[0] 7 11 6 # SB_LUT4 (LogicCell: POWERLED.func_state_RNI6KL57[0]_LC_302)
set_location POWERLED.func_state_RNI9HME_0[1] 7 12 0 # SB_LUT4 (LogicCell: POWERLED.func_state_RNI9HME_0[1]_LC_303)
set_location POWERLED.func_state_RNI9HME[1] 6 11 5 # SB_LUT4 (LogicCell: POWERLED.func_state_RNI9HME[1]_LC_304)
set_location POWERLED.func_state_RNI9LL3G[1] 5 11 6 # SB_LUT4 (LogicCell: POWERLED.func_state_RNI9LL3G[1]_LC_305)
set_location POWERLED.func_state_RNIAA8L4[0] 6 10 2 # SB_LUT4 (LogicCell: POWERLED.func_state_RNIAA8L4[0]_LC_306)
set_location POWERLED.func_state_RNIG4MR5[1] 6 10 5 # SB_LUT4 (LogicCell: POWERLED.func_state_RNIG4MR5[1]_LC_307)
set_location POWERLED.func_state_RNIH2SJ1[1] 7 11 5 # SB_LUT4 (LogicCell: POWERLED.func_state_RNIH2SJ1[1]_LC_308)
set_location POWERLED.func_state_RNIHPO9A[0] 5 11 5 # SB_LUT4 (LogicCell: POWERLED.func_state_RNIHPO9A[0]_LC_309)
set_location POWERLED.func_state_RNIIA93A[0] 6 11 6 # SB_LUT4 (LogicCell: POWERLED.func_state_RNIIA93A[0]_LC_310)
set_location POWERLED.func_state_RNINTA34[1] 7 11 3 # SB_LUT4 (LogicCell: POWERLED.func_state_RNINTA34[1]_LC_311)
set_location POWERLED.func_state_RNIORSP5[1] 7 10 7 # SB_LUT4 (LogicCell: POWERLED.func_state_RNIORSP5[1]_LC_312)
set_location POWERLED.func_state_RNIROMF7[0] 8 9 1 # SB_LUT4 (LogicCell: POWERLED.func_state_RNIROMF7[0]_LC_313)
set_location POWERLED.func_state_RNIS9OC3[1] 7 10 1 # SB_LUT4 (LogicCell: POWERLED.func_state_RNIS9OC3[1]_LC_314)
set_location POWERLED.func_state_RNIUIEUK[1] 7 11 4 # SB_LUT4 (LogicCell: POWERLED.func_state_RNIUIEUK[1]_LC_315)
set_location POWERLED.func_state_RNIV4PD6[1] 4 10 1 # SB_LUT4 (LogicCell: POWERLED.func_state_RNIV4PD6[1]_LC_316)
set_location POWERLED.func_state_RNO[0] 6 13 5 # SB_LUT4 (LogicCell: POWERLED.func_state[0]_LC_317)
set_location POWERLED.func_state[0] 6 13 5 # SB_DFFE (LogicCell: POWERLED.func_state[0]_LC_317)
set_location POWERLED.func_state_RNO_0[0] 6 12 7 # SB_LUT4 (LogicCell: POWERLED.func_state_RNO_0[0]_LC_318)
set_location POWERLED.func_state_RNO_0[1] 6 12 6 # SB_LUT4 (LogicCell: POWERLED.func_state_RNO_0[1]_LC_319)
set_location POWERLED.func_state_RNO[1] 5 12 1 # SB_LUT4 (LogicCell: POWERLED.func_state[1]_LC_320)
set_location POWERLED.func_state[1] 5 12 1 # SB_DFFE (LogicCell: POWERLED.func_state[1]_LC_320)
set_location POWERLED.func_state_RNO_1[0] 6 12 1 # SB_LUT4 (LogicCell: POWERLED.func_state_RNO_1[0]_LC_321)
set_location POWERLED.func_state_RNO_1[1] 6 12 3 # SB_LUT4 (LogicCell: POWERLED.func_state_RNO_1[1]_LC_322)
set_location POWERLED.func_state_RNO_2[0] 6 11 1 # SB_LUT4 (LogicCell: POWERLED.func_state_RNO_2[0]_LC_323)
set_location POWERLED.func_state_RNO_2[1] 6 12 5 # SB_LUT4 (LogicCell: POWERLED.func_state_RNO_2[1]_LC_324)
set_location POWERLED.func_state_RNO_3[1] 6 12 2 # SB_LUT4 (LogicCell: POWERLED.func_state_RNO_3[1]_LC_325)
set_location POWERLED.func_state_RNO_4[1] 7 12 4 # SB_LUT4 (LogicCell: POWERLED.func_state_RNO_4[1]_LC_326)
set_location POWERLED.func_state_ns_0_i_0_0_a2_0[0] 6 12 4 # SB_LUT4 (LogicCell: POWERLED.func_state_ns_0_i_0_0_a2_0[0]_LC_327)
set_location POWERLED.pwm_out_RNO 2 15 1 # SB_LUT4 (LogicCell: POWERLED.pwm_out_RNO_LC_328)
set_location POWERLED.pwm_out_RNO_0 4 14 2 # SB_LUT4 (LogicCell: POWERLED.pwm_out_RNO_0_LC_329)
set_location POWERLED.pwm_out_RNO_1 4 14 5 # SB_LUT4 (LogicCell: POWERLED.pwm_out_RNO_1_LC_330)
set_location POWERLED.pwm_out_RNO_2 4 14 1 # SB_LUT4 (LogicCell: POWERLED.pwm_out_RNO_2_LC_331)
set_location POWERLED.pwm_out_RNO_3 4 15 2 # SB_LUT4 (LogicCell: POWERLED.pwm_out_RNO_3_LC_332)
set_location POWERLED.pwm_out_RNO_4 4 14 0 # SB_LUT4 (LogicCell: POWERLED.pwm_out_RNO_4_LC_333)
set_location POWERLED.un1_count_2_cry_0_c_inv 2 13 0 # SB_LUT4 (LogicCell: POWERLED.un1_count_2_cry_0_c_inv_LC_334)
set_location POWERLED.un1_count_2_cry_0_c 2 13 0 # SB_CARRY (LogicCell: POWERLED.un1_count_2_cry_0_c_inv_LC_334)
set_location POWERLED.un1_count_2_cry_10_c_inv 2 14 2 # SB_LUT4 (LogicCell: POWERLED.un1_count_2_cry_10_c_inv_LC_335)
set_location POWERLED.un1_count_2_cry_10_c 2 14 2 # SB_CARRY (LogicCell: POWERLED.un1_count_2_cry_10_c_inv_LC_335)
set_location POWERLED.un1_count_2_cry_11_c_inv 2 14 3 # SB_LUT4 (LogicCell: POWERLED.un1_count_2_cry_11_c_inv_LC_336)
set_location POWERLED.un1_count_2_cry_11_c 2 14 3 # SB_CARRY (LogicCell: POWERLED.un1_count_2_cry_11_c_inv_LC_336)
set_location POWERLED.un1_count_2_cry_12_c_inv 2 14 4 # SB_LUT4 (LogicCell: POWERLED.un1_count_2_cry_12_c_inv_LC_337)
set_location POWERLED.un1_count_2_cry_12_c 2 14 4 # SB_CARRY (LogicCell: POWERLED.un1_count_2_cry_12_c_inv_LC_337)
set_location POWERLED.un1_count_2_cry_13_c_inv 2 14 5 # SB_LUT4 (LogicCell: POWERLED.un1_count_2_cry_13_c_inv_LC_338)
set_location POWERLED.un1_count_2_cry_13_c 2 14 5 # SB_CARRY (LogicCell: POWERLED.un1_count_2_cry_13_c_inv_LC_338)
set_location POWERLED.un1_count_2_cry_14_c_inv 2 14 6 # SB_LUT4 (LogicCell: POWERLED.un1_count_2_cry_14_c_inv_LC_339)
set_location POWERLED.un1_count_2_cry_14_c 2 14 6 # SB_CARRY (LogicCell: POWERLED.un1_count_2_cry_14_c_inv_LC_339)
set_location POWERLED.un1_count_2_cry_15_c_inv 2 14 7 # SB_LUT4 (LogicCell: POWERLED.un1_count_2_cry_15_c_inv_LC_340)
set_location POWERLED.un1_count_2_cry_15_c 2 14 7 # SB_CARRY (LogicCell: POWERLED.un1_count_2_cry_15_c_inv_LC_340)
set_location POWERLED.un1_count_2_cry_1_c_inv 2 13 1 # SB_LUT4 (LogicCell: POWERLED.un1_count_2_cry_1_c_inv_LC_341)
set_location POWERLED.un1_count_2_cry_1_c 2 13 1 # SB_CARRY (LogicCell: POWERLED.un1_count_2_cry_1_c_inv_LC_341)
set_location POWERLED.un1_count_2_cry_2_c_inv 2 13 2 # SB_LUT4 (LogicCell: POWERLED.un1_count_2_cry_2_c_inv_LC_342)
set_location POWERLED.un1_count_2_cry_2_c 2 13 2 # SB_CARRY (LogicCell: POWERLED.un1_count_2_cry_2_c_inv_LC_342)
set_location POWERLED.un1_count_2_cry_3_c_inv 2 13 3 # SB_LUT4 (LogicCell: POWERLED.un1_count_2_cry_3_c_inv_LC_343)
set_location POWERLED.un1_count_2_cry_3_c 2 13 3 # SB_CARRY (LogicCell: POWERLED.un1_count_2_cry_3_c_inv_LC_343)
set_location POWERLED.un1_count_2_cry_4_c_inv 2 13 4 # SB_LUT4 (LogicCell: POWERLED.un1_count_2_cry_4_c_inv_LC_344)
set_location POWERLED.un1_count_2_cry_4_c 2 13 4 # SB_CARRY (LogicCell: POWERLED.un1_count_2_cry_4_c_inv_LC_344)
set_location POWERLED.un1_count_2_cry_5_c_inv 2 13 5 # SB_LUT4 (LogicCell: POWERLED.un1_count_2_cry_5_c_inv_LC_345)
set_location POWERLED.un1_count_2_cry_5_c 2 13 5 # SB_CARRY (LogicCell: POWERLED.un1_count_2_cry_5_c_inv_LC_345)
set_location POWERLED.un1_count_2_cry_6_c_inv 2 13 6 # SB_LUT4 (LogicCell: POWERLED.un1_count_2_cry_6_c_inv_LC_346)
set_location POWERLED.un1_count_2_cry_6_c 2 13 6 # SB_CARRY (LogicCell: POWERLED.un1_count_2_cry_6_c_inv_LC_346)
set_location POWERLED.un1_count_2_cry_7_c_inv 2 13 7 # SB_LUT4 (LogicCell: POWERLED.un1_count_2_cry_7_c_inv_LC_347)
set_location POWERLED.un1_count_2_cry_7_c 2 13 7 # SB_CARRY (LogicCell: POWERLED.un1_count_2_cry_7_c_inv_LC_347)
set_location POWERLED.un1_count_2_cry_8_c_inv 2 14 0 # SB_LUT4 (LogicCell: POWERLED.un1_count_2_cry_8_c_inv_LC_348)
set_location POWERLED.un1_count_2_cry_8_c 2 14 0 # SB_CARRY (LogicCell: POWERLED.un1_count_2_cry_8_c_inv_LC_348)
set_location POWERLED.un1_count_2_cry_9_c_inv 2 14 1 # SB_LUT4 (LogicCell: POWERLED.un1_count_2_cry_9_c_inv_LC_349)
set_location POWERLED.un1_count_2_cry_9_c 2 14 1 # SB_CARRY (LogicCell: POWERLED.un1_count_2_cry_9_c_inv_LC_349)
set_location POWERLED.un1_dutycycle_1_cry_0_c_RNIM8QV 6 5 1 # SB_LUT4 (LogicCell: POWERLED.un1_dutycycle_1_cry_0_c_RNIM8QV_LC_350)
set_location POWERLED.un1_dutycycle_1_cry_1_c 6 5 1 # SB_CARRY (LogicCell: POWERLED.un1_dutycycle_1_cry_0_c_RNIM8QV_LC_350)
set_location POWERLED.un1_dutycycle_1_cry_10_c_RNIA3U72 6 6 3 # SB_LUT4 (LogicCell: POWERLED.un1_dutycycle_1_cry_10_c_RNIA3U72_LC_351)
set_location POWERLED.un1_dutycycle_1_cry_11_c 6 6 3 # SB_CARRY (LogicCell: POWERLED.un1_dutycycle_1_cry_10_c_RNIA3U72_LC_351)
set_location POWERLED.un1_dutycycle_1_cry_11_c_RNI23HB2 6 6 4 # SB_LUT4 (LogicCell: POWERLED.un1_dutycycle_1_cry_11_c_RNI23HB2_LC_352)
set_location POWERLED.un1_dutycycle_1_cry_12_c 6 6 4 # SB_CARRY (LogicCell: POWERLED.un1_dutycycle_1_cry_11_c_RNI23HB2_LC_352)
set_location POWERLED.un1_dutycycle_1_cry_12_c_RNI49HI1 6 6 5 # SB_LUT4 (LogicCell: POWERLED.un1_dutycycle_1_cry_12_c_RNI49HI1_LC_353)
set_location POWERLED.un1_dutycycle_1_cry_13_c 6 6 5 # SB_CARRY (LogicCell: POWERLED.un1_dutycycle_1_cry_12_c_RNI49HI1_LC_353)
set_location POWERLED.un1_dutycycle_1_cry_13_c_RNI6CII1 6 6 6 # SB_LUT4 (LogicCell: POWERLED.un1_dutycycle_1_cry_13_c_RNI6CII1_LC_354)
set_location POWERLED.un1_dutycycle_1_cry_14_0_c 6 6 6 # SB_CARRY (LogicCell: POWERLED.un1_dutycycle_1_cry_13_c_RNI6CII1_LC_354)
set_location POWERLED.un1_dutycycle_1_cry_13_c_RNI6CII1_0 5 5 3 # SB_LUT4 (LogicCell: POWERLED.un1_dutycycle_1_cry_13_c_RNI6CII1_0_LC_355)
set_location POWERLED.un1_dutycycle_1_cry_14_0_c_RNIS9ES1 6 6 7 # SB_LUT4 (LogicCell: POWERLED.un1_dutycycle_1_cry_14_0_c_RNIS9ES1_LC_356)
set_location POWERLED.un1_dutycycle_1_cry_15_0_c 6 6 7 # SB_CARRY (LogicCell: POWERLED.un1_dutycycle_1_cry_14_0_c_RNIS9ES1_LC_356)
set_location POWERLED.un1_dutycycle_1_cry_14_0_c_RNIS9ES1_0 5 7 3 # SB_LUT4 (LogicCell: POWERLED.un1_dutycycle_1_cry_14_0_c_RNIS9ES1_0_LC_357)
set_location POWERLED.un1_dutycycle_1_cry_15_0_c_RNINAJ71 6 7 0 # SB_LUT4 (LogicCell: POWERLED.un1_dutycycle_1_cry_15_0_c_RNINAJ71_LC_358)
set_location POWERLED.un1_dutycycle_1_cry_16_0_c 6 7 0 # SB_CARRY (LogicCell: POWERLED.un1_dutycycle_1_cry_15_0_c_RNINAJ71_LC_358)
set_location POWERLED.un1_dutycycle_1_cry_1_c_RNIOG672 6 5 2 # SB_LUT4 (LogicCell: POWERLED.un1_dutycycle_1_cry_1_c_RNIOG672_LC_359)
set_location POWERLED.un1_dutycycle_1_cry_2_c 6 5 2 # SB_CARRY (LogicCell: POWERLED.un1_dutycycle_1_cry_1_c_RNIOG672_LC_359)
set_location POWERLED.un1_dutycycle_1_cry_2_c_RNISCL92 6 5 3 # SB_LUT4 (LogicCell: POWERLED.un1_dutycycle_1_cry_2_c_RNISCL92_LC_360)
set_location POWERLED.un1_dutycycle_1_cry_3_c 6 5 3 # SB_CARRY (LogicCell: POWERLED.un1_dutycycle_1_cry_2_c_RNISCL92_LC_360)
set_location POWERLED.un1_dutycycle_1_cry_3_c_RNI6OM92 6 5 4 # SB_LUT4 (LogicCell: POWERLED.un1_dutycycle_1_cry_3_c_RNI6OM92_LC_361)
set_location POWERLED.un1_dutycycle_1_cry_4_c 6 5 4 # SB_CARRY (LogicCell: POWERLED.un1_dutycycle_1_cry_3_c_RNI6OM92_LC_361)
set_location POWERLED.un1_dutycycle_1_cry_4_c_RNIHDV12 6 5 5 # SB_LUT4 (LogicCell: POWERLED.un1_dutycycle_1_cry_4_c_RNIHDV12_LC_362)
set_location POWERLED.un1_dutycycle_1_cry_5_c 6 5 5 # SB_CARRY (LogicCell: POWERLED.un1_dutycycle_1_cry_4_c_RNIHDV12_LC_362)
set_location POWERLED.un1_dutycycle_1_cry_5_c_RNIQEP92 6 5 6 # SB_LUT4 (LogicCell: POWERLED.un1_dutycycle_1_cry_5_c_RNIQEP92_LC_363)
set_location POWERLED.un1_dutycycle_1_cry_6_c 6 5 6 # SB_CARRY (LogicCell: POWERLED.un1_dutycycle_1_cry_5_c_RNIQEP92_LC_363)
set_location POWERLED.un1_dutycycle_1_cry_6_c_RNIBKJB2 6 5 7 # SB_LUT4 (LogicCell: POWERLED.un1_dutycycle_1_cry_6_c_RNIBKJB2_LC_364)
set_location POWERLED.un1_dutycycle_1_cry_7_c 6 5 7 # SB_CARRY (LogicCell: POWERLED.un1_dutycycle_1_cry_6_c_RNIBKJB2_LC_364)
set_location POWERLED.un1_dutycycle_1_cry_7_c_RNIMH3U2 6 6 0 # SB_LUT4 (LogicCell: POWERLED.un1_dutycycle_1_cry_7_c_RNIMH3U2_LC_365)
set_location POWERLED.un1_dutycycle_1_cry_8_c 6 6 0 # SB_CARRY (LogicCell: POWERLED.un1_dutycycle_1_cry_7_c_RNIMH3U2_LC_365)
set_location POWERLED.un1_dutycycle_1_cry_8_c_RNITC862 6 6 1 # SB_LUT4 (LogicCell: POWERLED.un1_dutycycle_1_cry_8_c_RNITC862_LC_366)
set_location POWERLED.un1_dutycycle_1_cry_9_c 6 6 1 # SB_CARRY (LogicCell: POWERLED.un1_dutycycle_1_cry_8_c_RNITC862_LC_366)
set_location POWERLED.un1_dutycycle_1_cry_9_c_RNIDH282 6 6 2 # SB_LUT4 (LogicCell: POWERLED.un1_dutycycle_1_cry_9_c_RNIDH282_LC_367)
set_location POWERLED.un1_dutycycle_1_cry_10_c 6 6 2 # SB_CARRY (LogicCell: POWERLED.un1_dutycycle_1_cry_9_c_RNIDH282_LC_367)
set_location POWERLED.un1_onclocks.if_generate_plus.mult1_un103_sum_axb_8 1 6 5 # SB_LUT4 (LogicCell: POWERLED.un1_onclocks.if_generate_plus.mult1_un103_sum_axb_8_LC_368)
set_location POWERLED.un1_onclocks.if_generate_plus.mult1_un96_sum_cry_7_c 1 6 5 # SB_CARRY (LogicCell: POWERLED.un1_onclocks.if_generate_plus.mult1_un103_sum_axb_8_LC_368)
set_location POWERLED.un1_onclocks.if_generate_plus.mult1_un103_sum_cry_3_s 1 7 1 # SB_LUT4 (LogicCell: POWERLED.un1_onclocks.if_generate_plus.mult1_un103_sum_cry_3_s_LC_369)
set_location POWERLED.un1_onclocks.if_generate_plus.mult1_un103_sum_cry_3_c 1 7 1 # SB_CARRY (LogicCell: POWERLED.un1_onclocks.if_generate_plus.mult1_un103_sum_cry_3_s_LC_369)
set_location POWERLED.un1_onclocks.if_generate_plus.mult1_un103_sum_cry_4_s 1 7 2 # SB_LUT4 (LogicCell: POWERLED.un1_onclocks.if_generate_plus.mult1_un103_sum_cry_4_s_LC_370)
set_location POWERLED.un1_onclocks.if_generate_plus.mult1_un103_sum_cry_4_c 1 7 2 # SB_CARRY (LogicCell: POWERLED.un1_onclocks.if_generate_plus.mult1_un103_sum_cry_4_s_LC_370)
set_location POWERLED.un1_onclocks.if_generate_plus.mult1_un103_sum_cry_5_s 1 7 3 # SB_LUT4 (LogicCell: POWERLED.un1_onclocks.if_generate_plus.mult1_un103_sum_cry_5_s_LC_371)
set_location POWERLED.un1_onclocks.if_generate_plus.mult1_un103_sum_cry_5_c 1 7 3 # SB_CARRY (LogicCell: POWERLED.un1_onclocks.if_generate_plus.mult1_un103_sum_cry_5_s_LC_371)
set_location POWERLED.un1_onclocks.if_generate_plus.mult1_un103_sum_cry_6_s 1 7 4 # SB_LUT4 (LogicCell: POWERLED.un1_onclocks.if_generate_plus.mult1_un103_sum_cry_6_s_LC_372)
set_location POWERLED.un1_onclocks.if_generate_plus.mult1_un103_sum_cry_6_c 1 7 4 # SB_CARRY (LogicCell: POWERLED.un1_onclocks.if_generate_plus.mult1_un103_sum_cry_6_s_LC_372)
set_location POWERLED.un1_onclocks.if_generate_plus.mult1_un103_sum_i 2 8 5 # SB_LUT4 (LogicCell: POWERLED.un1_onclocks.if_generate_plus.mult1_un103_sum_i_LC_373)
set_location POWERLED.un1_onclocks.if_generate_plus.mult1_un103_sum_i[8] 2 8 6 # SB_LUT4 (LogicCell: POWERLED.un1_onclocks.if_generate_plus.mult1_un103_sum_i[8]_LC_374)
set_location POWERLED.un1_onclocks.if_generate_plus.mult1_un103_sum_s_8 1 7 6 # SB_LUT4 (LogicCell: POWERLED.un1_onclocks.if_generate_plus.mult1_un103_sum_s_8_LC_375)
set_location POWERLED.un1_onclocks.if_generate_plus.mult1_un103_sum_sbtinv[8] 1 7 7 # SB_LUT4 (LogicCell: POWERLED.un1_onclocks.if_generate_plus.mult1_un103_sum_sbtinv[8]_LC_376)
set_location POWERLED.un1_onclocks.if_generate_plus.mult1_un110_sum_axb_8 1 7 5 # SB_LUT4 (LogicCell: POWERLED.un1_onclocks.if_generate_plus.mult1_un110_sum_axb_8_LC_377)
set_location POWERLED.un1_onclocks.if_generate_plus.mult1_un103_sum_cry_7_c 1 7 5 # SB_CARRY (LogicCell: POWERLED.un1_onclocks.if_generate_plus.mult1_un110_sum_axb_8_LC_377)
set_location POWERLED.un1_onclocks.if_generate_plus.mult1_un110_sum_cry_3_s 1 8 1 # SB_LUT4 (LogicCell: POWERLED.un1_onclocks.if_generate_plus.mult1_un110_sum_cry_3_s_LC_378)
set_location POWERLED.un1_onclocks.if_generate_plus.mult1_un110_sum_cry_3_c 1 8 1 # SB_CARRY (LogicCell: POWERLED.un1_onclocks.if_generate_plus.mult1_un110_sum_cry_3_s_LC_378)
set_location POWERLED.un1_onclocks.if_generate_plus.mult1_un110_sum_cry_4_s 1 8 2 # SB_LUT4 (LogicCell: POWERLED.un1_onclocks.if_generate_plus.mult1_un110_sum_cry_4_s_LC_379)
set_location POWERLED.un1_onclocks.if_generate_plus.mult1_un110_sum_cry_4_c 1 8 2 # SB_CARRY (LogicCell: POWERLED.un1_onclocks.if_generate_plus.mult1_un110_sum_cry_4_s_LC_379)
set_location POWERLED.un1_onclocks.if_generate_plus.mult1_un110_sum_cry_5_s 1 8 3 # SB_LUT4 (LogicCell: POWERLED.un1_onclocks.if_generate_plus.mult1_un110_sum_cry_5_s_LC_380)
set_location POWERLED.un1_onclocks.if_generate_plus.mult1_un110_sum_cry_5_c 1 8 3 # SB_CARRY (LogicCell: POWERLED.un1_onclocks.if_generate_plus.mult1_un110_sum_cry_5_s_LC_380)
set_location POWERLED.un1_onclocks.if_generate_plus.mult1_un110_sum_cry_6_s 1 8 4 # SB_LUT4 (LogicCell: POWERLED.un1_onclocks.if_generate_plus.mult1_un110_sum_cry_6_s_LC_381)
set_location POWERLED.un1_onclocks.if_generate_plus.mult1_un110_sum_cry_6_c 1 8 4 # SB_CARRY (LogicCell: POWERLED.un1_onclocks.if_generate_plus.mult1_un110_sum_cry_6_s_LC_381)
set_location POWERLED.un1_onclocks.if_generate_plus.mult1_un110_sum_i 4 8 3 # SB_LUT4 (LogicCell: POWERLED.un1_onclocks.if_generate_plus.mult1_un110_sum_i_LC_382)
set_location POWERLED.un1_onclocks.if_generate_plus.mult1_un110_sum_i[8] 2 8 0 # SB_LUT4 (LogicCell: POWERLED.un1_onclocks.if_generate_plus.mult1_un110_sum_i[8]_LC_383)
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
set_location POWERLED.un1_onclocks.if_generate_plus.mult1_un131_sum_s_8 1 10 6 # SB_LUT4 (LogicCell: POWERLED.un1_onclocks.if_generate_plus.mult1_un131_sum_s_8_LC_411)
set_location POWERLED.un1_onclocks.if_generate_plus.mult1_un131_sum_sbtinv[8] 1 10 7 # SB_LUT4 (LogicCell: POWERLED.un1_onclocks.if_generate_plus.mult1_un131_sum_sbtinv[8]_LC_412)
set_location POWERLED.un1_onclocks.if_generate_plus.mult1_un138_sum_axb_8 1 10 5 # SB_LUT4 (LogicCell: POWERLED.un1_onclocks.if_generate_plus.mult1_un138_sum_axb_8_LC_413)
set_location POWERLED.un1_onclocks.if_generate_plus.mult1_un131_sum_cry_7_c 1 10 5 # SB_CARRY (LogicCell: POWERLED.un1_onclocks.if_generate_plus.mult1_un138_sum_axb_8_LC_413)
set_location POWERLED.un1_onclocks.if_generate_plus.mult1_un138_sum_cry_3_s 1 11 1 # SB_LUT4 (LogicCell: POWERLED.un1_onclocks.if_generate_plus.mult1_un138_sum_cry_3_s_LC_414)
set_location POWERLED.un1_onclocks.if_generate_plus.mult1_un138_sum_cry_3_c 1 11 1 # SB_CARRY (LogicCell: POWERLED.un1_onclocks.if_generate_plus.mult1_un138_sum_cry_3_s_LC_414)
set_location POWERLED.un1_onclocks.if_generate_plus.mult1_un138_sum_cry_4_s 1 11 2 # SB_LUT4 (LogicCell: POWERLED.un1_onclocks.if_generate_plus.mult1_un138_sum_cry_4_s_LC_415)
set_location POWERLED.un1_onclocks.if_generate_plus.mult1_un138_sum_cry_4_c 1 11 2 # SB_CARRY (LogicCell: POWERLED.un1_onclocks.if_generate_plus.mult1_un138_sum_cry_4_s_LC_415)
set_location POWERLED.un1_onclocks.if_generate_plus.mult1_un138_sum_cry_5_s 1 11 3 # SB_LUT4 (LogicCell: POWERLED.un1_onclocks.if_generate_plus.mult1_un138_sum_cry_5_s_LC_416)
set_location POWERLED.un1_onclocks.if_generate_plus.mult1_un138_sum_cry_5_c 1 11 3 # SB_CARRY (LogicCell: POWERLED.un1_onclocks.if_generate_plus.mult1_un138_sum_cry_5_s_LC_416)
set_location POWERLED.un1_onclocks.if_generate_plus.mult1_un138_sum_cry_6_s 1 11 4 # SB_LUT4 (LogicCell: POWERLED.un1_onclocks.if_generate_plus.mult1_un138_sum_cry_6_s_LC_417)
set_location POWERLED.un1_onclocks.if_generate_plus.mult1_un138_sum_cry_6_c 1 11 4 # SB_CARRY (LogicCell: POWERLED.un1_onclocks.if_generate_plus.mult1_un138_sum_cry_6_s_LC_417)
set_location POWERLED.un1_onclocks.if_generate_plus.mult1_un138_sum_i 4 9 3 # SB_LUT4 (LogicCell: POWERLED.un1_onclocks.if_generate_plus.mult1_un138_sum_i_LC_418)
set_location POWERLED.un1_onclocks.if_generate_plus.mult1_un138_sum_i[8] 4 11 6 # SB_LUT4 (LogicCell: POWERLED.un1_onclocks.if_generate_plus.mult1_un138_sum_i[8]_LC_419)
set_location POWERLED.un1_onclocks.if_generate_plus.mult1_un138_sum_s_8 1 11 6 # SB_LUT4 (LogicCell: POWERLED.un1_onclocks.if_generate_plus.mult1_un138_sum_s_8_LC_420)
set_location POWERLED.un1_onclocks.if_generate_plus.mult1_un138_sum_sbtinv[8] 1 11 7 # SB_LUT4 (LogicCell: POWERLED.un1_onclocks.if_generate_plus.mult1_un138_sum_sbtinv[8]_LC_421)
set_location POWERLED.un1_onclocks.if_generate_plus.mult1_un145_sum_axb_4_l_fx 2 10 2 # SB_LUT4 (LogicCell: POWERLED.un1_onclocks.if_generate_plus.mult1_un145_sum_axb_4_l_fx_LC_422)
set_location POWERLED.un1_onclocks.if_generate_plus.mult1_un145_sum_axb_7_l_fx 4 11 5 # SB_LUT4 (LogicCell: POWERLED.un1_onclocks.if_generate_plus.mult1_un145_sum_axb_7_l_fx_LC_423)
set_location POWERLED.un1_onclocks.if_generate_plus.mult1_un145_sum_axb_8 1 11 5 # SB_LUT4 (LogicCell: POWERLED.un1_onclocks.if_generate_plus.mult1_un145_sum_axb_8_LC_424)
set_location POWERLED.un1_onclocks.if_generate_plus.mult1_un138_sum_cry_7_c 1 11 5 # SB_CARRY (LogicCell: POWERLED.un1_onclocks.if_generate_plus.mult1_un145_sum_axb_8_LC_424)
set_location POWERLED.un1_onclocks.if_generate_plus.mult1_un145_sum_cry_3_s 2 11 1 # SB_LUT4 (LogicCell: POWERLED.un1_onclocks.if_generate_plus.mult1_un145_sum_cry_3_s_LC_425)
set_location POWERLED.un1_onclocks.if_generate_plus.mult1_un145_sum_cry_3_c 2 11 1 # SB_CARRY (LogicCell: POWERLED.un1_onclocks.if_generate_plus.mult1_un145_sum_cry_3_s_LC_425)
set_location POWERLED.un1_onclocks.if_generate_plus.mult1_un145_sum_cry_4_s 2 11 2 # SB_LUT4 (LogicCell: POWERLED.un1_onclocks.if_generate_plus.mult1_un145_sum_cry_4_s_LC_426)
set_location POWERLED.un1_onclocks.if_generate_plus.mult1_un145_sum_cry_4_c 2 11 2 # SB_CARRY (LogicCell: POWERLED.un1_onclocks.if_generate_plus.mult1_un145_sum_cry_4_s_LC_426)
set_location POWERLED.un1_onclocks.if_generate_plus.mult1_un145_sum_cry_5_s 2 11 3 # SB_LUT4 (LogicCell: POWERLED.un1_onclocks.if_generate_plus.mult1_un145_sum_cry_5_s_LC_427)
set_location POWERLED.un1_onclocks.if_generate_plus.mult1_un145_sum_cry_5_c 2 11 3 # SB_CARRY (LogicCell: POWERLED.un1_onclocks.if_generate_plus.mult1_un145_sum_cry_5_s_LC_427)
set_location POWERLED.un1_onclocks.if_generate_plus.mult1_un145_sum_cry_6_s 2 11 4 # SB_LUT4 (LogicCell: POWERLED.un1_onclocks.if_generate_plus.mult1_un145_sum_cry_6_s_LC_428)
set_location POWERLED.un1_onclocks.if_generate_plus.mult1_un145_sum_cry_6_c 2 11 4 # SB_CARRY (LogicCell: POWERLED.un1_onclocks.if_generate_plus.mult1_un145_sum_cry_6_s_LC_428)
set_location POWERLED.un1_onclocks.if_generate_plus.mult1_un145_sum_i 2 10 5 # SB_LUT4 (LogicCell: POWERLED.un1_onclocks.if_generate_plus.mult1_un145_sum_i_LC_429)
set_location POWERLED.un1_onclocks.if_generate_plus.mult1_un145_sum_i[8] 2 10 3 # SB_LUT4 (LogicCell: POWERLED.un1_onclocks.if_generate_plus.mult1_un145_sum_i[8]_LC_430)
set_location POWERLED.un1_onclocks.if_generate_plus.mult1_un145_sum_s_8 2 11 6 # SB_LUT4 (LogicCell: POWERLED.un1_onclocks.if_generate_plus.mult1_un145_sum_s_8_LC_431)
set_location POWERLED.un1_onclocks.if_generate_plus.mult1_un145_sum_sbtinv[8] 2 11 7 # SB_LUT4 (LogicCell: POWERLED.un1_onclocks.if_generate_plus.mult1_un145_sum_sbtinv[8]_LC_432)
set_location POWERLED.un1_onclocks.if_generate_plus.mult1_un152_sum_axb_8 2 11 5 # SB_LUT4 (LogicCell: POWERLED.un1_onclocks.if_generate_plus.mult1_un152_sum_axb_8_LC_433)
set_location POWERLED.un1_onclocks.if_generate_plus.mult1_un145_sum_cry_7_c 2 11 5 # SB_CARRY (LogicCell: POWERLED.un1_onclocks.if_generate_plus.mult1_un152_sum_axb_8_LC_433)
set_location POWERLED.un1_onclocks.if_generate_plus.mult1_un152_sum_cry_3_s 2 12 1 # SB_LUT4 (LogicCell: POWERLED.un1_onclocks.if_generate_plus.mult1_un152_sum_cry_3_s_LC_434)
set_location POWERLED.un1_onclocks.if_generate_plus.mult1_un152_sum_cry_3_c 2 12 1 # SB_CARRY (LogicCell: POWERLED.un1_onclocks.if_generate_plus.mult1_un152_sum_cry_3_s_LC_434)
set_location POWERLED.un1_onclocks.if_generate_plus.mult1_un152_sum_cry_4_s 2 12 2 # SB_LUT4 (LogicCell: POWERLED.un1_onclocks.if_generate_plus.mult1_un152_sum_cry_4_s_LC_435)
set_location POWERLED.un1_onclocks.if_generate_plus.mult1_un152_sum_cry_4_c 2 12 2 # SB_CARRY (LogicCell: POWERLED.un1_onclocks.if_generate_plus.mult1_un152_sum_cry_4_s_LC_435)
set_location POWERLED.un1_onclocks.if_generate_plus.mult1_un152_sum_cry_5_s 2 12 3 # SB_LUT4 (LogicCell: POWERLED.un1_onclocks.if_generate_plus.mult1_un152_sum_cry_5_s_LC_436)
set_location POWERLED.un1_onclocks.if_generate_plus.mult1_un152_sum_cry_5_c 2 12 3 # SB_CARRY (LogicCell: POWERLED.un1_onclocks.if_generate_plus.mult1_un152_sum_cry_5_s_LC_436)
set_location POWERLED.un1_onclocks.if_generate_plus.mult1_un152_sum_cry_6_s 2 12 4 # SB_LUT4 (LogicCell: POWERLED.un1_onclocks.if_generate_plus.mult1_un152_sum_cry_6_s_LC_437)
set_location POWERLED.un1_onclocks.if_generate_plus.mult1_un152_sum_cry_6_c 2 12 4 # SB_CARRY (LogicCell: POWERLED.un1_onclocks.if_generate_plus.mult1_un152_sum_cry_6_s_LC_437)
set_location POWERLED.un1_onclocks.if_generate_plus.mult1_un152_sum_i 4 12 5 # SB_LUT4 (LogicCell: POWERLED.un1_onclocks.if_generate_plus.mult1_un152_sum_i_LC_438)
set_location POWERLED.un1_onclocks.if_generate_plus.mult1_un152_sum_i[8] 1 13 7 # SB_LUT4 (LogicCell: POWERLED.un1_onclocks.if_generate_plus.mult1_un152_sum_i[8]_LC_439)
set_location POWERLED.un1_onclocks.if_generate_plus.mult1_un152_sum_s_8 2 12 6 # SB_LUT4 (LogicCell: POWERLED.un1_onclocks.if_generate_plus.mult1_un152_sum_s_8_LC_440)
set_location POWERLED.un1_onclocks.if_generate_plus.mult1_un152_sum_sbtinv[8] 2 12 7 # SB_LUT4 (LogicCell: POWERLED.un1_onclocks.if_generate_plus.mult1_un152_sum_sbtinv[8]_LC_441)
set_location POWERLED.un1_onclocks.if_generate_plus.mult1_un159_sum_axb_7 2 12 5 # SB_LUT4 (LogicCell: POWERLED.un1_onclocks.if_generate_plus.mult1_un159_sum_axb_7_LC_442)
set_location POWERLED.un1_onclocks.if_generate_plus.mult1_un152_sum_cry_7_c 2 12 5 # SB_CARRY (LogicCell: POWERLED.un1_onclocks.if_generate_plus.mult1_un159_sum_axb_7_LC_442)
set_location POWERLED.un1_onclocks.if_generate_plus.mult1_un159_sum_cry_2_s 1 12 1 # SB_LUT4 (LogicCell: POWERLED.un1_onclocks.if_generate_plus.mult1_un159_sum_cry_2_s_LC_443)
set_location POWERLED.un1_onclocks.if_generate_plus.mult1_un159_sum_cry_2_c 1 12 1 # SB_CARRY (LogicCell: POWERLED.un1_onclocks.if_generate_plus.mult1_un159_sum_cry_2_s_LC_443)
set_location POWERLED.un1_onclocks.if_generate_plus.mult1_un159_sum_cry_3_s 1 12 2 # SB_LUT4 (LogicCell: POWERLED.un1_onclocks.if_generate_plus.mult1_un159_sum_cry_3_s_LC_444)
set_location POWERLED.un1_onclocks.if_generate_plus.mult1_un159_sum_cry_3_c 1 12 2 # SB_CARRY (LogicCell: POWERLED.un1_onclocks.if_generate_plus.mult1_un159_sum_cry_3_s_LC_444)
set_location POWERLED.un1_onclocks.if_generate_plus.mult1_un159_sum_cry_4_s 1 12 3 # SB_LUT4 (LogicCell: POWERLED.un1_onclocks.if_generate_plus.mult1_un159_sum_cry_4_s_LC_445)
set_location POWERLED.un1_onclocks.if_generate_plus.mult1_un159_sum_cry_4_c 1 12 3 # SB_CARRY (LogicCell: POWERLED.un1_onclocks.if_generate_plus.mult1_un159_sum_cry_4_s_LC_445)
set_location POWERLED.un1_onclocks.if_generate_plus.mult1_un159_sum_cry_5_s 1 12 4 # SB_LUT4 (LogicCell: POWERLED.un1_onclocks.if_generate_plus.mult1_un159_sum_cry_5_s_LC_446)
set_location POWERLED.un1_onclocks.if_generate_plus.mult1_un159_sum_cry_5_c 1 12 4 # SB_CARRY (LogicCell: POWERLED.un1_onclocks.if_generate_plus.mult1_un159_sum_cry_5_s_LC_446)
set_location POWERLED.un1_onclocks.if_generate_plus.mult1_un159_sum_i 4 12 4 # SB_LUT4 (LogicCell: POWERLED.un1_onclocks.if_generate_plus.mult1_un159_sum_i_LC_447)
set_location POWERLED.un1_onclocks.if_generate_plus.mult1_un159_sum_i[8] 1 12 7 # SB_LUT4 (LogicCell: POWERLED.un1_onclocks.if_generate_plus.mult1_un159_sum_i[8]_LC_448)
set_location POWERLED.un1_onclocks.if_generate_plus.mult1_un159_sum_s_7 1 12 6 # SB_LUT4 (LogicCell: POWERLED.un1_onclocks.if_generate_plus.mult1_un159_sum_s_7_LC_449)
set_location POWERLED.un1_onclocks.if_generate_plus.mult1_un166_sum_axb_6 1 12 5 # SB_LUT4 (LogicCell: POWERLED.un1_onclocks.if_generate_plus.mult1_un166_sum_axb_6_LC_450)
set_location POWERLED.un1_onclocks.if_generate_plus.mult1_un159_sum_cry_6_c 1 12 5 # SB_CARRY (LogicCell: POWERLED.un1_onclocks.if_generate_plus.mult1_un166_sum_axb_6_LC_450)
set_location POWERLED.un1_onclocks.if_generate_plus.mult1_un166_sum_cry_1_c_inv 1 13 1 # SB_LUT4 (LogicCell: POWERLED.un1_onclocks.if_generate_plus.mult1_un166_sum_cry_1_c_inv_LC_451)
set_location POWERLED.un1_onclocks.if_generate_plus.mult1_un166_sum_cry_1_c 1 13 1 # SB_CARRY (LogicCell: POWERLED.un1_onclocks.if_generate_plus.mult1_un166_sum_cry_1_c_inv_LC_451)
set_location POWERLED.un1_onclocks.if_generate_plus.mult1_un166_sum_i[8] 1 13 6 # SB_LUT4 (LogicCell: POWERLED.un1_onclocks.if_generate_plus.mult1_un166_sum_i[8]_LC_452)
set_location POWERLED.un1_onclocks.if_generate_plus.mult1_un40_sum_axbxc3 5 7 2 # SB_LUT4 (LogicCell: POWERLED.un1_onclocks.if_generate_plus.mult1_un40_sum_axbxc3_LC_453)
set_location POWERLED.un1_onclocks.if_generate_plus.mult1_un40_sum_i_l_ofx[4] 5 7 0 # SB_LUT4 (LogicCell: POWERLED.un1_onclocks.if_generate_plus.mult1_un40_sum_i_l_ofx[4]_LC_454)
set_location POWERLED.un1_onclocks.if_generate_plus.mult1_un40_sum_i_l_ofx[5] 5 7 1 # SB_LUT4 (LogicCell: POWERLED.un1_onclocks.if_generate_plus.mult1_un40_sum_i_l_ofx[5]_LC_455)
set_location POWERLED.un1_onclocks.if_generate_plus.mult1_un47_sum_cry_3_s 4 6 1 # SB_LUT4 (LogicCell: POWERLED.un1_onclocks.if_generate_plus.mult1_un47_sum_cry_3_s_LC_456)
set_location POWERLED.un1_onclocks.if_generate_plus.mult1_un47_sum_cry_3_c 4 6 1 # SB_CARRY (LogicCell: POWERLED.un1_onclocks.if_generate_plus.mult1_un47_sum_cry_3_s_LC_456)
set_location POWERLED.un1_onclocks.if_generate_plus.mult1_un47_sum_cry_4_s 4 6 2 # SB_LUT4 (LogicCell: POWERLED.un1_onclocks.if_generate_plus.mult1_un47_sum_cry_4_s_LC_457)
set_location POWERLED.un1_onclocks.if_generate_plus.mult1_un47_sum_cry_4_c 4 6 2 # SB_CARRY (LogicCell: POWERLED.un1_onclocks.if_generate_plus.mult1_un47_sum_cry_4_s_LC_457)
set_location POWERLED.un1_onclocks.if_generate_plus.mult1_un47_sum_cry_5_s 4 6 3 # SB_LUT4 (LogicCell: POWERLED.un1_onclocks.if_generate_plus.mult1_un47_sum_cry_5_s_LC_458)
set_location POWERLED.un1_onclocks.if_generate_plus.mult1_un47_sum_cry_5_c 4 6 3 # SB_CARRY (LogicCell: POWERLED.un1_onclocks.if_generate_plus.mult1_un47_sum_cry_5_s_LC_458)
set_location POWERLED.un1_onclocks.if_generate_plus.mult1_un47_sum_cry_6_s 4 6 4 # SB_LUT4 (LogicCell: POWERLED.un1_onclocks.if_generate_plus.mult1_un47_sum_cry_6_s_LC_459)
set_location POWERLED.un1_onclocks.if_generate_plus.mult1_un47_sum_cry_6_c 4 6 4 # SB_CARRY (LogicCell: POWERLED.un1_onclocks.if_generate_plus.mult1_un47_sum_cry_6_s_LC_459)
set_location POWERLED.un1_onclocks.if_generate_plus.mult1_un54_sum_cry_3_s 4 5 1 # SB_LUT4 (LogicCell: POWERLED.un1_onclocks.if_generate_plus.mult1_un54_sum_cry_3_s_LC_460)
set_location POWERLED.un1_onclocks.if_generate_plus.mult1_un54_sum_cry_3_c 4 5 1 # SB_CARRY (LogicCell: POWERLED.un1_onclocks.if_generate_plus.mult1_un54_sum_cry_3_s_LC_460)
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
set_location POWERLED.un1_onclocks.if_generate_plus.mult1_un68_sum_cry_4_s 2 7 2 # SB_LUT4 (LogicCell: POWERLED.un1_onclocks.if_generate_plus.mult1_un68_sum_cry_4_s_LC_477)
set_location POWERLED.un1_onclocks.if_generate_plus.mult1_un68_sum_cry_4_c 2 7 2 # SB_CARRY (LogicCell: POWERLED.un1_onclocks.if_generate_plus.mult1_un68_sum_cry_4_s_LC_477)
set_location POWERLED.un1_onclocks.if_generate_plus.mult1_un68_sum_cry_5_s 2 7 3 # SB_LUT4 (LogicCell: POWERLED.un1_onclocks.if_generate_plus.mult1_un68_sum_cry_5_s_LC_478)
set_location POWERLED.un1_onclocks.if_generate_plus.mult1_un68_sum_cry_5_c 2 7 3 # SB_CARRY (LogicCell: POWERLED.un1_onclocks.if_generate_plus.mult1_un68_sum_cry_5_s_LC_478)
set_location POWERLED.un1_onclocks.if_generate_plus.mult1_un68_sum_cry_6_s 2 7 4 # SB_LUT4 (LogicCell: POWERLED.un1_onclocks.if_generate_plus.mult1_un68_sum_cry_6_s_LC_479)
set_location POWERLED.un1_onclocks.if_generate_plus.mult1_un68_sum_cry_6_c 2 7 4 # SB_CARRY (LogicCell: POWERLED.un1_onclocks.if_generate_plus.mult1_un68_sum_cry_6_s_LC_479)
set_location POWERLED.un1_onclocks.if_generate_plus.mult1_un68_sum_i 4 6 6 # SB_LUT4 (LogicCell: POWERLED.un1_onclocks.if_generate_plus.mult1_un68_sum_i_LC_480)
set_location POWERLED.un1_onclocks.if_generate_plus.mult1_un68_sum_i[8] 2 8 3 # SB_LUT4 (LogicCell: POWERLED.un1_onclocks.if_generate_plus.mult1_un68_sum_i[8]_LC_481)
set_location POWERLED.un1_onclocks.if_generate_plus.mult1_un68_sum_s_8 2 7 6 # SB_LUT4 (LogicCell: POWERLED.un1_onclocks.if_generate_plus.mult1_un68_sum_s_8_LC_482)
set_location POWERLED.un1_onclocks.if_generate_plus.mult1_un68_sum_sbtinv[8] 2 7 7 # SB_LUT4 (LogicCell: POWERLED.un1_onclocks.if_generate_plus.mult1_un68_sum_sbtinv[8]_LC_483)
set_location POWERLED.un1_onclocks.if_generate_plus.mult1_un75_sum_axb_8 2 7 5 # SB_LUT4 (LogicCell: POWERLED.un1_onclocks.if_generate_plus.mult1_un75_sum_axb_8_LC_484)
set_location POWERLED.un1_onclocks.if_generate_plus.mult1_un68_sum_cry_7_c 2 7 5 # SB_CARRY (LogicCell: POWERLED.un1_onclocks.if_generate_plus.mult1_un75_sum_axb_8_LC_484)
set_location POWERLED.un1_onclocks.if_generate_plus.mult1_un75_sum_cry_3_s 2 6 1 # SB_LUT4 (LogicCell: POWERLED.un1_onclocks.if_generate_plus.mult1_un75_sum_cry_3_s_LC_485)
set_location POWERLED.un1_onclocks.if_generate_plus.mult1_un75_sum_cry_3_c 2 6 1 # SB_CARRY (LogicCell: POWERLED.un1_onclocks.if_generate_plus.mult1_un75_sum_cry_3_s_LC_485)
set_location POWERLED.un1_onclocks.if_generate_plus.mult1_un75_sum_cry_4_s 2 6 2 # SB_LUT4 (LogicCell: POWERLED.un1_onclocks.if_generate_plus.mult1_un75_sum_cry_4_s_LC_486)
set_location POWERLED.un1_onclocks.if_generate_plus.mult1_un75_sum_cry_4_c 2 6 2 # SB_CARRY (LogicCell: POWERLED.un1_onclocks.if_generate_plus.mult1_un75_sum_cry_4_s_LC_486)
set_location POWERLED.un1_onclocks.if_generate_plus.mult1_un75_sum_cry_5_s 2 6 3 # SB_LUT4 (LogicCell: POWERLED.un1_onclocks.if_generate_plus.mult1_un75_sum_cry_5_s_LC_487)
set_location POWERLED.un1_onclocks.if_generate_plus.mult1_un75_sum_cry_5_c 2 6 3 # SB_CARRY (LogicCell: POWERLED.un1_onclocks.if_generate_plus.mult1_un75_sum_cry_5_s_LC_487)
set_location POWERLED.un1_onclocks.if_generate_plus.mult1_un75_sum_cry_6_s 2 6 4 # SB_LUT4 (LogicCell: POWERLED.un1_onclocks.if_generate_plus.mult1_un75_sum_cry_6_s_LC_488)
set_location POWERLED.un1_onclocks.if_generate_plus.mult1_un75_sum_cry_6_c 2 6 4 # SB_CARRY (LogicCell: POWERLED.un1_onclocks.if_generate_plus.mult1_un75_sum_cry_6_s_LC_488)
set_location POWERLED.un1_onclocks.if_generate_plus.mult1_un75_sum_i 5 5 6 # SB_LUT4 (LogicCell: POWERLED.un1_onclocks.if_generate_plus.mult1_un75_sum_i_LC_489)
set_location POWERLED.un1_onclocks.if_generate_plus.mult1_un75_sum_i[8] 2 8 4 # SB_LUT4 (LogicCell: POWERLED.un1_onclocks.if_generate_plus.mult1_un75_sum_i[8]_LC_490)
set_location POWERLED.un1_onclocks.if_generate_plus.mult1_un75_sum_s_8 2 6 6 # SB_LUT4 (LogicCell: POWERLED.un1_onclocks.if_generate_plus.mult1_un75_sum_s_8_LC_491)
set_location POWERLED.un1_onclocks.if_generate_plus.mult1_un75_sum_sbtinv[8] 2 6 7 # SB_LUT4 (LogicCell: POWERLED.un1_onclocks.if_generate_plus.mult1_un75_sum_sbtinv[8]_LC_492)
set_location POWERLED.un1_onclocks.if_generate_plus.mult1_un82_sum_axb_8 2 6 5 # SB_LUT4 (LogicCell: POWERLED.un1_onclocks.if_generate_plus.mult1_un82_sum_axb_8_LC_493)
set_location POWERLED.un1_onclocks.if_generate_plus.mult1_un75_sum_cry_7_c 2 6 5 # SB_CARRY (LogicCell: POWERLED.un1_onclocks.if_generate_plus.mult1_un82_sum_axb_8_LC_493)
set_location POWERLED.un1_onclocks.if_generate_plus.mult1_un82_sum_cry_3_s 2 5 1 # SB_LUT4 (LogicCell: POWERLED.un1_onclocks.if_generate_plus.mult1_un82_sum_cry_3_s_LC_494)
set_location POWERLED.un1_onclocks.if_generate_plus.mult1_un82_sum_cry_3_c 2 5 1 # SB_CARRY (LogicCell: POWERLED.un1_onclocks.if_generate_plus.mult1_un82_sum_cry_3_s_LC_494)
set_location POWERLED.un1_onclocks.if_generate_plus.mult1_un82_sum_cry_4_s 2 5 2 # SB_LUT4 (LogicCell: POWERLED.un1_onclocks.if_generate_plus.mult1_un82_sum_cry_4_s_LC_495)
set_location POWERLED.un1_onclocks.if_generate_plus.mult1_un82_sum_cry_4_c 2 5 2 # SB_CARRY (LogicCell: POWERLED.un1_onclocks.if_generate_plus.mult1_un82_sum_cry_4_s_LC_495)
set_location POWERLED.un1_onclocks.if_generate_plus.mult1_un82_sum_cry_5_s 2 5 3 # SB_LUT4 (LogicCell: POWERLED.un1_onclocks.if_generate_plus.mult1_un82_sum_cry_5_s_LC_496)
set_location POWERLED.un1_onclocks.if_generate_plus.mult1_un82_sum_cry_5_c 2 5 3 # SB_CARRY (LogicCell: POWERLED.un1_onclocks.if_generate_plus.mult1_un82_sum_cry_5_s_LC_496)
set_location POWERLED.un1_onclocks.if_generate_plus.mult1_un82_sum_cry_6_s 2 5 4 # SB_LUT4 (LogicCell: POWERLED.un1_onclocks.if_generate_plus.mult1_un82_sum_cry_6_s_LC_497)
set_location POWERLED.un1_onclocks.if_generate_plus.mult1_un82_sum_cry_6_c 2 5 4 # SB_CARRY (LogicCell: POWERLED.un1_onclocks.if_generate_plus.mult1_un82_sum_cry_6_s_LC_497)
set_location POWERLED.un1_onclocks.if_generate_plus.mult1_un82_sum_i 5 5 2 # SB_LUT4 (LogicCell: POWERLED.un1_onclocks.if_generate_plus.mult1_un82_sum_i_LC_498)
set_location POWERLED.un1_onclocks.if_generate_plus.mult1_un82_sum_i[8] 2 8 2 # SB_LUT4 (LogicCell: POWERLED.un1_onclocks.if_generate_plus.mult1_un82_sum_i[8]_LC_499)
set_location POWERLED.un1_onclocks.if_generate_plus.mult1_un82_sum_s_8 2 5 6 # SB_LUT4 (LogicCell: POWERLED.un1_onclocks.if_generate_plus.mult1_un82_sum_s_8_LC_500)
set_location POWERLED.un1_onclocks.if_generate_plus.mult1_un82_sum_sbtinv[8] 2 5 7 # SB_LUT4 (LogicCell: POWERLED.un1_onclocks.if_generate_plus.mult1_un82_sum_sbtinv[8]_LC_501)
set_location POWERLED.un1_onclocks.if_generate_plus.mult1_un89_sum_axb_8 2 5 5 # SB_LUT4 (LogicCell: POWERLED.un1_onclocks.if_generate_plus.mult1_un89_sum_axb_8_LC_502)
set_location POWERLED.un1_onclocks.if_generate_plus.mult1_un82_sum_cry_7_c 2 5 5 # SB_CARRY (LogicCell: POWERLED.un1_onclocks.if_generate_plus.mult1_un89_sum_axb_8_LC_502)
set_location POWERLED.un1_onclocks.if_generate_plus.mult1_un89_sum_cry_3_s 1 5 1 # SB_LUT4 (LogicCell: POWERLED.un1_onclocks.if_generate_plus.mult1_un89_sum_cry_3_s_LC_503)
set_location POWERLED.un1_onclocks.if_generate_plus.mult1_un89_sum_cry_3_c 1 5 1 # SB_CARRY (LogicCell: POWERLED.un1_onclocks.if_generate_plus.mult1_un89_sum_cry_3_s_LC_503)
set_location POWERLED.un1_onclocks.if_generate_plus.mult1_un89_sum_cry_4_s 1 5 2 # SB_LUT4 (LogicCell: POWERLED.un1_onclocks.if_generate_plus.mult1_un89_sum_cry_4_s_LC_504)
set_location POWERLED.un1_onclocks.if_generate_plus.mult1_un89_sum_cry_4_c 1 5 2 # SB_CARRY (LogicCell: POWERLED.un1_onclocks.if_generate_plus.mult1_un89_sum_cry_4_s_LC_504)
set_location POWERLED.un1_onclocks.if_generate_plus.mult1_un89_sum_cry_5_s 1 5 3 # SB_LUT4 (LogicCell: POWERLED.un1_onclocks.if_generate_plus.mult1_un89_sum_cry_5_s_LC_505)
set_location POWERLED.un1_onclocks.if_generate_plus.mult1_un89_sum_cry_5_c 1 5 3 # SB_CARRY (LogicCell: POWERLED.un1_onclocks.if_generate_plus.mult1_un89_sum_cry_5_s_LC_505)
set_location POWERLED.un1_onclocks.if_generate_plus.mult1_un89_sum_cry_6_s 1 5 4 # SB_LUT4 (LogicCell: POWERLED.un1_onclocks.if_generate_plus.mult1_un89_sum_cry_6_s_LC_506)
set_location POWERLED.un1_onclocks.if_generate_plus.mult1_un89_sum_cry_6_c 1 5 4 # SB_CARRY (LogicCell: POWERLED.un1_onclocks.if_generate_plus.mult1_un89_sum_cry_6_s_LC_506)
set_location POWERLED.un1_onclocks.if_generate_plus.mult1_un89_sum_i 2 8 7 # SB_LUT4 (LogicCell: POWERLED.un1_onclocks.if_generate_plus.mult1_un89_sum_i_LC_507)
set_location POWERLED.un1_onclocks.if_generate_plus.mult1_un89_sum_i[8] 2 8 1 # SB_LUT4 (LogicCell: POWERLED.un1_onclocks.if_generate_plus.mult1_un89_sum_i[8]_LC_508)
set_location POWERLED.un1_onclocks.if_generate_plus.mult1_un89_sum_s_8 1 5 6 # SB_LUT4 (LogicCell: POWERLED.un1_onclocks.if_generate_plus.mult1_un89_sum_s_8_LC_509)
set_location POWERLED.un1_onclocks.if_generate_plus.mult1_un89_sum_sbtinv[8] 1 5 7 # SB_LUT4 (LogicCell: POWERLED.un1_onclocks.if_generate_plus.mult1_un89_sum_sbtinv[8]_LC_510)
set_location POWERLED.un1_onclocks.if_generate_plus.mult1_un96_sum_axb_8 1 5 5 # SB_LUT4 (LogicCell: POWERLED.un1_onclocks.if_generate_plus.mult1_un96_sum_axb_8_LC_511)
set_location POWERLED.un1_onclocks.if_generate_plus.mult1_un89_sum_cry_7_c 1 5 5 # SB_CARRY (LogicCell: POWERLED.un1_onclocks.if_generate_plus.mult1_un96_sum_axb_8_LC_511)
set_location POWERLED.un1_onclocks.if_generate_plus.mult1_un96_sum_cry_3_s 1 6 1 # SB_LUT4 (LogicCell: POWERLED.un1_onclocks.if_generate_plus.mult1_un96_sum_cry_3_s_LC_512)
set_location POWERLED.un1_onclocks.if_generate_plus.mult1_un96_sum_cry_3_c 1 6 1 # SB_CARRY (LogicCell: POWERLED.un1_onclocks.if_generate_plus.mult1_un96_sum_cry_3_s_LC_512)
set_location POWERLED.un1_onclocks.if_generate_plus.mult1_un96_sum_cry_4_s 1 6 2 # SB_LUT4 (LogicCell: POWERLED.un1_onclocks.if_generate_plus.mult1_un96_sum_cry_4_s_LC_513)
set_location POWERLED.un1_onclocks.if_generate_plus.mult1_un96_sum_cry_4_c 1 6 2 # SB_CARRY (LogicCell: POWERLED.un1_onclocks.if_generate_plus.mult1_un96_sum_cry_4_s_LC_513)
set_location POWERLED.un1_onclocks.if_generate_plus.mult1_un96_sum_cry_5_s 1 6 3 # SB_LUT4 (LogicCell: POWERLED.un1_onclocks.if_generate_plus.mult1_un96_sum_cry_5_s_LC_514)
set_location POWERLED.un1_onclocks.if_generate_plus.mult1_un96_sum_cry_5_c 1 6 3 # SB_CARRY (LogicCell: POWERLED.un1_onclocks.if_generate_plus.mult1_un96_sum_cry_5_s_LC_514)
set_location POWERLED.un1_onclocks.if_generate_plus.mult1_un96_sum_cry_6_s 1 6 4 # SB_LUT4 (LogicCell: POWERLED.un1_onclocks.if_generate_plus.mult1_un96_sum_cry_6_s_LC_515)
set_location POWERLED.un1_onclocks.if_generate_plus.mult1_un96_sum_cry_6_c 1 6 4 # SB_CARRY (LogicCell: POWERLED.un1_onclocks.if_generate_plus.mult1_un96_sum_cry_6_s_LC_515)
set_location POWERLED.un1_onclocks.if_generate_plus.mult1_un96_sum_i 1 14 4 # SB_LUT4 (LogicCell: POWERLED.un1_onclocks.if_generate_plus.mult1_un96_sum_i_LC_516)
set_location POWERLED.un1_onclocks.if_generate_plus.mult1_un96_sum_i[8] 1 14 5 # SB_LUT4 (LogicCell: POWERLED.un1_onclocks.if_generate_plus.mult1_un96_sum_i[8]_LC_517)
set_location POWERLED.un1_onclocks.if_generate_plus.mult1_un96_sum_s_8 1 6 6 # SB_LUT4 (LogicCell: POWERLED.un1_onclocks.if_generate_plus.mult1_un96_sum_s_8_LC_518)
set_location POWERLED.un1_onclocks.if_generate_plus.mult1_un96_sum_sbtinv[8] 1 6 7 # SB_LUT4 (LogicCell: POWERLED.un1_onclocks.if_generate_plus.mult1_un96_sum_sbtinv[8]_LC_519)
set_location RSMRST_PWRGD.count_RNO[0] 8 11 0 # SB_LUT4 (LogicCell: RSMRST_PWRGD.count[0]_LC_520)
set_location RSMRST_PWRGD.count[0] 8 11 0 # SB_DFFSR (LogicCell: RSMRST_PWRGD.count[0]_LC_520)
set_location RSMRST_PWRGD.un1_count_1_cry_0_c 8 11 0 # SB_CARRY (LogicCell: RSMRST_PWRGD.count[0]_LC_520)
set_location RSMRST_PWRGD.count_RNO[1] 8 11 1 # SB_LUT4 (LogicCell: RSMRST_PWRGD.count[1]_LC_521)
set_location RSMRST_PWRGD.count[1] 8 11 1 # SB_DFFSR (LogicCell: RSMRST_PWRGD.count[1]_LC_521)
set_location RSMRST_PWRGD.un1_count_1_cry_1_c 8 11 1 # SB_CARRY (LogicCell: RSMRST_PWRGD.count[1]_LC_521)
set_location RSMRST_PWRGD.count_RNO[10] 8 12 2 # SB_LUT4 (LogicCell: RSMRST_PWRGD.count[10]_LC_522)
set_location RSMRST_PWRGD.count[10] 8 12 2 # SB_DFFSR (LogicCell: RSMRST_PWRGD.count[10]_LC_522)
set_location RSMRST_PWRGD.un1_count_1_cry_10_c 8 12 2 # SB_CARRY (LogicCell: RSMRST_PWRGD.count[10]_LC_522)
set_location RSMRST_PWRGD.count_RNO[11] 8 12 3 # SB_LUT4 (LogicCell: RSMRST_PWRGD.count[11]_LC_523)
set_location RSMRST_PWRGD.count[11] 8 12 3 # SB_DFFSR (LogicCell: RSMRST_PWRGD.count[11]_LC_523)
set_location RSMRST_PWRGD.un1_count_1_cry_11_c 8 12 3 # SB_CARRY (LogicCell: RSMRST_PWRGD.count[11]_LC_523)
set_location RSMRST_PWRGD.count_RNO[12] 8 12 4 # SB_LUT4 (LogicCell: RSMRST_PWRGD.count[12]_LC_524)
set_location RSMRST_PWRGD.count[12] 8 12 4 # SB_DFFSR (LogicCell: RSMRST_PWRGD.count[12]_LC_524)
set_location RSMRST_PWRGD.un1_count_1_cry_12_c 8 12 4 # SB_CARRY (LogicCell: RSMRST_PWRGD.count[12]_LC_524)
set_location RSMRST_PWRGD.count_RNO[13] 8 12 5 # SB_LUT4 (LogicCell: RSMRST_PWRGD.count[13]_LC_525)
set_location RSMRST_PWRGD.count[13] 8 12 5 # SB_DFFSR (LogicCell: RSMRST_PWRGD.count[13]_LC_525)
set_location RSMRST_PWRGD.un1_count_1_cry_13_c 8 12 5 # SB_CARRY (LogicCell: RSMRST_PWRGD.count[13]_LC_525)
set_location RSMRST_PWRGD.count_RNO[14] 8 12 6 # SB_LUT4 (LogicCell: RSMRST_PWRGD.count[14]_LC_526)
set_location RSMRST_PWRGD.count[14] 8 12 6 # SB_DFFSR (LogicCell: RSMRST_PWRGD.count[14]_LC_526)
set_location RSMRST_PWRGD.un1_count_1_cry_14_c 8 12 6 # SB_CARRY (LogicCell: RSMRST_PWRGD.count[14]_LC_526)
set_location RSMRST_PWRGD.count_RNO[2] 8 11 2 # SB_LUT4 (LogicCell: RSMRST_PWRGD.count[2]_LC_527)
set_location RSMRST_PWRGD.count[2] 8 11 2 # SB_DFFSR (LogicCell: RSMRST_PWRGD.count[2]_LC_527)
set_location RSMRST_PWRGD.un1_count_1_cry_2_c 8 11 2 # SB_CARRY (LogicCell: RSMRST_PWRGD.count[2]_LC_527)
set_location RSMRST_PWRGD.count_RNO[3] 8 11 3 # SB_LUT4 (LogicCell: RSMRST_PWRGD.count[3]_LC_528)
set_location RSMRST_PWRGD.count[3] 8 11 3 # SB_DFFSR (LogicCell: RSMRST_PWRGD.count[3]_LC_528)
set_location RSMRST_PWRGD.un1_count_1_cry_3_c 8 11 3 # SB_CARRY (LogicCell: RSMRST_PWRGD.count[3]_LC_528)
set_location RSMRST_PWRGD.count_RNO[4] 8 11 4 # SB_LUT4 (LogicCell: RSMRST_PWRGD.count[4]_LC_529)
set_location RSMRST_PWRGD.count[4] 8 11 4 # SB_DFFSR (LogicCell: RSMRST_PWRGD.count[4]_LC_529)
set_location RSMRST_PWRGD.un1_count_1_cry_4_c 8 11 4 # SB_CARRY (LogicCell: RSMRST_PWRGD.count[4]_LC_529)
set_location RSMRST_PWRGD.count_RNO[5] 8 11 5 # SB_LUT4 (LogicCell: RSMRST_PWRGD.count[5]_LC_530)
set_location RSMRST_PWRGD.count[5] 8 11 5 # SB_DFFSR (LogicCell: RSMRST_PWRGD.count[5]_LC_530)
set_location RSMRST_PWRGD.un1_count_1_cry_5_c 8 11 5 # SB_CARRY (LogicCell: RSMRST_PWRGD.count[5]_LC_530)
set_location RSMRST_PWRGD.count_RNO[6] 8 11 6 # SB_LUT4 (LogicCell: RSMRST_PWRGD.count[6]_LC_531)
set_location RSMRST_PWRGD.count[6] 8 11 6 # SB_DFFSR (LogicCell: RSMRST_PWRGD.count[6]_LC_531)
set_location RSMRST_PWRGD.un1_count_1_cry_6_c 8 11 6 # SB_CARRY (LogicCell: RSMRST_PWRGD.count[6]_LC_531)
set_location RSMRST_PWRGD.count_RNO[7] 8 11 7 # SB_LUT4 (LogicCell: RSMRST_PWRGD.count[7]_LC_532)
set_location RSMRST_PWRGD.count[7] 8 11 7 # SB_DFFSR (LogicCell: RSMRST_PWRGD.count[7]_LC_532)
set_location RSMRST_PWRGD.un1_count_1_cry_7_c 8 11 7 # SB_CARRY (LogicCell: RSMRST_PWRGD.count[7]_LC_532)
set_location RSMRST_PWRGD.count_RNO[8] 8 12 0 # SB_LUT4 (LogicCell: RSMRST_PWRGD.count[8]_LC_533)
set_location RSMRST_PWRGD.count[8] 8 12 0 # SB_DFFSR (LogicCell: RSMRST_PWRGD.count[8]_LC_533)
set_location RSMRST_PWRGD.un1_count_1_cry_8_c 8 12 0 # SB_CARRY (LogicCell: RSMRST_PWRGD.count[8]_LC_533)
set_location RSMRST_PWRGD.count_RNO[9] 8 12 1 # SB_LUT4 (LogicCell: RSMRST_PWRGD.count[9]_LC_534)
set_location RSMRST_PWRGD.count[9] 8 12 1 # SB_DFFSR (LogicCell: RSMRST_PWRGD.count[9]_LC_534)
set_location RSMRST_PWRGD.un1_count_1_cry_9_c 8 12 1 # SB_CARRY (LogicCell: RSMRST_PWRGD.count[9]_LC_534)
set_location RSMRST_PWRGD.count_esr_RNO_0[15] 9 13 2 # SB_LUT4 (LogicCell: RSMRST_PWRGD.count_esr_RNO_0[15]_LC_535)
set_location RSMRST_PWRGD.count_esr_RNO[15] 8 13 0 # SB_LUT4 (LogicCell: RSMRST_PWRGD.count_esr[15]_LC_536)
set_location RSMRST_PWRGD.count_esr[15] 8 13 0 # SB_DFFESR (LogicCell: RSMRST_PWRGD.count_esr[15]_LC_536)
set_location RSMRST_PWRGD.curr_state_7_1_0_.m4_i_i 11 13 7 # SB_LUT4 (LogicCell: RSMRST_PWRGD.curr_state[0]_LC_537)
set_location RSMRST_PWRGD.curr_state[0] 11 13 7 # SB_DFFE (LogicCell: RSMRST_PWRGD.curr_state[0]_LC_537)
set_location RSMRST_PWRGD.curr_state_7_1_0_.m4_i_i_a2 9 13 0 # SB_LUT4 (LogicCell: RSMRST_PWRGD.curr_state_7_1_0_.m4_i_i_a2_LC_538)
set_location RSMRST_PWRGD.curr_state_7_1_0_.m4_i_i_a2_0 9 12 4 # SB_LUT4 (LogicCell: RSMRST_PWRGD.curr_state_7_1_0_.m4_i_i_a2_0_LC_539)
set_location RSMRST_PWRGD.curr_state_7_1_0_.m4_i_i_a2_0_10 9 12 7 # SB_LUT4 (LogicCell: RSMRST_PWRGD.curr_state_7_1_0_.m4_i_i_a2_0_10_LC_540)
set_location RSMRST_PWRGD.curr_state_7_1_0_.m4_i_i_a2_0_11 9 12 1 # SB_LUT4 (LogicCell: RSMRST_PWRGD.curr_state_7_1_0_.m4_i_i_a2_0_11_LC_541)
set_location RSMRST_PWRGD.curr_state_7_1_0_.m4_i_i_a2_0_12 9 12 6 # SB_LUT4 (LogicCell: RSMRST_PWRGD.curr_state_7_1_0_.m4_i_i_a2_0_12_LC_542)
set_location RSMRST_PWRGD.curr_state_7_1_0_.m4_i_i_a2_0_7 9 12 5 # SB_LUT4 (LogicCell: RSMRST_PWRGD.curr_state_7_1_0_.m4_i_i_a2_0_7_LC_543)
set_location RSMRST_PWRGD.curr_state_7_1_0_.m4_i_i_a2_0_9 9 12 3 # SB_LUT4 (LogicCell: RSMRST_PWRGD.curr_state_7_1_0_.m4_i_i_a2_0_9_LC_544)
set_location RSMRST_PWRGD.curr_state_7_1_0_.m4_i_i_a6_0 11 14 2 # SB_LUT4 (LogicCell: RSMRST_PWRGD.RSMRSTn_LC_545)
set_location RSMRST_PWRGD.RSMRSTn 11 14 2 # SB_DFFE (LogicCell: RSMRST_PWRGD.RSMRSTn_LC_545)
set_location RSMRST_PWRGD.curr_state_7_1_0_.m6_i_i_a6 11 13 5 # SB_LUT4 (LogicCell: RSMRST_PWRGD.curr_state[1]_LC_546)
set_location RSMRST_PWRGD.curr_state[1] 11 13 5 # SB_DFFE (LogicCell: RSMRST_PWRGD.curr_state[1]_LC_546)
set_location RSMRST_PWRGD.curr_state_RNIJULM7[0] 9 13 1 # SB_LUT4 (LogicCell: RSMRST_PWRGD.curr_state_RNIJULM7[0]_LC_547)
set_location RSMRST_PWRGD.curr_state_RNISEFS1[1] 9 13 6 # SB_LUT4 (LogicCell: RSMRST_PWRGD.curr_state_RNISEFS1[1]_LC_548)
set_location RSMRST_PWRGD.un6_rsmrst_pwrok 9 7 3 # SB_LUT4 (LogicCell: RSMRST_PWRGD.un6_rsmrst_pwrok_LC_549)
set_location VPP_VDDQ.count_RNI63141[10] 9 15 5 # SB_LUT4 (LogicCell: VPP_VDDQ.count_RNI63141[10]_LC_550)
set_location VPP_VDDQ.count_RNIFC141[11] 9 15 6 # SB_LUT4 (LogicCell: VPP_VDDQ.count_RNIFC141[11]_LC_551)
set_location VPP_VDDQ.count_RNIVJP51[3] 9 14 1 # SB_LUT4 (LogicCell: VPP_VDDQ.count_RNIVJP51[3]_LC_552)
set_location VPP_VDDQ.count_RNO[0] 8 14 0 # SB_LUT4 (LogicCell: VPP_VDDQ.count[0]_LC_553)
set_location VPP_VDDQ.count[0] 8 14 0 # SB_DFFSR (LogicCell: VPP_VDDQ.count[0]_LC_553)
set_location VPP_VDDQ.un1_count_1_cry_0_c 8 14 0 # SB_CARRY (LogicCell: VPP_VDDQ.count[0]_LC_553)
set_location VPP_VDDQ.count_RNO[1] 8 14 1 # SB_LUT4 (LogicCell: VPP_VDDQ.count[1]_LC_554)
set_location VPP_VDDQ.count[1] 8 14 1 # SB_DFFSR (LogicCell: VPP_VDDQ.count[1]_LC_554)
set_location VPP_VDDQ.un1_count_1_cry_1_c 8 14 1 # SB_CARRY (LogicCell: VPP_VDDQ.count[1]_LC_554)
set_location VPP_VDDQ.count_RNO[10] 8 15 2 # SB_LUT4 (LogicCell: VPP_VDDQ.count[10]_LC_555)
set_location VPP_VDDQ.count[10] 8 15 2 # SB_DFFSR (LogicCell: VPP_VDDQ.count[10]_LC_555)
set_location VPP_VDDQ.un1_count_1_cry_10_c 8 15 2 # SB_CARRY (LogicCell: VPP_VDDQ.count[10]_LC_555)
set_location VPP_VDDQ.count_RNO[11] 8 15 3 # SB_LUT4 (LogicCell: VPP_VDDQ.count[11]_LC_556)
set_location VPP_VDDQ.count[11] 8 15 3 # SB_DFFSR (LogicCell: VPP_VDDQ.count[11]_LC_556)
set_location VPP_VDDQ.un1_count_1_cry_11_c 8 15 3 # SB_CARRY (LogicCell: VPP_VDDQ.count[11]_LC_556)
set_location VPP_VDDQ.count_RNO[12] 8 15 4 # SB_LUT4 (LogicCell: VPP_VDDQ.count[12]_LC_557)
set_location VPP_VDDQ.count[12] 8 15 4 # SB_DFFSR (LogicCell: VPP_VDDQ.count[12]_LC_557)
set_location VPP_VDDQ.un1_count_1_cry_12_c 8 15 4 # SB_CARRY (LogicCell: VPP_VDDQ.count[12]_LC_557)
set_location VPP_VDDQ.count_RNO[13] 8 15 5 # SB_LUT4 (LogicCell: VPP_VDDQ.count[13]_LC_558)
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
