firasgany77/Board-Design-Git/Lattice FPGA Works/SBCTI22WORK3 - Home/SBCTI22WORK3_Implmnt/sbt/constraint/TOP_pcf_sbt.pcf

# ##############################################################################

# iCEcube PCF

# Version:            2020.12.27943

# File Generated:     Jul 11 2022 11:23:46

# Family & Device:    iCE40LP1K

# Package:            QN84

# ##############################################################################

###IOSet List 59
set_io FPGA_SLP_WLAN_N A16
set_io PCH_PWROK A12
set_io V33A_OK A35
set_io SATAXPCIE0_FPGA B23
set_io SPI_FP_IO3 A8
set_io V12_MAIN_MON A43
set_io SLP_S5n A41
set_io SOC_SPKR A47
set_io VCCIN_EN B29
set_io VCCIN_VR_PE A27
set_io VPP_OK B1 -pullup no
set_io VR_PROCHOT_FPGA_OUT_N A32
set_io GPIO_FPGA_SoC_3 B13
set_io V5A_EN A10
set_io DSW_PWROK B4 -pullup no
set_io GPIO_FPGA_SoC_1 A19
set_io V33S_ENn A3
set_io V33S_OK A34
set_io VCCINAUX_EN A26
set_io VCCST_CPU_OK B19
set_io SLP_S4n B34
set_io SUSACK_N A11
set_io VDDQ_OK B26 -pullup yes
set_io VPP_EN A33
set_io GPIO_FPGA_EXP_2 A45
set_io HDA_SDO_ATP B7
set_io VCCINAUX_VR_PE B22
set_io VCCINAUX_VR_PROCHOT_FPGA B24
set_io GPIO_FPGA_EXP_1 A44
set_io SATAXPCIE1_FPGA B31
set_io SPI_FP_IO2 A9
set_io SYS_PWROK B27
set_io VCCST_PWRGD A14
set_io FPGA_OSC B12
set_io RSMRSTn B35
set_io V5A_OK B8 -pullup yes
set_io VR_READY_VCCIN B5 -pullup yes
set_io GPIO_FPGA_SoC_4 A25
set_io PLTRSTn B11
set_io SUSWARN_N B9
set_io TPM_GPIO B30
set_io V33DSW_OK A2 -pullup yes
set_io VCCST_EN A4
set_io CPU_C10_GATE_N A13
set_io SLP_SUSn A40 -pullup no
set_io VCCIN_VR_PROCHOT_FPGA A31
set_io GPIO_FPGA_SoC_2 B14
set_io PWRBTN_LED B36
set_io PWRBTNn A39
set_io V1P8A_OK B2 -pullup yes
set_io V5S_ENn B3
set_io SLP_S0n A46
set_io SLP_S3n A38
set_io V5S_OK B20
set_io VCCST_OVERRIDE_3V3 B10
set_io VDDQ_EN A48
set_io V1P8A_EN A1
set_io V33A_ENn A5
set_io VR_READY_VCCINAUX B21 -pullup no
