firasgany77/Board-Design-Git/Lattice FPGA Works/FLT3NEW/FLT3NEW_Implmnt/sbt/outputs/simulation_netlist/TOP_sbt.v

// ******************************************************************************

// iCEcube Netlister

// Version:            2020.12.27943

// Build Date:         Dec  9 2020 18:18:12

// File Generated:     Aug 28 2022 15:57:34

// Purpose:            Post-Route Verilog/VHDL netlist for timing simulation

// Copyright (C) 2006-2010 by Lattice Semiconductor Corp. All rights reserved.

// ******************************************************************************

// Verilog file for cell "TOP" view "INTERFACE"

module TOP (
    VCCIN_AUX_PWRGD,
    SMBUS_GPIO_0,
    PMC_SLP_S5_N,
    EN_DS2_Yellow_LED,
    VCCST_OK,
    VCCIO_EN,
    V1P8A_EN,
    FPGABTNIN_N,
    VDDQ_EN,
    SMBUS_GPIO_2,
    VR_PGOOD,
    VCCIO_OK,
    V1P8A_OK,
    VCCST_PWRGD_3V3,
    PMC_SLP_S3_N,
    CPU_C10_GATE_N,
    VCCST_EN,
    V33DSW_OK,
    TPM_GPIO,
    TP4,
    SMBUS_GPIO_5,
    PMC_SLP_WLAN_N,
    FPGA_PWRBTN_N,
    FPGA_GPIO_IN0,
    V5A_OK,
    SLP_SUS_N,
    PLT_RST_N,
    FPGA_OSC,
    FPGA_GPIO_OUT0,
    SYS_PWROK,
    HDA_SDO_FPGA,
    GPIO_FPGA_M2E_1,
    VPP_EN,
    VDDQ_OK,
    SMBUS_GPIO_1,
    V33S_OK,
    RSMRST_N,
    FPGA_WD_TRIGGER,
    EN_DS2_Green_LED,
    DSW_PWROK,
    SMBUS_GPIO_3,
    IMVP9_AUX_EN,
    VCCST_FPGA,
    SMBUS_GPIO_4,
    IMVP9_VR_EN,
    FPGA_GPIO_IN1,
    CPUPWRGD,
    VPP_OK,
    SYS_RESET_N,
    PWRBTN_FPGA_LED_2,
    IMVP9_VR_READY,
    V12_MAIN_MON,
    SUSACK_FPGA,
    SMBUS_GPIO_6,
    PMC_SLP_S4_N,
    PMC_SLP_S0_N,
    H_THRMTRIP_N,
    V33A_OK,
    V33A_EN_N,
    PCH_PWROK,
    FPGA_GPIO_OUT1,
    CDONE);

    input VCCIN_AUX_PWRGD;
    output SMBUS_GPIO_0;
    input PMC_SLP_S5_N;
    output EN_DS2_Yellow_LED;
    input VCCST_OK;
    output VCCIO_EN;
    output V1P8A_EN;
    input FPGABTNIN_N;
    output VDDQ_EN;
    output SMBUS_GPIO_2;
    input VR_PGOOD;
    input VCCIO_OK;
    input V1P8A_OK;
    output VCCST_PWRGD_3V3;
    input PMC_SLP_S3_N;
    input CPU_C10_GATE_N;
    output VCCST_EN;
    input V33DSW_OK;
    input TPM_GPIO;
    output TP4;
    output SMBUS_GPIO_5;
    input PMC_SLP_WLAN_N;
    output FPGA_PWRBTN_N;
    input FPGA_GPIO_IN0;
    input V5A_OK;
    input SLP_SUS_N;
    input PLT_RST_N;
    input FPGA_OSC;
    output FPGA_GPIO_OUT0;
    output SYS_PWROK;
    output HDA_SDO_FPGA;
    output GPIO_FPGA_M2E_1;
    output VPP_EN;
    input VDDQ_OK;
    output SMBUS_GPIO_1;
    input V33S_OK;
    output RSMRST_N;
    input FPGA_WD_TRIGGER;
    output EN_DS2_Green_LED;
    output DSW_PWROK;
    output SMBUS_GPIO_3;
    output IMVP9_AUX_EN;
    input VCCST_FPGA;
    output SMBUS_GPIO_4;
    output IMVP9_VR_EN;
    input FPGA_GPIO_IN1;
    input CPUPWRGD;
    input VPP_OK;
    output SYS_RESET_N;
    output PWRBTN_FPGA_LED_2;
    input IMVP9_VR_READY;
    input V12_MAIN_MON;
    input SUSACK_FPGA;
    output SMBUS_GPIO_6;
    input PMC_SLP_S4_N;
    input PMC_SLP_S0_N;
    input H_THRMTRIP_N;
    input V33A_OK;
    output V33A_EN_N;
    output PCH_PWROK;
    output FPGA_GPIO_OUT1;
    output CDONE;

    wire N__6997;
    wire N__6996;
    wire N__6995;
    wire N__6986;
    wire N__6985;
    wire N__6984;
    wire N__6977;
    wire N__6976;
    wire N__6975;
    wire N__6968;
    wire N__6967;
    wire N__6966;
    wire N__6959;
    wire N__6958;
    wire N__6957;
    wire N__6950;
    wire N__6949;
    wire N__6948;
    wire N__6941;
    wire N__6940;
    wire N__6939;
    wire N__6932;
    wire N__6931;
    wire N__6930;
    wire N__6923;
    wire N__6922;
    wire N__6921;
    wire N__6914;
    wire N__6913;
    wire N__6912;
    wire N__6905;
    wire N__6904;
    wire N__6903;
    wire N__6896;
    wire N__6895;
    wire N__6894;
    wire N__6887;
    wire N__6886;
    wire N__6885;
    wire N__6878;
    wire N__6877;
    wire N__6876;
    wire N__6869;
    wire N__6868;
    wire N__6867;
    wire N__6860;
    wire N__6859;
    wire N__6858;
    wire N__6851;
    wire N__6850;
    wire N__6849;
    wire N__6842;
    wire N__6841;
    wire N__6840;
    wire N__6833;
    wire N__6832;
    wire N__6831;
    wire N__6824;
    wire N__6823;
    wire N__6822;
    wire N__6815;
    wire N__6814;
    wire N__6813;
    wire N__6806;
    wire N__6805;
    wire N__6804;
    wire N__6797;
    wire N__6796;
    wire N__6795;
    wire N__6788;
    wire N__6787;
    wire N__6786;
    wire N__6779;
    wire N__6778;
    wire N__6777;
    wire N__6770;
    wire N__6769;
    wire N__6768;
    wire N__6761;
    wire N__6760;
    wire N__6759;
    wire N__6752;
    wire N__6751;
    wire N__6750;
    wire N__6743;
    wire N__6742;
    wire N__6741;
    wire N__6734;
    wire N__6733;
    wire N__6732;
    wire N__6725;
    wire N__6724;
    wire N__6723;
    wire N__6716;
    wire N__6715;
    wire N__6714;
    wire N__6707;
    wire N__6706;
    wire N__6705;
    wire N__6698;
    wire N__6697;
    wire N__6696;
    wire N__6689;
    wire N__6688;
    wire N__6687;
    wire N__6680;
    wire N__6679;
    wire N__6678;
    wire N__6671;
    wire N__6670;
    wire N__6669;
    wire N__6662;
    wire N__6661;
    wire N__6660;
    wire N__6653;
    wire N__6652;
    wire N__6651;
    wire N__6644;
    wire N__6643;
    wire N__6642;
    wire N__6635;
    wire N__6634;
    wire N__6633;
    wire N__6626;
    wire N__6625;
    wire N__6624;
    wire N__6617;
    wire N__6616;
    wire N__6615;
    wire N__6608;
    wire N__6607;
    wire N__6606;
    wire N__6599;
    wire N__6598;
    wire N__6597;
    wire N__6580;
    wire N__6577;
    wire N__6576;
    wire N__6573;
    wire N__6572;
    wire N__6569;
    wire N__6566;
    wire N__6563;
    wire N__6556;
    wire N__6555;
    wire N__6554;
    wire N__6551;
    wire N__6548;
    wire N__6545;
    wire N__6538;
    wire N__6537;
    wire N__6536;
    wire N__6533;
    wire N__6530;
    wire N__6527;
    wire N__6524;
    wire N__6517;
    wire N__6514;
    wire N__6513;
    wire N__6512;
    wire N__6511;
    wire N__6506;
    wire N__6503;
    wire N__6500;
    wire N__6493;
    wire N__6490;
    wire N__6487;
    wire N__6484;
    wire N__6483;
    wire N__6482;
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
    wire \COUNTER.counter_1_cry_3 ;
    wire \COUNTER.counter_1_cry_4 ;
    wire \COUNTER.counter_1_cry_5 ;
    wire \COUNTER.counter_1_cry_6 ;
    wire \COUNTER.counter_1_cry_7 ;
    wire \COUNTER.counter_1_cry_8 ;
    wire bfn_5_10_0_;
    wire \COUNTER.counter_1_cry_9 ;
    wire \COUNTER.counter_1_cry_10 ;
    wire \COUNTER.counter_1_cry_11 ;
    wire \COUNTER.counter_1_cry_12 ;
    wire \COUNTER.counter_1_cry_13 ;
    wire \COUNTER.counter_1_cry_14 ;
    wire \COUNTER.counter_1_cry_15 ;
    wire \COUNTER.counter_1_cry_16 ;
    wire bfn_5_11_0_;
    wire \COUNTER.counter_1_cry_17 ;
    wire \COUNTER.counter_1_cry_18 ;
    wire \COUNTER.counter_1_cry_19 ;
    wire \COUNTER.counter_1_cry_20 ;
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
