firasgany77/Board-Design-Git/(commit log)

2021-11-27 made file for power rails, signals.docx
2021-11-27 added pdf version of power rails, signals
2021-11-27 fixed VR_READY_VCCINAUX & VR_READY_VCCIN Names
    [Top.vhd, pch_pwrok.vhd]
2021-11-30 deleted all adc & voltage monitor related signals
2021-12-05 generated bit map for blinker
    [counter_pin_table.CSV, counter_sbt.sdf, counter_sbt_vital.sdf]
2021-12-13 Updated the Bin File that Blinks the Green LED
2021-12-13 Organized the TEST Folder
    [counter_pin_table.CSV, counter_sbt.sdf, counter_sbt_vital.sdf]
2022-01-07 Updated TensorI22 Schematic
2022-01-10 Update Readme.MD
    added EB_TI22A (Extension board PNG)
2022-01-18 Added SBC-TI22 Power Diagram to Schematic
2022-01-18 Edited Schematic
2022-04-11 UPDATE 11/04
    [pwrbtn_block_sbt.sdf, pwrbtn_block_sbt_vital.sdf]
2022-04-11 Created a director
    [counter_pin_table.CSV, counter_sbt.sdf, counter_sbt_vital.sdf, pwrbtn_block_sbt.sdf, pwrbtn_block_sbt_vital.sdf]
2022-04-11 Updated VHDL Files
    [TOP_pin_table.CSV, TOP_sbt.sdf, TOP_sbt_vital.sdf]
2022-04-12 Created Home Project for SBCTI22
    [TOP_pin_table.CSV]
2022-04-12 Connecting V1P8_OK to VCC to see if it appears in Pin Constraints.
    [TOP_pin_table.CSV]
2022-04-12 added GPIO_FPGA_HDR_1 for Pin Constraints Check
    [TOP_pin_table.CSV]
2022-04-13 Replaced GPIO_FPGA_PCH_5 with GPIO_FPGA_SoC_4
    [TOP_sbt.vhd, Top.vhd]
2022-04-13 Update Files
    [TOP_pin_table.CSV]
2022-04-13 Re-arranged files
    [TOP_pin_table.CSV, TOP_sbt.sdf, TOP_sbt_vital.sdf]
2022-04-14 Updated DSW_PWROK.vhd
    [TOP_pin_table.CSV, TOP_sbt.sdf, TOP_sbt_vital.sdf]
2022-04-24 Updated Lattice FPGA Works Folder
    [TOP_pin_table.CSV, TOP_sbt.sdf, TOP_sbt_vital.sdf]
2022-04-25 update the top.vhd
    [TOP_pin_table.CSV, TOP_sbt.sdf, TOP_sbt_vital.sdf]
2022-05-14 Added primary_voltage_enabler test after adding SLP_SUSn
    [607872_TGL_UP3_UP4_UP3R_PowerMap_Rev2p2.xlsm]
2022-05-15 Added TOP_OLD.vhd, Updated Top.vhd, Updated Primary Voltages Enabler, RSMRST_PWRGD.vhd,
2022-05-24 Removed the Tristate condition from primary_voltages_enabler since FPGA doesn't support Tristate.
    [Top.vhd, primary_voltages_enabler.vhd, vpp_vddq.vhd]
2022-05-25 Updating files
    [TOP_pin_table.CSV, TOP_sbt.sdf, TOP_sbt_vital.sdf]
2022-06-02 FPGA showing first signs of life, all power rails are up except VCCIN\VCCINAUX
    [TOP_pin_table.CSV, TOP_sbt.sdf, TOP_sbt_vital.sdf]
2022-06-02 VCCIN_VR_PE changed to OUT
    [TOP_pin_table.CSV]
2022-06-03 fixed RSMRST.vhd
    [TOP_pin_table.CSV, TOP_sbt.sdf, TOP_sbt_vital.sdf]
2022-06-07 Changed DSW_PWROK count to 900 instead of 3500
    [TOP_pin_table.CSV, TOP_sbt.sdf, TOP_sbt_vital.sdf]
2022-06-07 Changed count to 300 in DSW_PWROK
    [TOP_pin_table.CSV, TOP_sbt.sdf, TOP_sbt_vital.sdf]
2022-06-09 removed vccin_aux_pe
    [TOP_pin_table.CSV, TOP_sbt.sdf, TOP_sbt_vital.sdf]
2022-06-13 disabled rsmrst_pwrgd_block, pch_pwrok_block, vccin_en_block
    VCCIN_EN <= '1';
    VCCIN_VR_PE <= '1';
    VCCINAUX_EN <= '0';
    VCCINAUX_VR_PE <= '0';
    [TOP_pin_table.CSV, TOP_sbt.sdf, TOP_sbt_vital.sdf, vccin_en_block_sbt.sdf, vccin_en_block_sbt_vital.sdf]
2022-06-13 disabled powerled_block, vpp_vddq_block
2022-06-13 updated TOP.vhd
    Enabled:
    counter_block
    dsw_pwrok_block
    primary_voltages_enabler
    [TOP_pin_table.CSV, TOP_sbt.sdf, TOP_sbt_vital.sdf]
2022-06-13 Updated TOP.VHD
    Enabled: primary_voltages_enabler, counter_block, dsw_pwrok_block
    VCCIN_VR_PE <= '0';
    VCCIN_EN <= '0';
    VCCINAUX_EN <= '1';
    VCCINAUX_VR_PE <= '1';
    [TOP_pin_table.CSV, TOP_sbt.sdf, TOP_sbt_vital.sdf]
2022-06-13 Enabled all except: powerled_block, hda_strap_block
    VCCIN_VR_PE <= '0'; -- makes the 0x20 VCCIN disappear in the IMVP9 programming software.
    --VCCIN_EN <= '0';
    --VCCINAUX_EN <= '1';
    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
    [TOP_pin_table.CSV, TOP_sbt.sdf, TOP_sbt_vital.sdf]
2022-06-13 Enabled all except: powerled_block, hda_strap_block,
    VCCINAUX_EN <= '1' WHEN (V1P8A_OK = '1')
    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
    [TOP_pin_table.CSV, TOP_sbt.sdf, TOP_sbt_vital.sdf]
2022-06-13 Updated TOP.vhd
    All enabled except: powerled_block, hda_strap_block
    -- disable PMBUS for VCCIN Controller:
    --VCCIN_VR_PE <= '1';
    --VCCINAUX_VR_PE <= '1';
    FPGA: flashed 00A with 2 phases.
    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
    [TOP_pin_table.CSV, TOP_sbt.sdf, TOP_sbt_vital.sdf]
2022-06-13 Flash Only VCCIN, added bitmap.bin
    tried to flash VCCIN with 00A and change to 2 phase:
    disabled VCCINAUX_EN
    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
    [TOP_pin_table.CSV, TOP_sbt.sdf, TOP_sbt_vital.sdf]
2022-06-13 Flash VCCIN ONLY, re-enabled vccin-aux, added bitmap.bin
    [TOP_pin_table.CSV, TOP_sbt.sdf, TOP_sbt_vital.sdf]
2022-06-13 Updated TOP and bitmap (VCCIN_VR_PE <= '1'; VCCINAUX_VR_PE <= '1';)
    --VCCINAUX_EN <= '0';
    could identify only aux,
    system reached S3
    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
    [TOP_pin_table.CSV, TOP_sbt.sdf, TOP_sbt_vital.sdf]
2022-06-13 Updated TOP and bitmap (VCCIN_VR_PE <= '1';, VCCINAUX_VR_PE <= '0';)
    VCCINAUX_EN: HIGH
    VCCINAUX_PE: LOW
    VCCIN_EN: LOW
    VCCIN_PE: HIGH
    VCCIN: LOW
    RESULT:
    RSMRST:LOW
    SLP_S5,S4,S3: LOW
    Recognized only x25
    [TOP_pin_table.CSV, TOP_sbt.sdf, TOP_sbt_vital.sdf]
2022-06-13 Updated TOP and Bitmap (VCCIN_VR_PE <= '1' ; VCCIN_EN <= '1' ; , VCCINAUX_VR_PE <= '0';, VCCINAUX_EN <= '0')
    VCCINAUX_EN: LOW (from primary_voltages_enabler)
    VCCINAUX_PE: LOW (from top)
    VCCIN_EN: HIGH (from top) (disabled vccin_en block)
    VCCIN_PE: High (from top)
    V33A_ENn <= '0'; (from primary_voltages)
    couldn't write to it. (should we supply VCCST?)
    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
    [TOP_pin_table.CSV, TOP_sbt.sdf, TOP_sbt_vital.sdf]
2022-06-13 ALL enabled except: HDA_STRAP, powerled_block
    --VCCIN_EN <= '1';
    flashed VCCIN_CTRLR with 00A 2 phases.
    installed new MPS software 4.5
    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
2022-06-13 All enabled except HDA STRAP, powerled_block (added bitmap.bin)
    [TOP_pin_table.CSV, TOP_sbt.sdf, TOP_sbt_vital.sdf]
2022-06-13 ALL ENABLED AND: VCCIN_VR_PE <= '0'; VCCIN_EN <= '0'; VCCINAUX_VR_PE <= '1'; (FLASH AUX FIRST)
    Result:
    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
    [TOP_pin_table.CSV, TOP_sbt.sdf, TOP_sbt_vital.sdf]
2022-06-14 ALL Enabled: VCCIN_VR_PE <= '1'; VCCINAUX_VR_PE <= '1';
    PCH_PWROK: ON
    PROCPWRGOOD: ON
    Added PU to VCCIN_READY.
    Amperage: 0.34A
    [TOP_pin_table.CSV, TOP_sbt.sdf, TOP_sbt_vital.sdf]
2022-06-14 ALL Enabled except: pch_pwrok, vccst_pwrgd
    disabled:
    --pch_pwrok <= '1' WHEN (delayed_vccin_ok = '1') AND (slp_s3n = '1')
    --ccst_pwrgd <= '1' WHEN (delayed_vccin_ok = '1') AND (slp_s3n = '1')
    No Toggle of PCH_PWROK.
    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
    [TOP_pin_table.CSV, TOP_sbt.sdf, TOP_sbt_vital.sdf]
2022-06-14 All Enabled toggle problem still exist, added a PWR Sequence photo.
    vccin_en <= '1' WHEN slp_s3n = '1'
    slp_s3# goes down BEFORE Vccin_Ready
    [rsmrst_pwrgd.vhd]
2022-06-14 All Enabled except vccst_pwrgd
    vccin_en <= '1' WHEN rsmrst_pwrgd = '1'
    result:
    SLP_S3 toggles, VCCIN=Constant!
    [TOP_pin_table.CSV, TOP_sbt.sdf, TOP_sbt_vital.sdf]
2022-06-14 ALL Enabled: Commented: --VCCINAUX_VR_PE <= '1';, --VCCIN_VR_PE <= '1'; (fix 3V3A glitch)
    [TOP_pin_table.CSV, TOP_sbt.sdf, TOP_sbt_vital.sdf]
2022-06-14 All enabled: (vccin_ready = '1') disabled (PCH_PWROK) - SYSTEM OK
    All System is UP.
    added PWR_SEQ_14_06_1&2.jpeg
    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
    [TOP_pin_table.CSV, TOP_sbt.sdf, TOP_sbt_vital.sdf]
2022-06-15 All Enabled: Disabled PCH_PWROK
    [TOP_pin_table.CSV]
2022-06-15 All Enabled: Added PCH_PWROK with changes. removed PU on VPP_OK
    [TOP_pin_table.CSV, TOP_sbt.sdf, TOP_sbt_vital.sdf]
2022-06-15 All enabled: Added 100ms delay between PCH_PWROK and SYS_PWROK
    [TOP_pin_table.CSV, TOP_sbt.sdf, TOP_sbt_vital.sdf]
2022-06-16 All enabled: added 100ms between PCH_PWROK and SYS_PWROK (fixed)
    [TOP_pin_table.CSV, TOP_sbt.sdf, TOP_sbt_vital.sdf]
2022-06-16 made some changes to the code - still need to compile
    [TOP_pin_table.CSV]
2022-06-17 Added ALL_SYS_PWROK, changed assertion of : PCH_PWROK, VCCST_PWRGD, VCCIN_VR_ON,VCCST_CPU_EN
    Imade some changes to the code to make the power sequence as close as possible to CRB.
    we also added ALL_SYS_PWRGD signal that gets high when the following are high:
    (DSW_PWROK = '1')
    (VDDQ_OK = '1')
    (VPP_OK = '1')
    (SLP_SUSn = '1')
    (SLP_S3n = '1')
    PCH_PWROK gets asserted now 32 ms after ALL SYS PWRGD gets asserted.
    VCCST_PWRGD gets asserted immediately after ALL_SYS_PWRGD gets asserted.
    VCCIN_VR_ON (VCCIN_EN) gets asserted immediately after ALL_SYS_PWRGD gets asserted.
    VCCST_CPU_EN gets asserted immediately after ALL_SYS_PWRGD gets asserted.
    [TOP_pin_table.CSV, TOP_sbt.sdf, TOP_sbt_vital.sdf]
2022-06-19 Edited ALL_SYS_PWRGD Generation.
    [TOP_pin_table.CSV, TOP_sbt.sdf, TOP_sbt_vital.sdf]
2022-06-19 edited VCCST_EN condition.
    all lines are good, no PLTRST#
    [TOP_pin_table.CSV, TOP_sbt.sdf, TOP_sbt_vital.sdf]
2022-06-20 Uploaded Zip for DSx Design
    [TOP_pin_table.CSV, TOP_sbt.sdf, TOP_sbt_vital.sdf]
2022-06-21 Updated Zip for Non-DSx Design
    [TOP_pin_table.CSV, TOP_sbt.sdf, TOP_sbt_vital.sdf]
2022-06-21 SYSTEM STAB:E - PCH PWROK DISABLED
    board:1
    slp_s3#: good step shape
    dsx enabled
    0005 bios (leonid)
    i7 (with CFG Resistors Removed)
2022-06-22 SYSTEM STABLE - PCH_PWROK Enabled
    - fixed voltage falling.
    - fixed typo in vpp_vddq : slp_s4n => vccst_en_singal ////////////// to slp_s4n => slp_s4n_signal,
    - all_sys_pwrgd non-functional (added as comment)
    - BIOS: 0.0.02-2.bin
    [Top.vhd, rsmrst_pwrgd.vhd]
2022-06-22 SYSTEM STABLE - Voltage Fall
    added: all_sys_pwrgd
    disabled: vccin_en_block (instead: VCCIN_EN <= all_sys_pwrgd_signal)
2022-06-22 SYSTEM STABLE -Voltage Fall - Removed some annoying comments
2022-06-22 SYSTEM STABLE - Voltage Fail - DSx Design
    - changed some timings
    [dsw_pwrok.vhd, rsmrst_pwrgd.vhd]
2022-06-22 SYSTEM STABLE - Voltage Fail - DSx Design
    added git ignore
2022-06-22 SYSTEM STABLE - Voltage Fail - Non-DSx Design
    [primary_voltages_enabler.vhd]
2022-06-22 STABLE SYSTEM - Voltage Drop - Non-DSx Design
    Based on TNSR.I22.PRD.0.0.0.1
    GPP_B14 (Top swap override configured: 1.8V) - SOC_SPKR Strap PU & PD In Tensor are NOP and connected to +3V3A rail.
    GPP_B23 (for this configuration keep 1.8V) - SML1ALERT#_PCHHOT#_GSPI1_CS1# Strap PU & PD In Tensor are NOP and connected to +3V3A rail and V1.8A rail.
    GPP_C2 (for this configuration keep 1.8V) - SMB_ALERT# strap connected to 4.75K PU to +V1.8A.
    GPP_C5 (for this configuration keep 1.8V) - GPP_C5/SML0ALERT# Strap PU & PD In Tensor are NOP and connected to +3V3A rail.
    GPP_E0 (for this configuration keep 1.8V) - Note: SATAXPCIE0 connected also to FPGA through NOP.
    GPIO_FPGA_SoC_1,2,3,4 : GPP_E11,E1,E12,E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
    [dsw_pwrok.vhd]
2022-06-30 Re-Arranged Folders
    [TOP_pin_table.CSV, TOP_sbt.sdf, TOP_sbt_vital.sdf, vccin_en_block_sbt.sdf, vccin_en_block_sbt_vital.sdf]
2022-06-30 Updated: Non-DSx Design
    missing ACPRESENT Signal for FPGA to handle DSx states.
    stopped working with DSx.
    [primary_voltages_enabler.vhd]
2022-07-11 Debug: Changed V5S_ENn and V33S_ENn to '0' to make sense with HW straps.
    DPP3/2/1 will be pulled to 3.3VS which is enabled before RSMRST# sampling.
    this will choose "1" Value in HW straps.
    [TOP_sbt.sdf, TOP_sbt_vital.sdf]
2022-07-13 Non-DSx: System Working [Enabled +3V3S and +5VS by SLP_SL3#]
    [TOP_sbt.sdf, TOP_sbt_vital.sdf]
2022-08-16 Updated FPGA Code
    [TOP_sbt.sdf, TOP_sbt_vital.sdf]
2022-08-28 updated TOP.vhd, HDA_STRAP_VH
    [TOP_sbt.sdf, TOP_sbt_vital.sdf]
2022-08-29 added SBCTI22WORK3 - Home folder
    [TOP_sbt.sdf, TOP_sbt_vital.sdf, vccin_en_block_sbt.sdf, vccin_en_block_sbt_vital.sdf]
